c0pperdragon/Amiga-Digital-Video/direct_adapter/installation/README.md

# Installation process

1. Insert the MicroSDcard with the RGBtoHDMI software into the Raspberry Pi Zero.

2. Check/set the jumper on the underside of the adapter to select the correct Denise variant.
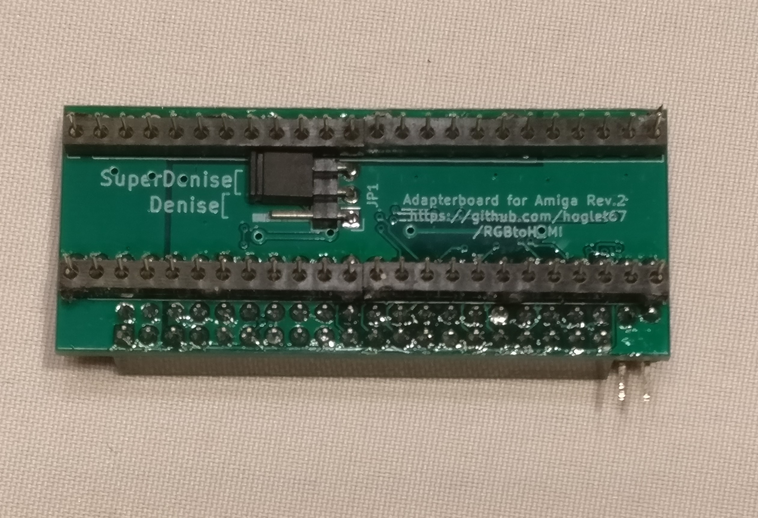
[picture p10: direct_adapter/installation/jumper.jpg]


3. Remove Denise graphics chip from Amiga 
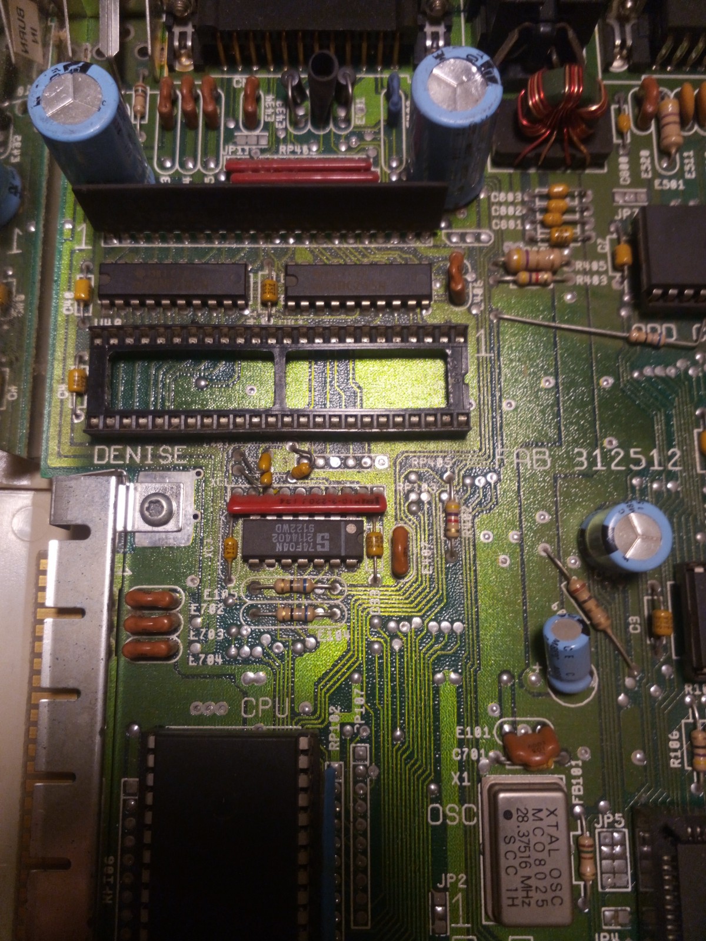
[picture p11: direct_adapter/installation/remove_denise.jpg]


4. Insert adapter with Denise on top
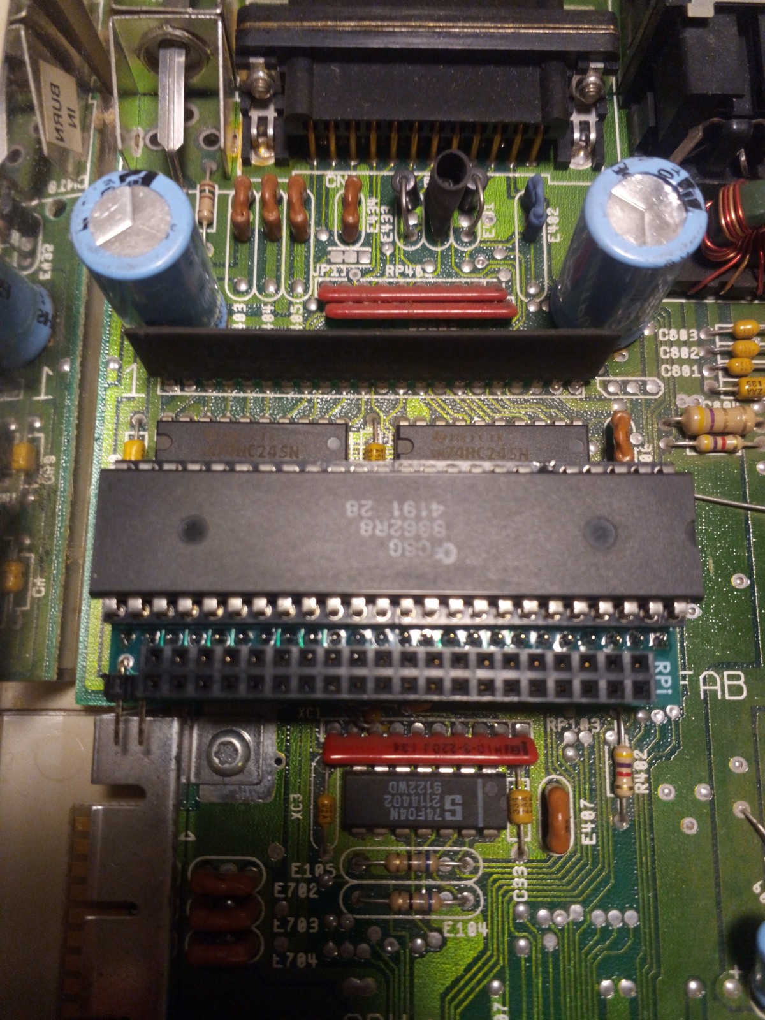
[picture p12: direct_adapter/installation/adapter_with_denise.jpg]


5. Attach Raspberry Pi Zero upside down and attach HDMI and button cable (optional)
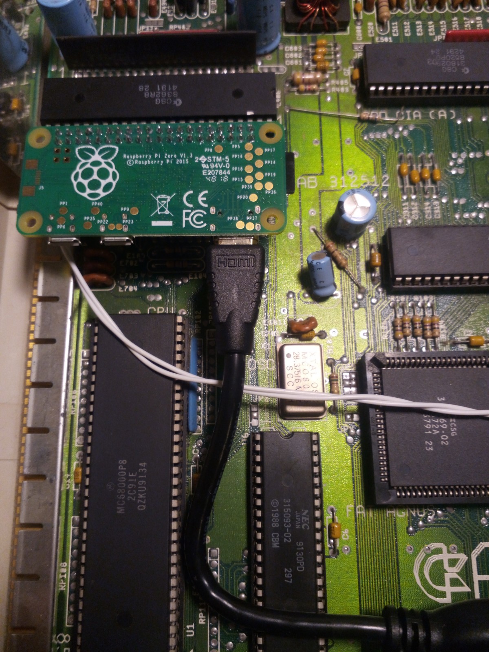
[picture p13: direct_adapter/installation/RPi_with_cables.jpg]


6. Bring cables to the outside of the case
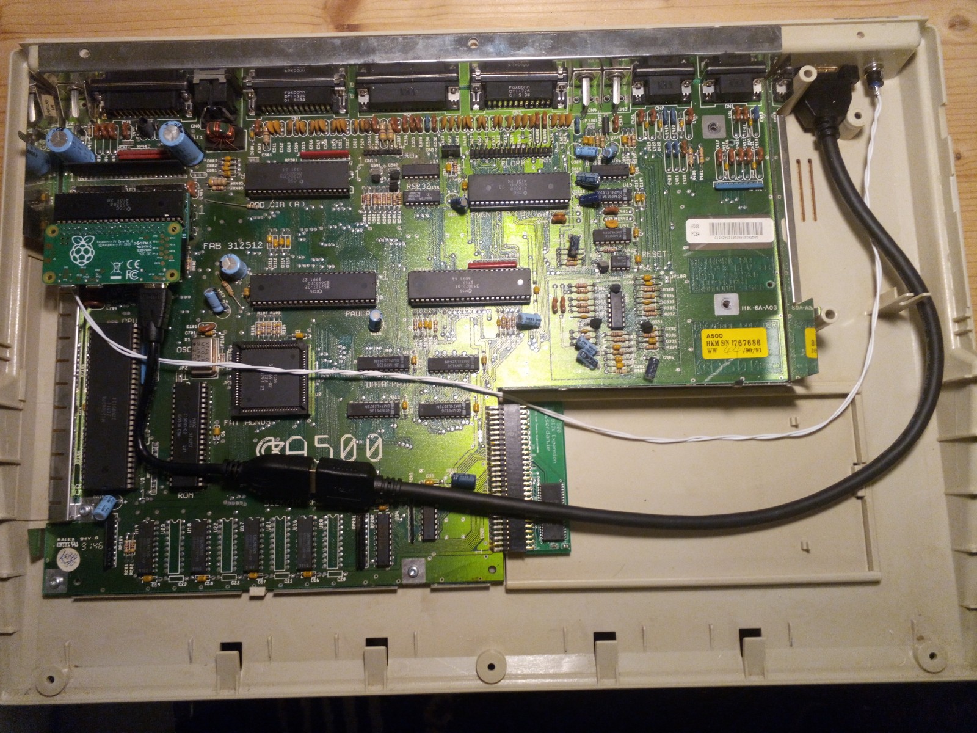
[picture p14: direct_adapter/installation/cabling.jpg]
