c0pperdragon/Amiga-Digital-Video/(threads)

Thread 1 (2020-07-18):

General discussion

c0pperdragon, 2020-07-18:
I have set up this thread as a forum to discuss the options with @IanSB concerning the use for the RGBtoHDMI project.

c0pperdragon, 2020-07-18:
To define the scope of the project I would only consider the Atari computers. C64 already works and my latest ZX Spectrum board can natively output RGsB which should be easy to use with the RGBtoHDMI.

c0pperdragon, 2020-07-18:
A straight forwar solution is a connector with 8 pins for the color, one csync and GND and +5V. This could then directly drive an RGBtoHDMI or being converted to YPbPr with an external adapter. I want this option so I can use it with other upscalers.

IanSB, 2020-07-18:
> A straight forwar solution is a connector with 8 pins for the color, one csync and GND and +5V

Yes, RGBtoHDMI already has a 12 way IDC header with the following pinout:

Pin 1  X1 (Bit 6)
Pin 2  X2 (Bit 7)  
Pin 3  GND  
Pin 4  Bgreen (Bit 4)
Pin 5  Bred  (Bit 3)
Pin 6  Bblue (Bit 5)
Pin 7  RED (Bit 0) 
Pin 8  H/CSYNC 
Pin 9  GREEN (Bit 1)
Pin 10  VSYNC
Pin 11  BLUE (Bit 2)
Pin 12  +5V

They are arranged in this order because if you connect a ribbon cable from Pins 3 - 11 to a 9 way IDC 'D' type connector that is the correct pinout for IBM PC MDA, CGA and EGA adapters. (It was originally a 10 way connector and X1 + X2 were added later to make 8 bits)

One possible addition would be to put the pixel clock on the unused pin 10 (VSYNC) as that might allow for the possibility of connecting the signals directly to the Pi's GPIO header bypassing the CPLD for a minimal cost solution. (The CPLD is primarily used to regenerate a pixel clock with the correct phase). The pixel clock might be useful for any external DAC as well.

It would also be possible to communicate with the scaler by outputting data on the 8 pins during sync periods.

> C64 already works and my latest ZX Spectrum board can natively output RGsB which should be easy to use with the RGBtoHDMI

It might be useful to add 4 bits + sync + pixel clock onto some unused pins on their FPGAs for experimental purposes.

One possible change to the C64 FPGA that might also be useful would be to add an additional option to address 53311 to switch the YUV output to the special palette and back again so you don't lose the saved palette.
The YUV levels required by RGBtoHDMI can be generated procedurally so no need for another table.
To switch to special RGBtoHDMI mode that would be something like:

POKE 53311,xxx   (where xxx is the number to switch to RGBtoHDMI mode)
flip switch
POKE 53311, 138

To switch back to normal palette
POKE 53311,137
flip switch
POKE 53311,138
(That would also ensure that reprogramming the palette would switch back to normal mode)

c0pperdragon, 2020-07-18:
Concerning the C64 - maybe it would the best thing to just provide a digital header on the mod board. It may be a bit tricky to squeeze this into some corner, but then all the messing around with the palette would be unnecessary. You could install a digital port (3.3V  logic levels) to some convenient place on the case just in addition to the YPbPr output.

Are you sure about the pixel clock? This somehow feels a bit out of place for a digital video interface right out of the stone age of computing ;-)   Just providing a 3x2 optional pin header with GND, CSYNC, D0 - D3 seems more fitting.

I can easily modify the firmware to send these signals to some pins, and also modify the board layout to have this option. Then you would need to have such a PCB made and populate it yourself, as we will for sure not do a second production run in the forseeable future. Of course you could also try to solder wires directly to these FPGA pins - but I would not be able to do this.

c0pperdragon, 2020-07-18:
For this new Atari modification, I envision to use a CPLD that can directly accept 5V input level. It may run with 3.3V itsself and will also output 3.3V levels.

Because the GTIA chip already directly generates the 4 luminance bits and the CSYNC, the CPLD would only be responsible to generate the 4 bits for the color signal. Internally this saves only a small amount of logic because all the complicated sprite handling is still necessary. But maybe it just enough to squeze the logic into some of the smaller CPLDs.
One side effect of this is that the CPLD would not be able to generate a proper pixel clock itself. The Atari graphics system is basically designed around low-res pixels with a 3.54 MHz (PAL) pixel clock.  This is also the highest frequency to be found anywhere inside the Atari machines. To generate high-res pixels, the GTIA outputs different luma signals for both halves of the pixel clock. The color signals on the other hand can only ever change at the begin of one full pixel clock, so it can be easily done by logic that is driven by the pixel clock.

To bring the signals (8 data, 1 csync) and power to the exterior of the device, some detachable connector is needed. And IDC header is just not the right thing for a case-mounting. Maybe a DSUB-15 as this seems to be readily available?

IanSB, 2020-07-19:
> One side effect of this is that the CPLD would not be able to generate a proper pixel clock itself.

The pixel clock is not essential, it was just an idea if it was available already but if it is difficult to implement then it doesn't matter as the scaler doesn't need it.

> And IDC header is just not the right thing for a case-mounting. Maybe a DSUB-15 as this seems to be readily available?

I like IDC as it makes it easier to build cables, in this case it would be 12 way IDC to 12 way IDC ribbon

c0pperdragon, 2020-07-19:
I just got an idea about digital signals for the C64. Using the current mod you could actually tap into the various resistors that form the output DAC. These are SMD parts, but not that small so it should be possible to attach wires. So you could actually keep the YPbPr signal unmodified and at the same time extract digital data.You should run the signals through a buffer IC first to avoid coupling noise into the analog signal.
With this solution you don't need to create your own custom mod kit but can use the readily available one.

Unluckily with the default palette there is no set of 4 pins to always uniquely specify the color. I did some computation and there is a possibility with 5 pins, but this is quite convoluted and depends on the very exact palette setting. The cleanest solution would be to take the 4 most significant bits of  the Y output together with the most significant bit of both Pb and Pr.  CSYNC can also be extracted directly.
As you have already some systems with a 6-bit input this is probably no big deal for your system.

c0pperdragon, 2020-07-19:
Hi!  I just had an idea that may (if it actually works) become the best and most cost-effective upscaler solution there is.
Is it possible to directly team up the TVP7002 video digitizer chip with the Raspberry Pi Zero?  This chip is used in the front-end for the OSSC and has a built-in PLL to sync to any given pixel/line ratio and also outputs the pixel clock alongside the data.

As you have mentioned earlier, having a pixel clock allows the Raspberry Pi to take in the samples directly without additional hardware. And as you also said, genlock is possible, so this could become a very powerfull general upscaler with very low lag.
I don't know how far this can be pushed. Would 24 bit color depth with a 640x256 input signal be possible? I would love to actually use this with my Amiga.

IanSB, 2020-07-19:
> I just got an idea about digital signals for the C64.
> As you have already some systems with a 6-bit input this is probably no big deal for your system.

I will do some experiments with that later but for now the analog connection is the easiest as it just plugs into the existing connector so maybe the only thing to add at the moment would be the rapid palette output switch I mentioned above.

> Is it possible to directly team up the TVP7002 video digitizer chip with the Raspberry Pi Zero?

There are several problems:
There might not be enough GPIO pins on the header for 24 bit bus + supporting signals and if the 24 bit bus is multiplexed that increases the data rate to be clocked into the Pi's GPIOs.

The main issue is that the Pi's memory access time is unpredictable and can sometimes be high latency which is not good for real time capture. To get it working with even these limited bit depths required things like instruction re-ordering and register swapping to make use of processor optimisations.

One thing I intend to look at is using the GPU/VPU to capture the incoming data (effectively a FIFO) but the GPU processors are not well documented so that may take some time. Using an external hardware FIFO might help but that would require more GPIO accesses and they are relatively slow too.

The Pi2 and Pi3 perform even worse as their uncached memory access is slower than the Pi zero. The extra cores don't help because if you capture with one core and write with another core you get stalls on contended memory access and cache coherency updates.

The current system has a 12 bit bus from the CPLD to the Pi on the GPIOs for pixel data and that clocks in 4 pixels at a time in 3 bit capture mode, 2 pixels in 6 bit mode and 1 pixel in 8 bit mode. This could be increased to 1.5 pixels in 8 bit mode.

The max pixel clock in 6 bit mode writing to an 8 bit buffer is ~29 Mhz and I have been able to capture 640x480 @ 60hz at that bit depth from a VGA card which also had an EGA TTL connector.

This max pixel clock in 8 bit mode is currently ~14Mhz as the data rate on the 12 bit bus is doubled compared to 6 bit mode. That should be enough for the Atari but not any computer with a higher pixel clock.

Increasing to 24bits per pixel and 32 bits deep framebuffer may be impossible on the zero although it might work on the Pi 4.
Certainly some things to investigate in the future.

c0pperdragon, 2020-07-19:
About C64 palette swapping: It is a bit of a pain to put more features into the register handling subsystem. Even the extra bit to turn off sync output was quite a hack already.

But maybe you could like the following idea: You can switch to the special palette buy placing a jumper link on a specific position of the JTAG header (I need to check this actually works). Or add some additional wire to the mode switch (soldered from below - that may be tricky) to actually get a 4th output mode.

c0pperdragon, 2020-07-19:
Clocking in such amount of data via the GPIO headers using only the CPU is surely a pain, especially when these variable timings are involved that come from using RAM with caches.

On the other hand, the current (and cheapest) version 1.3 of the Raspberry Pi has a high-speed data interface which is meant to be used with a camera. This would handle all we could ever throw at it with ease. But then of course some intermediary IC is needed to translate between the video digitizer (parallel protocol) and the DSI port (serial).
Anyway this solution could be the most simple and not even requiring hardware-level programming on the Pi.

IanSB, 2020-07-19:
>You can switch to the special palette buy placing a jumper link on a specific position of the JTAG header (I need to check this actually works). Or add some additional wire to the mode switch (soldered from below - that may be tricky) to actually get a 4th output mode.

Yes that would be great.

IanSB, 2020-07-19:
> version 1.3 of the Raspberry Pi has a high-speed data interface which is meant to be used with a camera.

Yes I have considered that, but this is a bare metal project (no OS) so you have to find enough documentation to write a driver for it.

https://github.com/hoglet67/RGBtoHDMI/issues/104

IanSB, 2020-07-19:
Have you used JLC PCB assembly service? They are very low cost but only build single sided SMD and only use components they have in stock.
I redesigned the analog board for RGBtoHDMI to use only their stocked components and had a batch of 10 assembled very cheaply at about 25% of the cost of getting the original board built. It worked out cheaper than buying just the components for the original design from local suppliers!
I also designed with smaller components as I didn't have to build them by hand.

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
Top is original design, bottom is JLC built design (they are functionally identical)

> For this new Atari modification, I envision to use a CPLD that can directly accept 5V input level.

They do stock some CPLDs & FPGAs so if there is anything suitable in their list and they have many of them in stock it might be worth using it in the design, you can get 5 boards assembled for very little.
(Even if it requires level shifters, they probably have those as well and adding such things to the assembly costs very little)

https://jlcpcb.com/parts/componentSearch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

c0pperdragon, 2020-07-19:
Hmm, these parts look pretty well made. But for my own hobby projects and prototypes I prefer to assemble the boards myself. Actual soldering is my main enjoyment in this hobby. As a  decades-long software engineer I am a bit sick of all this computer screen work, so I try to get a better ratio of planing/programming vs. manual work.

c0pperdragon, 2020-07-19:
Convering the C64 firmware: I am pretty confident that I can use the JTAG pin and it would then work like this:  If you bridge pin 9 and 10 the mode select switch position that would normally select "line double with scan line effect" will then select "normal lines with special high-contrast palette". This would have the least impact on the overall usability as this seems to be the least used output mode anyway.

IanSB, 2020-07-19:
>If you bridge pin 9 and 10 the mode select switch position that would normally select "line double with scan line effect" will then select "normal lines with special high-contrast palette".

Sounds good

> But for my own hobby projects and prototypes I prefer to assemble the boards myself.

Yes I like building the hobby projects but not building lots of the same thing for friends as my eyesight is no longer so good.
Anyway if JLC have something in stock that is suitable, no reason not to use it as it leaves the option open.

c0pperdragon, 2020-07-19:
Once more back to the Atari:  Somehow I am reluctant to start this completely new project when my already existing Atari component video mod already works so nicely.  I now think of reworking the FPGA board in a similar way as for the C64 so it will fit better and use existing holes in the case. For my Atari 800XL this is easy, as I have it myself. Probably it is more complicated for other models - this mainly depends on which types of RF modulator were used.

By using existing holes only I would again go for the solution with the TRRS jack and the mode switch.

To support your upscaler in a similar way as we now plan for the C64, we would need to find a way to squeeze the pixel data through the analog data path.
This is not so hopeless as it may seem, because the Atari has quite hard restrictions on which colors is can produce. Basically it can only have a different chroma for every two pixels and the luma is mostly restricted to 8 different levels (there is just one special mode with more lumas but then both pixels of a pair are identical).
Summing the possibilities for one pixel pair:  16*16  + 16*8*7 = 1152
As far as I understand your analog interface, it can distinguish 27 different R/G/B possibilities.  Combining two pixels gives  729 possibilities. That is awfully close to the target (missing only half a bit or so). But maybe I did misunderstand the schematics and you can actually pass more information?  Or maybe you can somehow utilize the sync level to transfer this missing data?

IanSB, 2020-07-19:
> Once more back to the Atari: Somehow I am reluctant to start this completely new project when my already existing Atari component video mod already works so nicely.

OK no problem

> As far as I understand your analog interface, it can distinguish 27 different R/G/B possibilities

If an extra comparator (U7) is fitted it can distinguish 64 levels (4 each for RGB or YUV) so that might solve that problem. I already use that option for the TI99/4a. This would then actually capture at 6 bits per pixel plus there would have to be some extra software to decode those combinations according to the restrictions you mention above.

c0pperdragon, 2020-07-19:
A had a second look at your analog board and noticed that there actually is the possibility to distinguish onre more level of the R and B lines. So you can differentiate 48 possibilities which give 2304 per pixel pair.
Now this is actually possible and we can even come up with some self-synchronizing encoding to always know which pixel is what.

c0pperdragon, 2020-07-19:
Our comments just crossed each other.   With true 6 bit per pixel (is it really possible to also get 2 bits from the G line?) encoding and decoding  would become even simpler, I guess.

IanSB, 2020-07-19:
> With true 6 bit per pixel (is it really possible to also get 2 bits from the G line?) encoding and decoding would become even simpler, I guess.

Yes, The comparator connected to the Vsync input which normally detects the sync in YUV mode can also be used to provide the missing level in full 2 bit mode.  In that case you have to connect the separate Sync input (normally used for RGBS) to the Y input so that there is still a sync source.

So you can have:
3xY, 3xU, 3xV  for 27 levels normal operation
4xY, 3xU, 3xV for 36 levels (requires sync input connected to Y)
3xY, 4xU, 4xV for 48 levels (requires U7 fitted)
4xY, 4xU, 4xV for 64 levels (requires U7 fitted and sync input connected to Y)

c0pperdragon, 2020-07-19:
Basically all options execpt the first would be possible. Whatever is the least hassle for you, as for me it is just a matter of fimeware programming. And in my current Atari FPGA there is plenty of room for additional features.

c0pperdragon, 2020-07-19:
With just fitting the U7 (so the cable from the C64 can be re-used) we get 2304 possibilities. This is due to some strange coincidence exactly the double of the 1152 possibilities needed for a full pixel pair. So I guess it should really be possible so encode some kind of alignment-marker to know where a pair starts. This should make the decoding processs easier.

IanSB, 2020-07-20:
> Whatever is the least hassle for you, as for me it is just a matter of fimeware programming

The decoding algorithm needs to be very simple, ideally just logical operations, bit shifts, adds, subtracts, compares etc, no tables or multiply/divide. It could use small tables if they will fit in the level 1 cache.

c0pperdragon, 2020-07-20:
So, the C64 firmware change is done. It works as proposed:  After flashing the firmware, you can bridge pin 10 an 9 on the JTAG header to activate this special palette when also shifting the mode switch to the position nearest the power LED.
I just made up a palette that only uses minimum/middle/maximum values for all three lines (plus the sync in the case of Y). I tried to chose combinations that best fit the original colors, but of course this is not always possible. At least black, middle gray and white are correct. The other grays will look rather cyan, I guess.

You can download the firmware from https://github.com/c0pperdragon/A-VideoBoard/tree/master/c64mod/experimental
I trust, you have a USB-Blaster already? Or you can get one with reasonable effort?
Please let me know if this works, and also if it solves the startup problem (which, if still existing, should manifest itself in a very different way as the compressed configuration data is now quite different).

Using the JTAG pin was quite a tricky business, and I nearly disabled the JTAG feature permanently. But now everything works fine and later re-programming is still possible without additional measures.

IanSB, 2020-07-20:
I just tried this and it works great!
I had to update my palette translation to match your new high contrast colours but everything looks OK so far.
I have not seen a startup problem yet but not power cycled many times so far so will keep testing.

IanSB, 2020-07-20:
> I now think of reworking the FPGA board in a similar way as for the C64 so it will fit better and use existing holes in the case. For my Atari 800XL this is easy, as I have it myself. Probably it is more complicated for other models - this mainly depends on which types of RF modulator were used.

Maybe you could put multiple positions for the TRRS connector on the edge of the board?

c0pperdragon, 2020-07-20:
As the C64 tasks seems to be done now, I can more focus on the Atari.

Because I have a perfectly working solution for my own machine already, I have actually not so much need to design a completely new hardware. The board I am using is one of my A-Video boards and the adapter for the GTIA chip is a bit of a hack, but works also nicely.

In order for other people to use the mod, this adapter is not really convenient, so I will design a new one based on the same schematics, but it will look much more like the one for the C64. I guess you could have such a board made by your manufacturer.

For the FPGA board there are already two compatible options available:  The A-Video board (3 RCA jacks, external mode switches) and the C64-Board (TRRS jack and integrated mode switch). As there are quite some different variants of Atari machines which would work with this mod (everything with a GTIA chip) the best way to install the board should be decided by the owner based on individual preference.
The C64-Boards are readily available at VideoGamePerfection and I happen to have a spare A-Video board which you could have for the cost of the parts (about 20€) and shipping (from Austria).

Next step for me is the design of the adapter. I hope I can squeeze the 4 inverter chips into the frame of the IC socket.

IanSB, 2020-07-20:
Someone else is trying your board with RGBtoHDMI and has the same left shift problem on power up.
He also has a 6569R1 so it seems to be a definite problem with that chip
https://stardot.org.uk/forums/viewtopic.php?f=3&t=14430&start=1140#p279622
I have sent him the new FPGA link to see if that fixes but I think he will also change to a 6569R5
It is actually quite difficult to use with a 6569R1 anyway as that needs a big heatsink and the adapter board interferes with that.

Could you check that the numbers I have used in the programs for setting the high contrast palette and restoring the normal c64 palettes with old FPGA firmware are correct:
https://github.com/IanSB/RGBtoHDMI/wiki/Cables
(See bottom of page)

I might be interested in the A-Video board but I think I would remove the phonos and wire in a trrs.
Can the A board and the C64 board be used on the C128 (with the 48 pin C128 adapter)?

Are you going to build an RGBtoHDMI?
If so do you want any blank pcbs or are you going to order a batch from China?

c0pperdragon, 2020-07-21:
That there is another user with the same shifted display now is actually a good thing. At least that rules out a random malfunction of the FPGA. I still can not figure out how this can even happen, but if both the new firmware as well as swapping out the chip solves the issue, I am fine with that. If that is truly the case I will document this behaviour on the project page.
I would be very kind if you could do some more testing nf the matter. Specifically if replacing the chip already solves it with revision 2.6 and if 2.7 with the R1 chips is also fine.

One thought about the independently occuring sparkly pixels that 'anigthin' reported which worsen over time:
The mod generates its internal pixel clock from the cpu clock by waiting for an edge and then using its own time source to decide when to start which pixel. The last pixel of a group of 8 will then take up the slack and become a bit longer or shorter. When the input frequency is too far off spec this uneven distribution of pixel times may well screw up your digitizing process.
The proper way to do it is of course using a PLL, but the FPGAs PLL can not lock to a 1 MHz input.
If there is indeed a drifting clock (you can probably tell by directly measuring pin 22 of the VIC) you will not be able to change this by replacing the VIC. In this case I need to come up with a better way of subdividing the CPU clock.

c0pperdragon, 2020-07-21:
Could you open a issue thread on the C64 video enhancement thread about the matter of sparkly pixels and notify the "anightin" on this, because I do not want to use the stardot forum for this purely C64-related issue.

c0pperdragon, 2020-07-21:
I just checked the list of color values on your screenshot. Yes, these are exactly my original colors. A bit too bright for the taste of purists - but I like it :-)

c0pperdragon, 2020-07-21:
More answers to previous questions: I am not going to build at RGBtoHDMI upscaler myself. I am more interested in making (or even buying - but only as a last resort) a general analog video upscaler solution. The idea to use a Raspberry Pi is very interesting as it really has so much power (and is probably much much cheaper than the upcomming OSSC Pro).

Replacing the RSA jacks should be fairly straight forward. You can also connect a mode switch (2 or 3 way) to the GPIO2 header.
To make the system in line with the C64 solution, you will also be able to activate the special "digital" palette with a jumper on the JTAG headers. In this way the C64 board can also be used for this purpose.

Support for the C128 is very much in doubt yet. I have actually designed an adapter board which may work (can not tell because I don't have a C128). But as I have received zero feedback from the community yet, I just can not say how the signals are really generated by the VIC-II E and if this in any way compatible.
Actually it would be very cool if you would try.  Mouting space is probably an issue as even with an removed RF-modulator the C64 board does not fit. Maybe the A-Video board could fit, but then there is no working signal on the A/V port any longer. Or you screw the A-Video board on top of the RF can. Or you indeed cut down the metal can of the VIC to squeeze the C64 board in. Or whatever floats your boat  ;-)
Of course before taking such exreme measures, you could very well just try it with an C128 adapter and run the ribbon cable to your existing C64 (don't forget to also connect of the grounds of both machines!)

c0pperdragon, 2020-07-21:
Now I even have a question of my own: Do you know if it is possible to do genlock of the Raspberry Pi's HDMI video also when programming it with a "normal" operating system?

IanSB, 2020-07-21:
>Do you know if it is possible to do genlock of the Raspberry Pi's HDMI video also when programming it with a "normal" operating system?

I've not looked at this but it should be possible if there is an API call to change the HDMI clock, if not you would have to write a driver to directly access the registers to change the clock. You would also need to compare the incoming vsync with the HDMI vsync and there is already a HDMI vsync interrupt.

c0pperdragon, 2020-07-22:
So, I have designed a new GTIA adapter for the Atari which you can have manufactured. I have tried to mainly use parts that JLCPCB provides. I guess the very special DIP 40 socket is not in their list, but they would not do the installation anyway because it is such an unusual and quite tricky business.
Everything regarding the Atari mod is now available at: https://github.com/c0pperdragon/A-VideoBoard/tree/master/atarimod

If you want my spare A-Video board, please let me know your post address. Postage inside the EU it will  cost about10€, outside 15€. Add this to the 20€ for material cost and send it to my paypal account:   reinhard.grafl@aon.at  .  If you do not have a paypal account yourself, we need to find other options.

The board does not contain a proper firmeware yet (I took it out from Spectrum when designing its specific mod kit). I plan to work on the atari firmware again in a few days while the material is on the way.

c0pperdragon, 2020-07-24:
No as I have given up the idea of the general upscaler, I would really like a solution to upscale my ZX Spectrum, C64 and Atari computers. My prefered solution would be to design a board the sits on the Raspberry Pi Zero and integrates the functionality of your Analog circuitry and the CPLD. The input connector would be a TRRS jack, so it can be directly plugged to any of my relevant machines.  Maybe add some buttons to switch input and output mode.
Would you also be interested in such a board? I would like to manually assemble these, but maybe we could share the cost of PCB manufacturing.

IanSB, 2020-07-24:
> My prefered solution would be to design a board the sits on the Raspberry Pi Zero and integrates the functionality of your Analog circuitry and the CPLD. The input connector would be a TRRS jack, so it can be directly plugged to any of my relevant machines.

What's the problem with the existing design?
It fits into a readily available Pi zero case and so has easy access to all the Pi's ports and SD card slot.

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

c0pperdragon, 2020-07-24:
Hmm, this package is actually quite neat. The only thing I don't like is the aesthetics of the ribbon cable. Somehow I feel that ribbon cables should only be used inside the case. I think I will just build my own cable with a more
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

Thread 2 (2020-07-23):

TVP7002 chip on GPIO

c0pperdragon, 2020-07-23:
@IanSB

Hi!
I can not help but keep obsessing with the idea of a general upscaler based on the Raspberry Pi Zero (1.3 or older). As it looks, the video camera interface is very non-disclosed, so the best chance is still the GPIO header.
Leaving performance issues inside the Pi aside (could possible be solved by using DMA), the header pins seem to be just enough to pull this off. In a bare-metal implementation, the ID_SD and ID_CL pins can be used to directly control the TVP7002, as it conveniently has a I2C control interface.  With 24 pins for color, 1 for pixel clock, there is exactly one GPIO pin left to transfer the sync. The video chip generates hsync and vsync, but these could be XORed to form a poor-man's csync signal.

The chip has multiple video input lines, so the device could easily have ports for YPbPr as well as SCART (the first with either YPbPr or RGsB, the second with RGBS or RGsB).

Some control buttons can be done with an I/O-expander on the I2C bus to switch input source, output resolutions and to tweak the input sampling.

Going completely crazy, I could even imagine to integrate a solution to digitize stereo audio as well and make the data accessible through the I2C bus.  With 1.7 MHz bus speed, this may just be fast enough to transfer 44kHz 16bit stereo audio.

All this of course implies that the Raspberry Pi Zero has the dedicated hardware to run the GPIO input as well as the I2C communication independently of the CPU.
Even if audio is not possible, it would be an awesome device.

c0pperdragon, 2020-07-24:
After some more consideration I come to the conclusion that a general upscaler is not feasable, mainly because my targeted devices (NES, SNES, PlayStation) can operate at various pixel clock speeds. The solution of the OSSC to just sample at 30 MHz is surely out of reach for the Raspberry Pi Zero.  Manual re-adjustment of sample is rate is not convenient and I don't know if automatic adjustment is even possible.

So, I finally give up this idea.

Closed 2020-07-24.

Thread 3 (2020-07-25):

Amiga Support

c0pperdragon, 2020-07-25:
@IanSB

I was thinking about to the possibility to create an internal modification for the Amiga using your RGBtoHDMI software.
As you have stated, it is possible to pump enough data into the Pi to allow the EGA+ mode with 6bit per pixel.  The Amiga (original screen modes only) has basically the same data rate. Twice the bits per pixel, but with half the pixel clock (about 14..2 MHz).  So I assume this should be possible with the current system and without resorting to DMA.

The beauty of this mod lies in the fact that the only non-standard part necessary is a simple adapter board that level-shifts the output signals of the graphics chip to 3.3V and exposes them via a 2x20 pin socket  (very much like my C64 adapter board). The RPi Zero can then directly be plugged into this socket to sit above the graphics chips. The HDMI output then needs to be transfered somehow outside of the case (probably with a mini-HDMI to HDMI extender cord).

This would be such a cost effective solution to upgrade the Amiga to perfect HDMI (without sound though), that I could imagine quite some people will want such a solution.

 One small unsolved issue remains, though. The system clock is only 7.1 MHz, and the graphics chips changes the output signals on both edges of this clock  (very much like the atari 8-bit machines).
Would this be manageable by the RPi software, or is some additional circuitry necessary?  I can imagine to add a latch to keep 12 pixels of one half of the clock and then provide 24 pixels together at half the pixel rate. But only if it can not be solved in software already.

If you think this is possible, I will try to create a device profile - but I will surely need some help for this.

c0pperdragon, 2020-07-25:
I just realized that the graphics chips even has a second clock signal with 7.1 MHz that is phase-shifted by 90 degrees. So I could easily create a 17.2 MZz pixel clock with a simple XOR gate.

IanSB, 2020-07-25:
>One small unsolved issue remains, though. The system clock is only 7.1 MHz, and the graphics chips changes the output signals on both edges of this clock (very much like the atari 8-bit machines).

It already does that. The Psync signal that the CPLD outputs to clock the data on the 12 bit GPIO bus is at half rate, with 12 bit data changing on both edges of the clock so there is no problem there.

This would require a 16 bit frame buffer. At the moment the software only supports 4bit and 8 bit buffers but it should be possible to add 16 bit support and do some tests using the existing analog output of an amiga into the existing analog input of RGBtoHDMI (so the pixel clock is right) but capturing 12bpp and writing to a 16 bit frame buffer.
The colours would all be messed up but if that works without glitches then it would be worth creating the hardware as a next step. If it is very marginal, you can overclock the Pi zero so that might help too.

The other issue is the Amiga's interlaced video mode. With simple capture, you would get weave lines and high quality deinterlacting in real time might be difficult. The teletext deinterlacing I wrote uses character recognition tricks which wouldn't work in for general deinterlacing.

As previously mentioned, I've been looking at using the GPU to capture which might remove all the marginal timing issues if it works.

c0pperdragon, 2020-07-26:
Just for experimentd, I could easily set up my A-Video board to output any signal pattern in its GPIO1 port. Once you receive your parcel, so can you ;)  No need to have an actual Amiga on the bench during this stage.

De-Interlacing would of course be the second big bonus of this solition. The most straight-forward approach ist probably the best: The framebuffer has double height and the even and odd lines are just updated alternatingly.

IanSB, 2020-07-28:
I've done some tests and it looks like this will actually work. The timing is close to the limits but it seems to be stable.

As well as inputting 12 bits per pixel directly to the Pi's GPIOs, one other option that also looks like it will work would be to alternate the low and high 6 bits of the 12 bit pixel value at double the pixel clock rate (so ~28.2Mhz) which could be connected to the existing 6 bit digital input on the CPLD. This would allow use of an EGA style 9 pin D-type connector for the digital output on the Amiga and allow use of the menu buttons / functionality by keeping the converter external.

One question:
In order to process interlaced (640x400 etc) and progressive (640x200 etc) correctly the converter needs to be able to determine which is currently being output. Does the Amiga output progressive sync with progressive video and only output interlaced sync with interlaced video? (Interlaced video must always have interlaced sync but progressive can have either)

c0pperdragon, 2020-07-28:
The csync that is generated by the graphics chip varies with progressive / interlaced mode.
In progressive it uses exactly the same pattern as my C64 mod does (which I already copied from the PlayStation, so it seems to be industry standard for 288p).
In interlaced mode it follows the proper standard for TVs, namely having the line sync pulses shifted by half a horizontal line in every other frame. With a continously incrementing vertical deflection (all this was done with analog means, back in the day), this causes the lines of odd frames to be drawn between the lines of the even frames.

Multiplexing the 12 bits to 6 lines would in theory be possible. It would not even be so hard to make a circuit for that from a few 74-logic parts. At least on my machine, my measurements show that the graphics chip is driven by an 7.1 Mhz pixel clock (which for some reasons is not the CPU clock, but is 90 degrees earlier). The chip changes the color outputs in a way that the change is apparent about 30ns after the clock has changed (both edges are used). So with two simple multiplexer parts (something like 74HCT157) this would work. The output timing will largely depend on the delay the graphics chips really has and you can not expect perfect even pixel lengths. You also don't get a pixel clock from this. With your CPLD solution and a bit of tweaking this could work anyway.

Of course I for myself would much more prefer the direct solution with 12 data bits.
In fact it would be easy to use the exact same RPi software in both variants, as your CPLD outputs 12 bits anyway. Is there a specific timing requirement for when the signals into the RPi need to change in relation to each other?  I imagined it would be most straight-forward for programming to have the clock change a bit later (about 5ns)  than the color signals. By this the program just needs to poll the port until the clock changes and then it already has all the valid and stable color bits also.
Yesterday I came up with a nice digital circuit (2 8-bit flip-flops and a quad XOR) what would produce exactly that.

c0pperdragon, 2020-07-28:
One more detail: I found that the falling edge of the csync signal follows the general timing of the color pins (about 30ns after the clock), but for some reason the rising edge of csync happens very close to the time of the clock change. So it probably can happen that the rising csync detection is off by a pixel from time to time. So for proper timing you need to use the falling edge of csync, as it is officially specified anyway.

IanSB, 2020-08-04:
Got that working!

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

I'm going via the CPLD at the moment using a modified 8BPP board to give 12BPP

c0pperdragon, 2020-08-04:
That is absolutely amazing!
How is your setup working? Do you actually use a D-SUB-9 plug? How can you reliably transfer the signals at 30Mhz?

c0pperdragon, 2020-08-04:
Any ideas yet about interlaced mode?  ;-)

IanSB, 2020-08-04:
>How is your setup working? Do you actually use a D-SUB-9 plug? How can you reliably transfer the signals at 30Mhz?

I'm feeding all 12 bits into the CPLD at the moment, 9 bits into the main header (The normal 8 bits + using the Vsync input for the 9th bit, two more bits are fed to unused CPLD inputs and the last bit is fed to a CPLD input that was previously used to switch an internal CPLD divider but that function has been moved to an internal register instead.

I've also added a multiplex clock signal which replaces the CPLD clamp output in this mode and that can be used to switch a multiplex circuit as an alternative to multiplexing in the Amiga (although in this case the latter would be preferable as it reduces the number of wires from the Amiga)
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

>Any ideas yet about interlaced mode? ;-)

I've already implemented it but it's untested at the moment. It supports bob and weave deinterlacing but only the weave option will work with the current pixel clock rate as bob requires twice the memory bandwidth.

c0pperdragon, 2020-08-04:
That is really a hack, just soldering wires to the pins!
It is cool that you actually get reliable signal transmission. It seems the HC245 drivers produce a "gentle" enough signal slope so you do not run into all this messy reflection issues. With AC or LVC parts, the ringing would wreck havoc with your signals.

I would best like an interlacing scheme that would produce a 100% still output image for non-moving input images. Like for working with workbench applications. Games and such are probably never interlaced.
So weave deinterlacing is probably the best option.

I am not 100% sure about the exact definition of weave deinterlacing according to https://en.wikipedia.org/wiki/Deinterlacing
Reading this, it seems the progressive output image changes only once every 2 frames.
I would very much prefer a solution that changes every frame by just updating the newly received lines (even or odd)  and keeping the other lines from the previous frame. This would keep the display more responsive, I guess.
Of course, combing artefacts are still present but maybe less noticable as the image changes more quickly.

IanSB, 2020-08-04:
>That is really a hack, just soldering wires to the pins!

Of course! but if I couldn't get this to work due to timing issues on the Pi then there wouldn't be any point in pursuing this idea any further. After this test,  it looks totally viable so it's going to be worth designing a suitable PCB.

>Reading this, it seems the progressive output image changes only once every 2 frames.

My implementation will update on every field change so the output will change on every frame at 50Hz or 60Hz as appropriate and consist of the current field with the previous field woven in.

If you are still thinking about an internal Pi option, you need to also think about the best way to access the menus as they will be needed to change resolution, scaling type and many other preference and configuration options. Also it is useful to access the Pi's SD card to retrieve screen caps and do software updates.

c0pperdragon, 2020-08-04:
Yes, I really think heavily about an internal upgrade. To also appeal to as many users as possible, the thing should be simple to install and use. I guess it would be possible to provide a no-solder solution that just consists of the adapter board (goes under the Denise)  and an SD card with preinstalled software for the Pi.
The rest are just off-the-shelf parts: Pi Zero and whatever HDMI cables the user cares to use.
To make it truly no-solder, a Pi with pre-installed headers can be used - that means, I will design the adapter board so the Pi will be plugged into it upside down.

The price for simplicity is of course less features: No screen capturing, no tweaking of anything. No screen centering or color adjustment or anything like that. Only one mode for de-interlacing (your method for weaving is pretty perfect in my opinion).

Ideally the RPi should detect the target screen resolution and automatically switch the output signal accordingly. If that is not possible, fixed 1920x1080 is absolutely OK.
If resolution detection is supported, I personally would love to use my 1680x1050 screen.
Another resolution that would be good to support is: 1280x1024. This would pixel-perfectly fit the Amiga Workbench.
Other than that, I see no reason to bother.  Screens with higher resolutions should always be fine with 1080p input and will show it with proper aspect ratio.

IanSB, 2020-08-04:
>Ideally the RPi should detect the target screen resolution and automatically switch the output signal accordingly

That is problematic. There is no call in the limited bare metal Mailbox API to change physical resolution and you have to specify the resolution in the config.txt file which is only read at bootup.
You can specify auto detected resolution but that will always select the 60 Hz version of the monitor's resolution when in most cases 50Hz is required. Getting the output resolution to match the monitor's physical resolution is important for integer scaling so it is something that needs to be set correctly.
I will have a look at implementing some form of auto detection but it will involve the pi in doing multiple reboots during startup. Even then there is a problem as many of the chinese monitors on ebay will display 1920x1080 and specify that as their default resolution but their physical resolution is usually smaller than that.

>Another resolution that would be good to support is: 1280x1024. This would pixel-perfectly fit the Amiga Workbench.

That isn't actually a good resolution for the Amiga as it will crop any overscanned output to 640x256. Also one other potential problem which happens with the BBC micro is that each different resolution has a slightly different horizontal pixel shift so if 640x256 fits, 320x256 might be shifted a pixel or two left or right losing those pixels.
I mostly use 1600x1200 4:3 LCD monitors as they produce excellent results with all supported computers. The HP LP2065 1600x1200 monitor will also lock to 50Hz on it's DVI input so has the correct refresh rate.

There are potentially many ways around the menu issue:
e.g. There is a serial port on the Pi which is normally used to output debug info but the input could be hooked up to the Amiga's serial output listening for a specific set of command strings which would simulate the button presses.
Perhaps a latch could be mapped into an address with the bits simulating button presses or something similar using an I2C latch.
The above would require a driver of some sort but a driverless approach would be to loop the keyboard connector through the board so that a special combination of kepresses could be detected to simulate the buttons. The main issue with this option would be the actual detection as the Pi is 100% involved in capture and doesn't have the time available to respond to interrupts. It might be possible that one of the Pi's on board peripherals can interpret the Amiga keyboard protocol or may be a little extra external hardware could help.

c0pperdragon, 2020-08-04:
So, a fixed resolution, that's it.
By default I can provide a 1920x1080 at 50Hz setting. Users can easily modify this config.txt von the SD card, I guess. I will also do that for my machine to get a perfect integer scaling.

c0pperdragon, 2020-08-05:
I would like to start designing a PCB for this internal mod. But I feel that this work belongs into the RGBtoHDMI project, alongside all the other kicad folders there.
How could I best contribute to this project?
The matter is a bit confused by the fact that your repo is a clone of hoglet67's which seems to be the single point of truth . So who is in charge of merging stuff together?

IanSB, 2020-08-05:
I've let hoglet do the final merging and releasing so far as it was his project originally but he isn't doing any active development on it at the moment. I also have collaborator access to hoglet's RGBtoHDMI repository.

c0pperdragon, 2020-08-05:
So if I actually issue a pull request, you could also merge this?

IanSB, 2020-08-05:
Yes, I think so.

c0pperdragon, 2020-08-05:
Now I have just managed to sequeeze all parts and traces into the form-factory I have in mind. But only by assuming that I have total freedom to use any GPIO pin of the Pi in any order I want. I need to feed in the 12 color signals + csync + pixel clock.
+5V and GND pins are also connected to power the Pi from the adapter.
But I am sure there are some very specific restrictions which will make my life much harder, I assume. Could you summarize what I need to apply here?
Also I would like some information about the correct signal timings your software can handle. It would be very simple to implement any setup-time for the colors and csync in the range of 0ns to about 8ns.

IanSB, 2020-08-05:
>Could you summarize what I need to apply here?

Here are the current GPIO connections, the RGB values are sequential to minimise the amount of bit shifting to get them formatted for the 16 bit per pixel memory. If you have the space, you might want to bring the switch connections to a header with +3.3v & GND as you will probably need to connect them temporarily to do the initial timing setup for the default profile.

B0 = gpio2
B1 = gpio3
B2 = gpio4
B3 = gpio5
G0 = gpio6
G1 = gpio7
G2 = gpio8
G3 = gpio9
R0 = gpio10
R1 = gpio11
R2 = gpio12
R3 = gpio13

Sync = gpio23
Pixel Clock = gpio17

SW1 = gpio16
SW2 = gpio26
SW3 = gpio19

>I would like some information about the correct signal timings your software can handle

I'm still investigating that as the timings are quite marginal. You may need to prototype this before getting a PCB made in case some specific signal conditioning is required.

IanSB, 2020-08-06:
If you add a pull down resistor on to an appropriate GPIO I should be able to auto detect your board and configure the software for it. I'll have a look at which GPIOs can be used.

c0pperdragon, 2020-08-06:
My envisioned adapter board is indeed a very narrow part and it is pretty difficuly to route the traces. Especially because all the color pins of the Denise are located at one end. So I need to mostly utilize GPIO pins from the same end of the board. With my planned relative orientation of adapter and the RPi, this means the end with  GPIO pin 21.
Would it be OK to use 16 consecutive GPIO pins (lets say 5 - 20) and connect the 12 color signals in some arbitrary way? By this the CPU would need a single shift to put all the data into the lower 16 bits of a register and write them to the buffer.
Is the GPU then able to disentangle all the bits to create the correct HDMI output?

Sync at gpio23 and pixel clock at gpio17 are perfect already.

For a mode selector resistor, I have a bit of space left on one side of the board - so gpio 2, 3, or 4 would be most convenient.

By the way, I have renamed the repo so to better reflect what we are now trying to achieve...

c0pperdragon, 2020-08-06:
Redesigned the board to reach the above mentioned GPIO pins.
It would look something like this:
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

I am not sure about which IC socket to use then. Precision sockets may be of better quality (gold plated), but it is also harder to insert/remove the chip. With this 48pin Denise it could become a real trouble. So I will probably use the sockets with double-sided springs instead.

IanSB, 2020-08-06:
>Redesigned the board to reach the above mentioned GPIO pins.

Do you mean the pins I specified?

One problem I can see with this design: The HDMI port on the Pi will be opposite the large blue capacitor (see my photo above) and the HDMI cable might not fit.

It might work with a 90 Degree cable like this: https://www.ebay.co.uk/itm/90-Degree-Right-Angle-Mini-HDMI-Male-to-HDMI-Female-Adapter-Cable-connector-cord/232016100201
Or a flat cable like this: https://www.ebay.co.uk/itm/20cm-Up-Angle-Mini-HDMI-Male-to-HDMI-Male-FPC-Flat-Cable-For-Multicopter-Aerial/233196072598 (which might also make it easier to route the cable outside the case.)

c0pperdragon, 2020-08-06:
No, actually I have first tried to do it with GPIO5 - GPIO20 to see if it will work at least with this relaxed restrictions.
The actual assignment is:
B0 - GPIO 19
B1 - GPIO 16
B2 - GPIO 20
B3 - GPIO 13
R0 - GPIO7
R1 - GPIO 5
R2 - GPIO 6
R3 - GPIO 12
G0 - GPIO 11
G1 - GPIO 9
G2 - GPIO 8
G3 - GPIO 10
CSYNC - GPIO 16
PCLK - GPIO17

The orientation of the board inside your computer is the same as on my picture. And the RPi will then extend further down. The adapter board and the RPi are not stacked above each other, but extend in opposite directions. I want do do this for better thermal management. At least the Denise chip already gets a bit warm by itself, and I assume the RPi will also generate some extra heat. In this configuration the HDMI cable  should stay clear of other obstacles.
CPU accelerator cards are a problem, but  these normally come with their built-in HDMI solution, so no need to have both.

IanSB, 2020-08-06:
>And the RPi will then extend further down

OK, does that cause any issues with the expansion connector?

The GPIO order may be a problem. The ARM cpu can re-arrange any bit order to match the 16 bit screen memory but that will require a lot of bit masking and shifting which might cause timing issues, keeping each set of four GPIOs sequential so e.g R0-R3 = GPIO n - GPIO n+3 only needs 1 mask and shift for 4 bits.

I'll have to do some tests on that.

The pull down resistor should be on GPIO 18.

Also it would be preferable to have Csync on GPIO23

c0pperdragon, 2020-08-06:
The RPi should ride pretty high because of the height of the adapter board itself and then I will use 8mm pin sockets to plug the Pi into. So I guess it should stay clear of the edge connector.

OK, I will actually give it a try to adhere to your orginal pin assignment for the color pins. Maybe I will need to make the board a tiny bit wider outside the GPIO connector to accomodate the additional traces...

CSYNC is alread on GPIO23 - I just mixed up gipo number and connector pin number in the previous comment.

Pull down on GPIO 18 is pretty easy.

c0pperdragon, 2020-08-06:
Yes!  I managed to route all the signals to your specified pins.  And I did not even have to make the board any larger.
This was really a tough call - had to route some signals through a different flip-flop but in the end it now all looks nice and tidy.

IanSB, 2020-08-09:
I've tested the interlace mode and that works OK, you get weave lines on any motion / screen update as you can see from the boxes in the screen grab below but there is no flicker.
It might be possible to do some advanced deinterlacing on a faster system like the Pi 4 one day.
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

I've also implemented detection of the pull down resistor on GPIO 18 and that seems to work OK, switching the software into "simple" mode with no CPLD. I have tested this in a limited way by configuring for the amiga mode using the CPLD so it is setup correctly to output 12 bits + regenerated pixel clock, then pulling GPIO 18 low and resetting which doesn't reinit the CPLD but it still works.
Note GPIO 18 is normally an output, it is briefly made an input during bootup to detect the resistor. It is weakly pulled high by an approx 50K internal pullup by default so the pulldown needs to be low enough to overcome that but as it is normall an output, you cannout ground it as that will cause damage.

I should have a beta build available in a few days if you want to do any tests.

c0pperdragon, 2020-08-09:
That is really cool! I plan to set up a breadboard circuit to test the software before commiting to have PCBs made and  ordering parts.

About the pulldown resistor: 3.3k should work with enough margin.

IanSB, 2020-08-09:
I've also got it working with a 16 Mhz pixel clock by overclocking the core and sdram clocks on the Pi zero which means that Atari ST support is also possible. The 1000Mhz CPU clock isn't very overclockable but the core and sdram clocks which are around half that speed do seem to be, the core clock seems to improve GPIO access speeds and the sdram obviously improves the uncached memory speed which seem to be the main bottlenecks.

c0pperdragon, 2020-08-10:
As the atari st has only 9 bit per pixel, maybe you can compactify the data a bit to reduce ram access.
i don't know much of the hardware (i was more of an Amiga fanboy) but the schematic show that the individual RGB bits are as easily accessible as in the Amiga.
on the other hand: 8 different voltage leves are maybe not that difficult to reliably detect. if you prefer a purely external solution.

IanSB, 2020-08-11:
I've just built a beta test release (Beta4) which should have the necessary support for your board

https://github.com/IanSB/RGBtoHDMI/releases/tag/20ccba2

You will probably have to temporarily hook up switches to GPIOs 16,26 & 19 (Pins 36, 37 & 35) to change settings.
The default "Amiga" profile has trailing edge sync detection. There is also an "Amiga Leading Edge" profile which you can select which uses leading edge detection instead. I have not been able to test that properly as the CPLD does leading/trailing selection and the simple mode option doesn't work properly with the CPLD.
(Unzip the files onto a blank micro SD card.)

Note the software will hang up if there is no pixel clock (7.1Mhz) so you will need to have at least that connected before you can call up any menus.

Also note the CPLD suppresses the pixel clock for a couple of cycles after the active H sync edge to avoid glitches because the regenerated pixel clock isn't an exact multiple of the line length:

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

Your simple system shouldn't need to do that but it probably means some slight adjustment to h-offset picture centreing will be needed in the geometry menu.

c0pperdragon, 2020-08-11:
I am closing this issue now as it is much too long. Answer follows on other issue...

Closed 2020-08-11.

Thread 4 (2020-08-11):

Amiga Support 2

c0pperdragon, 2020-08-11:
Continuation of https://github.com/c0pperdragon/Amiga-Digital-Video/issues/3

@IanSB
Would it be possible to provide a specialized settings menu that can be controlled with a single button? Like press to switch through options and press long to select.
For the internal installation in an Amiga 500 I would like to place the HDMI port at the small unused area on the backside and put the single push button next to it.
Its main purpose would just be to select different output resolutions and maybe the framerate.

IanSB, 2020-08-11:
>Would it be possible to provide a specialized settings menu that can be controlled with a single button? Like press to switch through options and press long to select.

Yes I would think so. There is already long/short press detection to allow multiple options on each button when not in menus like screen grab, NTSC colour on/off,  Scanlines,  Calibration etc.

c0pperdragon, 2020-08-11:
I will start breadbording the thing tomorrow. Will postpone hooking up the C64 to the RGBtoHDMI.
One detail in signal timing: For me it would be easiest to change both the color signals (including sync) and the pixel clock at exactly the same time. The signals will stay 100% stable until the next edge of the clock.
Ist this your expected behaviour?

IanSB, 2020-08-11:
>One detail in signal timing: For me it would be easiest to change both the color signals (including sync) and the pixel clock at exactly the same time.

That should be OK, At the moment the sync and pixel clock inputs are polled and action taken immediately after a state change so there will be a slight software delay between the state change and reading the RGB values although I am not sure exactly how long that delay is. As previously mentioned, the pixel clock is read on both edges so should be 7.1 Mhz.
BTW I notice you design uses a separate 3v3 regulator but you might be able to power it from the Pi's 3v3 output.

c0pperdragon, 2020-08-12:
I know that the RPi provides 3.3 volt, but I don't want to use it, as this could cause problems in case that the RPi is unplugged from/not yet  plugged into the mod board. Maybe the LVC parts behave nicely when no power supply is available and the inputs are driven, but I better do not try my luck here.

About signal timing when changing clock and the other signals at the same time: When the sync and pixel clock inputs are polled at the same time (just a read on the port address, I guess), than it could very well happen that the clock has already changed, but the sync did not. Due to the polling normally happening in some regular non-zero intervall, the probabliy to hit just this criticial point in time is quite small. Nevertheless it could happen and I better avoid this by applying a bit of delay (5 ns or so) to the clock signal.
With this delay, there is now also a strong guarantee for the setup-time  for both the sync and color signals. Having this, it would be permissible for the CPU to just poll all the GPIO pins until the clock signal changes (I guess fetching 32 bits at a time would be no slower than fetching only a few). Then the other bits must also already contain the newest values. By this you only need to do a single GPIO fetch per pixel in case the CPU is already behind schedule. When the CPU has already catched up, it will still do multiple polls until the clock changes (but none extra to get the pixel data).
Maybe this small optimization is just enough to get 16Mhz without overclocking...
I guess you could make this clocking scheme part of your communication protocol between CPLD and RPi also.

IanSB, 2020-08-12:
The GPIO register is polled just to read the sync edge first, then a small amount of processing is done, then the GPIO register is polled to read the pixel clock with that same value read from the GPIO register at that time used to extract the RGB bits.

c0pperdragon, 2020-08-12:
I still don't quite get it, why the sync is not also a synchronous signal that is taken at the edge of the pixel clock.
Anyway, I will just add a 5ns delay for the clock. Then the colors and the clock can be reliably read with a single port access.

IanSB, 2020-08-12:
>I still don't quite get it, why the sync is not also a synchronous signal that is taken at the edge of the pixel clock.

I'm trying to support this with a common codebase and the above cannot work with the CPLD.  It is also difficult to have branching in time critical sections so alternate capture versions may require lots of code duplication.

The psync signal (pixel clock) coming out of the CPLD is generated from the hsync pulse and a Pi clock so you can't then use that to sample the hsync pulse.
The Pi software measures the time between hsync pulses and from the geometry menu it knows how many cycles there should be in that time so it can work out the exact pixel clock frequency.  It then sets an internal PLL in the Pi to 6x or 8x that frequency which is then output on a GPIO into the CPLD.

This means there are 6 or 8 cycles for each pixel and the CPLD then counts up using a 6 or 8 state counter (which is reset by the hsync pulse) until the count matches an offset value in a register which then triggers the psync output into the Pi and varying the offset value will vary the phase of the psync output with respect to the hsync pulse to get the sampling point correct.

The regenerated psync clock has jitter of 1/6 or 1/8 of a pixel and it can also drift slightly over the duration of a line as the Pi generated clock will never perfectly match the original. The sync timings are continually measured and the pi clock updated so it is effectively a slow software phase locked loop.

The psync signal isn't even a pixel clock in 3 or 6 bit modes as two or four pixels are output on the 12 bit bus for each psync edge.

As the phase of psync can be varied 360 degrees with respect to hsync,  the psync signal out of the CPLD is suppressed for a couple of cycles after the active sync edge, to avoid any timing issues which your board won't be doing although in your case the phase will always be fixed. Worst case it may require some software tweaks or even a hardware change if there are issues.

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

c0pperdragon, 2020-08-12:
This really sounds astonishingly sophisticated. I guess the biggest challenge was to divide the work between the CPLD and the RPi given the individual limitations of either one. Just like the most sophisticated retro-gamed and demos work 🙂

c0pperdragon, 2020-08-12:
Hi!

I have set up everything on breadboard as discussed and it starts to look quite promising.
But I experience quite some horizontal jitter by one or more pixels.

The first capture was taken with the pixel clock and all other signals being switched at the exact same time.
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
The second capture was taken with the pixel clock delayed by about 5ns.  This looks better, but is not really correct yet. Unluckily delaying the clock signal even further gives no noticeable improvement.
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

IanSB, 2020-08-12:
Is it any different with trailing edge?

There is a potential timing issue with leading edge due to a value being pushed onto the stack:

The code behaves as follows:

For trailing edge:
Wait for sync low
Read timer
Write time to stack
Wait for sync high
Wait for psync/pixel clock

For leading edge:
Wait for sync low
Read timer
Write time to stack
Wait for psync/pixel clock

In trailing edge the stack write time doesn't matter but it is in the critical time path on leading edge and I know from previous experience that such memory writes can cause unpredictable delays.
The only way around this is to rework the code to save the value in a register as all other parts of the code are solely register and GPIO access based with the only memory writes being to screen memory.

BTW I've nearly got single button menu operation working.

c0pperdragon, 2020-08-12:
Trailing edge profile (just ,Amiga') is worse. There I also get vertical jitter.

IanSB, 2020-08-12:
Could you try overclocking your pi zero with leading edge to see if that improves things.
Edit Config.txt to change
[pi0]
...
core_freq=400
sdram_freq=450

to
[pi0]
...
core_freq=500
sdram_freq=500

Make sure you edit the Pi0 table

To confirm the settings have changed, call up System summary in the info menu. If they hang your Pi, try some lower values, those are the values for 16Mhz pixel clock.

Note to keep these settings under all conditions you also need to edit default_config.txt as config.txt gets rewritten from that file when changing resolution or some other settings.

If that improves things it points to the stack instruction as a possible cause.

c0pperdragon, 2020-08-12:
Overclocking actually fixed the horizontal jitter.
Two problems remain: There is glitch in the top line of the screen (looks like it is shifted to left occasionally). This is especially visible in the boot-screen where everything is white with black side borders.
The second problem are sparkly pixels at edges:
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
I can change the exact apperance of the wrong pixels by varying the pixel clock delay. Sometimes the pixels become cyan, sometimes black, sometimes red.

IanSB, 2020-08-12:
Here's a version of the kernel code with the stack instruction removed, can you try that with the overclock removed:
(Unzip and overwrite the existing file on the sd card)
[kernelrpi.zip](https://github.com/c0pperdragon/Amiga-Digital-Video/files/5066202/kernelrpi.zip)

As far as the sparkly pixels go, I think you will have to match the phase relationship between the rgb levels changing and the pixel clock changing on the CPLD as it seems very sensitive to that, but I will measure it to confirm the timing.

IanSB, 2020-08-12:
BTW go to the preferences menu and change the Screencap Size option to "Full Screen" followed by "Save Configuration" in the main menu as that will make bigger screencaps to see these issues.

IanSB, 2020-08-12:
On the CPLD the pixel clock changes 11.6ns after the RGB data. This is 1/6 of a 14.3 Mhz pixel clock cycle (due to the x6 clock mentioned above) and is what I expected from the CPLD code but I also measured it to confirm:

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

IanSB, 2020-08-13:
I see the glitch at the top of the screen very occasionally on the CPLD version but only when switching the menu on and off and it is caused by cacheing issues:
The cpu program cache is pre-loaded by running the capture loop to off screen memory during vertical blanking but it isn't always 100% effective due to the random cache replacement policy. I think you may be seeing this more because your pixel clock pulses aren't suppressed after the active sync edge. If some code takes slightly longer on the first line due to cache reloading you will miss 1 or 2 pixel clocks which results in the left shift.
The CPLD version suppresses those first couple of clocks so there is more time available to load the cache before a clock is missed.

You might be able to achieve a similar result by suppressing the pixel clock fed to the Pi during the hsync period and this may also resolve the first problem above of lines shifting by a couple of pixels without needing overclocking.

c0pperdragon, 2020-08-13:
The new kernel did not help much. Without overclocking, the horizontal jitter remains.
With overclocking, the jitter disappears and by fine-tuning the pixel clock delay to about 8ns, the sparkly pixels look least bad.

All this looks more and more like it is not going to work without changing (rewriting?) the sampling loop to directly fit the needs of the non-CPLD input. My circuit is very primitive and in a final product, I can not adjust the various delays to the degree possible right now. Also I can not suppress the pixel clock during hsync - this would probably need an additional IC and I can not squeeze any more onto my target board size.

What I really could do and guarantee is a minimum (but rather short) setup-time and a hold time for nearly the whole pixel duration for both color and csync lines.  A loop that just polls all GPIOs at once and when the pixel clock did change use all other (csync, color) bits from the data to do its thing before starting to poll again would be most stable, I think. This would also perfectly account for minor stalls in the program flow (50ns or so ) because the CPU could reliably catch up later, given that no further stall occurs immediatly after. If RAM write is a major headache, the program could collect two pixels together and write them as a single 32bit operation every other pixel. Because of the tolerance for stalls in single pixels, this may improve the matter.

To give you an incentive, I could in return rework the C64 sprite handling - there we are facing just the same problem: Fluky operation that may be solved by a serious implemention effort ;-)

c0pperdragon, 2020-08-13:
One additional complication with the current setup is the fact that my circuit together with the Amiga hardware produces a rather non-50% duty cycle on the pixel clock.  It is about 60ns - 70ns right now.

On the other hand, I found a way to reliably use the rising edge of the sync:  Only consider the sync signal that is taken at the rising edge of the pixel clock as valid. This reduces the resolution for the sync to 7.1 Mhz. Color values still come at double this speed.

(all this was already assuming a specialized sampling route, of course)  ;-)

IanSB, 2020-08-13:
>If RAM write is a major headache, the program could collect two pixels together and write them as a single 32bit operation every other pixel.

I'm already doing that with 8 pixels being written by a single four word burst write instruction.

>A loop that just polls all GPIOs at once

It already does that for the pixel clock and pixel data. It only separately polls the sync and I think the double GPIO read when switching from sync detection to pixel clock detection is causing the problem as GPIO reads are relatively slow. Overclocking the core rather than the CPU seems to speed up GPIO reads which is why that works.

Can you try this version which polls the pixel clock for the sync detection so there is no double GPIO read:

[kernelrpi.zip](https://github.com/c0pperdragon/Amiga-Digital-Video/files/5070116/kernelrpi.zip)

I can't test this properly as it doesn't work with the CPLD signals due to jitter between the sync and regenerated pixel clock.

Also in the zip is the file "One_Button_Mode". If you put that in the root of the SD card and reset the pi it will switch to one button operation to drive the menus.
Hold down SW1 to call up menus and select menu lines and briefly press SW1 to move down menu options and adjust values. You can drive the entire menu system with just the one button.

c0pperdragon, 2020-08-13:
I have used this kernal, and I can get stable horizontal sync when I just overclock the core_freq to 440.  with sdram at nominal 450.

The glitch in the very first line is still apparent but very strangely it depends on the actual color of this line. When using the color sliders in the preferences, I can easily make it disappear by making the background color darker.
The same thing happens to the sparkly pixels which totally go away when darkening all the colors, so there are no high-contrast edges anymore. Tried this also with interlaced mode which also worked without glitches, besides on the mouse cursor which still has high contrast colors (combing artefact looks kind of funny on the mouse cursor).

Both things hint at the problem being just the transmission wires and my overall breadboard setup. I trust that this will completely disappear with a proper PCB with short traces lower contact resistances.

The one-button interface works nicely, with the exception of setting numerical values which can only be incremented seemingly forever. I will update the adapter board schematics accordingly.

If we are OK with overclocking the RPi in this rather mild manner, the next step would be to produce a complete adapter and see if this fixes the sparkly pixels.

c0pperdragon, 2020-08-13:
The delay between signal change and the clock change is now about 7ns which seems to be the sweet spot. 5 ns also work, and I guess it would also go lower with better transmission lines.

c0pperdragon, 2020-08-13:
I have finished work on the PCB and have already create the gerber files. Could you have a look at the schematics if everything we discussed is now as it should be?  Then I would place the order for the PCBs.

IanSB, 2020-08-13:
I think there are only two possibilities for the sparkly pixels:
1. transmission line issues as you mentioned. There was a similar problem when someone hand built a prototype of the CPLD design which is mentioned here:
https://stardot.org.uk/forums/viewtopic.php?f=3&t=14430&start=1110#p275202
with solution here:
https://stardot.org.uk/forums/viewtopic.php?f=3&t=14430&start=1110#p275917
2. Timing issues caused by the asymmetric clock

Also maybe the need to overclock is required because of the asymmetric clock.

I've changed to detect only one edge of the pixel clock during hsync detection which should double the available processing time so can you try that:
There are two versions for the different edges:
[falling.zip](https://github.com/c0pperdragon/Amiga-Digital-Video/files/5071200/falling.zip)
[rising.zip](https://github.com/c0pperdragon/Amiga-Digital-Video/files/5071201/rising.zip)

Can you try these with leading and trailing sync detection with no overclock. Don't be too worried about any vertical jitter as that will be something else and should be fixable if the horizontal looks good.

Is there any way you can test with a symmetric clock even if you have to get it from elsewhere on the board just to see if it makes any difference?

IanSB, 2020-08-13:
>Could you have a look at the schematics if everything we discussed is now as it should be?

The board looks OK as far as I can tell.

>The one-button interface works nicely, with the exception of setting numerical values which can only be incremented seemingly forever

They will wrap eventually but it is not very usable for adjusting such things. I will add a menu option to reverse the direction of adjustment for short keypresses which should help a little but it would still be painful to use for anything except a minor tweak of numerical values. It is still quite useful for setting resolution, scaling and other preferences though.

IanSB, 2020-08-14:
Here is a further update:
[kernelrpi.zip](https://github.com/c0pperdragon/Amiga-Digital-Video/files/5072082/kernelrpi.zip)

This has two changes:
1. The sync edge setting in the sampling menu now has six options
   "Trailing with +ve PixClk",
   "Leading with +ve PixClk",
   "Trailing with -ve PixClk",
   "Leading with -ve PixClk",
   "Trailing with +- PixClk",
   "Leading with +- PixClk"

The +ve or -ve PixClk settings only check on those edges of the pixel clock and the +- ones check on both edges
This incorporates the different builds above into one build.

Please try all six options to see if any are glitch free without overclocking

2. There is now a "Button Reverse" option in the main menu which only shows up in single button mode and that reverses the direction of short button presses when enabled.
You can use this to increment or decrement values which makes the whole system more usable for tweaking settings.

c0pperdragon, 2020-08-14:
I have tried the various sync edges without overclocking, and quantify these from 10 (flawless) to 0 (totall unusable):

Trailing with +- PixClk       9    (rare jitter, about once every few seconds)
Leading with +- PixClk      8   jitter more often but sometimes with a second between glitches
Trailing with +ve PixClk    1 very jittery, about every third line is wrong
Leading with +ve PixClk    3 about every 10th line is wrong
Trailing with -ve PixClk     3
Leading with -ve PixClk     2

By fine-tuning the clock duty cycle to 50%, I got the option "Trailing with +- PixClk" to work without any jitter at all.
But it was very difficult to find the perfect spot and it is not completely stable, either.

Still have sparkly pixels when having colors on high-contrast edges.

c0pperdragon, 2020-08-14:
I guess it makes not much more sense to try to get it working any better on the unreliable breadboard wiring. I have just now placed an order for the PCBs.

IanSB, 2020-08-14:
>By fine-tuning the clock duty cycle to 50%, I got the option "Trailing with +- PixClk" to work without any jitter at all.

I think it only just works with a perfect 50% duty cycle so any variation may require some amount of overclock to compensate.

>I guess it makes not much more sense to try to get it working any better on the unreliable breadboard wiring

Yes I think we are close to a solution but there is too much likelyhood of prototype wiring causing issues so a pcb is the next step.

However I found there was a bug in the +ve and -ve sync edge options which actually made them level sensitive, not edge sensitive so I have fixed that:

[kernelrp-edgefix.zip](https://github.com/c0pperdragon/Amiga-Digital-Video/files/5077711/kernelrp-edgefix.zip)

With the CPLD, two of the new +ve and -ve options are better than the +- versions and two are worse so maybe worth a test.

c0pperdragon, 2020-08-28:
Hi!

I received my PCB for the adapter board yesterday and completed the build. Pictures of the process can be found directly in the Repo.

The results are just perfect. With the short traces and good contacts I have not experienced a single visual glitch in several hours of testing and playing. I used your latest firmware patch with the setting to "Trailing with +ve PixClk".
Directly after switching this option there normally is a short period with one single line (roughly in the middle of the screen) having glitches. This dies down quite quickly and then I have a stable picture for basically any of your sampling options.
 Only in one instance this glitchy line remained permantently until I switched the mode again.

I am not sure how to test situations where the clock duty cycle is more unbalanced than on my machine. With this small board and everything wired on the PCB, I have not much possibility to influence any of the signals.

Even worse, I can no longer use my Amiga without the adapter board, because the Denise chip is now directly soldered to it.
This was necessary, because I managed to break a leg of the chip in a way that only the slightest sliver of metal was still visible on the side of the package. This in turn happened due to the most infernal stroke of bad luck I have ever experienced with ICs: Somehow one pin of the Denise got stuck inside the socket on my prototype board and would not come loose, no matter what I tried. I even melted the socket pin out of the plastic to isolate the problem, but still no luck. The IC pin totally disintegrated but its tip is still inside the socket pin.

IanSB, 2020-08-28:
>I received my PCB for the adapter board yesterday and completed the build.

I received my PCBs today, including your Amiga, Atari XL and C128 boards as well as my new 12 bit external version of  RGBtoHDMI. (I haven't ordered the components yet so it will be some days before I can test your boards)

>The results are just perfect.

That's great!

>I am not sure how to test situations where the clock duty cycle is more unbalanced than on my machine.

Are you still overclocking your Pi?

I've added menu driven overclocking to the latest build of the software so you can dynamically vary the overclocking and observe the effects. I've been experimenting with 12 BPP capture using a 16 Mhz pixel clock and it works well with a 100Mhz overclock of the Core frequency (the CPU and SDRAM clock speeds don't seem to have much effect so it looks like the Core is the bottleneck).

I assume the Core clock affects the internal bus transfer speed but it is also used as the clock for the GPU which would normally limit the maximum overclock without heatsinking. However as the GPU isn't used, it looks like you can easily overclock the core by up to 200Mhz. (I have about 20 Pi zeros so I will do some tests to see how reliably the core can be overclocked.)

I'll get a new beta build ready in the next day or two.

I might also add an initial attempt at Atari XL support, would you be able to test that?

c0pperdragon, 2020-08-29:
It is very good that you want to try the C128 modification, So far I have received no feedback from anyone who actually tried this.

I am using the beta4 release with your latest kernal patch. I have not set any overclocking for this.
Measuring the pixel clock duty cycle now shows me it is pretty even. It is about 69 ns to 72ns.
Also there is now a 3ns delay between the data signals changing and the edge of the pixel clock. This seems to be enough for your software to work properly as the signals are now traveling short distances and through good connectors.

It is good to know that there is some margin that can be gained by overclocking for cases where the duty cycle is more off.

I am using the single-button user interface to tweak the settings. But for casual users of just the Amiga variant it would be easier to use the button exclusively to change the target resolution. Maybe when the single button file is not present in the Amiga configuration, there will be no menu at all. Just switching through output modes.

And yes, I will of course test your Atari 8-bit configuration. I am looking forward to watch the "Joyide" demo in perfect quality.

c0pperdragon, 2020-08-31:
I am basically done with my test on the Amiga.
I imagine I had very ocassional sync glitches (once every hour or so) when using "LeadingEdge +- clock", so I switched to "LeadingEdge -ve" and I did not notice any problem from then on.
I have created a pull request for the adapter design and included the resolutions files for 1680x1050 as well.

IanSB, 2020-08-31:
You can extend the micro SD card to allow access outside the case or to put it near the ram expansion slot internally to make it easy to do upgrades or recover screencaps without disassembling the Amiga using something like this:

https://www.ebay.co.uk/itm/TF-Micro-SD-To-SD-Card-Extension-Cable-Adapter-Flexible-Extender-For-Car-GPS/383658051187

The above is just an example, they come in different lengths so you can usually find one that is suitable for the location.

c0pperdragon, 2020-09-03:
It may sound strange, but after more or less completing the Amiga solution, I am actually thinking about a different approach that is more in the spirit of the RGBtoHDMI project:
To use the external converter box with 6 bit of color input and multiplex the 12 bits on these lines, very much like we do for the Atari 800 now.
By re-purposing some of the basically unused pins of the Amgai video port, this could be done without any changes to the case. The relevant signals for analog video would still be there for use as normal.

I am pretty sure your CPLD is up to the ask, as you already managed to process EGA data in a comparable bit rate.

The internal modification requires soldering. Unsolder register packs RP402 and RP403, solder leads to the various pins of the Video Hybrid (as you did for testing) add a small mod board and feed the output signals into the holes left by RP402 and RP403.
Additionally get the two system clocks from somewhere and that should be it. The board should also be fairly cheap with some flip-flops and multiplexers (need to think of this in more detail).

Externally a custom cable is needed. This could be a bit of a problem because the D-SUB 23 seems to be out of production for ages . But a D-SUB 25 can be sawed down to fit (did work with my Amiga-to-YPbPr adapter)

c0pperdragon, 2020-09-03:
nonono.
Just forget my previous comment. This is just too complicated and serves no real purpose.

andriodious, 2020-09-06:
Just tried the internal board and I must say the results are spectacular compared to the external monitor connector via SCART. Fantastic job guys!

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

andriodious, 2020-09-06:
Now with a tweak to the settings, time to shut down and start drilling the case 👍
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

IanSB, 2020-09-06:
>Just tried the internal board and I must say the results are spectacular compared to the external monitor connector via SCART.

Looks great!

IanSB, 2020-09-06:
One suggestion for the pcb:
Extend the end of the board by pin 1 / pin 48 of the denise chip by a couple of mm then put a hole in the corner by pin 48 to match the hole in the raspberry pi so
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

Thread 5 (2020-08-31):

Atari 8 bit

c0pperdragon, 2020-08-31:
Created a new specific thread. The previous was getting too long already.

My profile is now this:
[Atari_800_14Mhz.txt](https://github.com/c0pperdragon/Amiga-Digital-Video/files/5152386/Atari_800_14Mhz.txt)

As I have seen as comments in my palette generation program, I unsuccessfully tried to create a palette  from an algorithm. This just did not look good, so I have switched over to a pre-made one.
But it also had color issues as well

I have now downloaded a bunch of different variants and will try which one maches my TV best.

by the way: I just spotted a glitch in my firmware. So far it appears in only one demo that messes with sprites...

c0pperdragon, 2020-08-31:
The Altirra emulator has a very sophisticated way to set up the palette by parameters:

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

But I have no idea, what this all means...

IanSB, 2020-08-31:
If you want to try creating your own palette file for RGBtoHDMI the format is as follows:
The file is a 1K binary and is 256 32 bit values with bit order as follows:
0xMMBBGGRR
RR GG BB are the rgb values from 0x00 to 0xff
MM is the value used in mono mode from 0x00 to 0xff

For the Atari only, the order of the words in the 1K file is slightly re-arranged due to a problem with the menu system which normally uses the top bit of the palette:

Normally Atari palette is indexed like this:
C3,C2,C1,C0,Y3,Y2,Y1,Y0
but the palette file words are indexed so that the lsb of luma is in the msb:
Y0,C3,C2,C1,C0,Y3,Y2,Y1

Y0 is forced to 0 when the menu is on screen but as it is 0 in most cases already doing it this way means the least disruption to the screen when the menu is enabled.

The above means that:
word 0 is chroma = 0, luma = 0
word 1 is chroma = 0 , luma = 2
..
word 128 is chroma = 0 luma = 1
word 129 is chroma = 0 luma = 3
etc.

Put any file you create in the palettes folder and select it from the palette menu after rebooting the Pi.

IanSB, 2020-09-01:
Here is an updated test version:
[AtariTestV0.02.zip](https://github.com/c0pperdragon/Amiga-Digital-Video/files/5153384/AtariTestV0.02.zip)
This has the 6 bits per pixel modes also running at 14Mhz so it can work in YUV mode as well which makes it easier to switch between C64 and Atari.

In RGB mode there are 4 profiles to test:
Atari 800XL 1 - uses 3bpp mode with double width frame buffer (equivalent to the old 14Mhz test profile)
Atari 800XL 2 - uses 3bpp mode with normal width frame buffer
Atari 800XL 3 - uses 6bpp mode with double width frame buffer
Atari 800XL 4 - uses 6bpp mode with normal width frame buffer

In YUV mode there are two profiles:
Atari 800XL 3 - uses 6bpp mode with double width frame buffer
Atari 800XL 4 - uses 6bpp mode with normal width frame buffer

All six should work identically but exercise all possible combinations of capture loops so can you check them all.
You might have to adjust the delay value in the 6bpp modes

c0pperdragon, 2020-09-01:
I have tried all these possibilities and after tweaking the delay and setting the palette, all these look identical and perfect. Here are all my saved profiles for this:

[Saved_Profiles.zip](https://github.com/c0pperdragon/Amiga-Digital-Video/files/5154761/Saved_Profiles.zip)

c0pperdragon, 2020-09-01:
I also extracted the default PAL and NTSC palettes from Altirra (easy with export function) and converted them to RGBtoHDMI format. You can get everything at: https://github.com/c0pperdragon/A-VideoBoard/tree/master/atarimod/palette

c0pperdragon, 2020-09-01:
Just in case you have not yet found the bill of materials for the GTIA adapter board:  https://github.com/c0pperdragon/A-VideoBoard/tree/master/atarimod/doc

IanSB, 2020-09-01:
I've ordered the parts for the Atari and Amiga boards which hopefully should be here tomorrow

Here is a finalised version of Atari support to test:
[AtariTestv0.03.zip](https://github.com/c0pperdragon/Amiga-Digital-Video/files/5157859/AtariTestv0.03.zip)

This generates palettes based on your Altirra ones and there is now only one profile which is in YUV mode (You can copy it to the RGB folder if needed)

Can you confirm that it is OK and I'll commit the changes.
Maybe post some screencaps?

c0pperdragon, 2020-09-01:
This version seems to have the same palette as the Altirra, which looks pretty good and very similar to what my CRT displayes.
I have made a few captures of various games and demos.  I is quite astounding how small these .PNG files are...

Bad thing is, I have found another issue with the GTIA emulation. This time it appears at the weird graphics mode, the "Reharden" demo uses...

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

IanSB, 2020-09-01:
Looks good, but the image isn't centred as I had to just guess the H and V offsets so can you try centreing and post your saved profile. (Go into the geometry menu and adjust the H and V offset values using that text page above as the source)

> I is quite astounding how small these .PNG files are...

There is zero noise in the images so they compress very well.

(BTW did you see my post in the Amiga thread about using an SD card extender to get screencaps without having to disassemble the machine - I will make short button presses with no menu do a screencap in simple mode so that would be useful)

c0pperdragon, 2020-09-01:
I just set H Offset = 68  and V Offfset = 60.  This looks pretty centered now..

c0pperdragon, 2020-09-01:
About the SD extender: Yes, this would be an optional extra, like the single button. I will stay with my simple solution and not have screencaps.

I have found and fix the bug that messed up the "Reharden" demo. So I did the screenshots again and they look correct this time. The difference is not so easy to spot, but people who know would see it. Additionally they are properly centered now.

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

An because I already have the SDcard out, here is my saved profile:
[Atari_800_(625).txt](https://github.com/c0pperdragon/Amiga-Digital-Video/files/5159012/Atari_800_.625.txt)

IanSB, 2020-09-04:
I've built up my board but it's not working properly so far:
After inserting the extender board, the analog output still works so I don't think any GTIA signals are getting messed up and each buffered output from the board has a valid looking signal on it but when I connect it to the A-board I had from you I get a picture with messed up sync:
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

The above is currently using the normal 288p output as I was also testing with a retrotink, it's not configured for the special Atari output yet.

Any ideas what the problem is?

c0pperdragon, 2020-09-04:
This looks really pretty bad.

First thing to check is the clock signal - this must surely be somehow strange. Otherwise you would at least have output lines that match up. Particularly check if the edges are well defined with not too much ringing. This could be a specific problem when the wires are too long. Normally my ribbon cable is just long enough to get from the adapter board to the FPGA board.
To improve the clock signal you could try to use a different resistor value for R10. Those 100 Ohm are really only a ball-park figure. Maybe you can tweak this a bit...
The frequency needs also to be correct, and stable of course.

Second thing is the voltage 3.3V rail on the the adapter board. I have not used this particular voltage regulator before (I took a replacement you could get from digikey).  If this is now missbehaving in conjunction with the 1uF capacitor this could also cause any bad behaviour.

c0pperdragon, 2020-09-04:
Oh, just to make sure:  The FPGA board needs to be connected to the same GND as the adapter. There is no GND connection via the connector cable.

IanSB, 2020-09-05:
I used the same 3.3v regulator that I used on the analog board as there was no stock of the specified part.

I also did the following tests:
I programmed the C64 fpga code into the A-Board and that worked OK with the C64 so the A-Board is OK
I programmed the Atari fpga code into the C64 board and got the same glitchy display so the issue is definitely with the new buffer board.

There is a huge amount of ringing on all signals and I notice that this design uses LVC parts compared to HC parts on the original board so that might be the problem as LVC is much faster and those fast edges are going to produce a lot more ringing.

Any suggestions for values to try for R10?

It looks like it is generating hsyncs but vsyncs are missing or random so does that point to any particular signals to check?

I configured it properly for RGBtoHDMI mode and it is at least producing the right colours:
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

If I can't find any obvious faults I think I will build another board with HC parts to see if that improves things.

c0pperdragon, 2020-09-05:
Yes, the main difference between my own build and yours are indeed the LVC parts. I changed this to get proper level conversion without pulling down the inputs and/or raising the supply voltage through the input clamping diodes. As this worked so nicely on the C64 I thought this should be the right choice here also.

Before changing everything to HC, please try first to get the clock signal right, because this must be the main issue.
There a two points to tweak: A different resistor (use a 440 Ohm to see if it changes the signal at the end of the cable). Maybe send me an oscilloscope capture of the 100 ohm and the 440 ohm results.  Second possibility is a small capacitor from the resistor (right before the signals reaches the cable) to ground.

But maybe the atari clock itself is the problem. On my machine it has a very regular edge on one side but the other edge is very jittery - so I just use the "good" one. Could be different on your machine. I really need an oscilloscope capture here.

c0pperdragon, 2020-09-05:
If you are already using the oscilloscope please do check the 3.3V rail. I actually cheaped out on the capacitors and used 1uF instead of 10uF as I did for the C64 board. Maybe this worsens the matter.

c0pperdragon, 2020-09-05:
Part of the ringing could be created by not tighly tying the GND lines together. If you for example ground your oscilloscope probe to some distant point this shows much more ringing than would actually be there. In any case the ringing of the data signals should not cause the trouble. The clock (pin 19 on the cable) is the relevant factor here

c0pperdragon, 2020-09-05:
Of course, I meant 470 Ohm the previous comment, not 440.

IanSB, 2020-09-05:
I changed the resistor to 470R and also changed C1 and C2 to 10uF and I now have a locked picture but there are still glitching pixels.

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

Any other suggestions?

c0pperdragon, 2020-09-05:
I still would like to see the clock signal as it is generated by the atari (GTIA pin 29), and how it looks when arriving at the FPGA board while everything is plugged together (an open cable could distort the measurement). This would be GPIO1 pin 19, or FPGA pin 105.
It would be best to send me an oscilloscope capture of both signals in one view.
Maybe I can spot something suspicious.

c0pperdragon, 2020-09-05:
Another thing would be to look at the video output using the retrotink X2. To see if the mod board gets wrong data and produces the glitches, or if only the pixels are so unregular that the RGBtoHDMI can not decode them properly (this would be similar to what caused the sparkly pixels with the C64 and the old clock generator circuit).

IanSB, 2020-09-05:
Here's the clock:
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

c0pperdragon, 2020-09-05:
Which clock is this? The original ATARI (GTIA pin 29), or what comes to the mod board. In any case I would need the second to directly compare signal and phase.

This one actually looks pretty noisy.

IanSB, 2020-09-05:
That is pin 19 on the A-board header

Here are both signals:

Yellow is pin 29 of GTIA, cyan is pin 19 on A-board.

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

I tried with a retrotink and I am still seeing glitches on characters like the above screencap.

I also tried using the short 5cm cable and the picture was a lot worse.

c0pperdragon, 2020-09-05:
This signal is really terrible. The GTIO clock is so much cleaner. I don't know what causes this. It is no ringing but some kind of high-frequency noise.
Because of the resistor there is a very visible RC curve which may or may not cause some extra problems.

The fact that shorter cables make the issue even worse suggests that the noise is not picked up by the cable or is a result of signal reflection or something like that.
It really seems that either the level shifters do some very bad thing or the voltage regulator creates this noise. In fact there are some voltage regulators that need some very specific filter caps to work properly.
Please do check the 3.3V rail.
If this is indeed looks reasonable your only option may indeed be to go for the HC parts.

The Atari signals are nominally 5V, which would cause a whole load of troubles for HC being powered at 3.3V. But in fact the voltages are much lower and probably below the input clamping threashold. If you can verify that all the relevant GTIA pins are indeed newer exceeding 4V, the HC logic parts can very well be used for level shifting to 3.3V.
Maybe I should have designed your adapter board in this way from the very beginning. I just wanted to make sure not to break anything.

c0pperdragon, 2020-09-05:
Somehow I still can not believe that a properly working LVC part could produce such noise when it is not actually switching.
To try a very wild guess, maybe some input pins do not make contact and are now floating wildly and oscillate in some feedback loop. This could very well induce all this noise.

Or the part is just faulty.

IanSB, 2020-09-05:
>It really seems that either the level shifters do some very bad thing or the voltage regulator creates this noise. In fact there are some voltage regulators that need some very specific filter caps to work properly.

The regulator is MCP1754S-3302 which has a minimum of 1uF load capacitor and max of  1000 μF so 10uF should be OK

This is the 3.3v regulator output which is showing 250-300mV of noise:
(measured across the output capacitor so a good ground).

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

>To try a very wild guess, maybe some input pins do not make contact and are now floating wildly and oscillate in some feedback loop.

If the LVC inputs were floating the video output wouldn't work at all would it?
(I checked the unused inputs were grounded)

>The Atari signals are nominally 5V, which would cause a whole load of troubles for HC being powered at 3.3V.

What regulator did you use on your HC based prototype?

c0pperdragon, 2020-09-05:
Because I could not remember what part I used, I just took a look and was quite surprised to find this brutal hack I did years ago:
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

I can dimmly remember that I somehow shortend and burned the last of the regulators that would fit the board, so I took another one I found in my spares box and somehow made it "fit". Works a treat, actually  :-)

Bad thing is, I have not the slightest idea, what this is.

c0pperdragon, 2020-09-05:
But it could very well be the same part as I now use in the C64 adapter board. It seems to be the same package at least.
https://www.mouser.at/ProductDetail/Microchip-Technology-Micrel/MIC5504-33YM5-TR?qs=U6T8BxXiZAUmVQ5Zs217qQ==
And it never gave me any trouble.

c0pperdragon, 2020-09-05:
Reading the datasheet of this part, I really guess it is it, because it just fits in this diagonal way.
This will teach me to not give out designs that were only based on guesswork. Especially power supplies and regulators are always ready to surprise you.

c0pperdragon, 2020-09-05:
Still the hypothesis of an open input contact is not 100% impossible. There are some inputs that are not used and are only tied to ground normally.

IanSB, 2020-09-06:
>There are some inputs that are not used and are only tied to ground normally

I already checked the grounded inputs were connected to 0v and the other pins on the 20 way connector have what looks like valid signals so I guess that regulator might be the problem with those LVC parts.

>Reading the datasheet of this part, I really guess it is it, because it just fits in this diagonal way.

I'm not so sure as it looks like pins 2 & 3 are connected together (enable & ground) on your photo but the enable is active high according to the data sheet

c0pperdragon, 2020-09-06:
It is impossible to see on the photo, but the enable pin is completely broken off and the GND is bent over to reach the pad. A truly ugly hack.
..

c0pperdragon, 2020-09-06:
Just for comparision, I probed the signals from the C64 board. This also uses LVC components and the MIC5504 regulator.
There everything looks pretty OK. At least on my scope. Maybe it is filtering out the highest frequencies and I can not see them...

Normal data pin with some ringing, but nothing to worry about:

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

Both edges of the clock pin with the 100 Ohm resistor completely removing the ringing (second picture is without single shot):
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

IanSB, 2020-09-06:
I'm going to order an MIC5504-3.3YM5-TR to try in the board first and if that doesn't help I'll build a second board with HC parts.

IanSB, 2020-09-12:
I tried the above regulator and it didn't make a great deal of difference. I also tried a second board with HC parts and that had the same problems. Finally I put a 1K trimmer in place of the 100R resistor and managed to get a reasonably clean image at about 680R but not totally stable.
Any ideas what to try next?

c0pperdragon, 2020-09-12:
First thing is to probe the clock signal now with the new regulator. I am specifically interested how the signal looks with LVC parts and only a 100 Ohm resistance.

With 680 Ohm, this is probably a bit slugish. The fact that it works a bit better, probably means that the other signals are in a different phase relation than on my machine.

Still I really want to see a screenshot when running with LVC, 100 Ohm. The picture should not have jittering edges, even if the pixel content fluctuates. Then at least the clock would be running OK.
To fix the pixel content I would have to modify the firmware to use different sample points for the data.
Another test would be to check sprites. Just use some game for that.
A third test woud be to see if register writes to the GTIA work reliably. This can be tested by running the COLORBAR.BAS program from https://github.com/c0pperdragon/A-VideoBoard/tree/master/atarimod/doc. This shows all 256 colors by permanently re-writing one of the color registers.

IanSB, 2020-09-12:
OK Here are some waveforms with the new regulator and 100R series resistor (Yellow is GTIA clock, Cyan is buffered clock at the FPGA board.

1. Repeated capture at full bandwidth
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
2. Single shot capture at full bandwidth
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
3. Repeated capture at 20Mhz limited bandwidth
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
4. Single shot capture at 20Mhz limited bandwidth
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

The waveform is quite asymmetric is that expected?

The chips on my board are dated from around the middle of 1984
The GTIA has the following numbers:
AMI 8443GZ
C014889-01
C04085

>Still I really want to see a screenshot when running with LVC, 100 Ohm. The picture should not have jittering edges, even if the pixel content fluctuates. Then at least the clock would be running OK.

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

The picture is jittering sideways by a couple of pixels and when cold it can't even get a vertical lock (see earlier captures)

It's difficult to do any further software tests at the moment as I'm just running the bare board on my bench with no keyboard.

I do have an SD card disk interface so can you point me to some disk images to try when things are a little more stable.

c0pperdragon, 2020-09-13:
OK, so the clock looks reasonably stable now to create a rectangular background. Jittering of the pixels (and garbage pixels) inside this background is very probably be caused by bad sampling point for the data inputs in relation to the clock. This will also cause  the vsync to fail, because this is normally triggered by a specific data pattern comming at the data inputs to the GTIA.
I will try to adjust the data sampling to be a bit later to correctyl catch it.

c0pperdragon, 2020-09-13:
I have shifted the sample point for the incomming bitmap data about 70ns back. So the signals from the ANTIC should be stable at this point.  I am not sure if this may cause other problems with the sprite DMA which may have become off by one clock instead. But one thing at a time.

This experimental firmware is on: https://github.com/c0pperdragon/A-VideoBoard/tree/master/atarimod/firmware

If the BASIC start screen looks good, you may try some more challenging stuff. My favourite thing for testing is the well known "Joyride" demo, which you can conveniently find at my other repo: https://github.com/c0pperdragon/SIO2SD/tree/master/ATARI
Part 1 of the demo runs quite far (up to the plot tunnel) without needing keyboard interaction.
For comparision see the video  https://www.youtube.com/watch?v=p69z3zytU6I

IanSB, 2020-09-13:
>I have shifted the sample point for the incomming bitmap data about 70ns back

That gives a stable locked picture at cold startup but after about 30 seconds warm up it starts to lose sync which is the opposite of what was happening with the previous version.
The rise time on the GTIA clock is really slow, is that the same on your Atari and are you using that edge for timing or the other one?

Cold startup:
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

After ~30 secs
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

IanSB, 2020-09-13:
As mentioned above, the LVC version is not stable enough to do any tests but the HC one is so I tried a few demos including the joyride one and they all have messed up graphics. Here is an example:
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

c0pperdragon, 2020-09-13:
From all this screenshots, I deduce that at least the clock is in fact running stable now.
By the way, I use the falling edge of the original clock to synchronize the rest of the logic to. As everything goes through inverters  (I need them to have schmitt-trigger inputs), this of course means rising edge of the signals that come to the FPGA.

I guess, the messed up graphics is really due to miss-aligned sprite DMA, which is now happening because I shifted the sample point right to the other side of the signal changing point.

Anyway I will try to change the sample point 70ns to the other direction. Maybe this gives stable bitmap data then on both the HC and the LVC versions.  If this is finally working, we can look to the get the sprites ok as well...

c0pperdragon, 2020-09-13:
Just uploaded a new version.

IanSB, 2020-09-14:
That seems to be a lot better, it works with both LVC and HC boards and the above demo is not messed up:

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

I'm back running the LVC board
I tried running the Reharden demo and compared with youtube and noticed that there are a couple of columns of wrong pixels on the right hand edge:

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

c0pperdragon, 2020-09-14:
This column of garbage at the right is actually also present on the composite video signal. All the captures on youtube just crop away this noise. I don't know what overscan area should generally be considered "important" to show - this may well depend on the actual grame/demo.

c0pperdragon, 2020-09-14:
I guess I should reduce the overscan area in the component video signal. I need to find a compromise between showing as much as possible, but leaving away such artefacts. I did the same for the C64 mod and nobody complained about missing overscan area.

c0pperdragon, 2020-09-14:
After checking the docs, I see that the Atari can actually produce a 48 column display (384 pixels) without any tricks. So this area at least I will not crop away. If this is not enough for the Reharden Artefact to become invisible, I can not help it.

c0pperdragon, 2020-09-14:
Hmm - maybe 360 pixels are in fact enough - this would match up with the DVD resolution (720 width) and is what we are doing now for the Amiga and it looks just right there.

c0pperdragon, 2020-09-14:
After doing some calculations, it turns out 360 pixels would take about 50.8us on a PAL machine, which is very close to what I am showing on the C64 (400 pixels).  This value is also pretty close to the PAL video timings itself which would specify 52us of visible screen area.
The current firmware only shows  344 pixels - probably some earlier tweak. I will extend this to 360, but need to make the horizontal shift more sensible. There is something weird going on in the way the first two columns in the basic screen are intentionally left blank (I have once heard to avoid the overscan area). Maybe I should center the remaining 38 columns into the middle of the visible area and adjust the sync accordingly. I will need to experiment with this a bit.

Anyway, this will surely not eliminate the artefact in the Reharden demo. But you can always crop this on the RGBtoHMDI.

IanSB, 2020-09-14:
>Anyway, this will surely not eliminate the artefact in the Reharden demo. But you can always crop this on the RGBtoHMDI.

As long as it's on the composite output as well then it's faithfully reproducing the output of the Atari so that's OK.

c0pperdragon, 2020-09-15:
I finally realized that the ANTIC actually tells the GTIA chip exactly which area or the scren are to be blanked. So I just also use this information now. The visual screen size is quite wide now, and many bugs in demos become quite apparent.  But this is faithful to the composite video output, so I keep this for 288p mode. Upscalers (including the RGBtoHDMI) can easily crop away the border garbage.
In the integrated 576p line doubler mode on the other hand, I am cropping the output because this mode is intended to be directly used on TVs without the ability to do more post-processing.  I have fine-tuned this to match the scroller of the "Reharden" demo, With 340 pixels width I can get rid of the garbage at the right as well make the left edge perfectly straight. This setting also is perfectly sufficient for all other demos I have tested.

c0pperdragon, 2020-09-15:
The change alos shifted the relative positions of the sync signal, and this seems to confuses the RGBtoHDMI, and the colors are all wrong now. I will fix this. Release 1_3 was a bit premature, it seems...

c0pperdragon, 2020-09-15:
Sorry, I just realized that with the new way to handle sync and image generation, it would be pretty awfull to change the behavior on my side. Maybe you can fix this in the RGBtoHMDI? The relative positions of the sync and the pixel data has changed by one pixel.
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

Thread 6 (2020-09-07):

Atari ST discussion

c0pperdragon, 2020-09-07:
@IanSB

I am creating a new thread specific for Atari ST discussions.

I don't have a (nor ever had) and ST myself, so my experience is pretty limited.
But I would guess that your auto-detecing solution could be the most general solution and allows
a no-hassle access to both games and professional (music?) applications.

Documentation for the video hardware is a bit hard to find, but if the Shifter is indeed a 40pin DIP, a similar solution to my Amiga board should be possible. No idea of the clearance of course and of possible case variants.

Guessing from some pictures it seems that there is an optional RF modulator next to the metal can in which the shifter sits. Removing this RF modulator (when actually installed) gives plenty of space to put the RPi just in the right spot to make the HDMI output accessible from the outside.
From an adapter board with the same height profile as for the C64 and Atari 8-bit (40-pin DIP socket with long solder tails), a short 40-pin ribbon cable could go the RPi, through a slit cut in the RF shielding.
When the Shifter has an additional 5mm clearance before reaching the metal shield, this should work.

IanSB, 2020-09-07:
Here are a couple of photos of the internals with the wire pickups for my tests:
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
I picked up the signals from the connected resistors rather than soldering directly to the shifter but the H and V sync had to be picked up from the modulator input as they are not available on the shifter.

IanSB, 2020-09-07:
I moved the screencaps here:
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

c0pperdragon, 2020-09-07:
When you have to collect the signals from different locations, you can't do it with a simple adapter board. Then you could just as wells solder wires to the pins exactly as you are doing now.

For the necessary level shifting your CPLD is already perfect and I guess your already have your complete solution here ;-)

In case you want to avoid overclocking the RPi, I have a proposal (don't know if it is indeed possible with the CPLD):
Always transfer the data for 4 pixels (36 bit) with 3 12-bit transfers (I think that is the width of the data bus from the CPLD to the RPi). This reduces the sampling rate on the RPi from  16 MHz to 12 MHz. You will have to do some bit-shifting to straighten everything out, but it may speed up things just enough.

I am not sure which clock you need to send to the CPLD so it can do all this, but 48Mhz is the lowest frequency from which both 12Mhz and 16Mhz can be derived. Maybe you need 96Mhz anyway for your sampling to work, so at least this calculcation would work out.

IanSB, 2020-09-07:
>Always transfer the data for 4 pixels (36 bit) with 3 12-bit transfers

I'd already considered something similar for 8 bit capture, sending three 8 bit samples in two 12 bit transfers. These options wouldn't fit in the current CPLD which is nearly 100% full so it would require a dedicated CPLD for such capture but that is no problem due to the in system programming.
The other option as you mentioned previously is a completely external solution using three A to D converters (which might even work with the Amiga using 4 bit A to Ds). This would also require a DAC to set the reference voltage for the converters so that the levels can be adjusted to sit between the computer output levels assuming everything was linear enough. Not sure if a standard TV chip could be used for that.

c0pperdragon, 2020-09-07:
The true power of the TV sampling chip I mentioned earlier was its ability to lock to the hsync and generate a pixel clock for a configurable pixel count. Your CPLD in conjunction with the RPi already can do exactly that.

With a 8-bit ADC you can later do quite arbitrary quantizations in a digital form. Maybe the CPLD could do that to generate the 8 levels for the Atari ST signals.

For an earlier attempt at an upscaler (with analog inputs), I used this 3-channel ADC: https://www.mouser.at/ProductDetail/238-WM8214SCDS-V
It is quite versatile and the digital signal path is multiplexed, so you only need 8 data lines. You can also easily clamp the signals to the black levels to avoid calibration effort. Maybe with a chip like this, you could design a new Analog Board that fits the 8-bit CPLD board but can produce 3x8 bits of data.

c0pperdragon, 2020-09-08:
As it turns out this 3-channel ADC is not fast enough for 16Mhz sampling when using all channels.

But I have another idea, stillt: It is actually possible to create an ADC circuit by cascading comparators. For a 3-bit ADC you need 3 comparators (and some resistors) on a low-impedance signal input. Given the current signal interfaces of your latest 6/8 - bit CPLD board, you could design an analog board that would decode 8 different levels on each channel and directly create a 3-bit output for each. This approach is in contrast to a "nomal" DAC that needs a clock input to trigger sampling. I am not sure about the speed of the comparators you are curently using, but maybe they are fast enough to be used at 16 MHz when being cascaded.

All the constraints already imposed by your existing CPLD board and the RPi seem to leave just enough possibilities to support an external Atari ST solution with a specially made analog board. To support both color and mono mode, you need an additional singal input besides the R,G,B,Sync your current analog board has. Keeping a 6-pin configuration, you could re-purpose the VCC pin because the Atari ST does not provide power on the video port, anyway.

Building a DIN-13 adapter cable should not be that difficult  (https://www.mouser.at/ProductDetail/CUI-Devices/SD-130?qs=%2Fha2pyFaduidFLkmXIRw9ksFAcwpAAyypzNKe8zYp94%3D). To keep access to the audio signal, you probably need to break it out to an analog phone jack.

c0pperdragon, 2020-09-08:
For the analog input stage, I would actually propose a THS7316 video amplifier. This can provide low-impedence signals and automatically adjusts the black levels to a very well defined base voltage. With preceeding trimmer pots on the analog signals you can prepare the levels so they will be correctly detected by the ADC stage.

c0pperdragon, 2020-09-08:
After some more thinking and browsing the interwebs on the topic of the Atari ST, it seems to me that the majority of people who have an affection for this machine and would welcome an upscaler of this sort, would not been able to do any serious soldering. A finished transcoder box is probably just what they need. This speaks for the external solution...

c0pperdragon, 2020-09-09:
For an enhanced version of the analog board, something like this ADC could be used: It is reasonably cheap and can sample at 20MHz:

https://www.mouser.at/ProductDetail/Texas-Instruments/ADC1175CIMTCX-NOPB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

c0pperdragon, 2021-01-12:
There are requests to pull off the same stunt as for the Amiga now for the Atari ST.
Using only the bare minimum of additional circuitry to bring the necessary pixel data to the Pi.

I guess it could be done fairly easily as long as the screen mode is limited to color only. This may already work with the current RGBtoHDMI software without modification.  The circuitry needs to generate basically the exact same signals as the Amiga adapter, but with an 8 MHz pixel clock. As far as I know this can be achieved by overclocking the Pi.

c0pperdragon, 2021-01-12:
If I am not mistaken, the default display mode (when no cable is connected to the A/V port) is already color. So such a straight-forward solution will produce HDMI output in color mode.
When you connect a monochrome monito to the A/V port, the HDMI output will probably not work any longer or at least not correctly.

c0pperdragon, 2021-01-12:
By the way: I have designed a simpler Amiga adapter board that can be put on the Pi Zero and has individual wire points to receive RGB, CSYNC and pixel clock:  https://github.com/hoglet67/RGBtoHDMI/tree/master/kicad_AmigaAdapter/Small
I guess this could already work with the Atari ST without modification.

bwmott, 2021-01-24:
I've built one of c0pperdragon's simple Amiga adapter boards original developed for the Amiga 600 and wired it up to an Atari Mega ST:

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

I've connected SYNC to the ST's CSYNC at resistor R116 right before it goes to the monitor port and I've connected CLK to the 8MHz pin on the expansion bus. I'm getting a display (using Beta14); however, there's some significant corruption:

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

I'm new to using RGBtoHDMI (except for some basic testing on an Amiga 2000 before trying it on the ST), so there are likely settings that I need to adjust. I also need to see if the ST's CSYNC signal is what the adapter board is expecting. I'll post a follow up, if I make any progress. If you have suggestions for things to try, please let me know.

c0pperdragon, 2021-01-24:
There are multiple things you can try:
1.
For the 8 MHz clock you probably need to overclock the Pi a bit in order to keep up. You can do that with the on-screen menu (probably need a recent firmware beta version from https://github.com/IanSB/RGBtoHDMI/releases/)
or by directly modifying the content of the SDcard.
2.
Another problem are possibly the long wires, as they can pick up all kind of noise and cause delays and signal distortion on their own. Especially the clock signal is always very sensitive.
3.
Third thing is the relationship of the clock edges with the signal edges of the color lines. To judge this, you really would need to do some more measurements with an oscilloscope.

IanSB, 2021-01-24:
@bwmott

There is an Atari St profile already in the Beta14 software for the CPLD version.

Go to \Profiles\6-12_BIT_RGB\Atari_ST
on the SD card and copy the "Atari_ST.txt" to this folder: \Profiles\Simple
(There is also a mono profile but that will only work with the CPLD version)

Reboot the Pi then select the Atari ST profile from the Profiles line on the main menu.
This will set up everything for the Atari ST including some overclocking of the Pi
You may also need to go into the Sampling menu and change the Sync Edge setting to eliminate any glitches.

IanSB, 2021-01-24:
@bwmott

I just remembered that Atari profile is set up for separate H & V syncs and it looks like you are picking up composite sync for c0pperdragon's board so after selecting the profile you will have to go into the Geometry menu and change the Sync setting from H&V to "Composite" for standard negative going composite sync or "Inverted" for positive going composite sync.

Use the Save config option once you have made all the changes you require.

bwmott, 2021-01-24:
Thanks for the suggestions. I copied the Atari ST profile as suggested; however, it looks like it is designed for PAL so I made a few adjustments to work better on my NTSC system. Now, I get a stable display in low resolution sometimes:

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

However, it isn't consistent and sometimes the display will be corrupt:

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

It looks like this is an issue with the Atari ST, since power cycling the PI doesn't change things, but cycling the ST eventually results in a stable image. Maybe this has something to do with the timing between the CPU and Shifter (e.g., wakeup states https://www.atari-forum.com/viewtopic.php?f=68&t=9056). I'll try looking at things with my oscilloscope to see if I can spot any differences later this week.

I've had no luck getting a stable image when using the ST's medium resolution (640x200). I've also tried using shorter wires as suggested, which didn't appear to change things. To rule out any issues with the motherboard's CSYNC, I tried combining the HSYNC and VSYNC signals using an XNOR gate; however, that didn't change things either.

IanSB, 2021-01-24:
@bwmott
>Maybe this has something to do with the timing between the CPU and Shifter (e.g., wakeup states

Yes I had noticed something like that with my STFM and the CPLD version where the phase relationship between the sync pulse and the pixel clock would vary by 180 degrees at different times. Fortunately it is easy to vary the sampling phase on the CPLD version from the menus and I found that using a 90 degree sampling phase seemed to work under all conditions although changing that is not easy with c0pperdragon's discrete design.

However your photos are  showing a greater amount of jitter than just the one pixel's worth I would expect from that. It might be worth increasing the overclocking values in the settings menu: Set Core to 160  and maybe CPU to 60 to see if that helps.
If you get just 1 pixel of jitter after that then the above is the likely explanation.

You can go higher still but depending on your Pi it might start to freeze so you might need a heatsink on it.

I haven't really done any further investigation with the ST beyond my initial proof of concept above but I have recently designed a plug in buffered shifter pickup for the extenal CPLD board so I will be doing some more testing when that arrives:

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

Can you post your modified Atari ST profile (Will be in /Saved Profiles on the SD card)
Also can you post a photo of the source summary page in the info menu when in both 'good' and 'bad' modes.

c0pperdragon, 2021-01-25:
Yes, my adapter relies on a clock signal that has its edges somewhere between the points where the color signals change.  In the Amiga this was fairly easy as this provides a 7.x MHz CPU clock and a second signal that is phase shifted by 90 degrees.
I have no Atari ST, so I can do no measurements and it is hard to guess how you can most conveniently create such a suitable clock signal from the things actually present in the machine.

IanSB, 2021-01-26:
@bwmott

I just released an updated beta16 which has more efficient capture code so can you try that to see if it helps:
https://github.com/IanSB/RGBtoHDMI/releases

Copy your custom Atari profile into the appropriate folder after updating the SD card.

bwmott, 2021-01-26:
Thanks for the suggestions. I gave beta16  a try; however, I'm getting similar results. Low resolution sometimes works but medium resolution never appears to work. When low resolution does work, it continues to work after power cycling the Pi or soft reseting the ST. Here's the slightly modified profile I'm using for my 60Hz Atari ST:

sampling=0,0,0,0,0,0,0,0,1,0,5,0,0,0,2,0,0,3,0,0,100,256,100,256,100,256,0,256
geometry=176,31,640,202,720,270,1,2,0,2,16000000,1024,7500,262,4,0,0
palette=RrGgBb_(EGA)
scanline_level=0
vsync_indicator=1
overclock_core=100

The main changes I made were the 31 offset and 262 lines per frame. I've noticed if the RGBtoHDMI auto profile select feature is enabled (sub-profiles) then the Pi flickers ever second or so. Given this I suspect some additional changes are needed to the profile for 60Hz mode on the Atari ST.  Here's the Source Summary for when the screen looks correct in low resolution and when it is corrupt in low resolution:

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

Except for the small difference in the clock error, everything else looks the same.

IanSB, 2021-01-26:
@bwmott
>The main changes I made were the 31 offset and 262 lines per frame. I've noticed if the RGBtoHDMI auto profile select feature is enabled (sub-profiles) then the Pi flickers ever second or so. Given this I suspect some additional changes are needed to the profile for 60Hz mode on the Atari ST

Yes you need to set number of lines to 263 as that is what is being detected on the above screen
Also you need to adjust the line length to get the PPM error close to 0. That will likely be around 1016 (both in geometry)
After those two changes your NTSC profile should be detected automatically
Also change the pixel aspect to 2 : 5 for better NTSC Aspect ratio

It does look like the pixel clock phase is randomly different by 180 degrees which is something I noticed on my STFM
Have you tried adjusting the sync edge setting in the sampling menu?

c0pperdragon, 2021-01-26:
As far as I have understood parts of the schematic, the Atari uses a 32Mhz clock as base to derive all other clocks from, including the CPU clock as well as the clocks for the Shifter. It now looks very much like the 8Mhz CPU clock comes up in some random phase relationship to the clock used by the Shifter.
In a bad case, this causes the color signals to change at pretty much the same point when the CPU clock also changes. This causes the flip-flops on the adapter to fetch inconsistent data and there is nothing that can be done about this on the side of the Raspberry Pi.

You could solve the problem by adding a delay of about 30ns to the clock signal before feeding it into the adapter.  You could use a simple 74HC04 inverter IC and feed the signal through an even number of gates. With an oscilloscope it should be fairly easy to get close to 30ns (20ns - 40ns should be good enough). Without an oscilloscope, just start with 4 gates which is probably somewhere in the correct range.

bwmott, 2021-01-27:
Thanks for the suggestions to improve the video output. I've adjusted the profile as recommended:

sampling=0,0,0,0,0,0,0,0,1,0,5,0,0,0,2,0,0,3,0,0,100,256,100,256,100,256,0,256
geometry=176,31,640,202,720,270,2,5,0,2,16000000,1015,7500,263,4,0,0
palette=RrGgBb_(EGA)
scanline_level=0
vsync_indicator=1
overclock_core=100

It looks like 1015 provides the smallest PPM error. The low resolution output is looking great in the "good" case:

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

However, after power cycling I'm still getting corruption in the display at times. It does seem like this is due to the random phase relationship. I wonder if this might also result in CSYNC being sampled at the wrong time. I didn't have a 74HC04 handy, so I connected a 74LS86 up with each output (O1, O2, O3, O4) feeding into the next XOR gate (acting as not gates). The 8MHz CPU clock was the input to the first gate. In the "good" case, I could use the CPU CLK, O1, O3, or O4 as inputs to the Pi and have a stable display. in the "bad" case only 02 could be used to get a stable display. I'll experiment with additional delays to see what else I find.

IanSB, 2021-01-30:
@bwmott

If you don't have any luck getting the simple board working would you like to try the CPLD version?
If so I could send you a set of blank pcbs for the cost of postage as I'd be interested to see if it worked on the Mega ST.
I've got my new Shifter pickup board working so the external version is almost completely plug in, only Vsync and Hsync have to be picked up with wires as they aren't on the shifter. Here's the new board:
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

(I've also designed a similar pickup board for the Amiga)

Here's some output:
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
The CPLD version also supports hires mono mode which the simple board can't:
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

This is with NTSC aspect ratio conversion enabled:
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
You could actually mount the Pi internally but externally it can also be used on other computers like PCs, Amiga (with above adapter board) etc.

BTW could you recommend any good graphics games or demos. Also any test software that outputs RGB test patterns etc which would make it easier to check that all bits are connected properly

c0pperdragon, 2021-01-30:
@bwmott

I am not sure if I made myself clear. It is the clock line from the Atari to the small adapter board that needs the delay. From the adapter to the Pi no adjustments are needed. But maybe you already did that and I just got confused by your description.

bwmott, 2021-02-02:
IanSB, I’d love to give the CPLD version a try. Getting blanks pcbs would be great or if the gerber files are available, I can get some made. As far as software to try on the Atari ST, one thing to explore is how demos that produce overscan on the Atari ST work with RGBtoHDMI. These demos achieve increased screen resolution by switching resolutions at certain times during the frame to bypass normal operations. The first link below lists demos that used these techniques and the second link has a collection of Atari ST demos that might be useful:

https://aldabase.com/atari-st-fullscreen-demos-history/
http://www.atarimania.com/top-atari-demo-atari-st-_D_S_D.html

Another thing to try out would be Spectrum 512, which allowed displaying images with more than 16 colors per scanline on the Atari ST:

https://doudoroff.com/atari/spectrum.html

c0pperdragon, my description wasn’t clear, sorry about that. I connected the delay between the clock from the Atari ST to the small adapter board (not directly to the Pi). I have some 74HC04s on hand now, so I”m going to give that a try as well as see if I can figure out which signals are different between getting a stable and unstable screen using an oscilloscope. Unfortunately, work is crazy busy right now, so it might be a week or so before I dig into it some more.

IanSB, 2021-02-03:
@bwmott
>IanSB, I’d love to give the CPLD version a try. Getting blanks pcbs would be great or if the gerber files are available

You will need at least the issue 4 12 bit main CPLD board (gerber link on page):
https://github.com/hoglet67/RGBtoHDMI/wiki/Bill-of-Materials-%2812-Bit-Board%29

As a minimal solution for initial experimentation you could connect that directly to the shifter as you have done with c0pperdragons board as it has all 12 RGB bits, H & V sync, +5v and ground available on the pads for the P2 and P5 connectors (Clock signal not required as the CPLD regenerates it)

However to make a nearly completely plug in version as shown in my photos above you will need two additional PCBs:
First is the 12 bit extender board (gerber link on page):
https://github.com/hoglet67/RGBtoHDMI/wiki/Bill-of-Materials-%2812-Bit-Extender%29
This plugs into the CPLD board underneath and brings all the above signals from P2 and P5 on to a single 16 way connector which is outside the recommended case so you can easily swap cables for different sources.
(The 16 way connector wouldn't fit on the CPLD board so the signals had to be split)

Finally you need a shifter pickup board which fits between the shifter IC and socket to pick up the 12 bits of RGB data and power. Unfortunately H and V sync aren't present on the shifiter so you have to pick them up on separate wires which feed back into the board so they can be added to the 16 way header.

There are two implementations of that (gerbers in zips):
An unbuffered board:
https://github.com/IanSB/RGBtoHDMI/blob/dev/Kicad_Atari_ST_12Bit_UnBuffered_Pickup/V1/
A buffered board with two TSSOP buffer ICs
https://github.com/IanSB/RGBtoHDMI/blob/dev/Kicad_Atari_ST_12Bit_Buffered_Pickup/V1/

The buffered board is preferable if you are going to use a long cable but does require soldering two TSSOP 74HC245 packages
Note both of these boards should be 0.8mm or 1.0mm thick rather than the standard 1.6mm because they use turned pin sockets that are mounted through the board so they need to be as thin as possible to allow the pins of the socket to plug into the Atari board. (If the pins are too short for the Atari socket, plug the pins into a second turned pin socket underneath)

I don't know how quickly you can get boards made but I'm in the UK so postage will take some time if you want me to send them. Let me know which way you want to do this.

bwmott, 2021-02-03:
@IanSB Thanks for all the links and details. I've placed an order for all 3 PCBs (buffered pickup board), so now I just need to get the components ordered. Looking forward to getting it built!

IanSB, 2021-02-04:
@bwmott

There isn't a BOM for the Atari pickup board yet as I haven't documented it but it's as follows:
U1 - 40 way Turned Pin socket (Note the PCB holes are larger than normal and this is fitted through the board)
U2 - 74HC245 TSSOP
U3 - 74HC245 TSSOP

C1 & C2 100nF 0603

J1 - 2 pin right angle 0.1" pitch pin header Pin 1 = Hsync in, Pin 2 = Vsync in from suitable pickup points
You will need a matching cable connector or just solder the two wires directly to the board
J2 - 16 pin (2x8) 0.1" pitch right angle pin header

You will also need some 16 way ribbon cable and two 16 way IDC connectors

As mentioned, a second 40 way turned pin socket might be needed to sit between the above board and the Atari as the pins through the board might not be long enough for a secure connection to the shifter socket.

I also used a switch connected to the mono sense input on the Atari video connector to select bootup in mono or colour mode

bwmott, 2021-02-07:
@IanSB Thanks for the list of parts for the Atari pickup! I've ordered all of the components and they should arrive in the next week or so.

stevenptimms, 2021-02-14:
Hi @IanSB is there any chance you'd let me test out your cpld board? If you have some pcb spare. I have a range of Ataris I'd like to test it with. I still don't have the PiRGB yet, but I am in a waiting list from over on stardot. I'm in the UK. Cheers.

bfollowell, 2021-02-16:
Seeing that this supports all three native ST resolutions, I am very interested in this project. I'm curious about two things.

My first question concerns high resolution. I know on the original ST, there was a pin that had to be grounded I believe in order to initiate booting into high resolution. How is this done with this mod/board?

My second question concerns sound. Is sound somehow passed to the RPi so that it can be encoded into the HDMI stream, so that audio and video can both be handled by one HDMI cable and not having to mess with external speakers etc.?

Thanks.

IanSB, 2021-02-16:
@stevenptimms
>is there any chance you'd let me test out your cpld board

Yes, I do have a few pcbs so could add one to your PiRGB order. I will be sending out some boards soon.

IanSB, 2021-02-16:
@bfollowell

>booting into high resolution. How is this done with this mod/board?

You fit a switch to the AV connector to ground the mono detect pin to select bootup in mono mode.

>Is sound somehow passed to the RPi so that it can be encoded into the HDMI stream

No sound isn't supported at the moment and it may be very difficult to add as there aren't enough spare GPIOs or CPU time to process the sound signal.
HDMI monitors/TVs that have built in speakers usually have a 3.5mm analog audio jack that can be used to override the HDMI audio input so this isn't usually a problem and you pick up the audio from the normal AV connector. If you really need audio on the HDMI signal for use with a HDMI switcher etc. then that can be added using a HDMI audio embedder / inserter.

stevenptimms, 2021-02-16:
@IanSB Cheers Ian :) I'll watch out for a pm on stardot

bfollowell, 2021-02-16:
Yeah, I don't see extra audio inputs on HDMI sources, at least in the U.S.
I have 7 TVs, all from Samsung and LG, all made within the past ten years,
and not a single one of them has an extra audio input on an HDMI source. I
really wish they did.

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

Thread 7 (2020-09-17):

Support for other systems

IanSB, 2020-09-17:
It might be possible to implement support for other relatively simple systems, maybe with a buffer board and just Pi software or possibly using the 14 bits available on CPLD with the new 12 bit board in a similar way to the proposed direct 48K Spectrum connection.

A few machines that this might work with:
Atari 2600
VIC 20
Commodore 16 / +4 (TED chip)

c0pperdragon, 2020-09-17:
I did a quick research on the matter, and the machines you mentioned all use a graphics chip that directly generates the usual set of television signals (luma and chroma) that are basically impossible to convert back to a pixel-perfect digital representation (I tried with the Atari800XL and the C64 and failed spectacularly).

So the only option is of course to use the digital inputs. In the case of the ZX Spectrum there are not so many relevant signals and it is pretty straight-forward how to map this to the video image. For the aforementioned 3 machines this is not so easy. All of those have a rich set of internal registers which influence the video output in many weird and wonderful ways. I guess none of those is as complicated as the VIC-II, but still it requires some substantial computation if done entirely in software and at a tight time-budget.
More complicated is the fact that these chips have many data and address inputs as well, so 12 (or 14) signals lines are never enough to capture all that is relevant.

Maybe the Atari 2600 could be done by using the technique of an existing RGB mod: Intercept the writes to the color registers and replace them with spoofed colors. After that whenever the TIA writes the 3-bit lum value of one of the registers to the digial lum lines, you can know exactly which register the value came from and you know with which "real" color to replace it.
This of course disturbs the analog signal generation. You also need some fast CPLD that is able to drive the TIAs input lines.
This is the original RGB mod: http://etim.net.au/2600rgb/

IanSB, 2020-09-17:
> All of those have a rich set of internal registers which influence the video output in many weird and wonderful ways

I guess the only way for those to work then would be a similar FPGA solution like the C64 / 800XL although at least the VHDL would be a bit simpler.

> Maybe the Atari 2600 could be done by using the technique of an existing RGB mod: Intercept the writes to the color registers

That could be an interesting solution as it might be just a relatively simple board with a CPLD that plugs into the TIA socket with a Pi plugged into that. Not sure about clearances though

c0pperdragon, 2020-09-18:
For an overall solution to mod the Atari 2600 for HDMI, you really need to include audio as well into the HDMI output. The TIA produces only a digital beeping. This could fairly easily be sampled by the same CPLD and transfered to the Pi. No idea what software-wizardry is then needed to get usable sound to HDMI.

IanSB, 2020-09-18:
>For an overall solution to mod the Atari 2600 for HDMI, you really need to include audio as well into the HDMI output

I've not really looked into the audio side of things, I guess the same thing applies to the C64, Amiga and Atari computers as well.

Most of the original computers supported by the scaler had built in speakers so no requirement for audio and in my case I tend to use it with old 1600x1200 4:3 monitors with DVI input and an analog soundbar so again no benefit from HDMI audio.

You can DMA ingest PCM audio through GPIO's 18-21 using one of the Pi's built in peripherals but those GPIO pins are being used for something else at the moment so it would require a complete redesign and a larger form factor to add the audio chips.

Most HDMI monitors have a PC mode where you can connect analog audio but the other workaround would be to use a HDMI audio inserter although they seem to be expensive compared to audio extractors.

c0pperdragon, 2020-09-19:
In my personal setup I currently also have analog audio only. For external converter solutions this may still be the best option, otherwise you would have an additional conversion step from analog to digital and back again.
For internal solutions where you can directly tap into a digital data stream this is a different matter.
While the analog sound synthesis of the C64 and probably the Atari ST cN not be digitally captured, the Atari 2600, Atari 800 (?) and, most important of all, the Amiga have digital output from the sound chips.
Full-blown 100% digital HDMI from the Amiga would be even more awesome than what we already have. I also think off ease of video capturing here.

c0pperdragon, 2020-09-19:
No, I was mistaken. The Paula chip in the Amiga already has the DAC stage built in. So no digital audio stream there.
Same thing is probably true for the Atari 800 (guessing from the schematics - did not probe the pins of the POKEY yet).

So the only machines from where the audio can actually be taken in a pure digital form are the ZX Spectrum and the Atari 2600.
Both have a sound quality so bad that many games do not even bother to play any.

Coincidentially I have recently modded a 2600 to composite video + audio and just added a simple low-pass filter stage to the audio. This now sounds not half as bad as before.  Still no winner...

culexus8, 2021-01-01:
Anyone know if this might work on consoles like Nes, snes, Sega?

c0pperdragon, 2021-01-01:
This specific solution (a Pi Zero with only a small bit of extra electronics) is only possible if the computer already provides the pixel data in digital form on some accessable leads. This is true for the Amiga and the Atari ST.
But in your mentioned consoles the analog video signal is generated inside the graphics chips and it is normally impossible to convert this back to a glitch-free digital signal.
There are quite some projects to do something about that but they are much more complex.

bandaidboi, 2021-01-11:
@c0pperdragon Regarding the use of the PiZero with your schematics for the Amiga Adapter, would your design be easily adaptable to the Atari ST/STE? i.e. all 12 color bits from the GSTSHIFTER, csync from else where on the board and the use of the 8mhz system clock?

c0pperdragon, 2021-01-12:
I just re-opened the according thread:  https://github.com/c0pperdragon/Amiga-Digital-Video/issues/6
There was substantial work done already by @IanSB for this machine.  I will try to give a summary of my thoughts in this thread.

Closed 2021-02-28.

Thread 8 (2020-09-17):

Amiga Support 3

c0pperdragon, 2020-09-17:
Continuation of https://github.com/c0pperdragon/Amiga-Digital-Video/issues/4

After collecting more data and the reports from @andriodious, everything started to make less and less sense.
So I started to doubt my assumption about the meaning of the +ve and -ve options in the sample menu. I always thought that +ve would mean the rising edge of the pixel clock and -ve is the falling edge. As it turns out, this it is just the other way round. So I managed to provoke image jitter with one option I previously considered  safe:  Trailing -ve
So everything I said in the previous post is exactly the same, but with "+ve" and "-ve" reversed.

Considering the matter, using +ve (which is in fact the "safe" option) should cause Denise and SuperDenise to have the same pixel alignment. This is my profile which fits perfectly on my 1280x1024 screen:
[Amiga_LeadingEdge_+ve.txt](https://github.com/c0pperdragon/Amiga-Digital-Video/files/5239761/Amiga_LeadingEdge_%2Bve.txt)

Could you give this profile a try when you continue with your Amiga 500+ ?

andriodious, 2020-09-17:
@c0pperdragon

Before I saw the above post I had a chance to run my A500+ this evening and the resulting pixel perfect profile was a default build i.e. "Leading with -ve PixClk" edge sampling, but with a delay of 2 instead of 3 with the A500.

[Amiga_ECS_Denise.txt](https://github.com/c0pperdragon/Amiga-Digital-Video/files/5241359/Amiga_ECS_Denise.txt)

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

I tried the Amiga_LeadingEdge_+ve.txt and had to adjust the delay to 3 which is hopefully consistent with what was expected between the A500 with a delay of 3 but using the Leading -ve edge.

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

c0pperdragon, 2020-09-17:
I am trying to find one setting that works both with the Denise as well as the SuperDenise. If my other considerations are correct, it can only be one of the +ve variants.
As Leading Edge does not work for this (SuperDenise needs delay 3, Denise needs delay 2). maybe Trailing Edge is different. It is a bit hard to reason through this complex signal timing. Please try "Trailing +ve". Also tell me which horizontal offset you need to set for this (if it is different from my profile).

c0pperdragon, 2020-09-17:
I am still struggling to understand the sync timings on your machine. An oscilloscope view of csync in respect to CDAC would really be helpful. Maybe your ECS Agnus is really different in some unexpected way...

andriodious, 2020-09-17:
Sure I can scope these out but will be tomorrow night at the earliest. Will post a waveform.

IanSB, 2020-09-17:
If you switch to trailing edge, you will need to adjust H Offset in the geometry menu to compensate for the picture shift.

IanSB, 2020-09-18:
>I always thought that +ve would mean the rising edge of the pixel clock and -ve is the falling edge.

That is what it is supposed to be and I couldn't see anything obviously wrong in the code. However, as the timings for this are so marginal, the response to the edge might be delayed enough that it appears to be responding to the other edge.

c0pperdragon, 2020-09-18:
Maybe I am still making the wrong assumptions here. Let me explain how I envisioned the Pi software to work:
A tight loop reads the GPIO (all pins at once) and as soon as it detects that the pixel clock input has a different value than at the previous read it also uses the other bits as data. I am pretty sure this is how the color data input is working.

For the sync detection I assumed the same thing: Read until the clock changes to positive (the +ve option) or to negative (the -ve option) and then use the (already received) sync signal to determine what to do next.
If this assumption were correct, the "-ve" option would be safe to avoid jitter. And also the SuperDenise adapter board should work with the same settings as the board for the Denise.

As these results are now obviously not true, something else must be going on. Maybe you are doing it this way instead:
Poll the GPIO pins until the first time the sync is low (assuming the "Leading" option here) as well as the pixel clock is high (assuming the +ve option). This is then the synchronization point.

The difference between the two methods is quite subtle, but the second can lead to glitches because the pixel clock input changes just a bit later (a few nanoseconds) than the sync input. This delay is by design to make the color inputs always stable when the sampling takes place.  The second method could well do the sampling just in the small time slot where sync has changed, but the clock not yet. This could lead to jittery sync in certain combinations (specifically "Trailing -ve" on a standard Denise board).
This jitter would be on top of any jitter that could additionally be introduced by the adapter board latching  the sync signal at a "dangerous" point. As it now looks (assuming your are indeed using the second method here), this was never an actual problem and I was chasing the wrong issue, while this theoretical issue can very well become visibile on some other matchines.

The takeaway of all this is, that when you indeed use the second method I can not find a really "safe" sampling configuration any more, as I am now constrained in too many ways.

IanSB, 2020-09-18:
>For the sync detection I assumed the same thing: Read until the clock changes to positive (the +ve option) or to negative (the -ve option) and then use the (already received) sync signal to determine what to do next.

Yes, that's correct for simple mode with no CPLD however, reads of the GPIOs are relatively slow so there may be only one or two reads per half cycle so the actual sampling point when it detects the edge change could be sometime after the edge has actually changed.

>Poll the GPIO pins until the first time the sync is low (assuming the "Leading" option here) as well as the pixel clock is high (assuming the +ve option). This is then the synchronization point.

This is more or less how the normal CPLD reads work because the sync pulse and regenerated clock are not phase locked but the CPLD stalls the clock for a few cycles after the sync edge so there are no glitches. I tried this first with simple mode but it always had glitches so has to switch to the first method instead.

>As these results are now obviously not true, something else must be going on.

As mentioned above, due to the slow GPIO reads, if only one read is made per half cycle, worst case it could be detecting the +ve edge change immediately before the clock goes low again.

It won't work at all with a 16 Mhz pixel clock (8 Mhz psync) unless you overclock the core which speeds up GPIO reads. You can change the core clock in the settings menu.

IanSB, 2020-09-18:
Looking at the code again, the edge detection may be the wrong way round. It enters the loop with the correct edge state set in a flag but it gets inverted before doing the comparison.

c0pperdragon, 2020-09-18:
Actually the buffer board latches the color signals as well as the csync signal, so your read loop should only run into troubles when taking more than 70ns twice in a row. Still, all that is very hard to reason about in conversation.
Maybe you can point me to the actual program code responsible for doing this?

IanSB, 2020-09-18:
The capture code is here:
https://github.com/hoglet67/RGBtoHDMI/blob/dev/src/capture_line_fast_simple_16bpp.S
Most of the macros are here:
https://github.com/hoglet67/RGBtoHDMI/blob/dev/src/macros.S

The mistake was setting PSYNC bit in R3 to the required edge when it should be the inverted state as there are two uses of WAIT_FOR_PSYNC_EDGE_FAST, the first waits for the wrong edge and the second waits for the right edge.

I have fixed this on my system but not committed the code yet. The fix effectively only changes the text so that the same profile will work on the older code and newer code without requiring any changes although the text will only be correct on the newer code.

c0pperdragon, 2020-09-18:
Very good that you solved this strange mystery.
I had a quick look at the code to understand this better and I it is basically as I imagined.
So with the current software +ve is the "safe" point, which will turn into "-ve" with the next software version.
One thing about the implementation: You need to do quite some bit reshuffling to get the 12 input bits into the correct positions. Maybe for an internal Atari ST variant, you could feed the relevant bits directly to the most suitable GPIO pins to save some instructions. Don't know if this could be just enough to match the time budget without overclocking.

c0pperdragon, 2020-09-18:
@andriodious
With the +ve / -ve confusion finally cleared up, I think I also understand the differences between Denise and SuperDenise a bit better. As it looks, the SuperDenise generates the color signals about 35 ns earlier. With the other clock input (I will build a board with a jumper to select the type) the sync signal and the color clocks are then out of phase by one pixel.
This normally makes no real difference, except for 1280x1024 resolution. There manual adjustment of the delay value is needed.

andriodious, 2020-09-18:
Okay cool, thanks both. I assume you don't still need me to disassemble my A500+ and scope out the SYNC and CDAC. If you do please let me know as I need to find some time now over the weekend to do that.

c0pperdragon, 2020-09-18:
Actually I would still like to collect data on the behavor of Agnus variants. I have a 8372A, so there is no need to test this. If you happen to have different versions, it would be very useful to gather data for these.

andriodious, 2020-09-18:
I have 8375R0 as well as the 8372S

c0pperdragon, 2020-09-19:
Measurements of the 8375 would be very appreciated  If you could scope the relation of both the falling and the rising edge of CSYNC to the CDAC clock.
I then would only need measurements of the 8371 to get a fairly complete picture of the PAL variants

andriodious, 2020-09-19:
Sure, might be a couple of days as I am travelling ATM

c0pperdragon, 2020-09-19:
It is really not urgent. It would just be nice to have confirmation that my assumptions are correct in this regard.

@IanSB - I can see on the picture of your Amiga that you actually have an 8371 Agnus chip!  Would you mind, to also scope the signals, I am interested in? This would then give a pretty complete picture (for PAL variants at least).

IanSB, 2020-09-19:
>@IanSB - I can see on the picture of your Amiga that you actually have an 8371 Agnus chip! Would you mind, to also scope the signals, I am interested in? This would then give a pretty complete picture (for PAL variants at least).

OK

Do you know anyone with an NTSC Amiga who might be interested in testing this board in 60Hz modes as the profiles will need changing for 525 line sources?

Same with the other systems, do you know anyone that has built your YUV mod for 525 versions of  C64 or Atari that might be interested in testing it with RGBtoHDMI?

FYI the software can auto select profiles if they have different frequency sources. You create a folder in the appropriate profiles sub-folder and put all the profiles you want to auto switch in that sub-folder and the software will pick the one that matches in incoming frequency and sync polarity. This was primarily used for IBM PC mode switching but could also be applied to 50/60 Hz versions of other computers like the C64.

If I can get the auto display mode selection working, this would mean the entire solution would be then be fully auto detecting.

c0pperdragon, 2020-09-19:
Unluckily I have no contact with anyone with an NTSC Amiga.

About the C64, there are the creators of the BeamRacer  (https://beamracer.net/)  - @madhackerslab, who basically have all conceivable variants of the C64 and also installed and properly tested my mod board. Maybe they would also be interested to attach the RGBtoHDMI as an add-on.

Autodetecting the monitor resolution and using it in 50Hz would be so cool.
Input frequency detection is also a good thing for a plug-and-play solution, but actually less important because this would not change after an install. It is fairly easy to provide two different software versions.
My main intention here is of course to have a solution that does no longer require to adjust any settings. So no need to install the button in addition to the HDMI connector and no need to give the users too much possibility to mess up.

One small annoyance is still this one-pixel offset of the SuperDenise. There is absolutely no way the Pi could auto-detect this based on the signals alone. As I need to change the adapter board anyway I could set some configuration pins, but I doubt you still have any free pins. So yet another software setting - this already gives 4 different combinations.

IanSB, 2020-09-19:
>As I need to change the adapter board anyway I could set some configuration pins, but I doubt you still have any free pins.

It might be possible as there are several unused GPIOs in simple mode.

laubzega, 2020-09-20:
Re: Amiga NTSC - as long as you have ECS, you can switch frequencies in software:

move.w #0,$dff1dc ;NTSC mode
move.w #$20,$dff1dc ;PAL mode

I remember using it back in the day to give games that 60Hz arcade look. :)

I will gladly test RGBtoHDMI with C64 VideoMod, if you can send the board to me - I am too overloaded to build it myself right now. I can provide my own Pi, though.

c0pperdragon, 2020-09-20:
I happen to have an Amiga 500, Rev.6 which already has the Agnus 8372A.  Does that mean, I can already switch to 60Hz mode with this software switch?
I haven't done any programming on the Amiga since 1995 or so. Will get an assembler first...

c0pperdragon, 2020-09-20:
I have come up with a solution for an adapter board that can be configured with a single jumper. In one mode it works like the current board (for use with a Denise). In the second mode (for use with SuperDenise) it will not use the _CDAC (normal board) or the CPU clock (andriodius' modded board), but the inverted CPU clock instead.
From the perspecitive of the Pi, the pixel clock is then in the same phase relation to the color signals as usual. And when using the right configuraiton for the csync sampling, the trigger also happens at the same relative position.
When the other Agnus variants are not too different (we will know when we have the data for this), the software can work identically with both configurations.

c0pperdragon, 2020-09-21:
I found out that by shorting pin 41 of my Agnus during reset I can start up with 60Hz mode. The Pi can handle this quite well already,- after re-adjusting all the geometry of course.
There is one strange thing, though: The outmost pixel of the right overscan area actually alternates between blue and black. Need to investigate how the Agnus generates the csync in thos situation.

IanSB, 2020-09-21:
Does an NTSC Amiga have a different pixel clock / different number of clock cycles per line as those will need to be set in a proper NTSC profile as well but your pin 41 tweak should allow the H & V offsets in geometry to be determined.

c0pperdragon, 2020-09-21:
By dividing the offiical NTSC line frequency by the quart frequency used in NTSC machines, it actually should have 455 clocks per line in contrast to the 454 clocks of PAL machines.
The strange jagged look of the rightmost color column (low-res) is not some bug of your Pi software, but is actually present on the color signals, as my scope showed.
By reducing the visible range to 712 pixels, this is hidden anyway.

You mentioned something about having two configurations from which the Pi automatically takes the correct one depending on input frequency. How can I set this up exactly?

IanSB, 2020-09-21:
>it actually should have 455 clocks per line

If that value is set wrong you get sampling errors which show up as vertical colums of noise in the pixels.

>How can I set this up exactly?

I just did some checking and found the auto switching didn't like composite or interlaced syncs (it was designed for PC syncs).
I've fixed that so you will have to update the kernel for this version:
[kernelrpi.zip](https://github.com/c0pperdragon/Amiga-Digital-Video/files/5257975/kernelrpi.zip)

Before creating the auto switch folder you must make sure your profiles are setup correctly and at the moment they most likely won't be as the lines_per_frame setting in the geometry menu will be wrong.
On the 625 profile it's currently set to 312 but it looks like the Amiga uses 313 lines for progressive mode so change that value. and save the profile. You will have to make a similar change in 525 as well (When you change that value some status info is shown at the top of the menu which shows the number of lines detected so you can use that to set the value - should be done in progressive mode)

Create a folder called "Amiga" in \Profiles\Simple and put both your saved 625 and 525 profiles in there (remove any existing profiles from \Profiles\Simple). You will also need to create another file in that folder called "default.txt" containing the following line:
auto_switch=1

After rebooting, the software should auto switch between 525 and 625 and it will show the profile it has selected in the sub-profiles line. (You may get a flashing screen if it can't find any match.)
Post any profile folder you come up with and I'll add it to the next release.

c0pperdragon, 2020-09-22:
I followed your instructions and have created this auto-switching profiles.
[Amiga.zip](https://github.com/c0pperdragon/Amiga-Digital-Video/files/5261095/Amiga.zip)

This works perfectly now. I did actually not expect the Pi to switch the resolution at arbitrary times, but yes, this works. I can easily force the Amiga into a different mode on each reset (not only on power cycle) and this works just great with the upscaler.
It seems it  is not even necessary to exactly configure the line length and lines per frame values. By having everything locked to the pixel clock, the sampling is very reliable.

Now, the only missing piece in the puzzle for a true no-hassle, plug-n-play solution would be autodetection of the screen resolution. For 60Hz this works very good already. Even if there is no screen attached at power-up the software just retries detection until a screen is present. This auto-detection mode already somehow works for my 50Hz amiga, but then of course there is no genlock and the scrolling is stuttering.
I have no idea, how difficult it is to add a "Auto (50Hz)" resultion option. It is perfectly fine to manually set this option at installation time (probably by patching the SDcard content of no button is installed). For your unified RGBtoHDMI software release it may probably be better to keep the Auto (60Hz) setting if this is the standard.

IanSB, 2020-09-22:
You can actually get the video output to auto switch between 50 & 60 Hz.
First select the 60Hz version of the resolution in the main menu and exit to reboot, then go to the settings menu and change "Genlock Adjust" from "-5%to+5%" to "Full Range" then save settings. You will have to do this for the 50Hz profile.

After that, the genlock code will slow the HDMI pixel clock down until the output goes from 60Hz to 50Hz. You can use this to track any input refresh rate but it may not always work because it produces very non-standard timings which some monitors can't lock.

You can also try the other way: i.e set the display mode to 50Hz and change the 60Hz profile to Full Range but this is not advised when using 1080P50 because that mode has the same pixel clock as 1080P60 but with huge front porches and when speeded up it will exceed original HDMI pixel clock standards. Slowing down 60Hz is safer as you are not overclocking the HDMI signal.

IanSB, 2020-09-22:
Here is an update with full auto resolution/refresh support.
There is a new resolution file: "Auto". Put that in your resolutions folder and update the kernel file.
When that resolution is selected it overrides the Genlock Adjust setting and uses the Default resolution from the monitor so it will always follow the source frequency. If you can't get a display on a particular monitor then hold down the menu button during power on and it will set the resolution back to Default@60Hz:
[kernelrpi.zip](https://github.com/c0pperdragon/Amiga-Digital-Video/files/5262977/kernelrpi.zip)

c0pperdragon, 2020-09-23:
This automatic mode is absolutely awesome!

I did test it with 7 different devices with all 4 Amiga display variants: 50Hz/60Hz, Interlaced/Non-interlaced
Three 1280x1024 displays
Two 1920x1080 displays (one of which is a TV)
One 1680x1050 display
One HD capture device.

Everywhere the Pi detected the correct native resolution with the capture device working at 1920x1080.
60 Hz output worked on all devices without issues.
50 Hz did not work on two of the 1280x1024 displays. But there also manually selecting the correct 50Hz mode did not help. One of those displays just had a black screen with an error-message. Most annoyingly, the second display could actually show 50Hz without any glitches, but it kept displaying a box with "Invalid frequency" bang in the middle of the otherwise perfectly working display.
Most interestingly the HD capture device would only with with 50Hz when it was nearly exactly this frequency. Progressive mode from the Amiga did not work (having one line too much every second frame), but with interlaced mode, the frequency was correct. When manually setting the output to 50Hz but running the Amiga at 60, the capture device also worked, as then there was no genlock and the 50Hz were also hit exactly.

My conclusion: Automatic mode is perfect for all devices I have tested it with. Where this did not work, there was no other way to make gen-locked 50Hz work, anyway.
It seems that the output devices just do not care about the pixel clock or relative size of the front porch. The thing that really matters is the frame rate and the resolution. Maybe the line frequency is also important, but by just slowing down the official 60Hz modes this seems to be OK.  Looking through some modeline tables, it seems that the vertical distribution to vsync, back porch, image, front porch are more or less identical for different frame rates.

IanSB, 2020-09-23:
>Most interestingly the HD capture device would only with with 50Hz when it was nearly exactly this frequency

You can actually get a true 50Hz output if you want to capture the Amiga:
1. Set 1080P 50Hz output mode and reboot
2. Go into settings and change "V lock mode" from Genlocked to Unlocked.
3. Optionally set Num Buffers to "Triple Buffered" also in the settings menu to hide tearing

The output should now be exactly 50Hz and there will be no genlocking so it won't change frequency.
As the input and output aren't locked there will be tearing and this can be eliminated by increasing the buffering to Triple Buffered but that will also increase the lag to several frames. With the buffering, you will get frame drops or repeats instead of tearing.

>50 Hz did not work on two of the 1280x1024 displays.

Old HP monitors seem to be the best for 50Hz, my HP LP2065 1600x1200 DVI 4:3 monitor has no issue displaying 50Hz modes.

>My conclusion: Automatic mode is perfect for all devices I have tested it with

Do you want this to be the initial mode on first install? The only disadvantage is that if the monitor you are using doesn't support 50Hz you won't get an output at all unless you hold the menu button down on power up to set Default@60Hz.

c0pperdragon, 2020-09-23:
No need to make my capture device work with slightly off 50Hz. As it is not cabable to record this, anything we would force on it would always lead to tearing or frame jumps. This is just not he kind of perfection I want to achieve. As the capture device is a pretty cheap one and actually captures only every second frame in 1080p anyway, there is no need to support it.

 These monitors that refused to work with 50Hz were pretty cheap ones and I actually don't see the reason why their engineers chose to arbitrarily refuse 50Hz. On one it is obvious that it would work perfectly well, would not the error message now be in the way.

The automatic mode is perfect and should be default. To provide users a 60 Hz fall-back, holding the button at startup is pretty usable. But it should not have a permanent effect, so at next reboot it would again be in auto mode.
To still keep installing a button optional, I would recommend to any user who has the problem, to just put a jumper on the button contacts. I don't know what the software does in the case of a permantently pressed button. Maybe showing and hiding the menu all the time? If you could fix this detail, this would then be the complete solution.

IanSB, 2020-09-24:
> But it should not have a permanent effect, so at next reboot it would again be in auto mode.

OK here is another update and two resolution files:
[kernelrpi.zip](https://github.com/c0pperdragon/Amiga-Digital-Video/files/5272936/kernelrpi.zip)

Put the two auto files in the resolutions folder, delete the old Auto one and update the kernel

The two Auto resolution files work as follows:
Auto@50Hz-60Hz - restricted so it can't go above 60 Hz.
Auto@Unlimited - no limits on input to output tracking.

The reason for the two options is that if you input a >60Hz source (e.g. 70Hz) into a system with a DVI or HDMI v1 monitor it will try to generate a video signal that will exceed DVI and HDMI v1 specs and not be displayed. This happens on my vintage PC with EGA/VGA output when VGA text mode is selected. This allows the 60Hz CGA and EGA graphics modes to genlock while still giving a usable output with VGA text.  If your monitor will work with later HDMI specs then you can try the Unlimited option.

In simple mode:
Auto@50Hz-60Hz will be selected as the default resolution when holding the menu button down during power up.
Also holding the button down during power up temporarily restricts the genlocking to the old +-5% so you will only get 60Hz genlocking.
Power cycling after the above will return to normal Auto@50Hz-60Hz mode and you can also fit a link that will permanently restrict genlocking to 60Hz (the permanent button press is ignored by the menus).

In normal mode, holding down the menu button selects Default@60Hz as before.

c0pperdragon, 2020-09-24:
I have tried this and it works very nicely.
Will the Auto@Unlimited then be the default option on a clean install? So for a capable monitor this is a perfect all-in-one configuraiton. Permantenly switching to the Auto50Hz-60Hz mode with the emergency-fallback makes no difference on the Amiga as its framerate does not exceed the limits anyway. The additional effect of also disabling gen-lock is what we need here.
So this solutions now seems to cover all possibilities.

c0pperdragon, 2020-09-24:
I habe already designed and ordered an adapter board PCB that supports SuperDenise as well. If this works, I will make a pull-request to include this also in the RGBtoHDMI repo.

The Amiga-Digital-Video repo needs some update as well, with better installation instructions and all. If this is OK for you, I will try to send samples to some Youtube channels for review to get a bit more attention for the solution. As my own contribution was actually fairly small, I will just promote it as the RGBtoHDMI upscaler project.

IanSB, 2020-09-26:
>Will the Auto@Unlimited then be the default option on a clean install?

Yes, but in a slightly modified way. Here is the updated version to try:
[kernelrpi.zip](https://github.com/c0pperdragon/Amiga-Digital-Video/files/5285955/kernelrpi.zip)
As before, replace the kernel and auto files with the new ones.

This version can now read the EDID and will only try 50Hz modes if the EDID indicates that 50Hz will work. This is a bit more "failsafe" so you will be more likely to get an image on the screen after first install but there will be some monitors that will work at 50Hz even if the EDID indicates otherwise so there are now 3 Auto modes:

Auto@50Hz-60Hz - reads the EDID and only selects 50Hz modes if the EDID allows it.
AutoForce@50Hz-60Hz - Ignores the EDID and always selects 50Hz modes if required.
AutoForce@Unlimited - Ignores the EDID and always selects any output frequency if required.

The default will be Auto@50Hz-60Hz as both simple and normal boards share the same new install default.
In normal mode, that will also be selected on menu-reset, however in simple mode for the Amiga, menu-reset will select AutoForce@50Hz-60Hz which means if you put the link on you will force 60Hz modes and then subsequently removing the link will force 50Hz modes.

Also note some monitors will accept forced 50hz input but do an internal 50-60Hz conversion before display so you still get frame judder on smooth scrolling and there is no benefit from using 50Hz. e.g Dell 2007FP (1600x1200)

Can you test this with your monitors, especially the ones that didn't give a display at 50Hz.

c0pperdragon, 2020-09-26:
Before doing a new test run on all monitors (it is quite a hassle to set this up all over again), I would like to clarify and discuss the possibilities a bit.

An important thing for the solution to work as I envisioned is that adding the jumper link should be fully reversible. If the behaviour is different after temporarily installing the jump link, this becomes incredibly hard to troubleshoot.

So maybe this solution is possible (considering the Amiga mode without menu only):

By default the board uses
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

Thread 9 (2020-09-19):

Amiga Interlaced mode is off by one line

c0pperdragon, 2020-09-19:
Hi @IanSB

As previously mentioned: When using 1280x1024 output resolution, an interlaced workbench is off by one interlaced line.

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

This can also not be fixed by adjusting the vertical offset, because then the picture is too up.
Even if it could be fixed by adjustements, I guess, the non-interlaced picture would be off instead.

For larger output resolutions this effect is basically the same, but there it is not so noticable:

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

IanSB, 2020-09-20:
Can you try this version:

[kernelrpi.zip](https://github.com/c0pperdragon/Amiga-Digital-Video/files/5252708/kernelrpi.zip)

c0pperdragon, 2020-09-21:
The Interlace mode looks like it has a balanced top and bottom overscan now with 1680x1050 output resolution. I can not switch to 1280x1024, because the single-button mode does no longer work after swapping out the kernel file. Do I have to make any changes to my setup to re-activate this feature?

IanSB, 2020-09-21:
The way single button mode is selected was changed: Please update to the current release version first then replace the kernel file with the above:
https://github.com/hoglet67/RGBtoHDMI/releases
https://github.com/hoglet67/RGBtoHDMI/releases/download/20200916_6310e8c/RGBtoHDMI_20200916_6310e8c.zip

c0pperdragon, 2020-09-21:
Interlaced display is perfect now.
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

I have adjusted my configuration to  the "Trailing -ve" sampling option in preparation for the upcomming SuperDenise-adjusted adapter board. If I got everything correct, this configuration should directly work  with it as well. I have also reduced the overscan a bit because the right area was a bit narrower where the Amiga set the last two pixels to black already.
Also when running my Agnus in NTSC mode, the right overscan ends with a strange jagged border. So 712 pixels is now my maximum width that should fit all purposes.
[Amiga.txt](https://github.com/c0pperdragon/Amiga-Digital-Video/files/5256852/Amiga.txt)

IanSB, 2020-09-21:
>I have adjusted my configuration to the "Trailing -ve" sampling option

Yes, the above kernel has the corrected text for the sampling option.

BTW the menus are a very flickery in interlaced mode because they are only written on alternate fields.

Closed 2020-09-23.

Thread 11 (2020-11-19):

User Feedback and Experiences

c0pperdragon, 2020-11-19:
I created this thread as a means to collect feedback about your experiences using this solution. Installation pictures and screenshots are highly welcome.

Markcalibrav6, 2020-11-20:
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

 Tested on a A500+ with a TF536(TF536/Lazarus relocator)  OS3.1 4 Rom workbench 3.9 CGX(native driver) Hi Res laced 16 colours.Standard A500 psu

The adapter was well made and compact design....the jumper on the back is perfectly placed to enable selection of OCS/ECS Chipset....😁

The RPI Zero takes its power from the Amiga so no psu is needed on the RPI side....😉

Easy SD card setup...makes this adapter a dream to setup and use...first power on and you are thrown into a Awesome pixel perfect screen...crisp clear colours.

WHDload games all work well so far...with no artifacts or ghosting at all...no lag no issues when screen modes are changed....however only standard OCS/ECS screen modes are currently  supported....no wide screen options yet or Super72/SuperPlus(800x600)

My Indivison ECS V2 has config tools to tweek the settings that are saved to the device....this would be nice on the RPI side.

Mabe a short GPIO extension cable would be good as the RPI Zero faces the 68000 socket....add the HDMI lead and there is no room for popular CPU cards for the A500...(TF series..with relocator) however if your CPU card can fit directly into the 68000 socket you might be onto a winner.

Overall this adapter is a great option given its low cost compared to other options out there.

c0pperdragon, 2020-11-20:
You can optionally connect a push button to the two angled pins on the adapter board. With such a button you can call up a settings menu (long press) and switch through the various options and modify quite some things (using short presses and long presses). This rich feature set comes from the RGBtoHDMI software that can do much more than just support the Amiga.
But for the Amiga I found that there is normally not much use in trying to tweak the settings. Output resolution is already autodetected and the 4x upscaling looks 100% crisp and accurate. But you may want to turn on scan-line overlay or some interpolation filter. So you actually can do this. Settings are stored on the SD card.

Markcalibrav6, 2020-12-01:
Added a button to the Zero....super cool picture....

https://youtu.be/-gxpG8moEEI

ryanm101, 2021-01-14:
With wicher508i HDMI cable is a tight fit, I've ordered some right angle adaptors to see if that helps.

dahabakuk, 2021-01-14:
i wonder if anyone is using an turbocard with this mod... looks like the hdmi cable will be a really tight fight? can someone share a picture with turbocards installed?

Osmund, 2021-01-16:
Tried to get it to fit with a tf card but there is no clearance. Is it possible to rotate the header for the pi zero 180 degrees, so that the hdmi points to the back of the amiga?

c0pperdragon, 2021-01-17:
I don't have a design for this. I original thought about stacking the Pi directly on top of the Denise, but this would become a problem for the heat dissipation, so I now used this more spread out layout.
But I have designed a smaller adapter which can be used more universall,y but needs soldering of many individual wires.  If you can do that, this may be the solution for you  (but I don't build these boards either).

gaspafen, 2021-01-20:
With such a waiting list for ordering one I ordered some PCB's from eurocircuits and parts from mouser. Had a local supply of the RPi. Forgot to order the resistors so I scrounged a 5k from old broken electronics. Put it all together and it works great. Fits fine in the A500 case together with the vampire v2+. This could be because the pin headers I used have a bit longer pins. Will be ordering some other pin headers to use if I solder another together. Need to get a HDMI switch now :)
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

Osmund, 2021-01-20:
I was lucky and secured a couple before the Jan Beta videos. To make it fit with my tf534 I soldered the pinheader on the pi zero on the bottom with one row on the outside of the adapter. I then connected the outside pins to the second row on the pi. I can now mount the pi to the adapter with the hdmi facing towards the back of the case. With a tower of pisa stack of cpu sockets, the tf534 fits over the pi. It works great, have not had any termal issues. The amiga top case fits as well.
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

de-nugan, 2021-01-28:
I've built two V2 boards from PCBWay. Mine have a couple of differences to the original design:
1)  I couldn't source the exact regulators so used these => https://au.rs-online.com/web/p/low-dropout-voltage-regulators/7968322/
2) The Pi is connected with an extremely short (~1cm) IDC cable for now so it fits with the Kipper 2K 8MB+IDE board in the A500 and also because I can't find the 40-pin female IDC PCB headers anywhere around here :(

Both boards show a sharp and clean image at the 3.1 boot screen, but both have sparkly interference patterns on a grey workbench screen. The colour "sparkles" are mostly green and red, and appear on the trailing edge of black to grey (left to right) transitions. I've seen one or two references to minor cases of this but mine is pretty severe and impossible to ignore.

A few tests so far:
- Change length of the IDC cable to the Pi => sparkles seem to get worse with a longer cable, lines start to flicker more
- Change from original to ATX PSU => no change in symptoms
- Connect additional ground from Pi to A500 chassis => no change

So far I can't tell if the problem is some colour bits staying low for an additional clock cycle OR additional bits going high. I'm wondering if any of the engineers here could offer some insights as the the cause of this problem?

A couple of additional issues are the top scan line flickering left to right, and the geometry is off, but I'm assuming these can be tuned out.

Really impressed by this project though, kudos to everyone involved!

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

hansliss, 2021-01-28:
I ordered PCBA cards from JLCPCB and they look really good. I used 74LVC574APW, 74LVC86APW,118 and TLV74333PDBVR from LCSC - I had to solder on the voltage regulator myself since the PCBA service didn't have those in stock. It all looks very professional, including my own solder work. :)

As far as I could determine, the silkscreen markings on JP1 are wrong; for a Denise (such as my A2000 has), JP1 should be strapped as 2-3, judging from the schematic. If I don't do that, I get unsynchronized garbage - the correct colours, but it scans very slowly and appears to be lacking a clock.

With JP1 strapped 2-3, I get a picture, but it's flashing slowly on and off, has a few artifacts, and isn't properly positioned. Any ideas? I managed to get a screenshot.

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

/Hans

c0pperdragon, 2021-01-28:
@de-nugan :  There are two general sources of pixel errors:
1. The latch in the adapter is triggered too close to the time when color lines change. This can be adjusted by moving the Denise/SupeDenise jump to the other position.
2. The color lines going into the Pi are not stable enough when the clock input to the Pi toggles. This can be caused by serveral things:
2a. Higher capacitance/inductance caused by the longer data path due to the ribbon cable. You could try to compensate that by artifically adding a small capacitor to the PiCLK line.
2b. Bad grounding. In your setup the GND for the Pi is proved through the ribbon cable. You could add some extra GND connection with a short (and reasonably thick wire) to some GND point on the main board.
2c. Different behaviour of the logic ICs. I only designed an tested the circuitry with parts from TI. Maybe parts from other manufacturers have different dynamic characteristics.

c0pperdragon, 2021-01-28:
@hansliss
I doublechecked JP1.  The setting 1-2 is indeed correct for a standard Denise. With the setting 2-3 it would use the inverted 7Mhz as clock which is the best choice for a SuperDenise.
 When the 1-2 setting does not work at all, there is something wrong with your adapter. Maybe solder bridging or no contact.

hansliss, 2021-01-28:
@c0pperdragon Thanks for checking! I'm just still not sure about JP1. Pin 1 is connected to Denise pin 34, right? The thing is, from the schematics for the A1000, on which my ancient German A2000 is apparently based, doesn't have pin 34 connected at all. It is indeed connected to CDAC on later models. Maybe that's the problem?

IanSB, 2021-01-28:
@hansliss

A flashing screen usually means the sync timing doesn't match any of the available profiles.
What software version are you using?

The latest beta is here in case that helps:
https://github.com/IanSB/RGBtoHDMI/releases

hansliss, 2021-01-29:
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

Thanks, I've tried the latest beta. No difference.

hansliss, 2021-01-29:
> @c0pperdragon Thanks for checking! I think the CDAC signal might be the problem, after all. The thing is, judging from the schematics for the A1000, on which my ancient German A2000 is apparently based, the Denise socket doesn't have pin 34 connected at all. It is indeed connected to CDAC on later models. Does that sound plausible?

I've checked the CDAC pin on the Zorro II bus now, and there's a ~7MHz clock signal there, as well as on pin 35 on Denise, but I didn't find anything on pin 34.

c0pperdragon, 2021-01-29:
Hmm, this could really mean that the very early model versions did not have the _CDAC signal connected to the Denise socket.
I am not sure where you can find this signal on your specific machine, but you can probably figure this out with an oscilloscope and then retro-fit this signal to the Denise socket with a botch wire as well.

hansliss, 2021-01-29:
> Hmm, this could really mean that the very early model versions did not have the _CDAC signal connected to the Denise socket.
> I am not sure where you can find this signal on your specific machine, but you can probably figure this out with an oscilloscope and then retro-fit this signal to the Denise socket with a botch wire as well.

I'm going to start by verifying the adapter in an A500. I'm awaiting delivery now. I'll build a couple more adapters tomorrow and then I'll continue this once the A500 arrives. After that I may go back to the A2000 and try again - I don't like it right now. :)

hansliss, 2021-01-30:
> Hmm, this could really mean that the very early model versions did not have the _CDAC signal connected to the Denise socket.
> I am not sure where you can find this signal on your specific machine, but you can probably figure this out with an oscilloscope and then retro-fit this signal to the Denise socket with a botch wire as well.

On the Wikipedia page about A2000 (of all places), I found this: "[...] the early 2000 motherboard [...], cannot be upgraded with newer versions of the chipset [...]". To me, this confirms that what I've found may very well be correct - that there really is no CDAC signal on the Denise socket.

hansliss, 2021-01-30:
> Hmm, this could really mean that the very early model versions did not have the _CDAC signal connected to the Denise socket.
> I am not sure where you can find this signal on your specific machine, but you can probably figure this out with an oscilloscope and then retro-fit this signal to the Denise socket with a botch wire as well.

I just saw a schematic that was a bit legible than what I've seen before, and found that another signal is missing on the A1000/A2000-A motherboards: Pin 32 is NC instead of /CSYNC, which seems to be used by the RGBToHDMI adapter.

tk-amiga, 2021-01-31:
Made a few V1's and my own works very nicely in a rev6a motherboard with Super Denise. I guess V2 is more for the rev8 motherboard. Will get those soon too.
https://nextcloud.amigaaa.com/s/q7dRdWoordnTmDY
https://nextcloud.amigaaa.com/s/23kHYkrD59GKCZm
Luckily my turboboard is in the sideslot.

IanSB, 2021-02-03:
@hansliss
>A1000/A2000-A motherboards: Pin 32 is NC instead of /CSYNC, which seems to be used by the RGBToHDMI adapter.

Yes, CSYNC is required, one thing that is a little confusing is that your screencap above is horizontally locked which it shouldn't be if sync was missing completely but it looks like the floating sync input is picking up crosstalk from the RGB signals and interpreting noise from the start of video as the edge of the sync pulse which would explain the shift to the left.

hansliss, 2021-02-03:
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

I got this working. See #28 for details.

IanSB, 2021-02-04:
@de-nugan
>The colour "sparkles" are mostly green and red, and appear on the trailing edge of black to grey (left to right) transitions.

What revision motherboard is your system?

de-nugan, 2021-02-05:
I think it’s rev 5 or 6, but can’t be sure as I’m away at the moment.

Also I found the flipflops I used were Nexperia parts. I have some TI parts on order to try when I get back mid-month.

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

lilwashu, 2021-02-18:
I have noticed "sparkling" but only on pink text in Indiana Jones and the Fate of Atlantis game. The "sparkles" are white. I'm running an A2000 rev 6.2 motherboard with a rev.1 adapter from seller "r3ne3gad3mast3r" on eBay and Terriblefire TF536 accelerator.

c0pperdragon, 2021-02-20:
Chances are that you have a SuperDenise on your board. This is not working well with the Rev.1 adapter. The Rev.2 has a jumper to select between original Denise and SuperDenise.
If you are good with a soldering iron you could try to botch the adapter to
make it somehow work. If you want I can give you instructions.

lilwashu, 2021-02-20:
Thanks for the reply - I have an 8362R8 OCS Denise. I haven't seen the issue before or since so I'll see if I can reproduce it, trying to do so in e.g. DPaint has so far failed. The installation is a pretty tight fit in the A2000 so I'll also see if removing the PSU frame makes any difference, there is light pressure on it.

FluffyRedLobster, 2021-02-27:
Reporting great success with installation alongside a TF536 accelerator on a rev 6a A500 😃 . This was with a v1 board but I'm sure the concept will apply to v2.

As others have found, space is tight if using a CPU relocator.  I considered options that others have mentioned in this thread - GPIO flex cable, or osmund's method of offsetting the headers and mounting the zero on it's back.  I experimented with using 2 x 90 degree pin headers to achieve something similar but was worried about the extra connections and additional signal distance given some of the reports here.

Ended up with a pretty simple solution - 2 sets of machine pin headers to lift the CPU relocator and the TF536 (one set for each gives the required clearance and still allows the keyboard to fit without fouling on the relocator), and _gently_ angle the GPIO pin headers on the adapter so the Pi Zero points toward the mainboard by 10 degrees or so.  The mini HDMI cable then outputs under the relocator to be routed to wherever it's needed.  I soldered the Pi directly to the angled pin headers but probably could have used a female header strip if I thought about it... it's not like the Pi is going anywhere else...  Lastly as I had a fairly chunky mini HDMI cable (the officialy Raspberry Pi one)I removed some of the plastic shroud to ensure there is no pressure on the solder joints from the cable.  I slimmer cable probably wouldn't need this.

The output quality is astonishing!  I'm using an old 17" Iiyama Prolite that syncs at 50Hz and scrolling is perfect too.  This easily beats the indivision mk2 in my A1200 in that regard.   Thanks c0pperdragon and hoglet67 for this great mod 👍

Hope the approach helps some other CPU relocator users out there.

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

solarmon, 2021-03-07:
@c0pperdragon

What did you mean by:

>    2a. Higher capacitance/inductance caused by the longer data path due to the ribbon cable. You could try to compensate that by artifically adding a small capacitor to the PiCLK line.

How would the cap be added? In parallel (with what?) or in series? What value would you propose?

IanSB, 2021-03-07:
For sparkly pixel related problems, especially with rev5 or earlier A500s or other models, try replacing the 74LVC parts with 74VHC parts. These are slower and fixed the sparkly problem on my rev5 which doesn't have the clock filtering components that are fitted on rev6 & later boards and which slightly delay the clock signals. You may get away with just changing U1 (74LVC86) to VHC so try that first.

Note they must be 74VHC parts which are 5v tolerant, not 74HC parts which are not 5v tolerant when powered at 3.3v

c0pperdragon, 2021-03-08:
@solarmon
To make the clock signal to the Pi running a tiny bit slower, you could try to add a capacitor (lets say 10pF or a bit higher if this does not yet work) between pin 16 (GPIO23) and pin 0 (GND) of either the Pi or the adapter.

solarmon, 2021-03-08:
@c0pperdragon I only had "22" (27pF) ceramic cap to hand. This didn't seem to make any noticeable difference all (good or bad). So I'll have to source some smaller caps to try them out. When you sat 'or a bit higher' - how big a difference is this? Can I go from 10nF to 20nF, for example, or should the jump be smaller than that (i,e. 10, 12, 15, 18, 20, etc)?

c0pperdragon, 2021-03-08:
1 nF is for sure too much already. If 68pF does not yet work, I would give up on the idea.

solarmon, 2021-03-08:
Sorry, I should have said "10pF to 20pF". As stated, I've already tried 27pF.

c0pperdragon, 2021-03-08:
I did a bit of read-up on the matter of output capacitance for LVC parts, and it seems that to get a significant change in switching time you should actually use something like 200pF. This should delay the output for about 5ns which seems about right to me.

solarmon, 2021-03-08:
I had a bag of small 27pF ceramic caps. I put a load of them in parallel (probably about up to 30/40) and it didn't seem to make any noticeable difference at all. Not sure if what I'm doing is right - I thought putting caps in parallel adds up their capacitance.

c0pperdragon, 2021-03-08:
Yes, putting capacitors in parallel does add the capacitance.
I am not sure what is going on here. I would expect it to make at least some difference, either for better or worse.
Could you post a picture or your installation?

de-nugan, 2021-03-10:
Following on from above, my Pi is now soldered to the adapter to get the shortest possible data path and this has successfully fixed the colour sparkles and glitches. The picture is now superb on my Rev 5 A500.

I soldered the adapter board in place of the Denise socket for reliability and compactness, so it's now a permanent daughter board. A couple of caps and a resister pack needed to be nudged out of the way but overall it was a pretty easy fit and takes a minimum of space. The boards now sit low enough to go underneath the CPU expansion card without any additional risers, so the case can go back together as normal.

I'm using a short mini male to std HDMI female cable from the Pi, it was necessary to cut the molding from the mini plug end to fit the cable between the ROM and CPU. It's tight but fits together pretty well. I have had some CF card errors since the installation, don't know yet if EMI from the adapter is causing issues with the expansion card above.. needs more testing.

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

seb132, 2021-03-13:
Has Edu Arana (Arananet) released his PCB of the official repository ?
He said on Facebook that he would -- after he presented his very neat redesign of the adapter for the A500, compatible with Vampire, etc. But so far I haven't seen it yet, just in pictures.
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

solarmon, 2021-03-13:
@seb132

As an alternative option, once I've tested my design, I will be releasing it.

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

dgoswick, 2021-03-18:
What does this mean?  I verified that my build is right.  This is on a stock Amiga 500.
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

mthiesen, 2021-03-19:
I can add another datapoint. I have ordered a board from eBay and installed it into my Amiga 500 Rev. 5. It works almost perfectly, but I am experiencing the same pixel sparkling that @lilwashu reported. It only seems to happen on very special color transitions and always from very dark to bright.

This is a screenshot from the Monkey Island intro:
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

I can also reproduce the issue with Deluxe Paint IV and the example image `ReferencePalette.LoRes`.  In this case only the medium saturation and low saturation rows are affected. The effect is by far the strongest in the last two boxes of the medium saturation row.
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

c0pperdragon, 2021-03-20:
When you have sparkling pixels, check out this thread for a very detailed discussion an possible solutions:
https://github.com/c0pperdragon/Amiga-Digital-Video/issues/40

jock-mcbufty, 2021-03-21:
Hi there!

When I have installed the GBItoHDMI and Raspberry Pi Zero on my A2000
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

i get this output! Any ideas anyone?

LinuxJedi, 2021-03-22:
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

Are you using the A2000 board or the original A500 board? Make sure you have the jumper set correctly for the Denise you have in the A2000 (some surprisingly do have a Super Denise in them when you least expect it). Beyond that your board may need some tweaks.

jock-mcbufty, 2021-03-22:
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

—

Hi!

Yeah 2000 board Rev 6. I guess I can try popping the jumper back to Super Denise. I’m very much a super novice so if it’s soldering etc I will pass. The whole thing was propping up the PSU & FDD caddy anyway. Shame though it was a good idea. So this device is really only guaranteed for A500 & 1200s?

cheers!

hansliss, 2021-03-22:
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

I'm awaiting 500mA regulators and will soon build five boards with those, for five different people (myself not included since my A2000 is to old for the video slot version). I will encourage all of them to write about their experiences here.

LinuxJedi, 2021-03-22:
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

If the Denise is a chip with the model 8373 (will have an R3 or R4 after it) then you have a Super Denise, if it is 8362 (likely an R8 after it) you have a regular Denise.

It should work with A2000, but there is a specific card version for it (which I'm working on an improved version of) that goes in the slot to the right of PSU as the front of the machine faces you instead of under it.

jock-mcbufty, 2021-03-22:
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

—

I appreciate all the replies, I find modding fairly stressful when you are as clueless as myself. This setup looked fairly straight forward so I had a go.

I will check tonight what chip I have, just in case! Again thanks for the tip regards versions. Can I quickly check that I haven’t fitted the whole thing the wrong way round? I made sure the slightly nick or circle on the side of the device matched the hole below it on the motherboard itself.

thanks!

jock-mcbufty, 2021-03-22:
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
It looks like I have a super Denise so I will switch jumpers and have another go!

hansliss, 2021-03-22:
> I will check tonight what chip I have, just in case! Again thanks for the tip regards versions. Can I quickly check that I haven’t fitted the whole thing the wrong way round? I made sure the slightly nick or circle on the side of the device matched the hole below it on the motherboard itself.
>

Since you get a picture at all, I'm sure you've basically done it correctly. There are some weird issues with sparkling edges and similar that might or might not be related to what you get. For now, some suggested changes have been to use another technology for the three chips on the adapter board (74VHC* instead of 74LVC*) and (although this may be only for the video slot version) to use a beefier voltage regulator. I don't think there's any final solution for that particular problem, though.

hansliss, 2021-03-22:
> It looks like I have a super Denise so I will switch jumpers and have another go!

Oh, would be great if it's that simple.

LinuxJedi, 2021-03-22:
> Since you get a picture at all, I'm sure you've basically
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

Thread 12 (2020-12-02):

Software update

IanSB, 2020-12-02:
Can you check out the latest version of RGBtoHDMI with the Amiga board to see that it still works OK. I've changed the menus so they don't flicker in interlaced mode by switching to progressive capture when the menus are on screen (The image under the menus will be at half vertical resolution).

The wiki has been updated to cover recent changes:
https://github.com/hoglet67/RGBtoHDMI/wiki/Quick-Start-Guide
https://github.com/hoglet67/RGBtoHDMI/wiki/Reference-Guide

Software:
https://github.com/hoglet67/RGBtoHDMI/releases

TuKo1982, 2020-12-02:
Works nicely for me

c0pperdragon, 2020-12-12:
I finally came around to put the Amiga on my bench again. The new firmware works flawlessly. I like the new option to test monitors for 50Hz compatibility. As you have announced, the interlace mode no longer flickers the settings menu (but shows only half the lines which is OK, I guess). So I updated the link to the firmware download.

Also I wanted to mention that the version 2 of the adapter seems to work fine with the SuperDenise, so I made a pull request for it to be included in the RGBtoHDMI repo.

Closed 2020-12-25.

Thread 13 (2020-12-04):

Adapter production

c0pperdragon, 2020-12-04:
I set up this thread to keep anyone informed who wants to buy an assembled adapter from me.
My first builds are nearly sold out (all ECS are gone or reserved) and I am in the process of ordering more parts. I will keep you informed.

culexus8, 2020-12-13:
I see you mention a V2 board in the readme. Is this for the A600?

c0pperdragon, 2020-12-14:
I sold the last part today, but expect more material to arrive in a few days.
From now on I will only build the V2 variant which is OCS and ECS compatible.

c0pperdragon, 2020-12-25:
I spent parts of yesterday and today to assemble 10 Revison 2 adapters (feeling like a christmas elf all the while ;-) ) .

As it turns out, this is really labour-intensive so I need to adjust my prizing a bit (also to cover various overhead losses).
I can give out these adapters now for €29 plus shipping (€6 in Austria, €10 in Europe, €15 international, UK is currently not possible due to canceled air traffic).
Payment only via paypal to my account: reinhard.grafl@aon.at

Please reserve your adapter(s) by email and wait for my response before transfering any money.

If you cannot get any of these right now, do not worry. I will continue to make the adapters as long as there is demand.

Centrinouk, 2020-12-30:
Hi, interested in adapter but I'm from the UK, could you update when shipping is available please? Thanks

c0pperdragon, 2020-12-30:
My latest batch is already sold out. I expect more parts to arrive in a few days to make more adapters.

karynroberts, 2020-12-30:
> My latest batch is already sold out. I expect more parts to arrive in a few days to make more adapters.

Hi there - great project - I would like to get two of these :) thanks.

kipper2k, 2020-12-30:
Hi,  Is the Rev1 board same as rev2. i cannot find the gerbers for them,  are they public ?

 Thanks, very nice project

65Thumper, 2020-12-30:
Would like to say, great job!
Also like to order 3 adapters, Thanks!!

c68696c66, 2020-12-30:
@kipper2k l found the v2 adapter gerbers here: https://github.com/c0pperdragon/RGBtoHDMI/tree/master/kicad_AmigaAdapter (looks like there is a pending pull request to merge it from this fork to the main repo...)

kipper2k, 2020-12-31:
found them. thanks for the info :)

nyteshade, 2020-12-31:
Would love a completed unit or two. Curious if there’s any known effort to get ECS/AGA support built?

amigacommodore, 2020-12-31:
I would like to order the adaptor but I live in Australia

c68696c66, 2020-12-31:
@kipper2k I opened the project in KiCad and generated the BOM. U4 seems to be a LDO Voltage Regulator TLV74333PDBVR

c0pperdragon, 2020-12-31:
Please do not clutter up this thread with off-topic stuff. Please create seperate threads for this.

warrengc3, 2021-01-01:
Hi, Any more ECS we can order?

65Thumper, 2021-01-03:
Yes, I still would like 3 for my Amiga 500s,  assemble of course, thanks!
E.Cotton

Gesendet mit meinem HTC

----- Nachricht beantworten -----
Von: "George Warren" <notifications@github.com>
An: "c0pperdragon/Amiga-Digital-Video" <Amiga-Digital-Video@noreply.github.com>
Cc: "65Thumper" <edcotton@gmx.de>, "Comment" <comment@noreply.github.com>
Betreff: [c0pperdragon/Amiga-Digital-Video] Adapter production (#13)
Datum: Fr., Jan. 1, 2021 23:08

Hi, Any more ECS we can order?

&mdash;You are receiving this because you commented.Reply to this email directly, view it on GitHub, or unsubscribe.

c0pperdragon, 2021-01-03:
Please send me an email so I can put you on my preorder list (which is growing quite long already).

amigacommodore, 2021-01-04:
I am yet to get a confirmation that you have put me on your list ?

c0pperdragon, 2021-01-05:
Please do not use this thread for reservations. I intend this striktly for announcments.  Send me an e-mail instead.

c0pperdragon, 2021-01-10:
I have finally received the PCBs I had ordered before christmas and was able to build 14 more adapters. With about 200 units on my reservation list already, this seems not much, but it is at least something.
100 more PCBs are on their way and I am going to order more material  still..

I will contact the persons on the top of my list which are not in the UK (sorry, but there is still no mail service) and have sent send me an email before 31.12.2020.

c0pperdragon, 2021-01-27:
Have received 100 PCBs to build adapters from. With my current workflow I will be able to build about 16 parts in two days. I will send out notifications accordingly.

c0pperdragon, 2021-02-10:
Production is progresssing smoothly. So far I have processed all requests that were sent to me before 7.1. 20:00.
Hope to be able to catch up eventually....

c0pperdragon, 2021-02-26:
I have completed processing all queued user request and have a few pieces left. As I don't plan to build any more of these adapters these few can still be bought directly and after that you need to find other sources.

c0pperdragon, 2021-02-28:
During the last days I have sold off my remaining adapters. I don't plan to build any more of these in the forseeable future. As there are already other people taking up production, you may find such adapters on ebay or similiar platforms.

Closed 2021-03-24.

Thread 14 (2020-12-25):

100 new boards available

c0pperdragon, 2020-12-25:
!!Oops: Wrong title: I meant 10 boards.

I spent parts of yesterday and today to assemble 10 Revison 2 adapters (feeling like a christmas elf all the while ;-) ) .

As it turns out, this is really labour-intensive so I need to adjust my prizing a bit (also to cover various overhead losses).
I can give out these adapters now for €29 plus shipping (€6 in Austria, €10 in Europe, €15 international,  UK is currently not possible due to canceled air traffic).
Payment only via paypal to my account: reinhard.grafl@aon.at

Please reserve your adapter(s) by email and wait for my response before transfering any money.

If you cannot get any of these right now, do not worry. I will continue to make the adapters as long as there is demand.

Closed 2020-12-25.

Thread 15 (2020-12-31):

BOM availability

kipper2k, 2020-12-31:
Hi, hopefully this post is in the correct place. Do you have a BOM publically available for this as i would like to build myself a couple of these. I seen the V1 pdf but not the V2 version.

 Thanks

culexus8, 2021-01-01:
I was also looking for the V2 and the small, looks like they are removed. It may be that he is doing some changes? I do have them at home but im at work for the moment.

zeakdad, 2021-01-10:
Loading the project into kicad, I get the below as a BOM via the eeschema tool but I've not gone through each item yet to see if there is enough detail to actually build up a proper items to order. Hopefully this will help though

Columns are Reference / Value / Footprint / Datasheet / Qty

v  C1 - C3	100nF	Capacitor_SMD:C_0603_1608Metric_Pad1.05x0.95mm_HandSolder	~	3
        C1	100nF	Capacitor_SMD:C_0603_1608Metric_Pad1.05x0.95mm_HandSolder	~	1
        C2	100nF	Capacitor_SMD:C_0603_1608Metric_Pad1.05x0.95mm_HandSolder	~	1
        C3	100nF	Capacitor_SMD:C_0603_1608Metric_Pad1.05x0.95mm_HandSolder	~	1
    C4	1uF	Capacitor_SMD:C_0805_2012Metric_Pad1.15x1.40mm_HandSolder	~	1
    JButton1	Conn_01x02	Connector_PinHeader_2.54mm:PinHeader_1x02_P2.54mm_Horizontal	~	1
>  JDenise1, JDenise2	Conn_02x12_Counter_Clockwise	Package_DIP:DIP-24_W15.24mm_Socket	~	2
>  JMainBoard1, JMainBoard2	Conn_01x24	Connector_PinHeader_2.54mm:PinHeader_1x24_P2.54mm_Vertical	~	2
    JP1	Jumper_3_Bridged12	Connector_PinHeader_2.54mm:PinHeader_1x03_P2.54mm_Horizontal	~	1
    JRaspberryPiZero1	Conn_02x20_Odd_Even	Connector_PinSocket_2.54mm:PinSocket_2x20_P2.54mm_Vertical	~	1
    R1	3k3	Resistor_SMD:R_0805_2012Metric_Pad1.15x1.40mm_HandSolder	~	1
    U1	74LVC86	Package_SO:TSSOP-14_4.4x5mm_P0.65mm	http://www.ti.com/lit/gpn/sn74HC86	1
v  U2, U3	74LVC574	Package_SO:TSSOP-20_4.4x6.5mm_P0.65mm	http://www.ti.com/lit/gpn/sn74HCT574	2
        U2	74LVC574	Package_SO:TSSOP-20_4.4x6.5mm_P0.65mm	http://www.ti.com/lit/gpn/sn74HCT574	1
        U3	74LVC574	Package_SO:TSSOP-20_4.4x6.5mm_P0.65mm	http://www.ti.com/lit/gpn/sn74HCT574	1
    U4	TLV74333PDBVR	Package_TO_SOT_SMD:SOT-23-5_HandSoldering	http://ww1.microchip.com/downloads/en/DeviceDoc/MIC550X.pdf	1

kipper2k, 2021-01-13:
Thanks for the info, it looks like i have enough info to build, i will leave this thread open till i can verify.

zeakdad, 2021-01-13:
I took a stab a selecting parts from digikey and ordered 10 boards from jlcpcb. I guess I'll see what happens when everything arrives. The passives I just had to guess the specs, everything else was pretty straight forward

kipper2k, 2021-01-13:
PCBs should be here on friday so i should hopefully be able to build. I have ordered the parts from digikey

Zucky16, 2021-01-15:
Kipper2k, if this works out for you please share your experience with us.  I remember a while back you were building a bunch of cool stuff for Amiga systems, but your funding dried up and you were forced to stop.  I'm in Ontario, Canada, if I remember correctly you weren't that far away.  If you are successful I'd definitely buy one of these boards from you, either fully assembled or just the bare board.

c0pperdragon, 2021-01-15:
Added a proper BOM to the repo

Closed 2021-01-15.

Thread 16 (2021-01-03):

Scanline Problems on Amiga

SirCathal, 2021-01-03:
Hi there,
I use the adapter in my Amiga 500 and am very enthusiastic about it.
I only have one problem with the scanline option.
I activated it in the Preferences menu and then changed the "FB Size" from normal to double height in the Geometry menu.
Before, I had a sensational picture (ignoring the distortions from the cell phone camera)
But after the change, I have a totally shaky picture.
The photo is only a snapshot, in real life it is constantly shaking.
Am I doing something wrong or is it a general problem?
Maybee @IanSB knows about this?
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

IanSB, 2021-01-04:
> I activated it in the Preferences menu and then changed the "FB Size" from normal to double height in the Geometry menu.

Currently scanlines require double height enabled and switching that on means that there are two uncached memory writes per pixel instead of one. Unfortunately in 12 bits per pixel mode which the Amiga requires there isn't enough system bandwidth for the double writes so you get the above messed up display as pixels are being dropped.

You might be able to work around the problem by overclocking the Pi zero:
Go into the settings menu and try adjusting the overclock values, the core setting usually makes the most difference followed by the cpu setting, the sdram setting doesn't seem to make any difference. If those values are too high, some Pi zeros will freeze so only save the settings if the system appears to be stable.
Note if you have saved overclock settings that cause the zero to hang up before you can clear them you will have to manually delete the saved profiles folder on the SD card to recover normal operation.

It should be possible to implement scanlines in an alternative way which doesn't require the double height option set and it's on my list of things to look at.

SirCathal, 2021-01-05:
@IanSB Another solution for Scanlines would be great. On a big screen, scanlines are better for me :-)
But until then I will try the overclocking and hope that it will help.

SirCathal, 2021-01-06:
Hi @IanSB
Today I tested the overclocking and I could stabilise the Picture a bit, but not enough that I could live with it.
The interesting part is, I set Overclock Core to 90. If I go higher, the Picture flickers more.
The other two Values don't have a significant impact.
I even tried to set everything to the maximum value, but it dosen't  get better than the 0 - 90 - 0 setting in the Picture below.

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

The other thing is, I had set the Scanline Level to 8 because I like scanlines that are halve bright compared to the normal lines.
But they showed completely black I tried lower and higher settings, but they are always only black.
Here are the result (In real live, the black lines are better visible than on the picture):
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

IanSB, 2021-01-10:
@SirCathal

There is a download link for a beta test version in the hdmi capture card thread with scanlines support:
https://github.com/c0pperdragon/Amiga-Digital-Video/issues/19
Note that scanlines can only be black because adjustable scanlines require the two writes which as you see above has problems due to bandwidth issues.
It may be possibe to improve on this by using the GPU but there isn't much documentation for that so it may be a while before I can look at that.
Also note the link for a micro SD card extender to make software upgrades easier.

IanSB, 2021-01-10:
Updated to beta10 due to cache alignment timing issue
https://github.com/IanSB/RGBtoHDMI/releases/download/626a527/beta10.zip

SirCathal, 2021-01-12:
@IanSB Thank you, I will try this as soon as possible. My ordered Micro SD Extender should arrive today, then I will fit both together because it's a bit complicate to open that special Amiga Case. With the Micro SD Adapter I have to do that only once (thanks for the tip)

SirCathal, 2021-01-12:
Hi @IanSB
there is one thing I don't understand, you mentioned that the lines have to be written double with adjustable scanlines.
But isn't that done too when no scanlines are selected?
Because with no scanlines, the original line is there twice too. Or is that al done inside the scaler?
If its done in the scaler, would it be possible to do the scanlines before the image is scaled?
Or maybe only on none interlace screens?
What I mean is, a 640x512 Pixel Screen without scanlines work fine but should need exact the same amount of pixels written then a 640x256 Screen with scanlines.
So maybe it could be a possible solution to allow the adjustable scanlines only with non interlace inputs?

IanSB, 2021-01-12:
@SirCathal

>Because with no scanlines, the original line is there twice too. Or is that all done inside the scaler

The video is captured at 640x256 and written to a 640x256 buffer in normal mode. The line doubling is done by the hardware scaler in the GPU but it can only replicate the line with the default scaler options.

In double height mode, the video is captured at 640x256 but written to a 640x512 buffer with two writes per pixel. The second pixel can have changed intensity for scanlines. For black scanlines, only 1 pixel is written and the other pixel is always left black.

It should be possible to get the GPU scaler to generate scanlines but that requires detailed documentation on writing display lists for the Pi in bare metal and there isn't much of that available at the moment.

I have managed to get 50% scanlines working in 12bpp mode. There is not enough processing time for fully variable and even then the timing is marginal and the Pi is very overclocked:
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

However, it only seems to work properly with the CPLD version of RGBtoHDMI (screencap is from that) and with c0pperdragon's board I get glitches due to pixel drops. I think this is be because the pixel clock on the Amiga is slightly asymmetric which means less processing time on alternate pixels and c0pperdragon's board has to use that as it's clock. The CPLD version regenerates the pixel clock in the CPLD from the Hsync pulses and that is always perfectly symmetric so equal time on every pixel.

I'll post another beta soon with this change so you can try it on your system. You might get it to work with higher overclocking if you put a heasink on your Pi.

SirCathal, 2021-01-12:
That seems that you are getting closer to a good solution, that's great and your image above looks perfect for me.
50% scanlines would be perfect, It's the setting I always use if it's available.

I will try to overclock as much as possible, I have some small heatsinks here to do that.

I didn't know that there are two different clocks, I always taught the signal is synced to the sync signal from the Denise Chip in the Amiga.
But on the other hand, the Board has a Jumper to select between the different OCS and ECS Denise chip versions and I was wondering about that, because I always taught that those chips should produce completely identical signals as long as no ECS video mode is used.

The only bad thing is that the delivery of my micro sd extender was shifted from today to tomorrow. So I hope I can test tomorrow after work.

SirCathal, 2021-01-12:
Ah OK the resolutions.
I have monitors with 1280x1024 and 1920x1080 and a 4K TV. But no 1600x1200 or 1920x1200 monitor.
Maybe it work with the 1280x1024 monitor

IanSB, 2021-01-13:
> 1440x1080 is a common resolution for older videos that could be handled by the most 1080p monitors

Yes, that works with no glitches:
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

If your monitor has a 1:1 pixel mode it should be able to display 1440x1080 with no problem, however not all monitors can do that so I have also added a special resolution which puts overscan padding of 240 pixels on either side so it looks like a 1920x1080 signal.

Unfortunately there is a bug in the Pi's nearest neighbour scaling kernel when using the overscan padding as the scaled output is a little mangled if you examine it closely. If I switch to interpolated scaling it looks OK.

IanSB, 2021-01-13:
@SirCathal

>So I hope I can test tomorrow after work.

Here is the new beta version:

https://github.com/IanSB/RGBtoHDMI/releases/download/c673ab0/beta11.zip

Wipe and reinstall on the SD card and reboot the Pi from the info menu or repower the Amiga

To make changing the settings easier I have added two extra profiles.
You can now change the Profile setting between:
Amiga
Amiga 0% scanlines
Amiga 50% scanlines

Amiga 0% scanlines is the same as the default Amiga profile but with just the scanlines setting turned on
This one should work at all resolutions

Amiga 50% scanlines has scanlines turned on, double height enabled and CPU and Core overclocked to 50 and 160 respectively.
They may need to go higher but that's a good starting point.
This profile will glitch in 1920x1080 mode but will give a stable image in 1280x1024, 1440x1080 and 1600x1200 modes

There are two new resolutions you can manually select:
1440x1080 - This is the preferred option but if your monitor can't display it at 1:1 pixels it may be unusable (You may need to change settings in your monitor to get it displaying 1:1)

1440(1920)x1080 - This is an experimental resolution which outputs 240 overscan padding pixels on either side of the 1440 image making a total of 1920 pixels. This should be treated by the monitor as 1920x1080 so no setting change should be required. However integer scaling doesn't work properly with this mode which I think is a bug in the Pi's boot firmware. If you compare the menus with a normal 1920x1080 image the text is a bit ragged/uneven even though all the ratios are correct for even scaling.

SirCathal, 2021-01-13:
@IanSB WOW that works perfectly for me.
1440x1080 is pixel perfect on my monitor with the 50% setting.

The only thing that maybe could be a Problem is,  as long as I chose a fix resolution, there is no 50/60Hz auto switching.
For me personal, that's no problem because I always use 50Hz with the Amiga.

Thank you for your new release!

I will make more tests tomorrow and post some Pictures. Today it's a bit late here and I have to get up early for work.

SirCathal, 2021-01-14:
I Made more tests and the results are fantastic.

Here some examples with 1280x1024 as output resolution and 50% Scanlines:
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

And here 1440x1080 as output resolution and 50% Scanlines (Supporting Overscan):
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

IanSB, 2021-01-14:
> I Made more tests and the results are fantastic.

They look great!

Have you tried the "Swap aspect 625-525" setting  in the preferences menu. That will stretch NTSC sourced images so the above sources with the black border at the bottom should become full screen.

Also in the preferences menu is the screencap size option. By default screencaps are usually half size as that looks better when posting them but you can switch to full size to get 1440x1080 instead of 720x540.

I fixed the 1440 with 1920 pixel padding mode so that now works as well which means 1440x1080 can now work on all 1080p TVs and monitors (e.g. my TV didn't support 1:1 pixel mode so would always stretch 1440 to full width).

I also added a new option for up to 5 saved configurations for each profile so you can quickly switch between different sets of preferences.

I'll post an updated beta soon.

SirCathal, 2021-01-15:
@IanSB  I did not test the swap aspect option, but I will do more testing over the Weekend, today I had not the Time for testing but I will continue tomorrow.

IanSB, 2021-01-16:
@SirCathal

Here is another beta version (beta12):

https://github.com/IanSB/RGBtoHDMI/releases/download/48dff12/beta12.zip

This has resolution and refresh split into two options which makes it easier to change settings
Also new multiple saved configurations (5)
Automatic overscan to eliminate glitches in 50% scanline mode so you no longer have to select 1440x1080 and can leave it on Auto and it should still work.
Also has various bug fixes.

SirCathal, 2021-01-18:
Hi @IanSB
Sorry for not being able to test a lot. Unfortunately, I got sick, but I assume that it will get better shortly and then I will test more.
But I tested something. The 625-525 aspect ratio menu item works fine. For me who is used to seeing a black stripe at the bottom of NTSC games, this is really unusual :-) but cool.
The scanlines also work in the auto setting at 1920x1080. however, from time to time I have a slight flicker or twitch in the picture. If I continue to overclock to 60/175/0 it is gone, but then the Pi crashes after a few minutes. But I don't have a heatsink on it yet. Therefore I have set 1440x1080 again at the moment.
What works great is the 50/60 Hz switching.
I've heard from other users that they would like another mode with 75% scanlines. would that still be possible?

IanSB, 2021-01-18:
@SirCathal

I hope you get better soon.

>The scanlines also work in the auto setting at 1920x1080. however, from time to time I have a slight flicker or twitch

When using 1920x1080 I overscan limited the picture to 1600x1080 as that stopped most of the problem and some profiles used that wider image but it looks like the extra little bit of overscan to 1440 is needed for the Amiga.

I have now changed it to overscan to 1440x1080 if the max width is set to 720 or less in the geometry menu (which it is with the default Amiga profile). This output will now be identical to the 1440(1920)x1080 resolution in the above beta 12 (but not the same as the "1440x1080" profile which has no overscan).

When you feel better can you switch to "1440(1920)x1080" resolution with the above beta 12 and see if there are any problems?

SirCathal, 2021-01-21:
Hi @IanSB
I tested 1440(1920)x1080 and it woks fine, no flickering great picture. It look's exactly like 1440x1080.
For me it's perfect.

I Made some Screenshots with and without the aspect scaling.
Most Time it works fine, a few games stretches to far (for example Blood Money ) I think it uses some vertical ntcs overscan but I'm not sure.
The Blood Money Intro stretches fine:
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

The Game itself expands the vertical resolution a bit:
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

The scaling of Monkey Island and Sysinfo is fine:
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

SirCathal, 2021-01-21:
@IanSB If I can something else for you please let me know.
And do you think you can add one more profile with 75% scanlines?

IanSB, 2021-01-22:
@SirCathal

>If I can test something else for you please let me know.

Here is beta14 with various fixes including Auto resolution reducing the width to 1440 so can you check that works for you:

https://github.com/IanSB/RGBtoHDMI/releases/download/98d62b35/beta14.zip

>And do you think you can add one more profile with 75% scanlines?

I may be able to add 25% and 75% scanlines but it will require some rewriting and code optimisation so it may be a while before that happens.

SirCathal, 2021-01-22:
@IanSB I tested beta 14 and it works very good.
Auto resolution detects my 1920x1080 display and uses 1440 (displaying 1920x1080) but there is no flickering in 50% scanline mode so it must be 1440x1080.
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

IanSB, 2021-01-26:
@SirCathal

https://github.com/IanSB/RGBtoHDMI/releases

Beta 16 now has fully variable scanlines after I changed the frame buffer format.
Can you test to see if it is OK for you.

I decreased the overclock settings because the code is now more efficient but if you see any issues, try increasing again.

SirCathal, 2021-01-26:
@IanSB
Thanks for the new beta. I tested the new variable scanlines and in general they work great.
They work fine with auto resolution

But I also found some issues.
1)	When I start a NTSC WHDLoad Game on my Pal Amiga (for example Frontier Elite 2) it switches correctly to 60Hz. But forgot my Scanline Level (I selected 12 and saved that configuration) but when it switches to 60Hz it steps back to the default of 6
2)	After closing the Game, the workbench output is still 60Hz and the lower part of the screen is cut of because it’s a Pal screen

IanSB, 2021-01-26:
>When I start a NTSC WHDLoad Game on my Pal Amiga (for example Frontier Elite 2) it switches correctly to 60Hz. But forgot my Scanline Level (I selected 12 and saved that configuration) but when it switches to 60Hz it steps back to the default of 6

That is expected because there are separate 50Hz and 60Hz sub-profiles and it will auto select the 60Hz sub-profile when the timing changes. When a profile or sub-profile changes it loads it's own setting so you have to change the scanline level on that sub-profile and save the config. After that it should switch between the two profiles with the right scanline level.

To confirm this, look at the Sub-profile line on the main menu, it should have changed from Amiga 50Hz to Amiga 60Hz PAL

There are actuall 3 sub-profiles:
Amiga 50Hz          - normal 50Hz
Amiga 60Hz          - normal 60Hz
Amiga 60Hz PAL  - 60Hz but from a PAL amiga so it used the PAL crystal which means different timings from real NTSC

>After closing the Game, the workbench output is still 60Hz and the lower part of the screen is cut of because it’s a Pal screen

If the computer is outputting 50Hz timings it should reload the 50Hz sub-profile and revert to full screen.
When this happens, can you post a photo of the source summary option in the info menu and also let me know which sub-profile (not profile) is showing on the main menu.

SirCathal, 2021-01-28:
@IanSB
Yes you are right, I can save the settings for 50 and 60 Hz and then it works.
The other thing was a bad WHDLoad Slave. It sets NTSC but don't changed it back to PAL.
When I use the NTSC tooltype with the WHDLoad title it works correctly. Starting in Pal (Workbench) start the Game (switch to NTSC) and after exiting the game it switches back to PAL.

For me that version is great. All scanline levels work fine and without any flickering with auto resolution up to 1920x1080.

I found only one small issue with the auto resolution, but that's very special to my monitor setup.
I use a active HDMI switch and with one of that ports I connected another active HDMI switch.

If I don't select the correct input port on both switches, Auto resolution fails and I get no Picture.
I think that's because in that moment, there is no monitor to detect.
Maybe a default resolution could help in that case. But overall it's not that important.
As long as I do not test, I simply select 1440x1080 and have no Problem.

SirCathal, 2021-02-22:
@IanSB , for me the scanline topic is complete now. with your Beta16 everything works fine.
From my side you can integrate your changes into the main release

Closed 2021-03-08.

Thread 17 (2021-01-06):

BigBox Variants

nyteshade, 2021-01-06:
As I understand it, part of the problem for ECS and AGA machines is the processing power of the PiZero. I was wondering if @IanB might know if the processing power of the Pi CM4 or even a Pi4b attached to a card in a BigBox video slot might do the trick for the A2000s, A3000s and A4000 variants. The question came about after a discussion with Reinhard Grafl in which he mentioned

> OK, I get it. Looking at the schematics of the A2000 and A3000, the video slots provide all necessary signals from the (Super)Denise and power as well, so it would actually be possible to design an adapter
> that fits in there and that can also carry the Raspberry Pi. Maybe someone actually wants to make such a board.
> For the A4000, the Lisa chip still can create much too much video data do be processed by the Pi. Restricting this to OCS screen modes would be a very unsatisfying solution.

Given this, and given the Pi CM4 (Compute Module 4) and Pi4B have more the double the resources of the PiZero, I was curious if this might be a future path. Also, given the CM4's size, it might be a more viable option for the A500s and A1000s of the world.

c0pperdragon, 2021-01-07:
@IanSB  is the person to ask

c0pperdragon, 2021-01-07:
As the compute modules do not have a video output port, this is not of much use here.
I am not sure about putting a Pi4B into an Amiga case.. The power consumption is pretty high, with corrsponding heat output.
I don't know anything about the processing power and what it really takes to handle the ECS resolutions.

To truly support AGA modes with 35ns pixel clock and 24 bit color depth the total data rate must be quadruppled compared to the current software. I can not imagine this to be possible in anything like the current approach.

Closed 2021-01-15.

Thread 18 (2021-01-07):

Can we take this external?

HS-Dave, 2021-01-07:
Sorry, don't know the best place to ask questions like this.

How dependent is your daughterboard on receiving the signals from denise pins directly? Could this potentially be made to work by taking output from the RGB out on the back and feeding that into your pcb to pass to the pi creating an external upscaling solution that should work with all denise chips/a1200/etc etc anything with an rgb out? Or is it that by the time it gets to the output port the signal is analog and no good for what you're doing?

IanSB, 2021-01-07:
The exernal version already works with the CPLD version of the board:
https://github.com/hoglet67/RGBtoHDMI/wiki/Bill-of-Materials-%2812-Bit-Board%29

You simply solder a 16 way ribbon cable to the denise chip and connect to the 12 bit extender board:
https://github.com/hoglet67/RGBtoHDMI/wiki/Bill-of-Materials-%2812-Bit-Extender%29

This version should also support some of the ECS modes because the CPLD can handle higher bandwidth 6 bits per pixel sources but I don't have an Amiga with an ECS chip so I haven't been able to test that so far.

HS-Dave, 2021-01-07:
thanks for the reply Ian :) What I meant by taking it external was remove the reliance on connections directly to internals like the denise chip and instead work from the RGB provided by the RGB-Video out port that is present on (I believe) basically all amigas regardless of chipset so you could easily swap between an A500 and an A1200 for example as you wished. Although as I was thinking about it I thought the problem here was that RGB-Out provides analog RGB where this mod is working specifically on the digital signals provided by denise, so maybe its a no goer.

truthfully, I just want this mod for my AGA A1200 :)

c0pperdragon, 2021-01-07:
The analog outputs are always hard/impossible to convert back to their original digital counterparts for a pixel-perfect upscaling. Devices like the OSSC are trying to do this, but it takes quite some effort to get this working and the result may not be as perfect as a purely digital solution.

About AGA:
The pixel speed and color depth of the AGA resolutions are far beyond what can be done with this solution through the GPIO pins. An FPGA with a dedicated HDMI tranmitter chip may be the proper choice here. Of course this starts the be seriously expensive...

c0pperdragon, 2021-01-07:
@IanSB
I don't know about the ECS modes. It is not just having 4 distinct colors plus the sprites that can appear anywhere with just any color. Also the palette can change totally unexpectedly anywhere.
So the Pi would need to be able to always handle the full 12 bit color depth at 35ns pixel clock. As the software is already struggling with a 70ns pixel clock, this is surely out of reach.

HS-Dave, 2021-01-08:
At this point we are basically building a DIY indivision AGA, I guess not for much cheaper (if cheaper at all). Ahhhh, poor 1200 :(

> About AGA:
> The pixel speed and color depth of the AGA resolutions are far beyond what can be done with this solution through the GPIO pins. An FPGA with a dedicated HDMI tranmitter chip may be the proper choice here. Of course this starts the be seriously expensive...

Closed 2021-01-15.

Thread 19 (2021-01-07):

Issue with HDMI capture card

IanSB, 2021-01-07:
In his review, Jan Beta had a problem with his HDMI capture card.
The most likely cause of this is that the Pi zero is configured by default to output a DVI compatible RGB HDMI signal so that it can work with older 4:3 DVI monitors as well as more recent 16:9 HDMI monitors.

This can be changed by editing the config.txt and default_config.txt files.

Load both files into a text editor and change the following line from:
hdmi_drive=1
to
hdmi_drive=2

Then save the files back to the SD card, reinsert into the Pi zero and reboot.
(Both files have to be edited because the config.txt file is occasionally re-created from the default_config.txt file when certain settings are changed)

If that doesn't work there are other hdmi settings that can be changed in the config file detailed here:
https://www.raspberrypi.org/documentation/configuration/config-txt/video.md

The one most likely to change things is hdmi_pixel_encoding:

0 | default (RGB limited for CEA, RGB full for DMT)
1 | RGB limited (16-235)
2 | RGB full (0-255)
3 | YCbCr limited (16-235)
4 | YCbCr full (0-255)

So try adding the following line just below the "hdmi_drive=" line
hdmi_pixel_encoding=3
or
hdmi_pixel_encoding=4

If someone with the problem can confirm that changing anything from the above fixes the issue  I'll add a menu option to switch between the various modes to save having to edit the text files.

c0pperdragon, 2021-01-07:
Contacted Jan to tell him of this possible solution...

JanBeta, 2021-01-08:
Hi, thanks so much for the help!

Changing the hdmi_drive=1 option to hdmi_drive=2 instantly fixed the problem.

For reference, I use an Elgato HD 60 S USB capture card and the colors were slightly off, with black displaying as green, when capturing video from the RaspberryPi output. No matter what settings I chose for the capturing card, the issue remained the same. Changing the above in the config.txt and default_config.txt on the Pi fixed it.

Again thanks for the help and of course for the amazing work from both of you. :)

Jan

IanSB, 2021-01-08:
> Changing the hdmi_drive=1 option to hdmi_drive=2 instantly fixed the problem.

Thanks for the confirmation
I've added a new "HDMI Mode" setting in the main menu with options:
DVI Compatible
HDMI (Auto RGB/YUV)
HDMI (RGB Limited)
HDMI (RGB Full)
HDMI (YUV Limited)
HDMI (YUV Full)

It will still default to DVI Compatible on first install as that ensures you get an image on all monitors.
If you change the setting to one of the HDMI options you will lose output on a DVI monitor. To recover from that you have to hold the button down during power up which will reset it back to DVI Compatible mode.

There will be a new release shortly with that and some other updates.
BTW to make it easier to update the software or retrieve screencaps (short presses of the switch screencap the image to a png file and write it to the SD card) you can use a micro SD extender and route that to the trapdoor on the A500 so you don't have to completely dismantle the Amiga.
e.g.
https://www.ebay.co.uk/itm/Micro-SD-To-TF-Card-Extension-Cable-Flexible-Extender-Adapter-Reader-Phone-UK-ti/383835410420
Check your local ebay for a suitable supplier.

IanSB, 2021-01-10:
@JanBeta

There is a beta test version here with the above HDMI setting:
https://github.com/IanSB/RGBtoHDMI/releases/download/fdbf4a4/beta9.zip

This also has support for basic scanlines with the Amiga (They previously only worked at lower bit depths) although the level is not adjustable so they can only be black.
There is a setting in the preferences menu which now works with the Amiga:
"Swap Aspect 625<>525"
When set to "on" it changes the aspect ratio of the output to mimic the aspect ratio of the other standard which means that any Amiga games which were written for 525 Amigas can be displayed at full height 525 aspect ratio on a 625 line Amiga.
e.g:
Normal:
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
Swap Aspect set to "on":
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

Let me know if it works for you.

IanSB, 2021-01-10:
@JanBeta

Updated to beta10 due to cache alignment timing issue:
https://github.com/IanSB/RGBtoHDMI/releases/download/626a527/beta10.zip

JanBeta, 2021-01-15:
Thanks for the updates! Tested the linked beta10 for some hours and everything seems to work as expected.

The 625/525 switching seemed to revert back sometimes (could only reproduce it once) when the software switched resolutions (I used Giana Sisters, title screen is interlaced, the rest is regular lo-res). Most of the times it worked without any problems.

The scanlines worked for me, too. Only tried it in low resolution though.

The slight flicker/sudden appearance of lines on the screen has completely disappeared (probably the timing fix you mentioned?), picture is rock stable and smooth now.

Switching HDMI modes works flawlessly. Video capture works without any problems in all screen modes, output directly to a monitor still works fine, too.

Made a little update video on my channel, too: https://youtu.be/9baCd5O2nG4

Thanks again for your amazing work! :)

IanSB, 2021-01-15:
@JanBeta

>The slight flicker/sudden appearance of lines on the screen has completely disappeared (probably the timing fix you mentioned?), picture is rock stable and smooth now.

Yes there was a change to fix that. It only showed up on 1920x1080 screens and I have been mostly testing with a 1600x1200 monitor so I missed it.

>The 625/525 switching seemed to revert back sometimes (could only reproduce it once)

That is probably caused by the Auto Sub-profile switching.

There are two types of profile: Single profiles and Sub-Profile Sets, both stored in /profiles/Simple on the SD card.

Single profiles are stored as single .txt files and Profile Sets are stored as folders containing multiple .txt files (These are shown in the "Sub-profile" line.)

The profile sets were initially added to support auto PC mode switching from CGA to EGA etc and the profile that matches the incoming sync signals is auto selected from the files in the folder but they are also used to store both PAL and NTSC profiles for some computers like the Amiga so the correct profile will be auto loaded when connected.

Whenever the sync timing changes, the software scans the sub-profiles and reloads the correct one overwriting your temporary setting and switching on/off interlace probably caused enough of a sync timing change to trigger that.

One workaround is to save the configuration after turning on the option as it will then re-load the saved config instead of the original but that setting will then persist until you restore default config.

Another workaround is to set "Auto Switch" from "Sub-Profile" to Off which will allow manual selection of the Sub-Profile and stop the auto loading from overwriting your setting. (Note the first press will set Auto Switch to "BBC Mode7" which is used by the BBC micro and that will make the screen go a bit crazy until you press again).

It should be possible to fix this properly by checking to see if the same profile is being reloaded again and only reload if the profile is different.

Thread 20 (2021-01-10):

Feature-Request: Audio IN to HDMI

ZuiMelanieForno, 2021-01-10:
Hello.

Are all RaspberryPi Zero Pins already in Use?
If not, could two Pin´s be used to get, the Audio-Analog-Signal into the HDMI signal?

If not Analog? then maybe the DAC out pins for Left and Right?

And of course if no Pins are free on the RPi  maybe an Interrupt-based Audio signal "insertion" on the next iteration of the PCB?

I am very Far away of Electronics-Engineering but maybe it is a tiny suggestion.

 c.u. Zui from Hamburg Germany.

c0pperdragon, 2021-01-10:
As far as I know audio support is not easily possible with the way the RGBtoHDMI software works. This is basically a bare-metal program using a very tight machine code routine to sample the data from the GPIO pins. Interrupts would totally mess up everything.

ZuiMelanieForno, 2021-01-10:
@c0pperdragon OK got it, and thank You for the reply.

I saw on the Schematics of the Amiga 500 the Paula-Chip would be the Audio DAC, and it is in the proximity of the Denise-Chip.

The idea of a Interrupt based solution is not achievable. (Check or better Uncheck)

About free GPIO Pins on the RPi if I see it right there are free Pins.

Maybe a additional circuit could be added to the PCB.

I found a DAC based on the PCM5102, it needs only 5 PIN´s to connect to a RPi-Zero.

How to get a Signal from the Paula-Chip I dunno...

Is it allowed to place here a Weblink?

[https://raspberrypi.stackexchange.com/questions/76188/how-to-make-pcm5102-dac-work-on-raspberry-pi-zerow](url)

This is what I found.

Do I remember it correct that Amiga-Audio is 14bit per Channel?

I gonna try to work on it, and gonna try to get into Amiga back again.

What a Hobby...

c.u. Zui

RobSmithDev, 2021-01-11:
Might be easier (although not as clean) to add something like this to the HDMI output from the pi, and add the audio through this.

https://www.amazon.co.uk/gp/product/B01B5FR7PY

Unless theres some kind of similar IC that could do the sampling and add it to the signal I cant see the PI having time to do it without messing up the timings.  Does make me wonder whats inside this though, and weather that could be included in the adapter board somehow.

c0pperdragon, 2021-01-11:
Overall, I am quite reluctant to touch anything that has to do with audio. Opposed to a digital video solution that can actually achieve true perfection, the quality of audio so much a matter of subjective opinion.
I am absolutely sure that whatever anyone can come up with will never be good enough.
Also converting the analog audio signal from the Paula chip to digital HDMI and later back to analog again will surely not help the quality.

c0pperdragon, 2021-01-11:
@ZuiMelanieForno
This DAC chip does not help (making the Pi output analog audio). We would need some ADC to make the Pi _input_ analog audio to add to its HDMI stream. Also it needs to work with the bare-metal solution without messing up all the (already super-tight) program timings.

ryanm101, 2021-01-14:
Might be naive here but does HDMI use separate lines for audio?  It would require an adaptor board but having something just disconnect the audio lines from the pi and provide them from a separate source (kind-of a breakout board / same way PoE injection would work with RJ45). You'd still need ADC but it would be straight from the phono connectors to the HDMI lines.

c0pperdragon, 2021-01-14:
No, HDMI provides audio data digitally and time-multiplexed with the video signal.

c0pperdragon, 2021-01-18:
Due to continuing interst in this top, I reopen this issue.
But I can not do anything about this myself as this is completely on the software side of the RGBtoHDMI project.
Mayme @IanSB can share his opinion on this matter.

ZuiMelanieForno, 2021-01-18:
Thank You for reopening this Issue. :)

I will suggest and ask for a "Proof of Concept" thingie at IanSB´s Project.

I installed KiCad for that Matter...

c.u. Zui

ZuiMelanieForno, 2021-01-22:
Hi, Amigians and Amigianas...

I opened a new Issue at the [RGBtoHDMI-Repository](https://github.com/hoglet67/RGBtoHDMI).

[Proof Of Concept: Audio Signals into HDMI-Output (Muxing) #177](https://github.com/hoglet67/RGBtoHDMI/issues/177)

Maybe that will help... Somehow?

c.u. Zui

ZuiMelanieForno, 2021-01-30:
Hello.

I ordered two Raspberry Pi Pico Microcontrollers.

They have 3 Pins for Analog Input.
Maybe it could work out of the Box, but i assume there will be some extra Ciruit to make an Audio-Grabber.
When (If) I can get a decent Input, I will try to couple that with the RPi Zero to see if I can get somehow a Network of I²c or such... :)

@JanBeta is willing to help, and if he can find the Time he will do a Oscilloscope Read of the Audio Pin´s.

So, stay tuned on 44.1 kHz for more Audio ;)

c.u. Zui

This is the same Comment like in this Isssue:
https://github.com/hoglet67/RGBtoHDMI/issues/177

Thread 21 (2021-01-15):

General discussion 2

c0pperdragon, 2021-01-15:
Continuation of https://github.com/c0pperdragon/Amiga-Digital-Video/issues/1

culexus8, 2021-01-15:
Do you see some minor flickering on wb? On my 600 it is really good in games but I see some noise arround icons/Windows/edges, I will try to do some changes with how I wire it up. Shortsen cable try a other power source just to eliminate some stuff to see if the might give any changes.

c0pperdragon, 2021-01-15:
I have just created a specific A600 thread. https://github.com/c0pperdragon/Amiga-Digital-Video/issues/22

LemaruX, 2021-01-19:
Has anyone measured how much current this draws with the Pi connected?

Pete-Cooper, 2021-01-19:
Im testing my first board (ordered from JLPCB with all the surface mount components placed) and I'm getting a flashing screen on the load workbench screen. It looks good but flashes every few seconds. If I open the menu the flashing stops. There's also a thick black line towards the bottom of the screen. Is this a setting mismatch or do I need to troubleshoot my hardware?

IanSB, 2021-01-19:
@Pete-Cooper

Flashing means that no timing profile is matched. The download linked on the info page doesn't support NTSC so if you are running an NTSC machine that would explain it.
The latest beta does support NTSC but it is untested:
https://github.com/IanSB/RGBtoHDMI/releases/tag/3a23a05

Pete-Cooper, 2021-01-19:
@IanSB thank you! That beta did indeed fix my issue. I haven't had a chance to really test but it fixed the load workbench screen and monkey island, that is all I was able to test before work.

IanSB, 2021-01-22:
@Pete-Cooper

That beta had the wrong aspect ratio set for NTSC profiles so here is an updated beta14 with that fixed:

https://github.com/IanSB/RGBtoHDMI/releases

bw21p25, 2021-01-27:
@IanSB Yes, that aspect ratio looks better, thank you! Ordering the bluepill to integrate FF OSD next.

ilmarkve, 2021-01-31:
When using this device, can I use Raspberry Pi Zero's TV out pins to get a composite video signal?

c0pperdragon, 2021-01-31:
I guess this should in theory be possible when the software is prepared for that.  @IanSB is the expert on that.
Maybe you could do that  by patching the config.txt onthe SDcard in some way.

Of course the big question still remains:  Why?
Composite video has such a poor quality in comparision that this seems to be totally besides the point.

ilmarkve, 2021-01-31:
I know it's besides the point but being able to replace the original monochrome composite output with a colored one would be a nice bonus.

abrugsch, 2021-02-01:
Slightly off topic, but what is the 1-chip memory expansion in [this picture](https://github.com/c0pperdragon/Amiga-Digital-Video/blob/master/installation/cabling.jpg)?

c0pperdragon, 2021-02-01:
I forgot where I got this expansion from. But it is actually working great. It is also compatible with the 1 MB chip ram modification for my particular main board.

ilmarkve, 2021-02-02:
Looks like it's from sordan.ie. They no longer have that specific model in stock and I guess it has been replaced by this: https://sordan.ie/product/637/amiga-500-500-512kb-05mb-trapdoor-ram-memory-expansion/

Nicebrook, 2021-02-17:
How do I get i touch with you c0pperdragon? I can't find your email?

c0pperdragon, 2021-02-17:
Just look at the bottom of the project main page.

Thread 22 (2021-01-15):

A600 and other constrainted installation

c0pperdragon, 2021-01-15:
This thread is intended for discussions on how to get machines working with the generic small adapter board.
I don't intend to actually build such boards, as it should be fairly easy for anyone experienced enough to also do the rest of the installation.
I encourage the use of this thread as a means of communication to help each other with difficult installs and maybe to source parts or PCBs in a more cost-effective way.

c0pperdragon, 2021-01-15:
If you have flickering pixels this may mean the color signals change too closely to the edge transistions of the clock. Try ot use a different clock source that has some phase shift.

culexus8, 2021-01-15:
Found the issue, my ground wire was to long so after shortening it the picture got stable.

c0pperdragon, 2021-01-16:
Hmm. If just varying the ground connection fixes this, I think this is now just a lucky coincidence that the signal timings match up. Next week it very well may become fluky again.

If you happen to have an oscilloscope, you could check the relation between your clock signal flanks and the point where the color lines change voltages.  There should be a significant time offset between these points (ideally 35ns, but anything about 15ns should also be OK):

culexus8, 2021-01-16:
Well remember that im using motherboard that is not in good shape, it needs recap and also my power supply is not god. I see 4.6v on the raspberry so there is allot to fix before I will do any check with the scope. I will orde a new quality power supply from icomp so I know I will have stable 5v and low ripple. And then I will do the install in a known good system. If I get problems then I will look more into it.

culexus8, 2021-01-17:
Testing out where to place the board and RPi zero. My Main problem is now to get a mini hdmi to hdmi that will fit inside. There is not allot of room:/
I had to drill two 2mm holes for the screws to hold the board, but is not a big deal I think. If anyone have a link for a mini hdmi male to hdmiA female that is slim and flexible please give me a hint🙂

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

Rakeim132, 2021-01-17:
On the A600, the memory extension A604 carries all information required as it is used for some flicker fixer cards. The adapter could be designed to fit neatly in it..?

culexus8, 2021-01-17:
You May be total correct, that would have been a sweet option to add it to ram board🙂 I need to look into that👍

culexus8, 2021-01-17:
Looks like indivison is using some other signals to produce video:/ I can`t fint the same points on the a604n. would have been a brilliant solution. But if somone sees it yeah then please tell :)

c0pperdragon, 2021-01-17:
The RGBtoHDMI solution depends on the Denise chip to generate the RGB colors for each individual pixel. As far as I can see in the schematics of the A600, this information is only passed on to the analog video circuitry, but not to the expansion port.

Eriond, 2021-01-19:
The Indivision (and possibly some other "flickerfixers") recreate the circuitry of the Denise. By listening to the Agnus-Denise communication on the RGA-bus which is exposed on the A600 memory expansion connector, and by intercepting the actual fetching of graphics data from the chip memory, you could build an equivalent (digital) graphic output from within the memexp bay. But IMHO if you'd go to all that trouble, why not make something more?

Rakeim132, 2021-01-19:
@Eriond: very interesting and totally understandable, mate.
Sorry guys, I thought it was an easier path and a good idea.

culexus8, 2021-01-24:
Some updates on the A600 ver1.5 install.
It is now finally working 100% with the latest Beta 15 no added settings or changes to the software settings. I had some small issues with flickering in the picture before I found the error. The adapter board I use (small) have the 5V power supply directly into the GPIO and the raspberry do the voltage regulation for 3.3V back to the logic`s on the adapter board. This may have given the flickering I had issu with. So my fix was to power the raspberry pi board trough the normal usb micro port, flickering was then history :)

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

I have also done some 3D printing to get the install compact and not interfere with any other expansion cards, the hdmi is right under the board where the RF-modulator normaly placed so you have a easy way of hooking it up :) Just the same stuff they use to do on any vampire install.

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

I will go trough my install and make the 3D files available for download and also a step by step guide if there is interest.
The install is not hard and is reversible if you need to. Tested on rev1.3 and rev1.5.....

Thank you c0pperdragon and IanSB for this amazing stuff :)

c0pperdragon, 2021-01-24:
That is a pretty neat install. Congratulations!

One thing still bothers me a bit: To get rid of the flickery pixels, you basically just fiddled around with the power supply and ground a bit. I don't think this was the true cause of the problem, but it just now seems to work more or less by accident.

If you want to provide a stable solution that will reliably work for other users as well, I would suggest to do some measurements first. If you have an oscilloscope, you really should check in which relation the edges of the clock signal are to the edges of the color signals.

culexus8, 2021-01-24:
I do have a scope but I do not understand to much of it hehe. I will contact you by e-mail if it is okay and try to find a solution.

seb132, 2021-01-26:
@**culexu8**: nice job, really... Do you have all ECS modes working ?
@c0pperdragon: could it be possible to have in the description the list of the original video modes that are managed without issue?
I'm struggling to understand the current limitations with ECS, if any...

c0pperdragon, 2021-01-26:
I added an explanation of the OCS screen modes to the documentation.
Note that this restriction applies to all adapter versions - it is a fundamental limitation of this Raspberry Pi - solution.

culexus8, 2021-01-26:
Seb132: thanx🙂 I have not teste allot but I do use high res laced pal on the wb and all the standard games do work good so far. Can't find any issue with this solution. My biggest problem must be that my furia is not as stable as I was hoping for. But this have no thing to do with the hdmi install🙂

sonic2k16, 2021-02-01:
How many layers is the PCB...

culexus8, 2021-02-01:
> How many layers is the PCB...

Ismt is two layers.

Sebretro, 2021-02-08:
Hi I would really like a small guide and 3d files if you will share. I am waiting for the boards from C0pperdragon and are now trying to find the components in my neck of the woods.

sonic2k16, 2021-02-08:
How can I through KiCad get MPN from a project (manufacturer part number = component identification code) from a CSV file (BOM).
Thank you.

samowitsch, 2021-02-10:
Hi. I have a Minimig an wanna try to get RGB2HDMI working with it. In the picture below you can see the RGB locations as well as the HSYNC and VSYNC. Can i use theoretically HSYNC for SYNC and VSYNC for CLOCK? I am a little bit confused about different naming.
THX and Regards
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

c0pperdragon, 2021-02-10:
For the standard Pi software to work you need a CSYNC input (which is a kind of combination of HSYNC and VSYNC). I don't know if this is available on the minimig somewhere.  Otherwise the Pi software needs to be modified.
Also you must have some system clock (7.1 MHz) to feed into the adapter to correctly sample the pixels.

samowitsch, 2021-02-11:
@c0pperdragon thx for info. i will investigate. Thats the signals that are coming directly out of the FPGA of the Minimig. There is no CSYNC. A system clock should be some where at the board.

IanSB, 2021-02-11:
@samowitsch
I just had a look at the minimig rev 1 schematic and you can certainly use the RGB bits and Hync (which is composite sync in 15Khz mode) but you would also need a pixel clock signal which probably only exists internally in the FPGA  (It's actually pixel clock divided by 2 so 7 Mhz for a 14 Mhz pixel clock etc.).

If you can modify the FPGA code you could change it to output the pixel clock on the Vsync pin.

Other than that you could use the CPLD version of RGBtoHDMI as that only requires the 12 bits and sync because it re-creates the pixel clock in the CPLD.

samowitsch, 2021-02-12:
> If you can modify the FPGA code you could change it to output the pixel clock on the Vsync pin.

@IanSB Thats far beyond my skills ;o)

culexus8, 2021-02-15:
> Hi I would really like a small guide and 3d files if you will share. I am waiting for the boards from C0pperdragon and are now trying to find the components in my neck of the woods.

Hi, yes I will free the 3D files when I get the time to finish them and they are at a final stand point. Not shure where I will upload them but I will update here.

solarmon, 2021-02-17:
Hi, a question regarding the connection diagram. For CLK it shows it to take it from pin 2 of (unpopulated) C201. Is this not yhe 7Mhz signal? Looking at the board schematic I thought CLK should be taken from the _CDAC signal? Or am I reading it wrong?

c0pperdragon, 2021-02-17:
The CDAC in the schematics is actually a misnomer. On the silk screen, I have re-named it to the generic term CLK. Into this you need to feed either ther CDAC signal when running with a OCS Denise, or the 7Mhz signal when running with a SuperDenise.
For a A600 taking the 7Mhz is just fine. In this case you also need to close the solder bridge JPIN1 to get the correct polarity of the clock signal.

solarmon, 2021-02-17:
@c0pperdragon I'm looking to make a RGBtoHDMI board, based on your small board, that fits directly on Denise with a PLCC socket.

In that case, then should I just do away with JPINV1 jumper (and connect directly to +3.3V); and connect the 7M signal instead of CDAC?

ryanm101, 2021-02-18:
Works for Rev 1.1 (A300 June Bug) as well

> 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

samowitsch, 2021-02-18:
> Other than that you could use the CPLD version of RGBtoHDMI as that only requires the 12 bits and sync because it re-creates the pixel clock in the CPLD.

@IanSB you mean this thingy here?: https://github.com/hoglet67/RGBtoHDMI/wiki/Bill-of-Materials-%2812-Bit-Board%29

solarmon, 2021-02-19:
@c0pperdragon If I remove JPINV1 and connect directly to +3.3V, then is R2 and the connection to GND is really needed? Does it really serve any purpose in this situation? If I can remove it then that will reduce the component count.

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

c0pperdragon, 2021-02-20:
You would not need the pull-down resistor in this case.

solarmon, 2021-02-20:
@c0pperdragon Thank you for confirming that - that is what I thought.

I'm currently working on this Denise PLCC socket based board. I still need to test and confirm the PLCC-68 socket and pinouts.

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

The Pi would then sit on the board as such:

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

solarmon, 2021-02-20:
Looks like I made a major mistake. I used a PLCC-68 footprint, instead of a PLCC-52 one. What an idiot! 🙄

culexus8, 2021-02-20:
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

Is this for the A600? looks like a nice design :)

solarmon, 2021-02-20:
@culexus8 Yes, it is meant to fit over the A600 Denise PLCC chip.

I've now corrected the design to use a PLCC-52 socket:

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

However, it will probably spoil with any memory and CPU board, depending on its design.

But until I get a test build, I don't know whether it will spoil with any other A600 motherboard components.

nyteshade, 2021-02-24:
Any ideas if the constrained installation will be needed in the A3000 or if the regular RGB2HDMI solution would work there?

nyteshade, 2021-02-24:
What about the A1000?

Sebretro, 2021-02-24:
HI. How do I get a parts list from the files? I can find the IC numbers in the pdf and also the resistance and capacitance values of the R And C components but not voltage ratings and form factors/size if that is an issue. This is my first time following a project in git hub so please excuse if the question is stupid. But I have done  some soldering, fixing stuff. And also recapped my A600 so I am not completely lost.

c0pperdragon, 2021-02-26:
I don't have a specific parts list. Just use the ICs in a SOIC package (the largest SMD there is), and all passives are 0805 (imperial). Voltage rating is basically irrelevant when it is at least 10V for the capacitors.

ryanm101, 2021-02-26:
@Sebretro

10.0 | 74LVC86AD,112 | NEXPERIA | NEXPERIA  Logic IC, XOR (Exclusive OR), Quad, 2 Inputs, 14 Pins, SOIC, 74LVC86
-- | -- | -- | --
20.0 | 74LVC574AD,118 | NEXPERIA | NEXPERIA  Flip-Flop, 74LVC574A, D, 17 ns, 200 MHz, SOIC
10.0 | CGA4J1X5R1C106K125AC | TDK | TDK  SMD Multilayer Ceramic Capacitor, 10 µF, 16 V, 0805 [2012 Metric], ± 10%, X5R, CGA Series
30.0 | 08051C104KAT2A | AVX | AVX  SMD Multilayer Ceramic Capacitor, 0.1 µF, 100 V, 0805 [2012 Metric], ± 10%, X7R
10.0 | MCWR08X3301FTL | MULTICOMP PRO | MULTICOMP PRO  SMD Chip Resistor, 3.3 kohm, ± 1%, 125 mW, 0805 [2012 Metric], Thick Film, General Purpose
10.0 | WR08X1002FTL | WALSIN | WALSIN  SMD Chip Resistor, 10 kohm, ± 1%, 125 mW, 0805 [2012 Metric], Thick Film, General Purpose

Sebretro, 2021-02-26:
Thanks for the info. I have a slight problem I can only find these 574 locally here in Sweden.
SN74HC574DWR 28Mhz
74HC574D 133 MHz

Will any off them work or do I need the lvc version?
Everything else was available and to buy just this chip from mouser, or such, will have a silly overhead cost. Any pointers for where I can get it from a EU online shop? Thank you all.

c0pperdragon, 2021-02-27:
These HC parts are not the correct ones, as they can not work as voltage level shifters.
Instead of LVC you could use LCX as they have very similar characteristics. But I guess these are equally hard to get.

ryanm101, 2021-02-27:
@c0pperdragon what is the risk there I tested these and they worked on mine?

ryanm101, 2021-03-01:
@Sebretro if @c0pperdragon doesn't mind / have any, i've some extra so if you are just looking 1-2 I could help you out.. you can email me at (pvtryan 100) (-at-) gmail com.

Sebretro, 2021-03-05:
Oh to bad didn't se your reply untill now. Somehow the email notification switched off. I already ordered some from the US. Gave me a reason to fill upp the order with a hot air rework station. Just to get free shipping. 😀. Your offer is highly appreciated. In a few days I will also have some extra lvc574 so same offer from me to anyone in Sweden or Europe.

krug3rf, 2021-03-16:
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

Hi @culexus8
on rev1.5 the soldering schema is the same like rev1.3 ?

culexus8, 2021-03-17:
It is, there is no difference from 1.3 to 1.5 so Just follow the same steps.  :)

seb132, 2021-03-17:
@**solarmon**: no chance that your design works with ANY A600 accelerator, unfortunately.
Even any Fast Ram board I'm afraid as most of them clip on the 68000.

krug3rf, 2021-03-17:
> It is, there is no difference from 1.3 to 1.5 so Just follow the same steps. :)

thx
Ok so the 3.3v for the Pi0 is not mandatory and we must use the 5v from R406 directly connected to the RGBtoiHDMI PCB.

solarmon, 2021-03-17:
> @**solarmon**: no chance that your design works with ANY A600 accelerator, unfortunately.
> Even any Fast Ram board I'm afraid as most of them clip on the 68000.

There is one that I'm aware of that should be compatible - the A608:

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

But yes, most of the others will not be suitable. This is more of a learning exercise for me.

culexus8, 2021-03-17:
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

You can power the board just like you want :) you do not need to use the 5v from the R406, you can take 5V from some other place also. It is up to you. I even powered my board with an usb cable from the floppy connector. the 3.3 will be taken from the Pi0.

solarmon, 2021-03-17:
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

@culexus8

The RGBtoHDMI board needs to fed 5V so that it can feed the Pi0. There is then a 5V to 3.3V regulator on the Pi0 which feeds the components on it. Asking  "3.3V for the Pi0 is not mandatory" does not make sense.

culexus8, 2021-03-17:
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

I might test this one day, :) just need some more ram and will be a perfect option.
https://github.com/PR77/A600_ACCEL_RAM

krug3rf, 2021-03-22:
Thanks all for tour help 👍
![Uploading IMG_20210321_215906.jpg…]()

Osmund, 2021-03-24:
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

Looks great. Is the stl file available for download?

ryanm101, 2021-03-24:
Has there been a change? https://github.com/c0pperdragon/Amiga-Digital-Video/blob/master/smallkit/README.md mentions 3k3 res for R1/R2 but schematics say R2 should be 10K.

culexus8, 2021-03-24:
> Has there been a change? https://github.com/c0pperdragon/Amiga-Digital-Video/blob/master/smallkit/README.md mentions 3k3 res for R1/R2 but schematics say R2 should be 10K.

I use 3k3 for R1 and 10K for R2 as the schematics say.

c0pperdragon, 2021-03-24:
I just wanted to keep the number of different values down  For the R2 the exact value is quite irrelevant. Just sone weak pull- up

ryanm101, 2021-03-25:
Ah fair enough

krug3rf, 2021-03-25:
@Osmund
> Looks great. Is the stl file available for download?

Thx :)
Available [here ](https://cults3d.com/fr/utilisateurs/krug3r/cr%C3%A9ations)

kulamario, 2021-03-28:
I have an amige 600, I made an adapter for denise, so I have signals straight from denise
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
Unfortunately, the system does not work as it should at the beginning, everything jumped
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
So I disconnected the SYNC signal from denise and connected to the resistor as in the photo, which gave me a stable image, but the colors are not good
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

do you have any advice for me?

c0pperdragon, 2021-03-29:
The whole problem with all those jittery/sparkly artefacts for various solutions comes down to signal timing.
The adapter needs to reliably capture the state of the color and CSYNC signals two times per system clock, basically on the rising and the falling edges of the clock line. With different denise versions you may or my not be able to cleanly capture these data.

Using the signals on U31 and U32 seem to have just the right delay to nicely match up with the clock edges when you wire up everything as shown in the top picture of this thread.
If you want to bypass the buffers U31 and U32, you may need to clock the board  with a different signal. As the denise in your machine has a second clock input that is phase shifted by 90 degrees, you could try to use this one instead and see if that works.

The problem with the colors is probably unrelated and is either an unconnected/shorted pin or you just mixed up something in your PCB.

c0pperdragon, 2021-03-29:
After a second look at your garbled screen, I now guess that you have just mixed up the CSYNC and G3 lines. This would explain the green background that is broken by this black parts, which are likely the horizontal sync pulses.

iokaravas, 2021-04-01:
Thank you all for your awesome work, I think I'll be attempting to add the RGB HDMI to my A600 as well. I've 3d-printed the base, got my Pi ready and waiting for the parts. I'm bad at cabling so I prepared a few cable labels for myself, but you might find it useful too :)

[Amiga_Digital_Video_Labels_A600.pdf](https://github.com/c0pperdragon/Amiga-Digital-Video/files/6242808/Amiga_Digital_Video_Labels_A600.pdf)

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

krug3rf, 2021-04-01:
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

prefer use 30AWG wires, if you can ;)
[https://ae01.alicdn.com/kf/HTB1UGmiMVXXXXbrXVXXq6xXFXXXU/10-Meters-lot-30AWG-Flexible-Silicone-Wire-RC-Cable-30AWG-11-0-08TS-OD-1-2mm.jpg](url)

krug3rf, 2021-04-01:
> Thank you all for your awesome work, I think I'll be attempting to add the RGB HDMI to my A600 as well. I've 3d-printed the base, got my Pi ready and waiting for the parts. I'm bad at cabling so I prepared a few cable labels for myself, but you might find it useful too :)
>

Prefer use 30AWG wires, if you can ;)
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

iokaravas, 2021-04-01:
Sure! Thanks :)

kulamario, 2021-04-05:
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

Do you have plans for do properly a600 adapter ?

c0pperdragon, 2021-04-06:
@kulamario
I would really like to know if my previous guess, that you just mixed up the CSYNC and G3 lines, was correct.

kulamario, 2021-04-06:
> @kulamario
> I would really like to know if my previous guess, that you just mixed up the CSYNC and G3 lines, was correct.

On multimeter beep not show any short

solarmon, 2021-04-06:
@kulamario Can you share your Denise pinouts - the symbol and footprint. On my Denise PLCC hat design, I spent ages trying to get it right and had to revise it several times. But I've still to receive my PCB and to test it though.

kulamario, 2021-04-07:
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

kulamario, 2021-04-07:
I have different library like you odd numbers of pins is wrong

solarmon, 2021-04-07:
@kulamario

Well, I've still to get my PCBs and test my design - so I can't say yet 100% that whether my pinouts are right or wrong. But there's a difference, so one of us is going to be wrong!

solarmon, 2021-04-09:
@kulamario

I just tested my design and the pinouts seems to be correct and it is working, without any pixel sparkles or other issues.

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

kulamario, 2021-04-09:
so my library in eagle is bad
can you share this what you done?

solarmon, 2021-04-09:
@kulamario

I use KiCAD. The symbol of Denise is not the issue. The problem is likely to be with the PLCC footprint in the board layout.

You probably just flipped the through hole pins, but it is there is a bit more to it to get the right pin number for the PLCC hat.

You can see in my picture of my PLCC footprint, the pin numbering I had calculated it to be. You need to change your footprint used in Eagle to match this and the pinouts should be then correct.

kulamario, 2021-04-09:
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

I know I can change lib but dnt know how

krug3rf, 2021-04-09:
@solarmon great job for the PCB ! Do you think to share it ?

solarmon, 2021-04-10:
@krug3rf @kulamario I've put my KiCAD design files at:

https://github.com/solarmon/RGBtoHDMI

iokaravas, 2021-05-02:
So managed to wire up everything as in the first picture! It works!
Setting it to PALHiRes I'm getting garbled pixels / lines at various places on the screen...

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

c0pperdragon, 2021-05-03:
Your wires look really extremely long. This might easily be
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

Thread 23 (2021-01-16):

Audio output on  - Please reopen issue #20

Crushless, 2021-01-16:
First, thank you for this cool project, and all the effort you put into, but please consider to reopen issue #20 (Audio IN to HDMI).
Yes, I know the code is bare metal and already tight, but probably there is just enough time to read some samples from an i2c connected ADC in the horizontal and vertical blanking intervals and insert them in the HDMI stream. Audio quality should not be such an big issue, because the sample rate has only to be slightly higher than double the output rate of Paula (see Nyquist–Shannon sampling theorem) to get decent quality.
Relaying on an external solution (HDMI audio inserter) is both inelegant and cumbersome, when the Raspberry Pi could just insert the audio itself in the first place.

ZuiMelanieForno, 2021-01-18:
Hi @all

I maybe missed to explain the Request in the issue #20.

What I assumed is to mix the Audio (digital signal´s) from the **Paula Chip (Pin 30 for the Right Channel, Pin 31 for the Left Channel)** into the HDMI-Output-Signal.

What I saw are some free Pin´s on the Raspberry Pi Zero GPIO Pin´s, which are not connected,
and could be used for that Purpose.

If needed maybe extending the PCB to some more Logic (IC² ?) or do a secondary PCB with the same Passthru idea of using
an in between Socket.

I will try to get my Amiga 2000 to run again, and mybe I can get an Oscilloscope rented,
to get an Idea of the Paula-Chip Pin´s 30 and 31 Signals.

Like Paul Shannon was Juggling in his Past (I was a Juggler in my younger Days), we should try to Juggle in the Audio, it is just a case of Cascading... 🔢

Please dear @c0pperdragon reconsider a "Audio Signal Muxing".

c0pperdragon, 2021-01-18:
Reopened #20

Closed 2021-01-18.

Thread 24 (2021-01-17):

I need the BOM

UnaClocker, 2021-01-17:
I can't seem to find the BOM for the Denise adapter board. I downloaded the gerbers, and had a set of boards made at OSHPark. Got a BOM file for those of us soldering the thing together ourselves? Maybe I'm missing it.

Tom-PCB, 2021-01-17:
[amiga_bom.xlsx](https://github.com/c0pperdragon/Amiga-Digital-Video/files/5825610/amiga_bom.xlsx)
[amiga_cpl.xlsx](https://github.com/c0pperdragon/Amiga-Digital-Video/files/5825611/amiga_cpl.xlsx)

files are made for "JLCPCB"  to maufacture the PCB and solder the SMD parts

https://cart.jlcpcb.com/quote?orderType=1

c68696c66, 2021-01-17:
The V2 bom is available, see https://github.com/c0pperdragon/Amiga-Digital-Video/issues/15#issuecomment-761044838
-> https://github.com/c0pperdragon/RGBtoHDMI/blob/master/kicad_AmigaAdapter/V2/deniseadapter_bom.ods

ryanm101, 2021-01-20:
@c0pperdragon what is the BOM for the small board? (mainly after the footprint of the resistors / caps)

c0pperdragon, 2021-01-20:
The passives are all 0805.

ryanm101, 2021-01-20:
thanks

Closed 2021-01-26.

Thread 25 (2021-01-21):

Lag measurement

IanSB, 2021-01-21:
There have been quite a few questions about the lag of the RGBtoHDMI software. The theoretical lag is around 3.4 milliseconds which is the software timing difference between the computer's vertical sync pulse and the HDMI output's vertical sync pulse. It used to be a little lower but I had to increase it by around 1 millisecond to avoid tears when using the aspect ratio conversion and some other settings.

I  also measured it using an oscilloscope as follows:

I connected a HDMI to VGA converter to the output of the Pi to give an analog output and then displayed flashing white frames on the source computer, one frame of white followed by 7 frames of black (the VGA converter I was using had minimal lag). I then connected the computer's green output and the VGA converter's green output to the oscilloscope with the following results:

This shows 4 flash frames. Yellow is the source computer and cyan is the output of the Pi zero via the VGA converter.
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

Looking at this in closeup shows a difference of 3.6 milliseconds which is very close to the theoretical value above. The additional lag is likely due to the  integer scaling in the Pi's scaler and the VGA converter.
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

The lag will vary by a small amount depending on the source computer's refresh rate and the scaling settings (maybe plus or minus half a millisecond). It will also increase significantly when the menus are on screen because normally the data is sent so fast to the HDMI port there isn't enough time to draw a menu over it so to get the text on screen a delay has to be introduced to allow time to actually draw the text on top of the video although that doesn't really matter as you won't be playing games with the menus on screen.

c0pperdragon, 2021-01-23:
For lag measurement to this precision at also makes a difference on which part of the screen the measurement is done.
The original analog signal (lets only consider PAL here) has a line frequency of 15625.
A standard digital 1920x1080x50 signal has a line frequency of 56250 which means it will show 14062 inputs lines per second (when quadrupling the lines). So the digital signal will have an added lag of 7us on every scan line further down.
So the lag should be about 1.8ms higher if measured on the bottom of the screen than when measured at the top of the screen.
For different output resolutions this would also vary a bit.

You can easily make the comparision by creating a very slim blinking rectangle either at the top or at the bottom.

Closed 2021-02-28.

Thread 26 (2021-01-21):

OSD does not work, internal gotek

JosipBasic, 2021-01-21:
Hi,
I have this internal gotek and OSD does not work, over RGB cable it is ok.
https://www.sellmyretro.com/offer/details/amigotek-ff-osd-39893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

Any solution maybe?

mariuszk911, 2021-01-22:
I assume it will never work, as signals from gotek are connected to analog RED and CSYNC (after VIDIOT).

IanSB, 2021-01-22:
>Any solution maybe?

Maybe...

There are several potential solutions:

1. A hardware solution might be to intercept one or more of the digital bits between the Denise chips and the Pi and add the overlay signal
2. A software version of the above: There is an unused GPIO on the Pi which could accept the input normally connected to the red channel with some minor software tweak to read that bit at the same time as the other bits and superimpose that over the video.
3. A software communication based solution where the Pi talks directly to the gotek and uses it's own OSD to display the info. This is somewhat difficult using the existing protocol as the Pi can't receive the OSD data at arbitrary times as it is 100% occupied during the video part of the screen.

Option 2 is would be relatively simple to try although the quality would not be great.

IanSB, 2021-01-23:
@JosipBasic

OK I got that working

Download the latest Beta15:
https://github.com/IanSB/RGBtoHDMI/releases

Connect Flash floppy video signal to PIN 18 on the Pi zero header via a 1K resistor (That's GPIO 24)
(Video must be 3.3v logic level)
Note PIN 18 was an output on earlier software so you must use a resistor to protect the FF video pin in case older software is loaded as two outputs will be connected.
It will work in normal and 0% scanline mode but won't work with 50% scanlines.

When video is detected the screen will dim by 50% and the video will be overlaid in white. It will be a little ragged as the FF OSD pixel clock is not locked to the Amiga pixel clock.
I dont have an FF OSD board but I connected the video output of a BBC micro via a 5v to 3.3v level shifter and got a display so it is likely to work. (The BBC signal wasn't locked to the Amiga so it drifted across the screen but it proved that the software was working.

Post some screencaps if you get it working (short press on button, files stored on SD card)

Here is a screencap showing the dimmed screen with the BBC micro overlay:
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

Normal intensity screen for comparison:
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

c0pperdragon, 2021-01-23:
Isn't GPIO18 used to detect the Amiga mode? In my current adapter GPIO18 is pulled to GND via a 3k3 resistor.

IanSB, 2021-01-23:
@c0pperdragon
>Isn't GPIO18 used to detect the Amiga mode?

PIN 18 is GPIO 24

c0pperdragon, 2021-01-23:
Ah, yes. Of course. This kind of numbering missmatches always confuses me even with my own board designs.

kipper2k, 2021-01-24:
I connected pb15 from the bluepill to pin 18 of the PiZero via a 1k resitor (using the new beta15 files) and couldnt see any OSD. Not sure if it is my error or not.

IanSB, 2021-01-24:
@kipper2k

First try connecting PIN 18 (i.e. GPIO 24) to PIN 17 (+3.3v) on the Pi header using the 1K resistor. The screen should go white indicating that the overlay input is working. I just downloaded beta15 and tried that to confirm it worked on my system.
Note that the overlay doesn't yet work with 50% scanlines enabled (coming soon) so if you have changed to that profile switch back to the default profile.

I don't know what the voltage level out of the blue pill is when text pixels are being displayed so can you check that with an oscilloscope if you have one.
Other than that, try a lower value resistor, or if you are certain from the above test that it's working you could connect it directly but make sure you never revert to older software.
Let me know how you get on.

IanSB, 2021-01-24:
@kipper2k

Here is a photo of the connection:
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

Wire on the left is PIN 18. The wire on the right on PIN 6 is ground as I was using an external BBC micro source. You shouldn't need that as the blue pill and RGBtoHDMI will both be grounded via the Amiga.

kipper2k, 2021-01-25:
Hi Ian,  Thanks for the reply.

 I will show you some pictures of my A500 so you can see how it is actually setup. (The left monitor is attached to the Pi and the one on the right is RGB

The gotek is my design of the Gotek that i redone and made it connect directly to the a500 header and power, I broke out all of the extra signals to make it easier for possible upgrades later. The Bluepill attached is mounted directly to the gotek and needed signals fed to it. My keyboard is hardwired to use the Shift, Alt and amiga keys to access flashfloppy's keyboard menu options

 The Bluepill has the latest 1.8 FW on it.  The 2 wires attached to the lower left of the bluepill are feeding the sync and RGB colour out to enable the OSD on the RGB monitor, I attached it to the Green signal.

 A 1K resistor is attached to pin 18 of the Pi header and when i short it to pin 17 the monitor attached to the Pi HDMI output will go white. The beta 5 files are set to default.

 When i remove the  blue wire from the bluepill (PB15) and attach it to the resistor on the Pi header i do net see any input on the screen. The screen does not dim at all and there are no artifacts displayed at all

Looking at the picture of the a500 you can see that the OSD works ok on the RGB monitor, The small OLED display works ok too.

Here are the pictures...

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

kipper2k, 2021-01-25:
here are pictures

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

IanSB, 2021-01-25:
@kipper2k

Have you tried removing the connection of bluepill PB15 from the Amiga and connecting PB15 just to the Pi?
The resistors on the analog RGB may be pulling the voltage on PB15 down below a valid level

kipper2k, 2021-01-25:
Hi Ian, I  pulled the pins from the amiga when testing the Pi. The only active connections from the Amiga gotek to the bluepill are SCL (B6), SDA (B7), 3.3v and Gnd. When mounting the bluepill to the gotek the other mounts are not connected to anything

Here is a description of my gotek install.

http://www.kipper2k.com/gotek31/gotek31k.html

IanSB, 2021-01-26:
@kipper2k

Have you tried a direct connection without the resistor?
Can you look at the output of PB15 on a scope?

IanSB, 2021-01-26:
@kipper2k

I just released an updated beta16 which among other things doubled the frequency at which it checks for white pixels on pin 18 so give that a try as well.

https://github.com/IanSB/RGBtoHDMI/releases

kipper2k, 2021-01-26:
@IANSB i tried beta16 still nothing, i looked at the b15 output on my scope and i couldnt really get a good luck at a decent signal, seemed like a lot of noise, (it is probably operator error). I did try bypassing the resistor, and there was no change to the picture at all. Shorting the resistor to pin 17 still changes picture to white.

 Is there anyone else trying this and getting same/different results ?

IanSB, 2021-01-26:
@kipper2k

>Hi Ian, I pulled the pins from the amiga when testing the Pi.

You have to keep the sync pin connected to the Amiga otherwise it definitely won't work because the blue pill needs to synchronise with the Amiga so that it can generate the video signal. Only pull the video pin from the Amiga for testing

>Is there anyone else trying this and getting same/different results ?

Not that I'm aware of, but if anyone reading this got it to work then please post.
I have ordered a blue pill so will be testing it myself at some point.

kipper2k, 2021-01-26:
wow...
it works
i was not leaving the sync line connected, i will take a pic after supper
 Awesome stuff :)

IanSB, 2021-01-26:
>i was not leaving the sync line connected, i will take a pic after supper

After re-reading your post and looking at the photos I suddenly realised that you were pulling the two way cable from the Amiga and plugging it onto the resistor which wouldn't work because the sync signal would be missing. (That's an output from the Amiga into the blue pill to tell it when to draw the OSD).

The image is ragged because the Amiga pixel clock and the FFOSD pixel clock aren't locked together. This effect is present on the analog output but is less noticeable because of the smoothing effect of an analog output. For the Pi, it's always digital so you get a very sharp ragged edge.

I have been talking with Kier about sending the OSD info out of the serial port on the blue pill straight into the Pi which would then display it with it's own OSD and also driving the Pi's menu from an Amiga key combination also from the blue pill so there may be a better solution eventually.

ILAHWWINC, 2021-02-14:
I tried to do this here. Connect Pi Header 18 - 1K Resistor - B15 Bluepill. The Bluepill is still and was before connected to my A2000 to display the OSD over analog output.

When i connect Pi and Bluepill i get the OSD over HDMI but there are many artefacts and the colors are damaged. When i remove the connection the HDMI output is right again.

Any hints for me?

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

IanSB, 2021-02-14:
@ILAHWWINC

Try disconnecting the B15 FFOSD video (only the video, not the sync) from the Amiga's analog output. It may be that you can't have the video connected to the analog Amiga signal at the same time because the Amiga's video output is feeding backwards into the Pi's pin 18.

ILAHWWINC, 2021-02-14:
Yes, much better without video signal to Amiga. The OSD is a little nasty with „flickering waves“.

Is it possible to get both, HDMI and Amiga analog, connected to the video signal without interference.

![Uploading A435E6BC-A5F9-478E-BE86-0B5DE35D4982.jpeg…]()

ILAHWWINC, 2021-02-14:
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

IanSB, 2021-02-15:
@ILAHWWINC
>The OSD is a little nasty with „flickering waves“.

As mentioned above that is due to the pixel clock on the blue pill video not being synchronised with the Amiga's pixel clock.

>Is it possible to get both, HDMI and Amiga analog, connected to the video signal without interference.

I've been discussing with Keir the possibility of directly communicating between the blue pill and Pi zero via the serial port which would allow the Pi zero to use its own OSD so that would mean much better quality and allow both video signals to work at the same time.

See: https://github.com/keirf/FF_OSD/issues/38

ILAHWWINC, 2021-02-19:
@c0pperdragon

Do you plan to create a better cooperation of FF_OSD and Amiga Adapter - RGB2HDMI? I think both are very good hardware mods to the Amiga and using both same time would be very nice. :-)

See: [https://github.com/keirf/FF_OSD/issues/38](url)

c0pperdragon, 2021-02-20:
As far as I know Ian is already planing somerhing together with the creator of the FF

kipper2k, 2021-02-26:
Here is the pinout for the OSD output to HDMI on the A600, i believe all models have the same layout...

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

- purple wire bluepill B15 -> pi Header pin 18
- Blue wire Bluepill A8 -> A600 motherboard
- Green wire is only used when connected to RGB output
-

solarmon, 2021-03-11:
Does the resistor need to be 1K? Can it be 3K3? I want to do parts consolidation and make use of the 3K3 already used on the RGBtoHDMI board.

Or, maybe the other way - can the 3K3 on the RGBtroHDMI be replaced by 1K. I understand this is pull down resistor, so 1K should be OK too?

IanSB, 2021-03-12:
@solarmon

Yes they are not critical, I think I used 1K for both on mine.

solarmon, 2021-03-12:
@IanSB

The FF OSD build recommends a 270ohm resistor for the PB15 line.

I assume this 1K resistor is meant to replace this 270ohm resistor? Is there a technical reason why it needs to change from 270 ohm to 1K ohm?

IanSB, 2021-03-13:
@solarmon
>Is there a technical reason why it needs to change from 270 ohm to 1K ohm?

270R should work just as well (and is needed to get the right signal level on the analog output) but increasing the value would reduce the amount of current in the event of two outputs being connected together.

solarmon, 2021-03-13:
> in the event of two outputs being connected together.

@IanSB What do you mean by 'two outputs'? What would/could be those two outputs?

IanSB, 2021-03-14:
@solarmon
>What do you mean by 'two outputs'? What would/could be those two outputs?

It's explained earlier in this thread:

PIN 18 is the FFOSD input but was configured as an output on earlier Pi software so you must use a resistor to protect the FF video output pin in case older software is loaded as two outputs would then be connected.

solarmon, 2021-03-14:
@IanSB

Thanks for the explanation.

Would it be possible to have FF OSD PB15 connected to both the Pi and the Amiga motherboard - so that it will dual work between RGBtoHDMI and the Amiga video output?

IanSB, 2021-03-14:
@solarmon
>Would it be possible to have FF OSD PB15 connected to both the Pi and the Amiga motherboard

No, as mentioned above the Amiga analog video feeds backwards through the 270R resistor into the Pi's Pin 18 causing a messed up screen. Also it's harder to buffer the blue pill's video output because it is tri state (i.e. low, high or floating) so the simplest option would be to modify the blue pill's software to provide two video outputs on separate pins.

A more complex mod would be to sent the OSD data serially from the blue pill to the Pi so the Pi can draw it using its own OSD and I asked Keir to look at that option.

solarmon, 2021-03-14:
Maybe a stupid question based on my inexperience, but can a diode not be used instead to split off the video signal from the Blue Pill?

IanSB, 2021-03-14:
@solarmon
>but can a diode not be used instead to split off the video signal

The video signal from the blue pill has 3 levels, 3.3v to represent text pixels, 0v to represent the dark box around the text and floating when video switched off. The diode would need to be on the analog side to prevent the reverse video feedback but that would stop the analog side from "seeing" 0v so it would work in that you would get the text but there would be no dimmed black box around it which might make it hard to read on some backgrounds. Better than nothing I suppose.

solarmon, 2021-03-16:
I tried the FF OSD support and it indeed does work, albeit a bit ragged/wavy.

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

For the test I used my existing 270ohm resistor wire connecting to B15 on the Blue Pill, I also wired CSYNC direct from the RGBtoHDMI board to the A8 on the Blue Pill and it. Now that I know wiring CYSYNC to the RGBtoHDMI adapter works, I will add a header point to my custom boards.

aiobofh, 2021-03-16:
Would be nice to connect the standard OLED display-wires from gotek/goex directly to the pi and let RGB2HDMI render the OSD, somehow.

solarmon, 2021-03-16:
I've added the header pins for CSYNC and 'RGB' to go to the Blue Pill into my custom RGBtoHDMI board.

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

aiobofh, 2021-03-16:
> I've added the header pins for CSYNC and 'RGB' to go to the Blue Pill into my custom RGBtoHDMI board.

Indeed! And that's very very cool!!!

What I was thinking - it should be possible to skip the Blue Pill altogether just reading the information the same way the OLED modification (replacement of the 7-segment display) does work with any Gotek. And let the software in the Pi do the work instead. If i was a bit unclear in the statement :) Simpler to skip-over the analog part. :)

solarmon, 2021-03-16:
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

I understood what you meant. The Blue Pill in FlashFLoppy OSD is effectively an I2C display emulator, but it also does keyboard integration. It communicates with the FlashFloppy on the Gotek via a custom I2C protocol.

solarmon, 2021-03-16:
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

@IanSB Thanks for the explanation.

After speaking with Keir about it, he suggested to make use of the Display Enable pin to drive a tri-state buffer. I have now incorporated it in to my custom RGBtoHDMI board design. I need to get it printed and tested out to see whether it does actually work!

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

solarmon, 2021-03-17:
@IanSB When OSD is enabled/visible I seem to keep losing sync frequently - the screen goes blank/black for a second or so and then returns back.

Is this a known issue? Do you have any suggestions on how to make it more stable?

IanSB, 2021-03-18:
@solarmon

Do you mean the FFOSD or the Pi's OSD?

Brief blanking like that can mean the monitor doesn't like rate the genlock changes the HDMI frequency.
Go into the settings menu and turn on the V sync indicator. If this moves during the blanking then that is a possible cause.
You can also change the genlock speed to slow or medium to see if that makes any difference.
(Save config after making the changes)

solarmon, 2021-03-18:
> @solarmon
>
> Do you mean the FFOSD or the Pi's OSD?

@IanSB Sorry, I should have been more clear. I meant when the FFOSD OSD is visible/enabled. I only get the brief blanking issue when this is displayed. The issue does not happen when the RGBtoHDMI OSD is displayed.

Should I be using your specific release at https://github.com/IanSB/RGBtoHDMI/releases , but FFOSD OSD seems ot be working with the normal release (albeit with the brief blanking issue, and jagged text).

solarmon, 2021-03-18:
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

I turned on V sync indicator - I assume it is the red horizontal line shown on the screen?

When I enabled FFOSD OSD, the line disappeared. Just before the first brief blank I saw the red horizontal line move down in to view from the top of the screen. When the screen came back the line was not there and subsequent brief blanks occurred but the line did not reappear until I turned off FFOSD OSD.

Without FFOSD OSD enabled, the image is rock solid, and the V sync indicator line is shown near the top of the screen.

solarmon, 2021-03-18:
> You can also change the genlock speed to slow or medium to see if that makes any difference.
> (Save config after making the changes)

@IanSB It seems this did the trick! I set Genlock Speed to "Slow" and it no longer brief blanks. The V sync indicator line still disappears when FFOSD OSD is on, but it no longer brief blanks. (Actually, I just saw (once) the V sync indicator line shift down in to view and disappeared again.)

IanSB, 2021-03-18:
@solarmon

OK it looks like there is a bug which causes lock to be lost when the FFOSD is enabled. On many monitors this would not be noticeable because the fast genlock speed works without causing the screen to blank. On your monitor setting genlock speed to slow works around the problem in a similar way.

IanSB, 2021-03-19:
@solarmon

Here is beta17 test release which fixes the FFOSD issue plus a couple of other bugs:
https://github.com/IanSB/RGBtoHDMI/releases

Wipe your SD card and install the new version
If you enable the vsync indicator (red line) this should remain stable when the FFOSD is enabled and there should be no screen blanking.
Let me know if it works OK for you.

solarmon, 2021-03-19:
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

@IanSB

It worked exactly as you stated - I no longer get brief blanks and the vsync indicator line stays in position!

Thank you so much!

ILAHWWINC, 2021-07-06:
Is there any advance in correcting the "wavy" letters?

ILAHWWINC, 2021-07-06:
Is there any advance in correcting the "wavy" letters?

Thread 28 (2021-01-28):

Amiga Digital video not work in Amiga 500 Rev 3

kipper2k, 2021-01-28:
Hi all,

Have tested this with 2 different Amiga 500 Rev3s and neither will work with the adapter. The Pi splash screen will appear but the Rev3 refuses to display (black screen only) through HDMI. I have swapped Denise and the Agnus with no joy. I can't find a schematic on the Rev3 for comparison so not sure what the issue is.

culexus8, 2021-01-30:
Do you get the OSD menu to pop up if you hold the switch that is connected to the adapter board?

IanSB, 2021-01-31:
If the board works in other revisions but the menu won't appear when you press the button, then the most likely cause is that the pixel clock is missing. This is generated from the CDAC line in "Denise" mode and the 7Mhz clock in "Super Denise" mode. Have you tried setting the link to Super Denise mode?
Can you check if those signals are present on the rev3 with an oscilloscope?

kipper2k, 2021-01-31:
@IanSB   thanks for info, i will try this later today

IanSB, 2021-02-01:
@kipper2k

>i tried swapping the jumper and i ended up with the blinking

Blinking means the sync timings don't match those in the profile so something is different about the sync signal on your rev 3.

Your symptoms seem to match those that @hansliss is seeing with an A2000
See: https://github.com/c0pperdragon/Amiga-Digital-Video/issues/11

Can you post a photo of the source summary page in the info menu.

hansliss, 2021-02-01:
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

I found schematics for the A500 in an "Amiga 500 Introduction" (https://museum.syssrc.com/static/Amiga_500_Introduction.pdf) that does indeed show both /CDAC and /CSYNC (pin 34 and 32) missing from the Denise socket. It doesn't say which revision they depict but it seems likely that it's an early one.

hansliss, 2021-02-01:
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

From what I can gather, on the A500 rev. 3, the missing signals are available so it might be possible to patch them in to the Denise socket - this is done entirely at your own risk, obviously. Find and double-check schematics first!

/CDAC, pin 34 on Denise, is available on Gary, pin 26 - Gary is U5, a 5719 near the center of the motherboard.
/CSYNC, pin 32 on Denise,  is available on U41, pin 9  - U41 is a DIL-20 74HCT245 just next to Denise.

kipper2k, 2021-02-02:
k, its working, i need to tidy it up and then i will show some pics etc

kipper2k, 2021-02-02:
using this...
/CDAC, pin 34 on Denise, is available on Gary, pin 26 - Gary is U5, a 5719 near the center of the motherboard.
/CSYNC, pin 32 on Denise, is available on U41, pin 9 - U41 is a DIL-20 74HCT245 just next to Denise.

 I followed traces to find better places to connect a pin header to.

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

hansliss, 2021-02-02:
For the A2000-A (rev. 4), and perhaps even A1000, it may be possible to do the same thing by patching U77 pin 8 to Denise pin 32, and pin 15 on the MMU slot through an inverter to Denise pin 34. I may test this after I've verified my adapters on an A500.

kipper2k, 2021-02-02:
Here is a picture of the underside of the Rev3 A500. The yellow wires show what needed to be done to get the HDMI working. Doing this means you do not need to modify the HDMI adapter.

 Ignore the black wires mod, that was on this board already

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

hansliss, 2021-02-03:
> For the A2000-A (rev. 4), and perhaps even A1000, it may be possible to do the same thing by patching U77 pin 8 to Denise pin 32, and pin 15 on the MMU slot through an inverter to Denise pin 34. I may test this after I've verified my adapters on an A500.

I got it working in my A2000-A! Instead of the MMU slot, I took CDAC from RN17 pin 3, through a 74*04 inverter and to pin 34 on Denise. My setup was a bit too precarious to keep (with a caseless PSU and cables everywhere) so I'll experiment further later, but it looked like a perfect picture.

There's a bit of a mess with the hot glue but I didn't want to risk anything coming loose. I'll add some Kapton tape on the case below this kludge just in case.
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

kipper2k, 2021-02-03:
awesome, my a1000 is an NTSC version and i think it is different, the schematics are very poorly photocopied and i am having a hard time reading it. From what i can tell sync is on U7a pin 2 and cdac pin 15 of the 86 pin header

hansliss, 2021-02-03:
> awesome, my a1000 is an NTSC version and i think it is different, the schematics are very poorly photocopied and i am having a hard time reading it. From what i can tell sync is on U7a pin 2 and cdac pin 15 of the 86 pin header

Can you somehow send me the schematics you have, so I can compare them to the various schematics I've collected?

kipper2k, 2021-02-03:
here is a link...

www.kipper2k.com/a1000.zip

hansliss, 2021-02-04:
> here is a link...
>
> [www.kipper2k.com/a1000.zip](http://www.kipper2k.com/a1000.zip)

Ah, yes. I saw that one. One of the worst ones.

You can find the uninverted CDAC on R107, on the side *not* connected via a nearby ferrite bead to pin 8 on U91 (looks like it might be a 74S51), and also of course on pin 15 on the expansion connector. It doesn't seem to go anywhere else.

/CSY is on Agnus pin 39 and on U6A (HC244) pin 8, which should be near Denise. The pin number is hard to read, but input pin 8 on an HC244 corresponds to output pin 12, so it seems very likely it's an "8".

hansliss, 2021-02-04:
> /CSY is on Agnus pin 39 and on U6A (HC244) pin 8, which should be near Denise. The pin number is hard to read, but input pin 8 on an HC244 corresponds to output pin 12, so it seems very likely it's an "8".

I think you might be right about pin 2 on U7A as well, although that one is buffered through U6A. Not entirely sure what that label on pin 12 on U6A is supposed to be. :)

kipper2k, 2021-02-05:
thanks for lookin, i ill try it out tomorrow

hansliss, 2021-02-12:
> You can find the uninverted CDAC on R107, on the side _not_ connected via a nearby ferrite bead to pin 8 on U91 (looks like it might be a 74S51), and also of course on pin 15 on the expansion connector. It doesn't seem to go anywhere else.
>
> /CSY is on Agnus pin 39 and on U6A (HC244) pin 8, which should be near Denise. The pin number is hard to read, but input pin 8 on an HC244 corresponds to output pin 12, so it seems very likely it's an "8".

I have to add a caveat here: This is unlikely to apply to a PAL A1000. On mine, R107 is connected to a nearby capacitor, and I can't see any trace of that on any of the A1000 schematics I've found so far. I can only conclude that the PAL A1000 has completely different schematics. The motherboards looks different too - there's a continuous row of 18 resistors on the bottom right (plus one capacitor and another resistor). My motherboard is made in Japan, part number 252277-01, from 86.08.08.

hansliss, 2021-02-12:
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

So, I've traced this elusive CDAC signal on my PAL A1000, 252277-01 from 86.08.08:
It originates from a 74S51 under the metal cover near the top, U3M, pin 3, which is connected to a ferrite core nearby (it's just opposite U8K pin 3/4), and at this point the signal is called (probably, the schematics are almost useless) "DAC". The actual CDAC signal can be picked up after this passes through R97, which is located three rows of chips below the middle, next to U3M, A 74F74. CDAC is on the top pin of this resistor, just opposite pin 7 of U3M. After this, it goes directly to pin 15 on the Zorro bus, and nowhere else.

The DAC signal, which can be found at the bottom pin of the same resistor, goes into the nearby U3M pin 3, and also to U2G pin 11, a 74F374 which is much closer to Denise. I'm not competent to judge whether this signal will work as well or if it has to be the actual CDAC. In any case, it'll still have to be inverted, of course.

The main problem, as it turns out, is that there's no room in the A1000 for the RGBToHDMI anyway. Denise is just next to the PSU, and the Pi would need to be where the PSU is. So I'm just going to reassemble this A1000 now and forget about it. Maybe the A600 solution could work. I haven't looked at that.

hansliss, 2021-02-12:
I tried this now in my PAL A1000 (252277-01 from 86.08.08), with Dupont cables between the Denise adapter and the Pi since the Pi won't fit next to the PSU, and it kinda worked. I took CDAC from the resistor near U3M and inverted it with a 74LS04, and I took /CSY from pin 8 on U6A. Unfortunately, the picture is quite glitchy, but with those long Dupont cables, I'm not very surprised.

I guess next step is to try what I should have done in the first place: try to move the PSU out of the way and see if putting the Pi directly on the adapter will eliminate the glitches. If they don't go away, there's still something wrong with the CDAC and /CSY signals.

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

hansliss, 2021-02-12:
> I tried this now in my PAL A1000 (252277-01 from 86.08.08), with Dupont cables between the Denise adapter and the Pi since the Pi won't fit next to the PSU, and it kinda worked. I took CDAC from the resistor near U3M and inverted it with a 74LS04, and I took /CSY from pin 8 on U6A. Unfortunately, the picture is quite glitchy, but with those long Dupont cables, I'm not very surprised.
>
> I guess next step is to try what I should have done in the first place: try to move the PSU out of the way and see if putting the Pi directly on the adapter will eliminate the glitches. If they don't go away, there's still something wrong with the CDAC and /CSY signals.

I've tried this now, and the picture is still not clean. I'll move the patches to the underside of the motherboard tomorrow.

c0pperdragon, 2021-02-12:
Actually, I think inverting the _CDAC may not be necessary. Having the wrong phase may cause the hsync detection to be come unreliably (causing horizontal jitter) and the horizontal pixel alignment will be off by just one pixel on the output screen.
Both can be fixed by adjusting the settings in the RGBtoHDMI software on the Pi.

c0pperdragon, 2021-02-12:
The glitches in your picture look very much like the ones I had when I wired up everything on breadboards. Your cables are just too long for clean transmission.

hansliss, 2021-02-13:
Actually, it was a bad solder joint somewhere on the adapter. After moving the patches to the motherboard, I tried a known good adapter and it worked, so I reheated all the SMD solder points on this one, and after that it worked, too.

When I do these patches on the motherboard itself, I prefer to do it "right" and produce the proper signals, in case I want to switch to a Super Denise later or something.

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

I can still see a couple of red pixels on the Kickstart screen on the screenshot, which I didn't see on the actual screen. I'll look into that. But overall, it works just fine.

hansliss, 2021-02-14:
> I can still see a couple of red pixels on the Kickstart screen on the screenshot, which I didn't see on the actual screen. I'll look into that. But overall, it works just fine.

The A1000 RGBToHDMI image has some flickering  on vertical lines (specifically on the black-to-blue transition on the Kickstart screen) even after I moved the CDAC and CSYNC patches to the motherboard. Two different Denise adapters produced the same symptoms. The MB patches are now very similar to the ones on the A2000, but on the A2000 the image appears perfect, with no artifacts. I wonder if there's something else in the motherboard design that produces bad signals.

In any case, I've reassembled and set the A1000 aside for now. I'm not installing RGBToHDMI in it at this point.

SirCathal, 2021-02-24:
@hansliss Du you made any progression? because I will try the Adapter in my Pal A1000 at the Weekend.
Can you post a picture where I can see the exact positions of the two Wires on the Mainboard and on the Adapter?

hansliss, 2021-02-25:
> @hansliss Du you made any progression? because I will try the Adapter in my Pal A1000 at the Weekend.
> Can you post a picture where I can see the exact positions of the two Wires on the Mainboard and on the Adapter?

Sorry, the A1000 is back together for now, and I haven't even ordered the new, smaller PCBs yet, which is the next step for the A1000.

But my descriptions above should be enough for you to find the correct points. Apparently you don't need to bother inverting CDAC if you're only using it for RGBToHDMI.

hansliss, 2021-02-25:
> @hansliss Du you made any progression? because I will try the Adapter in my Pal A1000 at the Weekend.
> Can you post a picture where I can see the exact positions of the two Wires on the Mainboard and on the Adapter?

Note that the patches I made are for a specific version of the A1000, one without the daughterboard covering half the motherboard. I believe it is newer than the ones with the daughterboard.

BattleR0ntti, 2021-03-02:
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

You wouldn't happen to have the partnumber for the inverter? This looks like the solution needed for my old rev.4 board, but there seems to be a lot of 74*04 inverters out there.

hansliss, 2021-03-02:
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

Oh dear. It's upside down on the underside of the PCB and the Amiga is fully assembled... :) I'm pretty sure it was an old LS I had lying around.

hansliss, 2021-03-02:
>
> You wouldn't happen to have the partnumber for the inverter? This looks like the solution needed for my old rev.4 board, but there seems to be a lot of 74*04 inverters out there.
Actually, you may not need to invert the signal, according to @c0pperdragon. Much easier if you don't have to do that.

SirCathal, 2021-03-07:
Today I tried to get the adapter to work in my Pal A1000.
Unfortunately, I wasn't quite successful yet.
I put an OCS Denise in the adapter and set the adapter to ECS, as this should be necessary in the A1000 (without that, I simply got no picture).
Then I soldered a cable from pin 8 on UA6 to pin 32 of the Denise socket under the moterboard.
(The Picture was taken before I soldered the cable under the board)
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

The result is an image with individual white flickering pixels and cyan shadows next to black pixels.
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

https://user-images.githubusercontent.com/69156692/110226165-3d8e0a80-7eed-11eb-8280-889ec5aa7cec.mp4

I've tested several adapters and PIs. the combination works perfectly in an A500.
Do I now have to bring a signal to pin 34 of Denise? And do I understand correctly that this comes from Pin15 of the expansion port?
Can it be that the A1000 generally has timing problems with the adapter?
I placed it above the power supply, but to rule out that the tower of GPIO extenders is the reason for the error, I also connected everything directly. But that didn't bring any improvement.
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

hansliss, 2021-03-07:
> Do I now have to bring a signal to pin 34 of Denise? And do I understand correctly that this comes from Pin15 of the expansion port?

Yes, you need to bring CDAC to pin 34 as well, inverted or not. If you have a 252277-01 motherboard, read my posts earlier in this thread to see where to find it. And move the jumper back to "Denise".

I still have small defects in the picture that I don't have on other Amigas, but I'm going to try the suggestion given in #36 and use a different kind of 74* ICs for the A1000.

kipper2k, 2021-03-07:
I designed a new board so you wont need to use all those risers and make the connections easier. will be a couple of weeks

SirCathal, 2021-03-08:
> I designed a new board so you wont need to use all those risers and make the connections easier. will be a couple of weeks

Please let me know when it's ready!

BattleR0ntti, 2021-03-11:
>
> Actually, you may not need to invert the signal, according to @c0pperdragon. Much easier if you don't have to do that.

Thank you @hansliss  !! I followed your instructions to the letter and it works! I opted to leave out the inverter and just used the two jumper wires for this and the result was a crystal clear image. Without this little fix the adapter just produces black image, but now it's great.

I did notice a little weird behavior on some Workbench icons when using ClassicWB 68k though. On some icons there are some red pixels vibrating back and forth/up and down, but I'm not sure why this is. These little pixel vibrations are not showing up when using Diropus, shell or even during some games, just the classicwb icons. This does not happen when booting form a Gotek and using plain WB1.3 or 3.1, so maybe it's just a ClassicWB icon problem.

Anyway, thank you again! :)

hansliss, 2021-03-11:
> > Actually, you may not need to invert the signal, according to @c0pperdragon. Much easier if you don't have to do that.
>
> Thank you @hansliss !! I followed your instructions to the letter and it works! I opted to leave out the inverter and just used the two jumper wires for this and the result was a crystal clear image. Without this little fix the adapter just produces black image, but now it's great.

Nice!

> I did notice a little weird behavior on some Workbench icons when using ClassicWB 68k though. On some icons there are some red pixels vibrating back and forth/up and down, but I'm not sure why this is. These little pixel vibrations are not showing up when using Diropus, shell or even during some games, just the classicwb icons. This does not happen when booting form a Gotek and using plain WB1.3 or 3.1, so maybe it's just a ClassicWB icon problem.

This sounds a bit like what I noticed on my A1000. I'm awaiting PCBs for a test version of the adapter, on which I will use 74VHC* parts for that one, and see if it goes away. It's not exactly annoying though, just a minor thing.

SirCathal, 2021-03-14:
I'm a little further, but there is still one problem.
But I'll start over ...

I have pin15 from the expansion port, where the CDAC signal I miss is very far away from Denise. looked where the track connected to pin 15 runs so long.
Then I found a via in the middle of the board, where you can get the signal from above as well as from below.

Here on the top of the board (roughly in the middle)
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

Here on the underside of the board (roughly in the middle)
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

That then brought a certain degree of success. Because the purple shadows have completely disappeared.
What remains are the white, flickering dots.
However, these appear primarily in HiRes images, i.e. on the Workbench:
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

Again better to see in the video:
https://user-images.githubusercontent.com/69156692/111081043-a84cd080-8501-11eb-88c4-855efe6dfd3c.mp4

It is hardly noticeable in LoRes mode. Here is an example of a small demo from the good old Red Sector Demo Maker :)
Here you only see a white pixel briefly in two places:
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

In addition, I said goodbye to my GPIO extender and switched to a 5cm ribbon cable.
The cable has no effect on the pixel flicker, it doesn't change when I plug the Pi directly onto the adapter.
With a 15cm cable it gets worse, so I shortened it to 5cm.
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
The back wall is 3D printed and the original one is packed away intact.

Does anyone have any ideas what I could do against pixel flicker?

IanSB, 2021-03-14:
@SirCathal
>Is it possible to solve the problem with another setting option in the software?

No, the main options are to try adding a capacitor to the PiClk signal or replace the 74LVC parts with 74VHC parts as discussed in other threads.

scrappysphinx, 2021-03-27:
Sorry this might be a bit off topic but @kipper2k a few years ago you made modified hdmi cables with rca jacks (pic attached below) which you were selling on Amibay, if it were possible to purchase one of these (or maybe if you started making them again) would we be able to route audio through the hdmi too?

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

c0pperdragon, 2021-03-29:
This cable actually looks a bit like an "april fools" device to me, as there is no way to insert analog audio into the digital HDMI data stream without substantial active electronics.

hansliss, 2021-03-29:
> This cable actually looks a bit like an "april fools" device to me, as there is no way to insert analog audio into the digital HDMI data stream without substantial active electronics.

I thought so first too, but it seems to be made for a specific HDMI interface that routes analog audio through a couple of unused HDMI pins: https://bigbookofamigahardware.com/bboah/product.aspx?id=1956

philipkonkyl, 2021-05-01:
Hi I have a similar problem with my amiga 500. I have installed the Pi but I get a black screen with the Denise setting and a stuttered image with "Super Denise"  (see picture)

I do get the OSD menu, but no matter what setting I try in the OSD there is no change to the picture.

It does say in the beginning "No Sync" or something like that.

I don't know if my amiga is a rev3 or if it has the sync signals.

I appreciate any help -- I would love to play sensible soccer on my projector :-)

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

c0pperdragon, 2021-05-02:
Looking at the picture, the sync signal is not comming through to the Pi. That you have at least some image at all can only be due to some inductive coupling from the color signal and the csync input.
Before doing more guesswork, please check your board revision. You find this information on the right side of the board in the box with some other print, like "Amiga 500" and "Rock Lobster". Should read something like "Rev.5" "Rev.3" or similar.

philipkonkyl, 2021-05-02:
> Looking at the picture, the sync signal is not comming through to the Pi. That you have at least some image at all can only be due to some inductive coupling from the color signal and the csync input.
> Before doing more guesswork, please check your board revision. You find this information on the right side of the board in the box with some other print, like "Amiga 500" and "Rock Lobster". Should read something like "Rev.5" "Rev.3" or similar.

My Mother board is a Rocket Lobster, but i simply can't seem to find the "rev.X"info
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

c0pperdragon, 2021-05-02:
So, yes this is definitely a Rev.3 board.
Further up in this thread are tons of information how to make the adapter work with this. But you do need to do a bit of soldering here.

philipkonkyl, 2021-05-03:
> So, yes this is definitely a Rev.3 board.
> Further up in this thread are tons of information how to make the adapter work with this. But you do need to do a bit of soldering here.

OK Thank you so much @c0pperdragon  ! I will try the soldering on the bottom.
2 small questions. Should I use Denise or super Denise ?
And the Ram you see on one of the pictures is that extension module if yes - how much has been added.
Again sorry for my newbie questions :-)

c0pperdragon, 2021-05-03:
The picture above from kipper2k with the two yellow botch wires on the underside is exactly what you need.
Then you will get the needed signals for the adapter board when jumpered to "Denise".

About your RAM expansion: This is obviously some aftermarket 512KB extension. So your Amiga should have the regular 512KB of chip RAM plus 512K of slow RAM.

philipkonkyl, 2021-05-04:
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

@c0pperdragon Thank you so much for all the info.  !!!

Bunta714, 2021-05-06:
@philipkonkyl

Were you able to get the modification working correctly? I have a Rev 3 board that is identical to yours (oscillator crystal above the CPU), and our model is slightly different from the one that kipper2k did the mod to (oscillator crystal below the CPU, I think).

I copied his exactly and I'm still getting only a black screen when switching to the HDMI from the Pi. I'm wondering if maybe I did it incorrectly, or if there is a difference in the boards.

philipkonkyl, 2021-05-07:
@Bunta714

No I have the exact same experience as you. My "No Sync signal" despaired though, and I could see the OSD menu with the jumper set to Denise.
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

Thread 29 (2021-01-30):

where to buy TLV74333PDBVR

TheAmigaman, 2021-01-30:
Seems there's a bit of a shortage of TLV74333PDBVR.
Most suppliers seem to have none and are quoting 16 weeks lead time.
The few that have them are quoting daft postage and packaging unless I buy a 1000 or more.

Are there any alternatives ?

abrugsch, 2021-02-01:
The footprint is pretty consistent between manufacturers (known as a jellybean part) so as long as the package is the same (SOT23-5) and has sufficient output current (TLV743333PDBVR can drive 300 mA - but I haven't checked yet how close to that capacity is needed) then you can pretty much pick any other 3.3v LDO from your preferred vendor through a filtered search. (and then check agains the datasheet to make sure the chosen one IS pin compatible)

so for example, here's a suitable filtered search on mouser:[clicky](https://www.mouser.co.uk/Semiconductors/Power-Management-ICs/Voltage-Regulators-Voltage-Controllers/LDO-Voltage-Regulators/_/N-5cgac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)
and I've picked out a few examples that are pin compatible and have sufficient power output*

*I went down to 250mA but that may not have been appropriate. I will check but there are sufficient examples of >300mA LDO's that are available - the maximum rating for the logic IC's are 100mA each so probably safest to err on the side of caution. I haven't done any experimentation to see how wildly that varies... so probably best to avoit <300mA parts

TPS7A20 - same power output (300mA) ultra low noise
NCP163ASN330T1G - slightly lower output (250mA)
TLV73333PQDBVRQ1 - automotive spec variant otherwise same as otiginal part
TLV75533PDBVR - 500mA higher current capability
MCP1812BT-033/OT 300mA
MCP1812AT-033/OT 300mA
TLV70333DBVR - 300mA
LDK130M33RY - 300mA

now some of these have other differences that may or may not be relevant like automotive grade which will make it more expensive but otherwise un-necessary for use in an Amiga

tyristori, 2021-02-17:
I use AMS1117-3.3 in mine and it works fine. Output current is 1A.

Jukka-M, 2021-02-27:
Is this compatible. ( SGM2019-3.3YN5G ).
https://www.aliexpress.com/item/4000163877756.html?spm=a2g0o.cart.0.0.101f3c00UCzlyh&mp=1

abrugsch, 2021-02-27:
Datasheet here https://datasheet.lcsc.com/szlcsc/1809051429_SGMICRO-SGM2019-3-3YN5G-TR_C23613.pdf seems to suggest so. 300ma, 3.3v and correct pinout 👍

Jukka-M, 2021-02-27:
Thanks for the quick reply.
I ordered this: https://www.aliexpress.com/item/4000163877756.html?spm=a2g0s.9042311.0.0.47584c4d8VD7E9

tyristori, 2021-03-06:
I'm wondering what's the purpose of 3.3V regulator on A500 board as you can get 3.3V from Pi?

Small adapter variant doesn't have the regulator and takes 3.3V from Pi.

InfiniteExpression, 2021-03-15:
> I'm wondering what's the purpose of 3.3V regulator on A500 board as you can get 3.3V from Pi?
>
> Small adapter variant doesn't have the regulator and takes 3.3V from Pi.

I was just going to ask that (although disappointed not to see an answer for you already) I'm currently building V2 for an A500, and the 74333 regulator is "unobtanium" from any USA source. Is there any reason not to use the 3.3 from pin 1 of the PI?

LinuxJedi, 2021-03-15:
> I'm wondering what's the purpose of 3.3V regulator on A500 board as you can get 3.3V from Pi?
>
> Small adapter variant doesn't have the regulator and takes 3.3V from Pi.

You can technically do this as there should be enough current available from the regulator, but it isn't recommended to pull more than 50mA from any GPIO pin (including 3.3v pins). If you are worried about the cost then change it to a 1117 SOT223 setup in the schematic (you'll likely need to change C4 too and possibly add an input cap), will likely be cheaper and easier to hand solder.

mthiesen, 2021-03-26:
I just finished building my V2 for use with my Amiga 500 and I used the [AP139-33WG-7](https://www.digchip.com/datasheets/download_datasheet.php?id=4602397&part-number=AP139-33WG-7) as a drop-in replacement for the TLV74333PDBVR. It seems to be working just fine.

I chose this one because it was one of the few I could find that is available, pin-compatible and does not require an input cap.

FreezeyBeans, 2021-04-12:
Slightly related on the topic of the BOM - I also notice that the 74LVC574 are available in two frequencies from vendors, namely a 150MHz and a 200MHz. - Is there any preference on which to use for the v2 adaptor boards for self builders?

LinuxJedi, 2021-04-12:
> Slightly related on the topic of the BOM - I also notice that the 74LVC574 are available in two frequencies from vendors, namely a 150MHz and a 200MHz. - Is there any preference on which to use for the v2 adaptor boards for self builders?

I've used the TI 150MHz ones and they appear to work quite well. I have some of the NXP 200MHz but haven't tried them in this board yet.

Thread 30 (2021-01-30):

DIY board troubleshooting

echolevel, 2021-01-30:
Thanks very much for all the hard work on this project! I got some V2 PCBs printed and I assembled one today, but I'm just getting a black screen on HDMI and I'm wondering if somebody can help me troubleshoot it.

Some notes:
* the board is currently in an A500+, with the jumper set for Super Denise
* the RGB signal to my 1084S CRT monitor is fine
* all traces between the Denise and the board components, and between the board components and the Pi, seem to have good continuity
* the XOR and the two flip-flop chips are all getting the correct voltage (tomorrow I'll pull the board out of the Amiga and test each gate on the XOR with an oscilloscope; not sure how to test the flip-flops, which need clock inputs)
* as described in the README, I've unzipped the software onto the root of a freshly formatted microSD
* the Pi Zero quite happily boots and outputs the proper HDMI signal when I insert a Raspbian microSD, so I know that the Pi is getting the right voltage and booting properly
* the LCD monitor that's connected to the Pi does detect a signal from the Pi when it's running RGBtoHDMI; the backlight illuminates, but it just displays a black screen
* if I fire up Deluxe Paint on the A500+ in 2 colour mode, attach an oscilloscope to GND and B0 on the Super Denise, and then adjust the Blue level of the background colour (white) in DP's palette, I get commensurate high/low average voltages on the scope
* if I run a GPIO monitor from the command line when running Raspbian, I can read individual pin states while the Amiga is running...but when doing the above DP test I see no meaningful  fluctuation in B0, B1, B2, B3

Can anyone think of anything else I might test to troubleshoot this? I don't know much about diagnosing stuff with the scope, especially when it comes to video signals, so I'm not sure if any of the above is valuable information. Is there any config option tweaking I can do on the Pi side to output a test signal?

(One more thing: just ONCE I saw the multicoloured test screen when the Pi with RGBtoHDMI started, but I think it was after switching from the Rasbian to the RGBtoHDMI microSD so perhaps there was some kind of bootloader cache thing going on)

Thanks in advance!

tk-amiga, 2021-01-31:
Hi,  I've soldered few of these too and i did one a bit too hastily. At first there was a short and i got no image, but it was Amiga that was not booting at all. I had also the normal Amiga RGB output attached to same tv so i noticed that quite fast. You get image from the rgb at all?
And if it's a first boot for the sdcard it will take a bit longer for it to configure itself for the first time.
If you have the button attached to the adapter can you get the menu open with it?

echolevel, 2021-01-31:
Good shout, thanks - I'll try attaching a button and see if I can see the menu! Yes, regular Amiga RGB output is fine - that's being displayed on the CRT, whereas the HDMI is going to an LCD monitor.

Also interesting to know it autoconfigures once, rather than on every boot. Which file does it create/modify? config.txt?

echolevel, 2021-01-31:
Hmm, I can't get the onscreen menu to show up. I don't have a button, so I'm shorting the button pins for varying lengths of time with no success.

echolevel, 2021-01-31:
Okay, I think the XOR gate is fried (and my spare) - I must have used too much hot air on them.

I'll order some more, but meanwhile: can anyone tell me if the menu should show up even if the Pi isn't receiving the correct signals from the Super Denise via the ICs? If so, then I've got a second problem to troubleshoot...

IanSB, 2021-01-31:
@echolevel

>Okay, I think the XOR gate is fried
>can anyone tell me if the menu should show up even if the Pi isn't receiving the correct signals

The menu button will not respond if the Pi zero isn't receiving the pixel clock which is generated by the XOR gates.
If you have a 5v TTL USB serial adapter you can hook that up to the debug serial port on the Pi zero to confirm it is booting up.
Serial out is on pin 8 and ground is on pin 6 @ 115200 baud

echolevel, 2021-01-31:
That's reassuring, thanks Ian! I have a USB serial adapter lying around somewhere so I'll check that, but I'm now pretty confident that the Pi is booting fine and it's just my ICs that are causing problems.

Cheers!

de-nugan, 2021-02-14:
I had the same problem initially but in my case the RPi wasn't booting because the SD card was partitioned using GPT instead of MBR. The LED on the RPi did not light with the GPT card inserted. Repeating the setup with an MBR-partitioned card worked fine.

echolevel, 2021-02-20:
Thanks for closing, @c0pperdragon, and for your hard work on this project - finally got it working :) My 3rd PCB eventually tested successfully with an Arduino Nano, but wouldn't allow any direct passthrough of Denise on A500 or A500+. Finally I tracked the fault down to a short on the XOR - reflowed the XOR and all is well!

Closed 2021-02-20.

Thread 31 (2021-02-03):

Software Update

IanSB, 2021-02-03:
There is a new software build available here:
https://github.com/hoglet67/RGBtoHDMI/releases

This is one step above the previous betas and is a release candidate for the next stable version

This version has the following improvements over the version previously available on the above link:

Support for NTSC machines.
Aspect ratio conversion to make NTSC games full screen on PAL machines
Fully variable scanline level
Support for flash floppy OSD
Much faster 12 bit per pixel capture code
Various bug fixes.

To use scanlines, there are three profiles to choose from:
Amiga
Amiga Blk-scanlines (Black scanlines only)
Amiga Var-scanlines (Variable scanlines)
Note the variable scanlines profile is more CPU intensive and has to overclock the CPU so if you have problems revert to normal Amiga or black scanlines only or fit a heatsink on your Pi zero.

For flash floppy OSD:
Connect the Flash floppy video signal to PIN 18 on the Pi zero header via a 1K resistor
(Video must be 3.3v logic level)
Note PIN 18 was an output on earlier software so you must use a resistor to protect the FF OSD pin in case older software is loaded.

Please post any issues you find when using it with the Amiga board here.

Closed 2021-03-24.

Thread 32 (2021-02-03):

Reason for R1

hansliss, 2021-02-03:
I've searched the code for references to GPIO pin 18, and as far as I can see it's never set as an input pin. It's used to signal something to the adapter card. So why is R1 there on the Denise adapter? All it does is to pull this output pin to ground, right?

I have by mistake used a far too small resistor, so I'm wondering if I can simply remove it.

IanSB, 2021-02-03:
No, you can't remove the R1 resistor on GPIO18 because it is used to detect the Amiga board (Simple mode). If it is missing the software assumes it is running on the CPLD board instead. The relevant code is in init_hardware() which sets GPIO18 (VERSION_PIN) to an input and reads back the level. If the resistor is fitted it reads back as low, if not it reads back as high due to a weak internal pullup on the Pi. It is then set as an output to control the CPLD board.

hansliss, 2021-02-03:
> No, you can't remove the R1 resistor on GPIO18 because it is used to detect the Amiga board (Simple mode). If it is missing the software assumes it is running on the CPLD board instead. The relevant code is in init_hardware() which sets GPIO18 (VERSION_PIN) to an input and reads back the level. If the resistor is fitted it reads back as low, if not it reads back as high due to a weak internal pullup on the Pi. It is then set as an output to control the CPLD board.

Ah, ok. Thanks for the info! It turns out I didn't use the wrong resistor after all, anyway.

Closed 2021-02-05.

Thread 33 (2021-02-04):

Video problems

cgoffa1, 2021-02-04:
Just installed everything today and I am very impressed.

However sometimes on start up, the image will be shown in a red hue.  Other times the colors will be correct but some pixels will be flickering side to side (mostly in the middle of the screen).  And other times the picture is perfect.

Any idea how to remedy the two problems?

IanSB, 2021-02-04:
Could you post some screencaps of the problem images (short press on button, files stored on SD card)

c0pperdragon, 2021-02-05:
Which adapter version do you use? Did you build one yourself, or is this a read-made one?
Did you check if the jumper at the underside (if it is a Rev 2 adapter) matches your Denise variant?

cgoffa1, 2021-02-05:
I have the first version of the board.  I bought it pre made and for reference it is installed in an Amiga 500 rev 5.

I will post screenshots as soon as possible

cgoffa1, 2021-02-05:
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

So today the red hue issue was not duplicated.  The flickering pixels continued but I was unable to get them in a screenshot.  Then all of the sudden the thing went haywire and the screen was rolling vertically and acting like it was losing sync.  The screen shot attached kind of shows the distortion.

cgoffa1, 2021-02-05:
I deleted the contents of the sd card and reapplied the firmware but this did not remedy the problem.  For reference I am using the latest release of the firmware.

c0pperdragon, 2021-02-05:
Maybe there is indeed something faulty with your adapter. When you have a Rev.1 this was probably not made by me. Did you already contact the person who built it?  Maybe there is a bad solder joint on one of the ICs?

cgoffa1, 2021-02-05:
I am beginning to agree with you. The build quality of the board is not that good. How can I order one from you?

c0pperdragon, 2021-02-05:
Drop me an e-mail as explained on the bottom of the project main page.  But be aware that there is quite a long waiting list right now.

IanSB, 2021-02-06:
@cgoffa1

The loss of sync and random colour changes do sound like an intermittent contact on one or more of the chips.
To investigate this, you could try gently nudging the legs of the ICs with a pin or needle and anyone that moves will likely be the problem. You might be able to fix it by pressing on any such leg with the clean tip of a soldering iron to remelt any solder but I wouldn't add any new solder as you will likely end up creating a short unless you are experienced with surface mount soldering.
The sync pulses are routed via U2 so that would be a good starting point.

Closed 2021-04-16.

Thread 34 (2021-02-05):

Arduino Testpattern sketch

abrugsch, 2021-02-05:
Does the arduino testpattern.ino sketch still work with the latest released (as of a few days ago) version of RGBtoHDMI?

I'm running it on a regular(328p) arduino mini-pro (it's what I had available). That's not different enough to cause problems with the sketch working is it? I had to remove the power_usb_disable(); call as it doesn't have internal USB and also comment out TIMSK3 = 0x00; and TIMSK4 = 0x00; as those interrupts aren't present, but apart from that, the 328p should behave otherwise identically to a 32u... no?

only i'm not getting any activity from my Pi on my test rig. (well apart from boot colour splash)
I've verified the logic gates are operating correctly with an extended blink sketch, when CDAC is pulsed, it clocks the changes through the flip-flops and I see the outputs toggling. I have also verified that piclk signal is changing at the pi (with a meter, not a scope unfortunately) but no activity when a Pi is attached. I've tried a TV, a monitor and a HDMI capture dongle.

abrugsch, 2021-02-07:
It seems the issue is with the ports for PD1 and OC0B are on different pins on a 328p so it's not quite as straight a port and some pin assignments have to be changed.

It looks like OC0B is pin 6 on a mini pro and PD1 is pin 1.
I still don't get a picture on HDMI but at least there are some garbage lines being generated when reset is pressed...

abrugsch, 2021-02-08:
Success!
the relevant pins for a 328p (nano and mini pro. I'm not sure if bigger ones have the same numbering nomenclature) that need changing are as follows:
#define CDAC    5           // OC0B
#define CSYNC   1            // PD1 (usually marked as TX)

and of course the rest of the video data pins can be set to whatever suits and doesn't conflict with the above

Closed 2021-02-08.

Thread 36 (2021-02-12):

A1000 space constraint

hansliss, 2021-02-12:
The Denise adapter would fit nicely in an A1000, but there's no chance to fit a Raspberry Pi Zero there, since Denise is just next to the PSU. Would it be likely to work if I connect the Pi using a ribbon cable, and place it somewhere else, or would that introduce noise that would ruin the quality?

I'd need to do some motherboard mods for this to create the /CDAC signal and bring that and /CSY to the Denise socket, build a new adapter with a pin header for the Pi, as well as making a suitable ribbon cable, so I prefer to check first whether it's worth it.

c0pperdragon, 2021-02-12:
When the cable is not too long, this could probably work. But you need to find a way to connect it so that the pins are not mixed up. You probably have to solder the pins of the Raspberry Pi upside down.

hansliss, 2021-02-12:
> When the cable is not too long, this could probably work. But you need to find a way to connect it so that the pins are not mixed up. You probably have to solder the pins of the Raspberry Pi upside down.

Yep, you figured that out quickly. It took much longer for me. :) I ended up using individual Dupont cables instead, with non-optimal result. See #28

kipper2k, 2021-02-15:
I have designed an adapter board for the A1000 which doesn't interfere with the PSU and has needed headers for you to attach dupont headers as needed. I will show it off tomorrow

kipper2k, 2021-02-15:
here is a picture of my a1000 adapter board, It is untested, it should work as i modified my A600 board for the A1000

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

here are the gerber files. As i said i have not tested this to please use at your own risk.

[a1000hdmiadapter.zip](https://github.com/c0pperdragon/Amiga-Digital-Video/files/5979117/a1000hdmiadapter.zip)

hansliss, 2021-02-15:
Excellent! Thanks! I will include this in my upcoming PCB order.

c0pperdragon, 2021-02-15:
When you design a board for the A1000 and intend to connect the Pi from it with a ribbon cable, you should include as many GND wires  in the cable as possible. I didn't care too much for my Rev.2 adapter because the GNDs are connected through multiple pins already. On a ribbon cable on the other hand, you need to be much more careful when transmitting power or coupling to GND.

kipper2k, 2021-02-15:
here is my a1000 board layout, it should fit in both Pal/NTSC machines. I had to offset the pi header so the daughter board on the NTSC machine didn't interfere. Please give the layout a good checking to make sure i didn't mess up.

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

here are the Gerber files.

[a1k001.zip.zip](https://github.com/c0pperdragon/Amiga-Digital-Video/files/5984433/a1k001.zip.zip)

hansliss, 2021-02-16:
Nice work! Thanks! I'll include this in the next PCB order and give it a go.

IanSB, 2021-02-16:
@kipper2k
@hansliss

If you still get flickering pixels on some edge transitions as noted in https://github.com/c0pperdragon/Amiga-Digital-Video/issues/28 then try fitting 74VHC parts instead of 74LVC parts.

I had a similar problem with my rev 5 A500 and looking at the 7Mhz and _CDAC lines they had lots of ringing on them which wasn't present on rev 6 or later. Looking at the rev 6 circuit diagram there is some filtering on those lines using a 47R resistor and 47pF capacitor but those components are missing from rev 5 and presumably earlier boards.

After some experimentation I found that fitting the slower 74VHC parts fixed it for my rev 5. Note this is 74VHC not 74HC as the 'V' means they are 5v tolerant when run from lower voltages which isn't the case with HC parts.

abrugsch, 2021-02-16:
@IanSB do you think it might be suitable to add the RC filter to a Rev5? I have a Rev5 here that I was going to add one to and all my ordered parts are 74LVC (is this something that's likely to afflict all Rev5's or just a few?)

IanSB, 2021-02-16:
@abrugsch
>is this something that's likely to afflict all Rev5's or just a few

I don't know, I've only seen it on my own rev5 so far and there haven't been any other confirmed reports but the results were similar to those shown on the A1000 tests. It only seems to happen on some types of screen content like transitions from intensity 7 to intensity 8 which results in all 4 bits of that R/G/B signal changing state.

I have built up quite a few boards and I tried them all in my rev 5 and the results were quite variable from really bad to barely noticeable at all so it depends to some extent on the luck of the draw with the LVC parts.

>do you think it might be suitable to add the RC filter to a Rev5?

I did try filtering the signals going into the LVC parts on the adapter and although it improved things it didn't completely fix it so I guess the signals would have to be filtered on the main board before they go into the Denise chip and I didn't want to start cutting up the main board so I never tried that but it's certainly worth trying if you are OK with cutting tracks on your rev 5.

abrugsch, 2021-02-16:
@IanSB
> so I guess the signals would have to be filtered on the main board before they go into the Denise chip and I didn't want to start cutting up the main board so I never tried that but it's certainly worth trying if you are OK with cutting tracks on your rev 5.
Ah yes that was the sort of mod I was talking about. can you link (or snip) the part of the schematic and I'll see if it's viable. (I'm fine with that sort of mod TBH...)

IanSB, 2021-02-16:
@abrugsch
>can you link (or snip) the part of the schematic and I'll see if it's viable

https://www.amigawiki.org/dnl/schematics/A500_R6.pdf
If you look at page 3 of this rev 6 schematic there are 47R resistors in the _CDAC and 7Mhz lines from the Agnus and 47pf to ground on the _CDAC line plus on page 6 there is a 47pf trimmer on the 7Mhz line. The CCK line  and CCKQ line are similarly filtered and probably would need that to keep everything in phase. I haven't found a rev5 schematic but don't see those components on my rev 5 board.

>do you think it's worth making HC parts the standard in the BOM?

They would have to be tested on later revs to make sure they didn't cause any issues with them. Using the slower parts may reduce the time available to read valid data on each pixel clock cycle. (BTW VHC, not HC)

SirCathal, 2021-03-14:
I made some progress with my Pal A1000
https://github.com/c0pperdragon/Amiga-Digital-Video/issues/28#issuecomment-798964142

Thread 37 (2021-02-17):

A600 Amiga HDMI video design files

kipper2k, 2021-02-17:

kipper2k, 2021-02-17:
Here is my a600 design, tested working fine. It consists of 2 boards and an FFC cable to connect them together.
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

[a600design_gerbers.zip](https://github.com/c0pperdragon/Amiga-Digital-Video/files/5997607/a600design_gerbers.zip)

You can see the small square board sits around the DAC and you simply solder to the pins. This board is connected to the adapter board by a 20pin 0.5mm FFC cable.

abrugsch, 2021-02-18:
Excellent! My A600 is looking forward to this

c0pperdragon, 2021-02-20:
Wow!  This is an ingenious solution for the space problem that a PLCC solution would have.

kipper2k, 2021-02-20:
@c0pperdragon   Thanks for the comment, I have just designed an a500/a1k/a2k design that should fit in all of these models. Hopefully it is all good and if proven good i will release the gerbers on here. I have a couple of other ideas as well that if they pan out i will share.

culexus8, 2021-02-23:
Ohh sweet😁 this I will order and build😁 thank you for this nice design.

tonnyrh, 2021-02-23:
Perfect, just perfect ;-)
Should go nicely with my two Vampire's...

culexus8, 2021-02-24:
This can also be used on the A500 if we make a new adapter for Denise so it only use the ffc cable over to your board klipper2k. This may give more room for other addon boards, I see allot of People strugle with space in the A500.

tonnyrh, 2021-02-24:
1. I uploaded the Gerber file to PCBWay, and they found an issue.
"For the PCB order #W373462ASR4_A600 Denise pushon.zip,here's an issue:
here's the rectangle silkscreen in every single layer in the Gerber,here must be something wrong when you export the file?
Please revise the file and upload correct one for review."

**I might dive into it, but just a note.**

2. Any thoughts on how to put OSD Gotek connected?

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

kipper2k, 2021-02-24:
i had this done by jlcpcb so not sure what issue is with pcbway. The inner square is identified by dimension layer

seb132, 2021-02-24:
>
>
> Wow! This is an ingenious solution for the space problem that a PLCC solution would have.

kipper2k is always thinking out-of-the-box to resolve problems with simple solutions... 👍

culexus8, 2021-02-24:
I did my order with kippers2k gerb files on jlcpcb and had no problems. I was going to order it from pcbway but just never tested jlcpcb before.

kikendo, 2021-02-24:
This does not look like it will fit if you have an ACA620, ACA630 or Fúria.

kikendo, 2021-02-24:
This does not look like it will fit if you have an accelerator.

kipper2k, 2021-02-24:
it will fit, it sits lower than all of the custom chips
all a600 accels will fit

culexus8, 2021-02-24:
looks like it will fit yes.

kipper2k, 2021-02-24:
just to prove it, here is one of my a600s...
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

kipper2k, 2021-02-24:
k, 1 more picture to prove its not an illusion...

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

tonnyrh, 2021-02-25:
PCBway finally accepted, but:
jlcpcb  charges 6 $ for all (5 of each PCB=10), while PCBway charge 56 $ !!!
...Thats a nobraner where my order goes ;-)
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

kipper2k, 2021-02-25:
yah, pcbway charge more for any design that uses 0.005" traces, if i had used 0.006" then price would be comparable. I prefer to use the smaller traces for boards that need  a high density of traces so in this case JLC wins.

ryanm101, 2021-03-01:
I was trying to do something like the QSB here: https://castlemaniagames.com/products/xstation

struggling with kicad to get the traces and the breakout points right.. but the idea was to mimic the install points against the resistor..

My other plan B was if i just created a board that fitted in the RF slot and mounted to the RF PCB holes I could pull the 5v and GND from the RF pins then just run the short wires from the resistor points to there and then mount the Pi to the PCB that is over the RF area. Further thought was was their a way to break the HDMI port to that board and connect the Pi HDMI to the board instead.. but i think angles and size of solder points might be too difficult.

abrugsch, 2021-03-04:
@kipper2k what's the value of C5? same as C4 or higher?

culexus8, 2021-03-05:
I will use the same as C4, it is just the 5V power side so if there is any problem you can always add more later.

kipper2k, 2021-03-06:
yup, C4 is 0.1Uf

culexus8, 2021-03-06:
Did you test any shorter ffc cable to see if you got rid of any artifacts?

kipper2k, 2021-03-06:
I am waiting for the 6cm cables to arrive from ebay. Unfortunately there is no local purchase option

culexus8, 2021-03-07:
Aha, I will get some 10cm soon I hope, you know ebay is slow😊 still have some parts to order from mouser, will see if the may have some in stock just to test with.

abrugsch, 2021-03-10:
I have 11cm coming from LCSC. parts are in the country. boards... still in china 😭

kipper2k, 2021-03-12:
here is a little video of the hdmi adapter using a shorter cable i got from digikey.

here is link... http://www.kipper2k.com/pics/a600hdmi.mp4

abrugsch, 2021-03-12:
How long is that @kipper2k ? My 11cm ones arrived today, but boards haven't left china yet... 😭

kipper2k, 2021-03-12:
link is 5 posts up :)

abrugsch, 2021-03-12:
Bleh... I somehow read your last post as ebay so thought it was different to your digikey link... Well friday evening is already in full swing so i blame the Guiness 🤣

culexus8, 2021-03-12:
When I did the first A600 mod I also had some problems, but it all was how I placed the ribbon cable inside the A600 and also changing the powersupply (ordered a new one from icomp). But keeping the cables short is a good idea, so hope the ones from mouser that is 75mm long will performe. Just waiting on parts from mouser to get this up and running.

tonnyrh, 2021-04-01:
U have soldered up and made mine work. Basically used same components as on my Amiga 500 version that works excellent. I do not get white dots but a bit «jaggered» screen.

kipper2k, 2021-04-01:
some hdmi cables are the culprit and not just the device itself. I have seen cheap ones work while expensive ones fail.  I will redo design a bit to use surface mount 16 pin IDE type cable, i have a few things on my plate atm so it would be a couple of weeks.. A shorter cable does make a difference.

tonnyrh, 2021-04-01:
> some hdmi cables are the culprit and not just the device itself. I have seen cheap ones work while expensive ones fail. I will redo design a bit to use surface mount 16 pin IDE type cable, i have a few things on my plate atm so it would be a couple of weeks.. A shorter cable does make a difference.

I use the same cable and setup as for my 500 as shown here: https://youtu.be/G7NAuNks2u4

But this is (great) engineering in progress and a hobby, so its what it is ;-)

c0pperdragon, 2021-04-02:
You can tweak the csync sampling in the settings menu.  It ist the item with values like +ve -ve  or so.

tonnyrh, 2021-04-02:
3'rd try.

Seems like my problems is connected to the blue color.

Question is if its the Raspberry, the RGB2HDMI mainboard, the ribbon or the IC adaptor....

https://youtu.be/cyXWDphq5f4

culexus8, 2021-04-06:
Hi :) Finaly got the time to test this design out and as you may expect I also got trouble whit this adaptor, testet 3 different FCC cables from 15,10 and 7 cm long. All of them gave me fussy image and problems. So I then wraped the cable in copper foil to make a shield and also grounded it to see if there was any changes. But no improvement where made, so I digget out my scope to see if I would find any problems with the clock signal, and yes it was not like it should be. The timing was off compared to how it should be, I then supected that there might be the clock signal that was wrong. Since I did the  A600 board that c0pperdragon designed "small" version I discovvered that if I used the 7Mhz_A signal I got perfect timing compared to R3 color. So I then looked at the kipper2k breakout board and found the issue right away, the cdac was connected to pin37 of denise. so by changing this to pin38 and feeding the 7Mhz_A signal to the cdac point of the breakout board gave me rock solid picture even with 15cm FCC cable.  So if some one else would try this out and confirm that this is the problem, please do so :) No tweaking where done in the software, all run perfect with stock settings so far.

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

tonnyrh, 2021-04-06:
Confirming. Works great now ;-)

Thank you all ;-)

https://youtu.be/8wrpzLcjNGs

culexus8, 2021-04-06:
Hey Kipper2k:)

I think your board is just a perfect board for all of the systems, your board is versatile and can be used for many more systems than just the A600. What if there was made a breakout board that you could solder on the underside of the A500 motherboard  so the denise just stays put and wee feed the signals trough the FCC cable to you board. I think there should be space for it.

The big thing about it is that it will give space for any accelerator that sists in the cpu socket. With the current design for A500 it gets tight. It is a good desing but we need more space  :)

kipper2k, 2021-04-07:
Thanks for the kind words, My CDTV version will be here this week, it will allow the closing of the case and has a nice plate with it. My new a500 version allows the cable to sit towards the rear of the case and will fit in the A1000's also. I'll release the new a500 version soon and will test the CDTV version out. The new A500 design will allow the upcoming "buffee" and the new multi function A500 addon board i have almost finished to fit inside the a500 case with the case closed also :)

solarmon, 2021-04-07:
I thought that the 7Mhz signal should be used for an ECS Denise? And that CDAC should be used for OCS Denise. That is what the jumper is for on the RGBtoHDMI v2 board.

culexus8, 2021-04-07:
> Thanks for the kind words, My CDTV version will be here this week, it will allow the closing of the case and has a nice plate with it. My new a500 version allows the cable to sit towards the rear of the case and will fit in the A1000's also. I'll release the new a500 version soon and will test the CDTV version out. The new A500 design will allow the upcoming "buffee" and the new multi function A500 addon board i have almost finished to fit inside the a500 case with the case closed also :)

Sounds nice :) looking forward to see the new boards. Do you have any more info on your multi function A500 addon board and what is ?

culexus8, 2021-04-07:
> I thought that the 7Mhz signal should be used for an ECS Denise? And that CDAC should be used for OCS Denise. That is what the jumper is for on the RGBtoHDMI v2 board.

I think you are totaly right. :)

kipper2k, 2021-04-08:
i have redone the pushon board, here is updated pic of it...
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

ad here is the updated gerber file, it is now V1.0 which is still compatible with my original Denise board

[A600 Denise pushonv1.zip](https://github.com/c0pperdragon/Amiga-Digital-Video/files/6278541/A600.Denise.pushonv1.zip)

kipper2k, 2021-04-09:
k, i redone the layout for the a600 HDMI2RGB board and this is what i came up with. It should not interfere with any addons. I will release the STL file for the support once i finished tweaking.

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

 Picture quality is great,  :)

abrugsch, 2021-04-09:
That looks very neat @kipper2k. Thank you for the updated file. I've ordered some from JLC to go with my initial batch. (If only I'd remembered to use my "jlcfactory" code but meh. It's only 2 bucks off...)

abrugsch, 2021-09-15:
@kipper2k did you ever finish tweaking the STL file for the support?

Aether2013, 2021-11-20:
Does anyone have a BOM for the pimate2?

culexus8, 2021-11-20:
> Does anyone have a BOM for the pimate2?

What is a pimate2?

Aether2013, 2021-11-20:
The board that connects the A600 Denise Pushon, to the Pi-Zero.

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

Thread 38 (2021-02-20):

Additional GPIO pins

dlasher, 2021-02-20:
So would something like this : https://www.robotshop.com/en/io-hat-raspberry-pi-zero.html

help with the need for additional pins to handle more bitplanes? (IE A1200/A4000) ?

dlasher, 2021-02-20:
( posting in the right place : https://github.com/hoglet67/RGBtoHDMI/issues/187 )

Closed 2021-02-20.

Thread 39 (2021-03-05):

Pin header strip alignment

solarmon, 2021-03-05:
Hi,
I just built my first RGBtoHDMI v2 board but having some trouble with the pin header strip alignment to the Denise socket on the motherboard (of an rev 8A A500plus).

Using a bare board you can see how the holes line up with the Denise socket holes.

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

I'm using the pin headers from:

https://lcsc.com/product-detail/Pin-Header-Female-Header_BOOMELE-Boom-Precision-Elec-C9742_C9742.html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

Which are different from the longer and thinner ones like at:

https://www.ebay.co.uk/itm/Uk-2-Gold-Plated-2-54mm-40-Pin-Single-Row-Straight-Round-Pin-Header-Strips/324430051449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

When I use the pin headers from LCSC, they do not seem to be line up with the Denise socket holes and I cannot get it to fit in to the socket:

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

Can somebody offer some advice on what header pins should be used and if there is any special build instructions for them.

Thank you.

kipper2k, 2021-03-06:
for the header pins to connect to Denise socket you should use something like these...

 search in ebay "5Pcs Gold Plated 2.54mm Male 40 Pin Single Row Straight Round Pin Header Strip". Look for the best prices.  I set the vias at 0.025" drill and 0.050" diameter, this allows traces to be fed through the pind with lots of room

solarmon, 2021-03-06:
@kipper2k

Yes, I found those types of headers, as per my eBay link. I actually found some I have purchased previously, so I will try a build with those.

The short thicker round pin headers just don't have enough give, but it may still be possible if it was angled slightly during the build.

solarmon, 2021-03-06:
I tried with the longer/thinner pin headers and they definitely fit better!

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

Oh well, lesson learnt. Those other pins are just too thick and doesn't have much give.

kipper2k, 2021-03-08:
The  longer thiner ones are better as they dont stretch the sockets too bad and for the end user who puts the socket in, it is less likely to be removed too often and they are easier to replace if broken

Thread 40 (2021-03-05):

Pi Zero relocation adapter boards - video artefacts - pixel 'sparkles' on edges

solarmon, 2021-03-05:
Hi,

I'm testing out several Pi Zero relocation adapters - there are three types: A, B and C:

Type A is just flips it over:

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

Type B shifts it sideways and flips it:

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

Type C shifts it sideways, flips it and rotate it:

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

Type A works fine without any issues.

However, type B and C has video artefacts where on certain edges there are pixel 'sparkles' artefacts.

I'm aware that this is due to the increased signal traces, but is there anything that could be done to improve it?

Thank you.

kipper2k, 2021-03-06:
shorter tracks definitely increase performance, if you increase track lengths then you should ensure that decoupling caps are as close to IC's as possible. Also extending the board over other areas of the Amiga motherboard can also pickup unwanted noise from the motherboard so you may have to reduce board length and location to reduce the noise

solarmon, 2021-03-06:
@kipper2k

Regarding your comment about caps being close to IC's as possible. These are just relocation boards for the Pi connector. I'm not changing anything with the RGBtoHDMI boards.

The artefacts only appear at 'edges' - where an area of colour changes to another. It's hard for me to capture that, but you can see the white pixel in this (poor quality) picture. These white pixels appear and disappear randomly on such 'edges':

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

Why would it only appear at these edges?

solarmon, 2021-03-06:
I'm actually seeing this shimmering/sparkle artefact using a normal RGBtoHDMI setup - i.e. no relocator or anything.

With the normal setup setup, in the Amiga Test Kit screen, I don't see these artefacts.

However, when I load up workbench, the artefacst appear on the right hand side of any black areas next to lighter areas.

For example:

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

It is always on the right hand side of the contrasting edge, if that is of significance.

I haven't checked the RGBtoHDMI menu options yet. Maybe there are some settings I need to tweak?

de-nugan, 2021-03-06:
This is the same fault I wrote about here =>  https://github.com/c0pperdragon/Amiga-Digital-Video/issues/11#issuecomment-769056224

I'm also using a slightly longer connection through a very short IDC cable. I tested a longer cable and saw increased sparkles and artifacts so the length does appear to be critical. I haven't been able to test the 'default' setup as I don't have any of the female pin sockets, so I may have to solder the Pi to the board and try that instead.

solarmon, 2021-03-06:
So I think I have narrowed down the issue a bit. It seems this issue is only specific to this X-Copy disk I'm using to test. Everything else I've tried so far has been rock solid. The X-Copy disk I'm using is created from the xcopy_1992-11_en_1200.adf image (http://jope.fi/xcopy/zip/xcopy_1992-11_en_1200.zip). If somebody is able to test this out and check if they have the same issue. (You need to press F10 to go in to Workbench mode).

solarmon, 2021-03-06:
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

If this issue with my relocator boards can't be fixed then I still have the option using my custom RGBtoHDMI that I'm designing and which relocates the Pi board too. Hopefully that won't have the same issue, but  I still need to get these custom boards made and tested.

IanSB, 2021-03-07:
@solarmon
Try replacing the 74LVC parts with 74VHC parts. These are slower and fixed the sparkly problem on my rev5 which doesn't have the clock filtering components that are fitted on rev6 & later boards which slightly delay the clock signals.
Note they must be 74VHC parts which are 5v tolerant, not 74HC parts which are not 5v tolerant when powered at 3.3v

@de-nugan
I also suggest you try the above to fix your issue in  https://github.com/c0pperdragon/Amiga-Digital-Video/issues/11

solarmon, 2021-03-07:
@IanSB

Thanks for the suggestion for replacement parts. When you say 'these are slower' - do you mean the 74LVC  or the 74VHC part?

I had already got a batch of the 74LVC parts because that was what was suggested in the schematics. ='(

For reference, these are the parts from LCSC:

U1!: https://lcsc.com/product-detail/74-Series_Nexperia-74LVC86APW-118_C6102.html
U2 and U3: https://lcsc.com/product-detail/74-Series_Nexperia-74LVC574APW_C6098.html

Can you confirm these are the suitable replacement.

U1: https://lcsc.com/product-detail/Pre-ordered-Products_ON-Semiconductor-ON-74VHC86MTCX_C903423.html
U2 and U3: https://lcsc.com/product-detail/Flip-Flops_ON-Semiconductor-ON-MC74VHC574DTR2G_C364877.html

However, the U1 74VHC86MTCX part is not in stock on LCSC.

Are you suggesting that U1, U2 and U3 should all use replacement parts?

IanSB, 2021-03-07:
@solarmon
>When you say 'these are slower' - do you mean the 74LVC or the 74VHC part?

The VHC parts are slower. Their propagation delay is about double that of the LVC parts and that allows a longer settle time before latching the data bits.

>Are you suggesting that U1, U2 and U3 should all use replacement parts?

Yes although changing U1 (74LVC86) which handles the clock signal has the most effect so try that first if you are changing parts on an existing board.

>Can you confirm these are the suitable replacement.

They look to be the correct family although I used these toshiba parts from RS:
https://uk.rs-online.com/web/p/products/1713480/
https://uk.rs-online.com/web/p/products/1713428/

solarmon, 2021-03-07:
@IanSB

Thanks for the parts link from RS. I'm UK based, so that suits me fine.

BTW - these issues (sparkles due to relocation board, and sparkles using a specific version of X-Copy, and Xenon II) happens on a n A500 rev 6A and an A500plus rev 8A.

IanSB, 2021-03-07:
>Thanks for the parts link from RS. I'm UK based, so that suits me fine.

The VHC86 parts have gone up a lot in price, I paid £0.056 each a few weeks ago, they are now £0.217 each.
The VHC574 parts haven't gone up (yet!)

>BTW - these issues (sparkles due to relocation board, and sparkles using a specific version of X-Copy, and Xenon II) happens on a n A500 rev 6A and an A500plus rev 8A.

Can't guarantee they will fix your issue but they did fix mine.

de-nugan, 2021-03-07:
To achieve the shortest possible data path I've just soldered the Pi to the adapter board and this appears to have fixed the sparkle problem. In WB3.1 the sparkles and glitches are now gone, and the screen geometry is now absolutely bang-on pixel perfect straight out of the box.

This is on my Rev 5 (Assy 312513) A500. The parts used were Nexperia 74LVC574APW.

I'll be building more boards for some other Amigas, do you know if the VHC tip applies to any of the A/B2000 revisions?

matthiesenj, 2021-03-08:
For HC parts, you should use VHCT or AHCT, which have TTL-compatible inputs.
The point about propagation delay is probably relevant, since the original c0pperdragon design relies on the propagation delay of two gates to generate the 14MHz flipflop clock.

solarmon, 2021-03-08:
@matthiesenj

I'm confused now - @IanSB mentioned '74VHC' parts and now you are mentioning 'VHCT' parts! Are they different? I've already ordered the  '74VHC' parts.

matthiesenj, 2021-03-08:
@solarmon your Amiga uses 5V TTL signal levels - the inputs on the (T) variants are specifically designed for the TTL low/high signal thresholds. If you already ordered parts, you can just try them - IanSB says they work for him and they won't hurt anything, but since this thread is about signal integrity problems, I thought I would mention it :-) The AHCT also has schmitt-triggers on the inputs which can also help correct sampling of noisy input signals.

If you're exchanging parts on a populated board, try changing the 86 first to see if it fixes your glitches..

solarmon, 2021-03-08:
@matthiesenj Thanks for clearing that up!

It's going to be easier for me to build new boards - re-working the existing ones probably not going to work with just a normal soldering iron!

solarmon, 2021-03-09:
@c0pperdragon

I'd thought I'd reply in this ticket, as opposed to https://github.com/c0pperdragon/Amiga-Digital-Video/issues/11#issuecomment-793126725

This is my setup, including my relocator. You can also see how I have made my bank of 27pF capacitors:

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

Connecting this bank of capacitors to PiSYNC (GPIO23) and GND does not seem to make any difference to the sparkles.

However, if I connect it to PiCLK (GPIO17) I do see a significant difference - it doesn't get rid of it completely, but there is a visible difference. I'll try adding more caps to the bank and see if it makes any further improvements.

solarmon, 2021-03-09:
@c0pperdragon LOL! It happens! No problem.

What I'm also finding is that different RGBtoHDMI v2 boards have slightly different behaviour. The difference at the moment, is that  the one with the thicker pins has less artefacts than the thinner pins. I'm not sure whether it is because of those pins, or something slightly different in my soldering of those boards. It's only small sample at the moment, but there is some difference.

How this effect what capacitance value to use for PiCLK I need to try to test. Also, when I get the '74VHC' parts I will find out whether that makes a difference too.

solarmon, 2021-03-09:
@IanSB

I meant the different RGBtoHDMI v2 boards I currently have, all using the same chips. The only difference is that the first one I used the thicker pins. Subsequent ones I used the thinner pins.  The first one (with thicker pins) seem to have less video artefacts.

But I can't come to any explanation yet since the this is only testing with a few boards.

IanSB, 2021-03-09:
>I meant the different RGBtoHDMI v2 boards I currently have, all using the same chips.

I know, what I meant was the difference in noise is due to the chips themselves. If you swappped the chips on two of your boards the noise would swap as well.

solarmon, 2021-03-09:
> I know, what I meant was the difference in noise is due to the chips themselves. If you swapped the chips on two of your boards the noise would swap as well.

Ah, right, gotcha! That is very surprising then, that it would cause that much of a difference.

c0pperdragon, 2021-03-09:
The whole matter of the parkly pixels is very confused by the fact that there are two completely independent possible causes:

1. The adapter can not reliably latch the color data. This can be caused by using the wrong data sample point (Denise vs. SuperDenise jumper) or by some other glitchy behaviour of the main board. Specifically A500 Rev.5 boards seem to not filter the CDAC clock signal properly. I guess this is mainly causing IanSB's trouble. One cure seems to be to use logic ICs that are less sensitive to high-frequency noise.

2. The signals from the adapter to the Pi do not arrive at a suitable time. The adapter adds only a very short extra delay (2 LVC gate transition times) to the output clock. So the Pi seems to not always be able already see the correct color data on the edge transitions of the clock. This is especially true when using longer leads between adapter and Pi. I proposed to just add a small capacitor to delay the clock a bit. This seems to work in some circumstances. A more proper soution would be to add more logic gates in the signal path and use their transition times. Maybe a series of simple inverter gates could do the trick.

matthiesenj, 2021-03-09:
@c0pperdragon very true about the 2 possible causes.

Regarding 1), did you measure the (hires) pixel transition timing in relation to e.g. /CDAC for denise/superdenise? Are they borderline with respect to the flipflop setup/hold times?

c0pperdragon, 2021-03-09:
I did measure the Denise timings and the were pretty safe when using the edges from _CDAC.
Other users did try SuperDenise with _CDAC edges amd there sampling was very borderline. Sometimes it worked just fine, sometimes it caused glitches. So I extrapolated that the sweet spot for SuperDenise would be right between the edges of _CDAC and therefore used the edges of the 7MHz clock instead. This seemed to work basically flawless on SuperDenise so far.

solarmon, 2021-03-09:
@c0pperdragon The 74VHC chips came and I built another RGBtoHDMI v2 using these chips.

I can happily report For a normal setup (no relocator) I now do not get any percieveable sparkles when using X-Copy (Oct 92) workbench or when using DiagROM 1.2.1 (I recently noticed the issue with this recently, but hadn't reported it yet), or in Xenon II (1 disk version).

Even using my relocator board, this has drastically reduced the sparkles to nearly gone. I can still see pink sparkles (on blabk/light grey edges) if I look very closely/carefully. Maybe that could be improved further with a suitable cap across PiCLK and GND, but I'm very happy with the results!

IanSB, 2021-03-09:
@solarmon
>I can happily report For a normal setup (no relocator) I now do not get any percieveable sparkles when using X-Copy (Oct 92)

Thanks for confirming they fix your issues. I suspect the problems with the extender boards are caused by reflections due to the long PCB tracks.

FYI I have designed an Amiga pickup board for the CPLD version which allows the Pi to be placed anywhere on a long ribbon cable (mainly meant for external use) which is similar to the Atari solution shown in https://github.com/c0pperdragon/Amiga-Digital-Video/issues/6#issuecomment-770140199

LinuxJedi, 2021-03-09:
> Thanks for confirming they fix your issues. I suspect the problems with the extender boards are caused by reflections due to the long PCB tracks.

In which case a resistor may help with the reflection?

matthiesenj, 2021-03-09:
@LinuxJedi yes, series resistors on the flipflop outputs could help eliminate reflections - some logic families even incorporate series output resistors on-chip, but I haven't found such a device to directly replace the LVC574..

https://www.ti.com/lit/an/scba012a/scba012a.pdf

LinuxJedi, 2021-03-09:
> @LinuxJedi yes, series resistors on the flipflop outputs could help eliminate reflections - some logic families even incorporate series output resistors on-chip, e.g. AHC574 (which can directly replace the LVC574)..
>
> https://www.ti.com/lit/an/scba012a/scba012a.pdf

Are you sure about the AHC574? I can't see it on the datasheet. I believe the NXP ICs have it in LVC and similar if they have a '2' in them, but there is only the 374 in that so it would need rewiring.

solarmon, 2021-03-10:
@c0pperdragon
Is this what you were trying to do with this part of the circuit?

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

I wouldn't have the expertise to try to find a suitable fix, but what about feeding back the PiCLK signal to one of the spare not used input/output on the existing logic chip? Or will that still not delay it enough?

LinuxJedi, 2021-03-10:
I think whilst @c0pperdragon's v1/v2 solution is fantastic work and for a majority of people it will work great, @IanSB may be right and a xc9572xl based solution may be the way to solve these minor issues long-term. Should even be able to fit it into the same physical profile as the c0pperdragon adaptor.

c0pperdragon, 2021-03-10:
I still think this is total overkill for an internal solution. It is probalbly really only a matter of fixing the setup times.

solarmon, 2021-03-10:
> Yes, I used the one spare gate on the XOR for delay. It seems that this is yet not enough in sone circumstances. The free bits on the flipflops can not be used for that, though.
> When you are using the adapter jumpered to Denise mode, you could actually repurpose one of the XOR gates. But this requires modifying the adapter in some irreversible way. But maybe this one gate transition would be just enough.

I'm designing building my own RGBtoHDMI board, that also relocates the Pi. I could add this to the design (as well as an optional cap on PiCLK) and try it out.

solarmon, 2021-03-10:
@c0pperdragon

Oh, you mean the U1 chip. I was talking about the spare input/output on the U3 chip, Would that work - using U3?

solarmon, 2021-03-10:
@c0pperdragon

OK, understood.

Would a dual inverter like these 74HC2G14-Q100/74HCT2G14-Q100 be suitable.

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

I was looking to remove the 3.3V regulator anyways, so this could just fit in its place footprint wise.

LinuxJedi, 2021-03-10:
Really dumb question time based on me looking at the Denise datasheet: would an AND of 7MHz and CDAC to the flip-flops clock work with straight CDAC to the PiCLK? Or is the flip-flop latency also part of the problem?

solarmon, 2021-03-10:
Actually, this SN74LVC2G04 seems more suitable (or equivalent), as the output should be 3.3.V instead of 5V.

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

c0pperdragon, 2021-03-10:
The HC inverters are probably better. HC is slower than LVC which is exactly what you need for delay. Also the signals edges are not so sharp and will cause less trouble.  HC can also run with 3.3V without issue  (not HCT, though!).
Schmitt-Trigger characteristic (74HC14) is not necessary, but should not hurt either.

c0pperdragon, 2021-03-10:
> Really dumb question time based on me looking at the Denise datasheet: would an AND of 7MHz and CDAC to the flip-flops clock work with straight CDAC to the PiCLK? Or is the flip-flop latency also part of the problem?

The flip-flops sample the bits at the positive edge of the clock input. So you need something that goes high twice in a single system clock cycle (high-res pixels are generated at about 14MHz). This is done with by strangle looking XOR circuit which goes high whenever the input clock changes.
AND-Combining CDAC and 7MHz would only generate a 7Mhz clock with 25% duty cycle. I don't know what this should achieve.

solarmon, 2021-03-10:
@c0pperdragon

I came up with this updated schematic to add in the dual inverters and the option switch. Is this what you had envisaged?:

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

LinuxJedi, 2021-03-10:
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

Ah! The bit I was missing was the high-res 14MHz. I was thinking that this would help with the time between 7MHz rising edge and making sure that the colour lines were setup. IIRC 7MHz rises first and then CDAC so reading between the rise of CDAC and fall of 7MHz seemed like something that might work. But yea, high-res screws all that up :

matthiesenj, 2021-03-10:
@LinuxJedi yes, according to the document I linked, TI AHC parts are "light drive".. In the 74AHC574 datasheet it is also mentioned that it's designed for driving capacitive/low impedance loads and only has 4mA drive capability: https://www.ti.com/lit/ds/symlink/sn74ahc574.pdf

c0pperdragon, 2021-03-10:
@solarmon
Yes, this is what I meant.  If you leave away the voltage regulator and draw the 3.3V from the Pi, you should have enough space for that.

solarmon, 2021-03-10:
@c0pperdragon

I still need to figure out and finalise the trace routing (it's a bit of a squeeze!) but I was hoping the board layout would be something like this.

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

c0pperdragon, 2021-03-10:
This looks actually pretty neat. It is hard to follow the details, specifically how the power supply is connected, but I just trust you on that.

solarmon, 2021-03-10:
@c0pperdragon Had to redo some of the traces to fit everything in, but I've managed to connect everything up.  I've sent you the KiCAD files for you to take a look at.

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

matthiesenj, 2021-03-10:
@solarmon did you exchange the 1uF cap for a 10nF one? I don't think that's a good idea - you should rather increase it if anything.

solarmon, 2021-03-10:
> @solarmon did you exchange the 1uF cap for a 10nF one? I don't think that's a good idea - you should rather increase it if anything.

The 10uF cap is for the 3.3V supply from the Pi. I took the power supply design from the RGBtoHDMI small adapter board design.

solarmon, 2021-03-10:
Oops! Looks like C5 is meant to be 10uF, not 10nF.

solarmon, 2021-03-10:
I thought I'd also add FlashFloppy OSD support, as per https://github.com/c0pperdragon/Amiga-Digital-Video/issues/26

The BP1 connection goes to PB15 on the Blue Pill and the R2 1K resistor goes to Pin 18 (GPIO24) of the Pi header.

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

IanSB, 2021-03-11:
@solarmon
>I came up with this updated schematic to add in the dual inverters and the option switch. Is this what you had envisaged?

That may not work as you are only delaying the PiClk signal into the Pi and I think the problem is that the 574 chips have already latched invalid data. From my own tests the only thing that worked at all was delaying _CDAC before feeding into the rest of the system.

c0pperdragon, 2021-03-11:
@IanSB  This heavily depends on the actual cause of the issue, as there are two completely distinct possibilities.

matthiesenj, 2021-03-11:
How does the Pi read the pixel data? Are all the GPIO inputs continuously polled as one 32 bit word, then monitored for changes to the PiClk bit, and if changed, the rest of the word fed on for further processing? Or does it read the GPIO port multiple times per pixel?

solarmon, 2021-03-11:
I was testing my VHC parts build and found a colour combination that caused a different kind of sparkling artefact. These were sub-pixel (Amiga pixels) sparkles, which are different to the full-pixel (Amiga pixels) sparkles I saw previously.

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

IanSB, 2021-03-11:
@solarmon
>These were sub-pixel (Amiga pixels) sparkles,

What resolution were you using at the time?

solarmon, 2021-03-11:
> What resolution were you using at the time?

@IanSB

It was just OCS standard 320×256 LowRes 4 colours.

When I say "sub-pixel" I meant that the sparkles artefacts were much smaller than the Amiga pixels itself, as can be seen by the pictures. As if it is something to do with the HDMI graphics processing of the monitor at 1080p resolution that was somehow affected.

I thought it was a problem with my HDMI cable setup - I was using a 1m flex cable at the time. Powered off and swapped  to a normal HDMI cable and I could not replicate the issue. However,, when I put back the HDMI flex cable, I still could not replicate the issue again. and I still can't, so I can't troubleshoot it further.

IanSB, 2021-03-11:
@ solarmon
>As if it is something to do with the HDMI graphics processing of the monitor at 1080p resolution

That definitely looks like HDMI noise as the pixels are too small to be a capture side problem. Perhaps it was caused by a HDMI cabling issue due to poor connection on one of the signals which went away when everything was reseated. Are you using a mini HDMI to HDMI adapter with the cable as that can exacerbate things like that.

You can test for HDMI problems by using the screencap option (short press of button). If the HDMI output is noisy but the screencap png files on the SD card are clean then the problem is on the HDMI interface and likely a cabling issue. (There is an option that can be added to Pi's config.txt file (config_hdmi_boost) to increase the switching strength of the HDMI signals and that can help with marginal cabling problems)

solarmon, 2021-03-11:
@IanSB

Well, the issue was similar in the sense that as I moved the colour slider, the artefact 'noise' changed - either increase, reduced or disappear based on the colour.

Until I get this issue again then I can't troubleshoot it further I know next time I will reseat the HDMI connector first, or swap HDMI cables, without powering down.

solarmon, 2021-03-11:
> You can test for HDMI problems by using the screencap option (short press of button).

Thanks! I was not aware of this feature - it will come in very useful!

solarmon, 2021-03-12:
@c0pperdragon

Would a DS1100L be even more suitable to add the delay? You can select delays between 4ns to 500ns.

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

c0pperdragon, 2021-03-12:
Very nice. I didn't know such ICs actualy exist in this form. They are a quite expensive, tough.

solarmon, 2021-03-12:
> Very nice. I didn't know such ICs actualy exist in this form. They are a quite expensive, tough.

Yes, I just checked prices on LCSC - £6.42 for one!

kipper2k, 2021-03-31:
utsource has a better price... https://www.utsource.net/sch/ds1100l.html

solarmon, 2021-03-31:
@kipper2k

Thanks for the link.

If using the dual inverters doesn't work on my board, then I will probably try out a board design using the DS1100L chip.

solarmon, 2021-04-08:
My custom PCB boards arrived and I built it with LVC parts with the aim of getting pixels sparkles and testing the extra delay circuit.

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

However, I get no pixel sparkles with this particular build. I'm using the same A500 and Denise OCS chip as previously which had pixel sparkles (with the original RGBtoHDMI v2 board and using LVC parts). Which is annoying to say the least!

I have some custom RGBtoHDMI v2 boards too that I will build with LVC parts and see if that has pixel sparkles and whether the extra delay circuit fixes it.

solarmon, 2021-04-09:
I also tested my "v2+" and "v2++" boards:

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

However, again, annoyingly, building them with VLC parts I don't get any pixel sparkles. So I can't test the extra delay circuit and whether they do anything useful or not.

What is different now is that I've tweaked the mask clearances on these board designs (so that mask clearance is not the same and copper pout/zone clearances). And also I am using new flux - I had lots of build issues and I suspected issues with the flux. So I might build some boards with my suspect flux and see if I get the same issues.

solarmon, 2021-04-10:
So I built v2+ board using LVC parts and using my suspect flux.

The board had lots of sync issues - even on the Amiga side, losing colour and sync. Changing to the delayed PiCLK signal didn't seem to make any difference.

I haven't got an ultrasonic cleaner and it seems manually cleaning with IPA and cotton bud doesn't get rid of the flux between the TSSOP chip pins - like so:

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

What I have noticed is when I measure resistance to ground (megaohms mode), some/alot of the header pins gives a reading. If the reading is less then a megaohm then you
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

Thread 42 (2021-03-11):

Strange video issue

aiobofh, 2021-03-11:
Hi there!

I have this very strange video issue. Picture looks crisp clear, but with three ribbons of weirdly (wedge-)shaped garble horizontally..

When first turned on, they move a (very) little bit vertically, but after that, they stay where they are on the photo.

Any spontaneous ideas?
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

B.t.w. This is running on a Rev5 A500, with kickrom-adapter and kickstart 1.3 on EPROM. Analog video output looks amazing. This board was bought from and built by a 3rd party. I soldered the headers to the pi and went through them again this morning the solder joints there look fine, added a bit of solder to a couple of them where i may have been a bit quick last night. Anyway. Same issue still. There are no other interesting wires needed for Rev5-boards that i have may have missed?

aiobofh, 2021-03-12:
... Addition.... I tried another monitor than the TV i took the photo of above.. (That TV has been quite friendly with all other sources i've thrown at it... So this is weird.). Result on my workstation monitor:

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

... How come?

IanSB, 2021-03-12:
@aiobofh
>How come?

The first monitor probably doesn't like the non-standard timings produced by the genlock.

First thing to try is manually changing the resolution to 1920x1080 and the refresh to 50Hz. (Assuming that's a 1080p monitor)
This will produce a more standard 1080p 50Hz output but it will still be a little off frequency due to the genlock.

If that doesn't work then try switching the genlock off in the settings menu although that means the video output won't be locked to the input so you might get tears and dropped/repeated frames.

aiobofh, 2021-03-12:
@IanSB right you are!

Strange that that otherwise friendly TV did not like it. Anyhow. End-goal was to have crisp up-scaled picture in the livingroom TV. Just tried it out there and it works fine! Thanks for the tip!

End result:

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

Closed 2021-03-12.

Thread 43 (2021-03-14):

A2000 slot adaptor build observations

LinuxJedi, 2021-03-14:
I've built several of these boards for friends and have been using 3 different IC for U1/U5:

- Nexperia 74LVC86
- TI SN74LVC86
- Toshiba 74VHC86

The ones using the Nexperia ICs after a while fail with random bursts of this pattern for a second or two when in Super Denise mode:
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

I can think of two possible reasons for this:

1. U5 IC has inputs that are left floating, this typically causes issues with CMOS ICs. I believe the VHC's design makes this less of an issue.
2. The specified regulator is 300mA, there are 4 ICs on the board and judging by the data sheet they can draw up to 100mA each for the LVC range. Again VHC can probably help here as they are rated for 50mA (75mA for the 574 if you want to switch that too).

It could even be a combination of both, the floating input causes a high power draw which is causing too much load for the regulator.

I have a reworked design for the PCB I'll test in a few months time which:

1. Pulls the unused U5 inputs high
2. Uses a ground fill both sides
3. Moves things around a little so they are closer to where they need to be
4. Removes a ton of unneeded signal vias

I'd also probably recommend using at least a 400mA regulator.

If anyone wants to test this before I get a chance, the work in progress is here (I haven't updated the Gerbers there yet): https://github.com/LinuxJedi/RGBtoHDMI/tree/amiga-slot-fixes

IanSB, 2021-03-14:
You need to look at the sync pulse (Pin 16 / GPIO23) and pixel clock (Pin 11 / GPIO 17) going into the Pi zero to see what changes when the problem arises. If it's only one board with the problem it might be an intermittent solder joint on one of those signal paths.

LinuxJedi, 2021-03-14:
> You need to look at the sync pulse (Pin 16 / GPIO23) and pixel clock (Pin 11 / GPIO 17) going into the Pi zero to see what changes when the problem arises. If it's only one board with the problem it might be an intermittent solder joint on one of those signal paths.

If it was one, yes. When it was 5 of a batch and they were the only ones with NXPs I figured that might be a pattern.

LinuxJedi, 2021-03-15:
Well, my observations are flawed. Now getting similar issues with more boards, just taking longer to hit them (a few seconds in a few hours). I'm guessing the double inversion of C1 XOR C3 is causing additional latency.

IanSB, 2021-03-16:
@LinuxJedi

That looks like the pixel clock is running at twice the expected frequency which could be the result of spurious spikes in the clock generation circuit.

LinuxJedi, 2021-03-16:
To mitigate against this and other issues I've observed, particularly with A2000 and R3 Super Denise (which I didn't even know was a thing), I've designed an updated modified version here: https://github.com/LinuxJedi/RGBtoHDMI/tree/amiga-slot-fixes

It:
- Uses a ground fill
- Is manually routed instead of autorouted
- Makes U5 entirely optional (using U5 gives v1 Super Denise behaviour, without it you eliminate a couple of XORs for the 7MHz by having the Super Denise gate of U1 do it)
- Adds an optional R and C for timing delay
- Moves some of the ICs into places closer to where they actually do things for shorter traces

And has several other changes. I'll see in a couple of weeks how this works out.

I'm tempted to look into whether or not just an XOR of 7MHz and CDAC works to give 14M (and if it does what extra delay that needs). Plus I may make the board a little smaller so things are closer together / traces are shorter.

LinuxJedi, 2021-03-26:
Closing this, finding much better reliability with my new layout, I'll upstream it with build instructions when I get time to write them next week.

Closed 2021-03-26.

Thread 44 (2021-03-18):

Scanline Level

ransom1122, 2021-03-18:
Can anyone tell me if scanline level option in the OSD works? I can't seem to change the value from 0?

Enabling scanlines work, but not scanline level?

Thanks

IanSB, 2021-03-18:
@ransom1122

Variable intensity scanlines require additional processing and to get them working means significantly overclocking the Pi zero so they are disabled by default.
However there is an additional profile called "Amiga_Var-Scanlines" which has the multiple changes to settings required for variable scanlines so change your profile to that option and you should then be able to set the scanline level.
Note that scanlines are disabled when the menu is on screen and your Pi may hangup due to the overclocking in which case I suggest adding a heatsink.

ransom1122, 2021-03-18:
Looks like I'll pass, I dont have a heatsink and not interested in overstocking. The standard scanlines are good enough as it is.

Jimiga, 2021-03-18:
Thanks for the reply @IanSB . I'm interested in this too, just wondering - with a heatsink installed, is there any risk to damaging the pi with the overclocking involved here?

I think standard scanlines will be fine, but I'm looking forward to experimenting when my setup arrives next month, and I'm learning what I can in the mean time. Thanks!

IanSB, 2021-03-18:
@ransom1122
>Out of interest for others that are wanting more, where does one find that amiga var scanlines profile

In the main menu, change the "Profile" setting.
Options are "Amiga", "Amiga Blk-Scanlines", "Amiga Var-Scanlines"

@Jimiga
>with a heatsink installed, is there any risk to damaging the pi with the overclocking involved here?

I don't think so, it usually works with no heatsink anyway so not really stressing the chip that much.

See this thread for some example screencaps of variable scanlines:
https://github.com/c0pperdragon/Amiga-Digital-Video/issues/16

abrugsch, 2021-03-18:
> Looks like I'll pass, I dont have a heatsink and not interested in overstocking. The standard scanlines are good enough as it is.
@ransom1122 try combining the scanlines with softening the picture (one of the menu options) i found the combination gives a very pleasing near-CRT effect. Though your mileage may vary so give it a try

Thread 45 (2021-03-19):

Soldering issues - mask clearance

solarmon, 2021-03-19:
Hi

I've been having quite a few failures building these RGBtoHDMI v2 boards. One of the issues I'm finding is that the solder mask clearance does not have enough tolerance and there could be manufacturing variances, and bad soldering techniques, that could lead to exposed copper and shorts occurring.

The issues seems to be that the copper pour clearance is set the same as the solder mask clearance - both at 0.2:

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

In the 3D viewer you can see that there is potential for copper to be exposed, depending on the manufacturing process tolerances.

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

So you could end up getting solder shorting on to the copper pour - here are a few of my examples of pins shorting to the +5V copper pour:

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

To get around this issue, I would normally set the copper clearance value to something slightly bigger - like 0.254 - so that the solder mask will always be covering the copper pour edges.

solarmon, 2021-03-19:
I had ordered different coloured boards from JLPCB. It seems they may be using different manufacturing process for the difference coloured boards. Or they had manually adjusted clearances when making the red and blue boards.

My green boards all have this manufacturing issue with the copper pour randomly being exposed, But the red and blue ones seems to have had the clearances adjusted.

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

Thread 47 (2021-04-16):

non-destructive way of fitting an HDMI output to the Amiga 500.

NielsPlougman, 2021-04-16:
This is a non-destructive way of fitting an HDMI output to the Amiga 500.

When adding the RGBtoHDMI adapter to the original Amiga 500, the problem arises how to get the HDMI cable out of the Amiga.

I've come up with the following solution:
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

This little housing, for a Female HDMI connector, clips right on the Amiga case. I tried to design it in the A520 TV modulator style, so it should not look too much out of place in the 80' computer design.

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

The cables go through the small vents on top of the Amiga case.
I've made a complete guide on prusaprinters.org, where you can download the STL files and see how to assemble it.

[https://www.prusaprinters.org/prints/63688-rgbtohdmi-adapter-housing-for-amiga-500](https://www.prusaprinters.org/prints/63688-rgbtohdmi-adapter-housing-for-amiga-500)

Hope someone finds it usefull.

aiobofh, 2021-04-16:
I did like this :)
![Uploading 20210412_223146.jpg…]()

mthiesen, 2021-04-17:
@NielsPlougman This looks very nice, good job! I thought about printing a custom expansion port cover with cut-outs for HDMI and the push button, but this is so much better. Definitely goes onto my ever growning list of things-to-print.

@aiobofh I am curious: what is the story behind those connectors with the LEDs and voltage labels?

LinuxJedi, 2021-04-21:
> @aiobofh I am curious: what is the story behind those connectors with the LEDs and voltage labels?

They will be ATK / DiagROM loopback testers.

krug3rf, 2021-05-04:
My personnal design for single HDMI with or without µSD slot or dual HDMI (PiStorm and RGBtoHDMI), available [here](https://cults3d.com/fr/utilisateurs/krug3r/)

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

rkeniger, 2023-05-11:
Are you all just ignoring the fact that with this mod in place you can't re-install the RF shielding on the Amiga? The installed Pi Zero totally blocks one of the screw holes.

LinuxJedi, 2023-05-11:
> Are you all just ignoring the fact that with this mod in place you can't re-install the RF shielding on the Amiga? The installed Pi Zero totally blocks one of the screw holes.

Is there a reason you would want to re-install it? I don't know many people who keep it on.

rkeniger, 2023-05-11:
I guess just for completeness? Are there no issues with it off? Since it’s a hefty shield I’m assuming it’s there to prevent the Amiga interfering with radio, but if it’s unlikely to affect things then great - I know pretty much zero about RF when it comes to circuitry.

Thread 48 (2021-04-23):

Turning off HDMI output programatically

c0pperdragon, 2021-04-23:
I got a request about the possibility to turn off the HDMI output in certain circumstances. The main use would be to allow switching between the HDMI output of a Vampire card and the RGBtoHDMI automatically. But it could also be useful for implementing a simple video power-down mode.

@Ian
I could imagine that the Amiga can be be programmed to turn off/suppress its csync signal (will check this). What would happen then on the side of the RGBtoHDMI? Would it just continue to display the content of its framebuffer, or would it turn off the output alltogether? Could such a behaviour be implemented?

Cjsnet, 2021-04-23:
Thanks for considering this. I am using an auto HDMI switcher which detects a video signal coming from an HDMI input, then switches the output to display that signal. So if the Vampire is transmitting but RGB2HDMI is not, the TV will show the Vampire image. The problem is RGB2HDMI is always transmitting, therefore no auto switching can occur. So this would be a fantastic addition.

Here's a preview of the [thumbnail](https://photos.app.goo.gl/Bu2Y5it2pd41FbNp8) of my video about this switcher technique. If I could announce support for auto switching in the video it would be even better and a great enhancement to the RGB2HDMI! My video won't be finished for about a week. Possibly longer...

Thanks guys.

c0pperdragon, 2021-04-23:
@IanSB  Oops!  I wanted to notify you in the first post, but got our name wrong...

 I did some more research on the matter of turning off the CSYNC from the Amiga programmatically. It may not be as easy, as I had hoped. The registers in the Agnus chip to fine-adjust the sync signal generation were introduced with the ECS chips. Maybe it is also possible by other means, but I am not an expert on the inner workings of the Amiga video hardware.

c0pperdragon, 2021-04-24:
This issue seems to be very complicated and I don't see an easy way to turn off the analog video output.
But the documentation of the picasso96 driver which is also used by the Vampire accelerator hints at the possibility to power down its HDMI output. Maybe this is already good enough for the purpose of auto-switching.

Perifractic, 2021-04-24:
Unfortunately I don’t know anyone on the Vampire team and they haven’t released an update for the 500 in a while. So it may not be likely for the Vampire to provide the feature. Do you think RGB2HDMI can use the same method?

c0pperdragon, 2021-04-24:
The RGBtoHDMI does not have many options here. It only has these few signals to generate the image from. If the Amiga does not change these signals (possibly done by the picasso96 driver) I can see no solution.

Did you check with the documentation for the Vampire and the picasso96 driver if there are some ways to power-down the HDMI output?

Perifractic, 2021-04-24:
I will look into that further. The problem is, it needs to happen automatically, so even if there was a way, I'm not sure how a user would get the Vampire to power down whenever the Amiga switched to a certain graphics mode.

IanSB, 2021-04-25:
@Perifractic
@c0pperdragon

I've implemented the basic functionality of this so that if the input syncs disappear then the HDMI output goes into DPMS standby and any connected monitor switches off but if there isn't any way of disabling the syncs on the Amiga then it might not be much help.

Perifractic, 2021-04-25:
Very interesting. How can I test this out? Thanks!

LinuxJedi, 2021-04-25:
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

Might be too much work for the loop but could it be possible to add something to detect when all pixels are black for X seconds and DPMS? (revert when there is colour again)

c0pperdragon, 2021-04-25:
I fear, this new feature from the RGBtoHDMI does not really help all by itself. I have tried to play with the hardware registers of the Amiga. I can somehow influence the CSYNC generation in a weird and unexpected way by messing around with the registers of the ECS Agnus. But this all looks pretty broken and there is basically no real documentation on this to be found.

So I think I can not offer you much more help here. Maybe you can set up the Vampire to somehow disable HDMI when the Amiga is not using it. But I can not give you much support there, either.

One thing is interesting, though. You said, when the workbench uses the vampire for output, the analog screen goes gray. But why gray?  Is this something than can be configured somewhere?  Maybe there is some configuration possibility. At least some people would prefer a black screen for this purpose, I could imagine.  Maybe there is also a screen-blanking option, or something.....

Perifractic, 2021-04-25:
Ah well thanks anyway.

I did find a Vampire setting at the Facebook that will turn the Vampire output black when focus moves to the other monitor but alas the HDMI switcher doesn’t detect it as loss of sync so does not switch.

I’m going to try different switchers…

IanSB, 2021-04-25:
@Perifractic
>Very interesting. How can I test this out? Thanks! (N00b instructions appreciated)

There isn't really any easy way to try it on c0pperdragon's Amiga board. You would have to either use some software to disable syncs which might not be possible at all or put a switch or logic gate in the sync signal path going to the board or the Pi zero to manually switch off the sync signal. I mainly implemented it to confirm that I could put the HDMI output into DPMS standby from bare metal.

It does potentially have some usefulness with the external version of RGBtoHDMI used on such machines as PC CGA / EGA or Amstrad CPC as those use a separate power supply for RGBtoHDMI so with this mod enabled the monitor would go into standby or switch to another input when the computer was powered down even if RGBtoHDMI was still powered.

Perifractic, 2021-04-25:
Thanks anyway @IanSB. What I can say from the Vampire forums is there are a _lot_ of people who'd love to have both devices switch off when not in use. I was surprised.

In the meantime I'll finish up my video. Do let me know if any ideas come to mind. Thanks everyone!

IanSB, 2021-05-09:
@Perifractic

I just watched your video. You mentioned to c0pperdragon that the Amiga screen goes grey when not in use so detection of that might be the only way for RGBtoHDMI to go into standby as suggested by LinuxJedi above. Can you post a screencap of that grey screen? (Short press of the button, file will be on the SD card).

LinuxJedi, 2021-05-09:
> I just watched your video. You mentioned to c0pperdragon that the Amiga screen goes grey when not in use so detection of that might be the only way for RGBtoHDMI to go into standby as suggested by LinuxJedi above. Can you post a screencap of that grey screen? (Short press of the button, file will be on the SD card).
>
>

@IanSB I'm also thinking with your DPMS code the CPLD could probably do this and disable sync (with a CPLD version). Saves load on the Pi.

I can also get PiStorms RTG running during the week and will see what colour that gets blanked with if that helps.

Perifractic, 2021-05-09:
@IanSB Screenshot as requested
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

IanSB, 2021-05-10:
@Perifractic
Try this version:
[GreyScreenDPMSBlanking-Beta1.zip](https://github.com/c0pperdragon/Amiga-Digital-Video/files/6448653/GreyScreenDPMSBlanking-Beta1.zip)

It's had limited testing because I don't have a way of setting the grey screen but it might work.
It should put the HDMI output into standby if it sees 200 lines of video set to grey (RGB = 0xAAA based on your screencap) for more than 200 frames ( about 3 to 4 seconds)

@LinuxJedi
The CPLD is probably too full so some features would have to be removed to fit anything new in.

IanSB, 2021-05-10:
@Perifractic

If the standby works, you will need a priority HDMI switcher which always switches back to the master (Amiga) input when that is active and only switches away to the other (Vampire) input when the master is in standby.
A lot of HDMI auto switchers will switch to an active input if the current input goes into standby but they might not switch back again unless the second input goes into standby which doesn't happen with the Vampire.

IanSB, 2021-05-10:
@Perifractic
Does the monitor go into standby when the screen blanks?

This priority switch from Startech seems to fit the requirements and it looks like it is available from Amazon & ebay:
https://www.startech.com/en-us/audio-video-products/vs221hdq
https://www.amazon.com/StarTech-Switch-Automatic-Priority-Switching/dp/B01N6AM2EA
https://www.ebay.com/itm/313515451662

The manual is here:
https://sgcdn.startech.com/005329/media/sets/vs221hdq_manual/vs221hdq.pdf

It states:
`Using the Priority switch feature, you can automatically switch between video sources simply by turning off and on the devices connected to the prioritized ports.  For example: If you typically watch TV through your Cable or Satellite set top box, but sometimes watch movies on your Blu-ray player.  You can connect your set top box to Port #1, and your Blu-ray player to Port#2.  When the Blu-ray player is turned on to watch a movie the HDMI switch will automatically switch to the Blu-ray player.  When the movie is over, simply turn off your Blu-ray player and the HDMI switch will automatically switch back to your set top _box.`

In this case the RGBtoHDMI would be the priority input on Port#2 like the Blu Ray player.

However, I'm not totally sure if the DPMS standby used by the Pi is the on/off state that's being detected by the switch so the only way to confirm that is to try it.

Perifractic, 2021-05-10:
My monitor doesn’t have a standby mode like that so I can’t answer that question however I have ordered that switcher and will let you know as soon as it arrives. Thanks!

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

LinuxJedi, 2021-05-10:
> It's had limited testing because I don't have a way of setting the grey screen but it might work.
> It should put the HDMI output into standby if it sees 200 lines of video set to grey (RGB = 0xAAA based on your screencap) for more than 200 frames ( about 3 to 4 seconds)

In theory this should work for most RTG solutions too. From what I've been told the Amiga RGB basically switches to the Workbench background colour. For most people that is 0xAAA (there are some installs that use black and it is possible to customise).

> The CPLD is probably too full so some features would have to be removed to fit anything new in.

Fair enough, I don't use the GUI often when compiling Xilinx so didn't really check the usage on it last time I made a JED.

IanSB, 2021-05-14:
@Perifractic
@LinuxJedi

I just received one of these Startech switchers which I got from ebay. It's a slightly different model (VS222HDQ) which is the dual output version of the VS221HDQ I mentioned above but it is otherwise identical.

It has the same priority switching and it works!!! although I had to connect the two sources the other way around (i.e. Pi zero into input 1 and Vampire into input 2) so try them both ways with your switch (The manual says to use input 2 for the priority same as the switch above but it looks like that is wrong.

Perifractic, 2021-05-14:
Fantastic news! I just got mine and will be trying it today!

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

Perifractic, 2021-05-15:
@IanSB @c0pperdragon IT WORKS! Under all scenarios. I was impressed that it isn't even necessary to initially select the Vampire when booting into RTG Workbench, or to select the RGB2HDMI when booting games from Gotek. Whether doing that, or running WHDLoaders from WB, as Captain Picard said, "It just works." ;-)

Great teamwork gentlemen. Here is the exact device I bought: https://amzn.to/3ojWscI

Your friend in retro, Perifractic

IanSB, 2021-05-16:
@Perifractic

Glad to hear it's working OK.
I've incorporated the change into the main software so it will be supported in future releases.

The blanking is always enabled in the test version above, but because it might affect other systems not using auto switching, the functionality will be disabled by default in future releases and you have to enable it by loading the config.txt file from the SD card into a text editor and changing the line:

hdmi_blanking=0
to
hdmi_blanking=1

Then save the file back to the SD card.
Its is implemented this way in the latest main beta available here:
https://github.com/IanSB/RGBtoHDMI/releases
Can you check that works OK for you once you have made the above edit to config.txt
You will have to repeat the process if you ever need to upgrade to a newer release.

Perifractic, 2021-05-16:
Understood. I will check when I can. Good idea to make it optional. Any chance it could be an option in the on screen menu instead of requiring text editor for people? Great work either way!

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

abrugsch, 2021-05-16:
@IanSB might it be possible to also include a config option to set the colour to switch on? As @LinuxJedi  said it's the background colour which is usually 0xAAA but not always

IanSB, 2021-05-17:
@Perifractic
>Any chance it could be an option in the on screen menu

That's been implemented and Beta25 can be downloaded here:
https://github.com/IanSB/RGBtoHDMI/releases
Adjust the "HDMI Grey Standby" option in the settings menu to "On" and then save the configuration
Note: If your machine is capable of switching between PAL and NTSC modes you will have to save the setting for each mode as they are separate profiles.

Please give this one a try instead of Beta24 when convenient.

IanSB, 2021-05-17:
@abrugsch
>might it be possible to also include a config option to set the colour to switch on?

At the moment that is more difficult because there are no spare registers in the capture loops and the AAA value is hard coded as an immediate constant. It might be possible to rework the code sometime but it is not an easy fix.

Perifractic, 2021-05-17:
Will try when I can. Thanks so much!

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

Perifractic, 2021-05-18:
@IanSB @c0pperdragon BTW here is a short video I'll be making public in the next 2 weeks about the solving of this issue: https://youtu.be/I3_5P_k_6VE

Xnyle, 2022-02-12:
@c0pperdragon I just tested this with a PiSTorm / Emu68 and it always blanks after 3 seconds. Even if I boot a 1.3 Workbench where there is def. no grey anywhere on screen.

LinuxJedi, 2022-02-14:
> @c0pperdragon I just tested this with a PiSTorm / Emu68 and it always blanks after 3 seconds. Even if I boot a 1.3 Workbench where there is def. no grey anywhere on screen.

You may have something else going on here.

> Also I'm not sure if looking for grey is a good idea, early startup menu is also grey.

Early startup menu has content on the screen, every pixel isn't identical, so it will not trigger.

> Why not xor adjacent pixels and as soon as you get a 1 consider screen to be non blank and inc another register. only if that register goes to zero, blank screen. at end of frame dec register. set register with min value from config as soon as above condition is met and you have a configurable timeout This would work for any color and not cost many cpu cycles?

What you are describing isn't too far removed from how it works now. A fixed colour number is needed because a full green screen, for example, is very useful for the user to see.

Xnyle, 2022-02-14:
> Early startup menu has content on the screen, every pixel isn't identical, so it will not trigger.

Ah Ok, than I misunderstood how it's currently working.

> You may have something else going on here.

Must be, but what? It blanks after 3 seconds no matter what if I enable that option.

Additional question: does it only blank the screen or does it also go into a power safe mode (only checking for signal once a second or so). Asking this as I noticed the Pi to be the hottest thing inside the case, even when blanking is active. hotter than the PiStorm pi itself which is kind of strange.

LinuxJedi, 2022-02-14:
> > You may have something else going on here.
>
> Must be, but what? It blanks after 3 seconds no matter what if I enable that option.

I'm not quite sure. Is RGB output working OK? Does the RGBtoHDMI work with a normal 68K?

> Additional question: does it only blank the screen or does it also go into a power safe mode (only checking for signal once a second or so). Asking this as I noticed the Pi to be the hottest thing inside the case, even when blanking is active. hotter than the PiStorm pi itself which is kind of strange.

With this enabled it should go into DPMS and it will monitor for changes in the incoming picture. If you are using a software version older than 24th December the Pi is likely to get quite warm.

IanSB, 2022-02-14:
@Xnyle
Call up the info menu, use the save log & EDID and post log.txt

Xnyle, 2022-02-14:
@IanSB and how do I accomplish that if the screen is off? As soon as I enable grey option screen blanks after 3 seconds.

Edit, Ok, will try to memorize required button clicks.

Regarding questions above, yes also happening without PiStorm, Yes newest FW from 24.12.

Xnyle, 2022-02-14:
https://pastebin.com/JQsqvNeW, Screen turns back on on menu, didn't know that.

IanSB, 2022-02-14:
@Xnyle
OK it's a bug that only affects the c0pperdragon style interface and it works with the CPLD version.

IanSB, 2022-02-14:
@Xnyle

Update to the latest beta53 here:
https://github.com/IanSB/RGBtoHDMI/releases

Then overwrite kernelrpi.img  with the version in this zip:
[kernelrpi-blankfix_aplha1.zip](https://github.com/c0pperdragon/Amiga-Digital-Video/files/8064398/kernelrpi-blankfix_aplha1.zip)

IanSB, 2022-02-16:
@Xnyle
The above log.txt doesn't show any attempt to set the DMPS state so if the screen is going dark that seems to be just the Amiga.
Which model Amiga are you using? Does the analog output go grey or black?

Xnyle, 2022-02-16:
A600 with 3.2 Rom it goes dark grey / blackish but you still see the black borders left and right outside of the 4:3 frame. and then 2 sec later it goes pitchblack but as you wrote no DPMS switch.

IanSB, 2022-02-16:
It's looking for light grey AAA which is this:

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

Try capturing a screen yourself during the 2 seconds (middle button - png file on SD card) and then you can use MS Paint to examine the RGB levels using the colour picker tool and the colour editor.
The value should be 170 (AA) for R,G,B. If you don't get that then it will never trigger.

Maybe different ROM versions behave differently.

Xnyle, 2022-02-16:
There must be another problem:

I just checked, pressing capture every second:
For the first second I'm getting 11 and then AA just like you uploaded it. And it stays like that.

BUT that would mean:
Either it doesn't blank and I should see that picture
Or it does blank and the monitor should turn off

But what is actually happening is what you see in the log:
It doesn't blank
And I see a black screen

I can then capture that screen and later see from the capture that it was actually grey

But the screen i see is pitch black but still on.

So there must be something else going on.

Xnyle, 2022-02-16:
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

IanSB, 2022-02-16:
@Xnyle
>Maybe ther's something going on with sync on SuperDenise?

Looking again at the log.txt, it's changing from 312 line PAL to 525 line interlaced NTSC
```
Lines per frame = 313, (313.001)
Autoswitch match: Amiga_50Hz (0) = 63679, 64318, 313, 4
...
Lines per frame = 525, (524.999)
Autoswitch match: Amiga_60Hz_PAL (3) = 63819, 64460, 263, 4
```

So it's switching to the Amiga_60Hz_PAL sub-profile (525lines but using PAL crystal) which doesn't have the option set.
Try the following:
Change Auto Switch to Off and manually select the Amiga_60Hz_PAL sub-profile.
Change the DPMS setting to On
Save the configuration
Change Auto Switch back to sub-profile only
Save the configuration

Now DPMS will be set on both profiles but it might still not work for other reasons if the signal is unstable (I'm seeing interlace changed a lot in the logs)

Xnyle, 2022-02-16:
Unfortunately no change.

https://pastebin.com/dqR5fnDb

This is the saved 60Hz_PAL Profile

sampling=0,0,0,0,0,0,0,0,0,0,2,0,0,0,0,0,0,5,1,0,55,20,55,20,25,127,127,127
geometry=136,34,640,200,712,224,2,5,1,2,14187580,910,5000,263,4,1,1
hdmi_standby=1
palette=RrGgBb_(EGA)
ffosd_overlay=1

IanSB, 2022-02-16:
@Xnyle
> Edit: After cold shutdown it's now working. 👍

Shutdown of the converter or the Amiga or both?

Xnyle, 2022-02-16:
Both

aotta, 2022-03-14:
I tested mi A600 vampire with latest driver and 3.1.4 amiga rom, and i get black screen, not gray, when rtg is not used. No way to add a parameter in config.txt?

mvickers03, 2025-02-13:
Hi,

I joined just to add my 2 cents as I can rarely help in these situations.

The colour you see when amiga is outputting to another source can be set using amiga workbench colour pallet.

For example I have a purple theme set up on my Amiga, and when the signal switches to the other screen, I see purple not grey.

You should be able to change this colour using pallet prefs. This will likely effect some users if you are targeting a specific RGB value.

LinuxJedi, 2025-02-13:
Hi @mvickers03,

Yes, you can find the option to set the RGB value in the menu. The default being the default AAA.

Closed 2022-12-13.

Thread 49 (2021-04-27):

Cannot make the board work with an audio injector

ShoresOfNowhere, 2021-04-27:
Hi!

The first thing is thanking you and everybody that worked on this marvelous little board granting our Amigas with the power of HDMI output! Many, many thanks!

As to the subject of this issue, in your wiki you mention the possibility of using an audio injector as to inject the analog audio signal of the Amiga in the HDMI signal. Liking the idea I bought the exact model of audio injector you link in the wiki, but I'm having problems in connecting it with the RGBtoHDMI output.

What's happening is that it seems that something in the signal produced by the RGBtoHDMI prevents the injector from doing its job: if I connect ONLY audio, I can hear the Amiga audio on the HDMI, if I connect another HDMI source (I've tried with my RPi4, for example) I can see the RPi4 video AND hear the Amiga audio, but if the Amiga RGBtoHDMI out is connected... then I only see the Amiga, but no audio!

Any advice on what should I try changing in the settings as to get it work properly?

Any indications of what do the various HDMI mode settings mean? It seems that my 4k display doesn't like any of them besides DVI compatible... What am I doing wrong?

And what CPLD do I have in my board? Would it be useful using the CPLD menu to reprogram it?

Thanks again for your hard work and for any advice you might have!

IanSB, 2021-04-27:
@ShoresOfNowhere

Try setting the output resolution to 1920x1080 and refresh to only 50Hz or only 60Hz as appropriate for your computer. This will produce a video signal with much more standard timing than the default Auto modes.

Closed 2021-09-14.

Thread 50 (2021-05-13):

Flashing of screen from amiga to black when change ntsc amiga 500 to pal 50hz for games

roarfrow, 2021-05-13:
Is there a setting in the menu that is known to fix flashing of screen on amiga 500 when i put my  ntsc amiga 500 in 50 hz pal mode. I didnt want to mess with the settings too much until i asked if this is a known issue with a solution. I will continue to trouble shoot on my side, but any help would be appreciated. its just a stock 500 rev 6 mb 1 meg ram, fat agnus so does pal, but only have 2.10 kickstart. i was able  to rekick into 1.3 but same issue when used degrader to change to pal 50 hz.

roarfrow, 2021-05-13:
just tried it on another tv and same issue. I have another 500 i can test it on, so if nobody has any ideas in the next few days ill see if i get same result on the other machine. thanks for any help!

Bloodmosher, 2021-05-13:
My guess is that either you have auto switch turned off and need to manually switch to the PAL/50hz sub-profile, or you have auto-switch enabled and it is not matching the profile. The code looks for settings that match within tolerance values and I've found that the clock-tolerance range isn't wide enough to auto-switch in the default profile. I run with auto-switch set to "sub-profile" and then in my PAL profile setting I have increased the clock tolerance setting in the "geometry" menu to something larger than the default of 5000. I have it set to 10000 and with this setting I can switch the Amiga between PAL and NTSC and it happily chooses the right sub-profile automatically. You can edit your profile setting file manually to change the setting, e.g. this line:

(for PAL profile):
geometry=136,35,640,256,712,270,1,2,0,2,14187580,908,10000,313,4,1,1

roarfrow, 2021-05-14:
Thank you, that works. I never would have figured it out without your help.

Bloodmosher, 2021-05-14:
Also sounds similar to this thread - https://github.com/hoglet67/RGBtoHDMI/issues/206

Thread 51 (2021-05-20):

Colors not right

manterola, 2021-05-20:
I am having this problem in a A500+ PAL. The colors are off and I have tried all the options in the settings.
I used the Amiga test kit to help me see where the problem is, and I discovered that the red gradient is not correct.
I have attached a couple of screenshots.
Anyone with similar problems?
Any clue will help me.
Thanks!
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

IanSB, 2021-05-22:
Looks like bit 2 of the red channel is not connected so you need to check the soldering of the surface mount component U3 on pins 4 and 17 which are the input and output of red bit 2

manterola, 2021-05-24:
Thanks...Yes you are right: that red gradient breaks the progression: 0x00, 0x11, 0x22, 0x33, etc.
After inspection, the problem wasn't located in the daughter board, it was in the RPi0 itself: Pin #32 is grounded.
I removed the pins around the pin #32 and I am still trying to find a bridge. I remember connecting the board on top of the RPi0 in the wrong direction the first time. Do you think that this action affected and burned the GPIO in the pin #32?
Thanks again for this great development

IanSB, 2021-05-24:
@manterola
>Do you think that this action affected and burned the GPIO in the pin 32?

It's possible but the only way to be sure would be to try another Pi. It might be worth checking the operating temperature of the Pi (System summary in the info menu) because I have a damaged Pi and that runs much hotter than a normal one (~90C vs ~50C)

BTW are you sure you are checking pin 32 because if you count from the wrong end that pin would be a GND.

manterola, 2021-05-28:
Thanks @IanSB . The issue was resolved. I could not find any solder bridging the pin 32 to ground. I desoldered the pins, and followed the traces to see what was wrong. Nothing found, and still pin 32 has connectivity to ground. So I got a new RPi0 today, I checked that pin32 was not grounded and soldered the pin header, and it worked perfectly!.
Thanks for helping me diagnosing this problem.

Closed 2021-09-14.

Thread 52 (2021-06-20):

Amiga 500 Rev 6A Video problem

marcob1971, 2021-06-20:
Hi all,
on my Amiga 500 Rev 6A, normal denise, raspberry Pi Zero W v.1.1 the video appears with incorrect colors and there are also colored bands similar to interference. I've tried different types of setup but nothing change. Any suggestions? Thank you.

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

c0pperdragon, 2021-06-23:
You either have damaged input pins on your Raspberry Pi, or someone has made a very poor job in soldering the adapter.
Looking at this image, it seems that the signals B0, B1, B2 and G2 are low all the time and G2 is fluctuating randomly.
You could try to give the ICs on the adapter a very close visual inspection and watch for missing solder or solder bridges.
Trying a different Pi is another option.

Closed 2021-09-14.

Thread 53 (2021-07-02):

Not possible to get stable image on A500+.

PaulKlasmann, 2021-07-02:
I have made 5 amiga 500 adapters. The first two I tried in an A500++ with Super Deniese and correct jumper setting does not result in a stable image on both a  monitor or TV with HDMI.  I see two screens vertically with no sync and two or apprx two screens horizontally on the monitor.  On the TV I see the same non syncing but just two bad images vertically. I'm using v2 software on the RPI zero.

When I press the switch I get a stable menu.

I put the adapter onto a DIL socket to protect the pins pn the adapter PCB. Is this a known issue?
The screen shown below also blinks on and off.

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

PaulKlasmann, 2021-07-04:
Just a thought, how significant is that 3k3 resistor? If it was 10k would it matter? I cant see what its for besides tying GPIO18 to ground. It turned out that 10k Ohm resistors were in the 3k3 container! I can't see that being the cause of the problem.

IanSB, 2021-07-14:
Can you post a screenshot of the source summary page in the info menu

PaulKlasmann, 2021-07-14:
I won't be able to do that now because I removed the flip flop ICs.  It turned out I ordered the part ending in a 3, not a 4.  The correct part has a clock input to clock the outputs so I think the outputs changed as soon as the inputs changed rather than all being clocked at once.  The ones I had had a latch enable input in place of the clock input.  I will update when I receive the new ICs and try the RGB2HDMI PCB again.

PaulKlasmann, 2021-07-19:
I can confirm that the RGB2HDMI is now working correctly.  The D-type flip flops were replaced with the correct clocked version and it works very well.  Sorry about that! Should we delete this issue?

Closed 2021-07-19.

Thread 54 (2021-07-12):

HDMI vs. DVI

bkodenkt, 2021-07-12:
Hey everyone,

I am experiencing a problem with my older adaptor in a A500 rev5 NTSC system. When connecting it with an HDMI cable to my display, everything just works flawlessly and the image is crisp and stable. Due to input limitations, I need to use DVI on that display in the long term, though. With an HDMI to DVI cable on this system, the image is only stable when I open the RGB2HDMI menu. As long as the menu is open, everything is okay, but as soon as I close it, the screen gets black, picture appears again with some wild single vertical line of flickering pixels to the left, screen goes black again, repeat. I checked the cable and hooked up one of the newer CPLD-based adaptors and my A600 PAL system, and this works awesome with both HDMI and DVI inputs. So... it either is a problem with NTSC on my A500 and the DVI or some crazy setting I need to adjust. But... which setting could it be? Any ideas?

Thanks!

bkodenkt, 2021-07-13:
What I tried to fix the problem in the meantime:

- I made the 1mb ChipRAM-hack waaaaay back in the days, but I never adjusted the PAL/NTSC switching on the 8372 Agnus. I just didn't know about this in 199x, and thus my PAL crystal'd A500 always ran in slightly off-timed NTSC modes up until today. So, I decided to put a little piece of tape on pin 41 to constantly have it disconnected so the A500 would be a PAL machine running PAL modes again. While this fixed a problem that drove me nuts back then (Workbench height was 20% smaller due to 200 NTSC-lines instead of 256 PAL-lines), it actually made my DVI-on-off-display-problem worse: The screen now even gets black once every second when the Pi menu is active. When connected via HDMI, everything works fine, though.
- I adjusted the geometry timings as mentioned by @Bloodmosher in this issue #50, and while setting the clock from 5.000 to 10.000 **significantly decreased** the number of display on/black cycles, it made them more unpredictable. The system does run okay for five, ten or 15 seconds, then goes black again, back on, instantly black again, goes back on for like four seconds, then turns black again and again and again and then runs stable for ten seconds... I adjusted from 10.000 up to 15.000 and 20.000, but this made no (visible) difference. Again, when I just use a simple HDMI cable, everything works fine without any flickering.
- I tried @hoglet's latest stable release and @IanSB's latest beta 36, as they both include a 50MHz NTSC sub-profile for my Amiga, but when selecting this, the display just starts flickering a little and it is reverted back to the "normal" 50Mhz profile. Not a surprising outcome, though, as I now have a PAL/PAL system.

In the end it seems there is a problem with my adaptor/DVI combination. On my A600 with a newer CPLD-adaptor and the latest stable release from hoglet, DVI and HDMI work without any issues with the same cables. So, are there known problems with older adaptors from the pre-CPLD era and DVI?

IanSB, 2021-07-14:
Maybe your DVI monitor doesn't support 50Hz display. Hold the button down during power up to force 60Hz output.
If that works, change the refresh setting in the menu to 60Hz although that will mean stuttery motion on smooth scrolling etc.

Also post a screenshot of the source summary page in the info menu

bkodenkt, 2021-07-14:
> Maybe your DVI monitor doesn't support 50Hz display. Hold the button down during power up to force 60Hz output.
> If that works, change the refresh setting in the menu to 60Hz although that will mean stuttery motion on smooth scrolling etc.

The display does properly support 50Hz on both inputs, DVI and HDMI. I can open and read the 50Hz test message on both inputs. It's the same monitor, just with different inputs. I need HDMI for my Laptop, though... Wait. I could just connect my Laptop via DVI and thus keep the HDMI free for the Amigas instead of the other way round. Heureka!

> Also post a screenshot of the source summary page in the info menu

I will do that, although it seems that I missed the easiest solution for days...

IanSB, 2021-07-14:
@bkodenkt
>I will do that, although it seems that I missed the easiest solution for days...

Also use the save log function in the info menu after getting your problem display and post log.txt from the SD card

Thread 56 (2021-09-23):

Atari ST discussion Part 2

c0pperdragon, 2021-09-23:
This is a continuation of https://github.com/c0pperdragon/Amiga-Digital-Video/issues/6

c0pperdragon, 2021-09-23:
@chadders2708

Maybe your previous attempt to sample the both mono pixels using the single extra flip-flop failed because the two sample points were too unmatched. The first points was directly caused by the rising edge of the 16Mhz clock, but the other happend after going through both XORs.

Without properly scoping the incomming signal timings this whole issue can only be guesswork and will be hit-and-miss anyway.

chadders2708, 2021-09-23:
@c0pperdragon
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

Yes I came to pretty much the same conclusion. I was planning to scope it out and see exactly what is going on. My old scope died and the new one is still in its box as I'm in the middle of a massive reorganisation / clear out. I'll get things organised and take a proper look at it. 😃

chadders2708, 2021-09-23:
@IanSB

> That's looking good but one problem is that it won't fully work with the STE models with the 84 pin shifter as they use 12bpp for low and medium res modes: The blanking signal on B3 is not required with those machines as blanking is done digitally in the 84 pin shifter but as all 12 bits are used for the RGB data there is nowhere to feed the mono signal.

It had occured to me that this wasn't going to work for the STE in its current form. I had thought about using the two spare latches on U3 for mono but I was thinking we would need 3 to cover blanking as well. Good news that its done in the shifter on the STE so we don't need a specfic latch for it. I guess we can keep blanking on B3 for the ST and just look at moving mono away from R3 / G3 to allow it to support the STE.

If I rig this up to feed in mono - say on GPIO 20 / 21? - would you be up for the needed software changes to sample mono from there?

I can then experiment with feeding the signal directly from the additional latches or via the spare ones on U3 etc.

Slightly off topic, but while I think about it do you know if simple mode currently has any option to support 3 button inputs? Driving it with a single button is a real pain when experimenting! (its ok for day to day use since its rarely needed). I didn't try but I wasn't sure if the Pi is listening on GPIO19/25 for the other buttons like it does in CPLD mode.

c0pperdragon, 2021-09-23:
@chadders2708
I would be glad to help with theoretical suggestions as I have no Atari myself. It is also fine when you create and sell dedicated kits based on my design.
But I would ask you to refrain from also supporting the Amiga 600 with this. I happen to have about 100 kits left myself for which the market has already pretty much disappeared as it is.

chadders2708, 2021-09-23:
@c0pperdragon
Many thanks sir. I will naturally credit you accordingly on the silkscreening etc. on any PCB designs. I may produce a handful and sell a few, or use them in the pile of old STs I'm refurbing, but I wasn't thinking of making vast quantities of these or aiming to make any real money from them - I guess I'm more doing this just for the fun of it and the benefit of the user community.
No issue regaring the Amiga 600 support - can happily leave this out and stick with your existing design there. 😄

IanSB, 2021-09-23:
@chadders2708
> do you know if simple mode currently has any option to support 3 button inputs?

By default CPLD mode uses 3 buttons and simple mode uses 1 button but if you edit /Profiles/default.txt and change the following setting to:
single_button_mode=1
then the settings get rerversed with CPLD using 1 button and simple mode using 3 buttons.

>If I rig this up to feed in mono - say on GPIO 20 / 21?

I'll have a look at that.

IanSB, 2021-09-25:
@chadders2708

Try this version:
[AtariST-Alpha3.zip](https://github.com/c0pperdragon/Amiga-Digital-Video/files/7228869/AtariST-Alpha3.zip)

This looks at GPIO22 & 25 instead of R3 & G3 but it is untested.
You should be able to do a basic functionality check before making any mods by pulling either of those two GPIOs high to get alternating black & white vertical stripes like you did with the earlier software.

WARNING:
After making any hardware changes to use these two GPIOs, don't run older software because those GPIOs will be configured as outputs instead of inputs and you will get two outputs shorted together

GPIO 22 is the analog DAC strobe and GPIO25 drives the mode 7 led in CPLD mode and those two were the least disruptive changes.

chadders2708, 2021-09-25:
@IanSB

Many Thanks sir! I'll give it a try and let you know.

c0pperdragon, 2021-09-26:
Hi @chadders2708   I just had an idea how to nicely capture the mono:
You could pipe the mono signal through a long series of delay elements (for example with a transparent latch 74LVC573 or something like that). This would give you 9 different slightly phase-shifted variants of the mono.
It should then be fairly easy to find just the right point where to fetch each mono pixel from so their stable times match up with the color sampling.
This would also allow to compensate for variations in the Atari hardware if you provide some means to easily adjust the signal paths during install.

chadders2708, 2021-09-30:
HI @c0pperdragon
That's not a bad idea at all! Many thanks for the suggestion. I've got a busy couple of weeks now but I will give it a try when I get a bit more time.

Gitbizy, 2021-10-04:
Can someone steer me to the correct gerber files to make a shifter PCB for a standard ST?  Or where to buy a completed board?
What’s the difference between buffered and unbuffered boards for the ST?  Which one is better?

pixelk0, 2021-10-04:
> Can someone steer me to the correct gerber files to make a shifter PCB for a standard ST? Or where to buy a completed board? What’s the difference between buffered and unbuffered boards for the ST? Which one is better?

Given the choice, the buffered board will result in a cleaner, crisper image, removig pixel artifact coming from level instabilities and signal transmission time. I myself only have STes and haven't felt the need for a buffer. The Gerber is here : https://github.com/IanSB/RGBtoHDMI/tree/master/Kicad_Atari_ST_12Bit_Buffered_Pickup/V1
I have 3 unused boards available (because I ordered the wrong buffer chip, and discovered afterward that I didn't need them).

pixelk0, 2021-10-04:
By the way this thread https://www.atari-forum.com/viewtopic.php?f=15&t=40201
contains a lot of info and photos of people like myself who install The 12 bit board in STE, Mega STE and other boards. It may be a valuable asset (maybe some pictures for the wiki ?)

mzryz, 2022-01-20:
@IanSB do you think you might be able to help me with this issue? Thank you: https://github.com/c0pperdragon/Amiga-Digital-Video/issues/62

luciust, 2022-05-22:
@IanSB
I'm using Beta54: git version: 20220424 34677ba? build version: RGBtoHDMI_20220424_34677 with Atari STF (no-modulator) and Pickup board (no mods). Getting the VSYNC from J13 and HSYNC from C31.

Mono mode (640x400) works just perfect, while colour mode (320x200) doesn't work at all, but... kind-of-works when Amiga 2000 profile is selected. Picture is dimmed and I can see some artifacts:
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

What could be a reason? With Atari ST 50Hz or 50Hz profile I'm getting a black picture...

IanSB, 2022-05-22:
@luciust
The current profile is set up to assume the blanking mod has been made and without that you will get a blank screen.
(There will be an updated PCB soon with a dedicated blanking input)
Go to the sampling menu and change the sampling mode from "9 bits 0-2 Blanked" to "9 Bits (Bits 0-2)" to use the board without the mod.
(The Amiga profile is not looking for the blanking signal but it is looking at the wrong bits and the wrong sample rate, hence the imperfect image)

luciust, 2022-05-22:
@IanSB Well, I just went on making some changes and - boom - found the sampling solution - wanted to cancel the alarm... But you've already answerd! Wow, this is support - Sunday and quick reply. Thanks, low-res mode works now. Time to get switch to Atari STE
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

luciust, 2022-05-24:
With Atari ST (no modulator) and classic IanSB Shifter Pickup board the hi-res mono is "activated" by using i.e. monitor cable that both gives second output.

1. Is the same true for Atari STE with HSYNC and VSYNC used in the same way as with ST?
2. If above is true - has anybody created a "flip switch mod" that would connect monitor port 4 (MONO DETECT) and GND?

IanSB, 2022-05-24:
@luciust
>Is the same true for Atari STE with HSYNC and VSYNC used in the same way as with ST?

Yes, VSYNC is used for the mono and HSYNC for composite video as all 12 bits are used for RGB on the STE so there were no spare bits for the mono signal on the RGB inputs.
 Grounding the mono detect on the STE should force mono output same as on the ST

>If above is true - has anybody created a "flip switch mod" that would connect monitor port 4 (MONO DETECT) and GND?

Yes, I just bought an ST video connector and glued a small slide switch in the end wired to those pins. Someone else has done that as well and posted a photo but I can't find that post at the moment

aotta, 2022-05-24:
@IanSB i did the video connector with the slide switch hot-glued and posted the photo in one of the ST discussion but can't find it anymore... but here a couple of fresh (and terrible, sorry...) pictures if useful:
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

luciust, 2022-05-25:
Haha, that's cute! But it works!

bwmott, 2023-12-09:
> @luciust The current profile is set up to assume the blanking mod has been made and without that you will get a blank screen. (There will be an updated PCB soon with a dedicated blanking input) Go to the sampling menu and change the sampling mode from "9 bits 0-2 Blanked" to "9 Bits (Bits 0-2)" to use the board without the mod. (The Amiga profile is not looking for the blanking signal but it is looking at the wrong bits and the wrong sample rate, hence the imperfect image)

@IanSB I've been catching up on this thread again, since I'm finally getting around to doing some more work on my Mega ST. I'm wondering if an updated Atari ST shifter PCB with an input for picking up the blanking signal was created. Looking at the Atari ST shifter PCB in GitHub, it looks like it's Issue 1 from 2021 with pins for H/V signals but not the blanking signal. I looked around, but so far having been able to find a 3-pin version.

M1kerochip, 2023-12-10:
@bwmott, if it's any use, I made a riser, with blanking signal, for the [microATX ST board](http://ataripcb.pl/atari_st_atx_v1.1.html).
[mATX_RGBtoHDMI_Riser REV.1.zip](https://github.com/c0pperdragon/Amiga-Digital-Video/files/13629305/mATX_RGBtoHDMI_Riser.REV.1.zip)

I don't know if that'll fit on a Mega ST. If you've got a pic of the motherboard handy, I can check.

bwmott, 2023-12-11:
@M1kerochip Thanks! Looking at the riser PCB, I think it would fit in the Mega ST motherboard, but would interfere with installing the power supply.

M1kerochip, 2023-12-11:
> @M1kerochip Thanks! Looking at the riser PCB, I think it would fit in the Mega ST motherboard, but would interfere with installing the power supply.

Ah, OK. I see the Mega ST pcb, after work, I'll move the socket to the left side, and move the pins so they don't interfere with the crystal.

M1kerochip, 2023-12-11:
> @M1kerochip Thanks! Looking at the riser PCB, I think it would fit in the Mega ST motherboard, but would interfere with installing the power supply.

Try this?
[mATX_RGBtoHDMI_Riser.zip](https://github.com/c0pperdragon/Amiga-Digital-Video/files/13639112/mATX_RGBtoHDMI_Riser.zip)

I think that should be ok. I added a shrouded idc header, to connect to the rgbtohdmi 12bit board directly.

bwmott, 2023-12-12:
Thanks! I'll order some boards and give it a try.

G4DDS, 2024-01-07:
@aotta just confirming its these two pins here:
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

tyristori, 2024-05-17:
I created an adaption of LinuxJedi's A500 CPLD adapter for ST.
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

It gets detected and the CPLD flash screen appears but the CPLD chip is undetected and I can't flash it. Here's my schematic:

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

Thread 57 (2021-10-24):

Amiga pink sparklies on black/grey transition

psoma, 2021-10-24:
- Multiple builds (including latest)
- Capacitor fitted
- Numerous timing/overclocking settings tweaked without any change
- Tried multiple cards and multiple Amigas
- Tried on both Amiga 500 and Amiga 2000
- ... getting the same result
- Specifically on hard transition from black to grey

[YouTube Link to video example](https://www.youtube.com/watch?v=gAjQK-vwkJM)

Can consistently reproduce it in the first screen of Police Quest here as a very clear example.

psoma, 2021-10-24:
Closed due to duplicate issue

Closed 2021-10-24.

Thread 59 (2021-11-09):

Pi rainbow splash screen flashes and blank

ajkatz83, 2021-11-09:
I don't know if I am in the right place for this, but there was a new issue that came.up. The pi zero puts out a DVI signal at 60hz and just as the power is turned on, the rainbow splash screen flickers for a second then goes black. Between Paula, Agnus and Denise, I have tried resetting them best I could and nothing changes. I tried holding down the toggle button on that two pin connection, and no menu came.up at all. I was reading that perhaps the /CDAC and /CSYNC lines needed to be tied in? Wasn't sure if that would solve the issue or not.

Thread 60 (2021-11-14):

Output to TV

kevsaenz, 2021-11-14:
I am trying to output the display to a TV 1080 (Sony Bravia 52 inch screen Model:KDL-52XBR) on my monitor the output works perfectly. However, when I hook the system up to the TV I get an onscreen display stating the system is using an "unsupported mode", the Sony site states the TV is capable of the following resolutions 480i, 576i, 480p, 576p, 1080i, 720p, 1080p. Is there a way I can output to a tv made in 2007

c0pperdragon, 2021-11-17:
Maybe your TV does not support a 50Hz image (supposing you have a PAL Amiga).   You can use the settings-menu (using the optional push-button) to force 60Hz output.

IanSB, 2021-11-20:
Try manually selecting the resolution as 1080p and the refresh rate as 50Hz (or 60Hz as appropriate). The default auto setting doesn't produce entirely standard timing and maybe your old TV is a bit more restictive about the sources it supports.
Manually selecting the resolution and refresh will produce exact timings.

Thread 61 (2021-12-24):

New stable RGBtoHDMI software release

IanSB, 2021-12-24:
There is a new stable software release available:
https://github.com/hoglet67/RGBtoHDMI/releases

This is the first stable release with Pi zero 2W support.
If you have previously tried Beta42 to Beta49 you are strongly urged to upgrade to this version as the official raspberry Pi boot firmware included in those beta releases had a bug that slightly overvolted the Pi zero.
Raspberry Pi have since fixed this bug and the new stable release includes the bug fixed boot firmware.

Thread 62 (2022-01-18):

Atari ST Mono LED Flash

mzryz, 2022-01-18:
Hi there,

Sorry if this has been covered before, but I've installed Pi to HDMI in an Atari ST and also an STe but have noticed that the main LED on the board just constantly flashes in mono mode (even though it's done a full calibration) Is there a way I can turn the flashing off?

Thanks,

mzryz, 2022-01-22:
* Crickets *

It's ok I guess Ians on holiday probably :D

IanSB, 2022-01-22:
@mzryz
>LED on the board just constantly flashes in mono mode

That's because the mono mode is 70Hz and the hdmi output is 60 Hz so it will never lock

A couple of things to try:
1. Change the refresh to Force "50Hz to Any" which should make the HDMI output 70Hz to match the mono mode. If your monitor can't handle that then you might get a blank screen so will have to hold menu down during reset to recover.
2. Switch off the genlock in the settings menu. This will stop the flashing but the output still won't be locked to the source.

mzryz, 2022-01-25:
Thank you man, much appreciated!

Closed 2022-01-25.

Thread 63 (2022-06-16):

Hired Guns - Menu Black Outs

BoozerDawg, 2022-06-16:
I notice with Hired Guns - the opening menus are in a high res interlaced mode, which RGB2HDMI appears to interlaced with Bob De-Interlacing (could be wrong, but its considerably flickery, whereas Agonys intro is flicker free), and it blacks out every couple of seconds, comes back, and then happens again, until you get into the main game. I'm not sure what resolution its actually using here, it could be a mode thats unsupported, just thought I would post to see if there was any information about it :) Thanks!

IanSB, 2022-06-26:
Can you take a screenshot of the source summary page (from the info menu) when displaying that image.
Note the info isn't dynamically updated so you should call up the menu while the problem image is on screen, not before.

BoozerDawg, 2022-06-26:
Yes here you go (I should have done this in the first place), video also -

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

Video showing it - [https://youtu.be/HdPkyMm9XYk](url)

IanSB, 2022-06-26:
@BoozerDawg

It looks like RGBtoHDMI is detecting that output as progressive sync rather than interlaced sync and it relies on the sync changing from progressive to interlaced to know when to switch on deinterlacing  so it ends up treating the video as progressive, showing each field as a separate frame which results in the shimmer rather than weaving the two fields together.

The "Lines per frame" should show (625 interlaced) if it had detected interlaced sync and you should be able to compare that with some interlaced video that works.

I'm not sure why the screen is blanking but it may be because the sync timing is non standard in some way but it might be possible to get some further info from the log:

After the screen has blanked a few times, use the "Save Log and EDID" option in the info menu and post the resulting Log.txt file from the SD card.

BoozerDawg, 2022-06-26:
Here is the log file -

[Log.txt](https://github.com/c0pperdragon/Amiga-Digital-Video/files/8987067/Log.txt)

IanSB, 2022-06-27:
@BoozerDawg

It's seeing some change in the sync which is causing the blanking but I'll have a look into this in more detail when I have the time.

BoozerDawg, 2022-06-28:
Thanks :) It's really not a big deal, its the only game ive seen with this behaviour, but appreciate you looking into it.

Thread 64 (2022-06-23):

amiga 500 pixelated image

Prince-Eugen, 2022-06-23:
Hi, im using linuxjedi board with cpld for amiga 500, also w rasp pi2 zero.
Settings are default, but picture looks too sharp or pixelated. Is there chance to soften image a bit. It's hurting my eyes on big lcd screen.

here are picture comparison with laggy scart.
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

maybe image need to be interpolated
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

Amiga_CPLD_Setup default profile setting
[Default.txt](https://github.com/c0pperdragon/Amiga-Digital-Video/files/8968175/Default.txt)

IanSB, 2022-06-23:
If you have the menu button connected you can call up the menu and change the scaling setting from Auto to Integer(Soft)

abrugsch, 2022-06-23:
In the button menu there are various options for softening and scanline
generation. I find medium scanlines with a little softening looks just
right but your preference might be different

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

Thread 65 (2022-06-27):

Unable to activate Single Button Mode for OSD menu

bkodenkt, 2022-06-27:
For some reason, I am unable to switch to single_button_mode. When I short press the button, the menu comes up. When I short press it again, the menu goes away. When I long press it, scanlines are activated. When I long press it again, the scanlines are deactivated.

I found out that I can activate only using a single button by adding single_button_mode=1. To my demise, no guide actually states where to set this. Now, where exactly do I add this config value? In config.txt? configA.txt? default_config.txt? Or inside the profiles folders? And then, in which one exactly?

IanSB, 2022-07-14:
You edit the default.txt file in the /profiles folder on the SD card but if you are using a linuxjedi CPLD board then you should look in the "Amiga_CPLD_Readme" folder on the SD card which contains a readme to setup for correct profile and single button mode.

bkodenkt, 2022-07-15:
I tried a lot of things/files/places to edit single_button_mode=1, but it did not work. As mentioned [here in hoglet67s issue board](https://github.com/hoglet67/RGBtoHDMI/issues/233), simply reverting back to that specific release instantly solved the issue.

maximevince, 2024-04-10:
For anyone still wondering. For some reason `single_button_mode` is inverted for `cpld_version == DESIGN_SIMPLE`, i.e. all the early hardware designs without a CPLD.
See: https://github.com/hoglet67/RGBtoHDMI/blob/master/src/osd.c#L5434

I have no idea what the reason is for this. But setting `single_button_mode=0` effectively _enables_ single button mode on the non-CPLD versions...

It has been introduced in this commit: https://github.com/hoglet67/RGBtoHDMI/commit/7d438d385c86392fa441b5503b9f9ab4e014c66f

Unklemla, 2025-05-06:
Decided to get my Amiga from 1987 updated, so I bought Pi Zero.  How do I get a button added to Pi zero for OSD menu?

Thread 66 (2022-08-17):

Elfmania game - top and bottom of the picture cut off

mvbhz, 2022-08-17:
I have a problem with Elfmania which uses overscan. On the left and right, the image is OK, but some pixels are cut off at the top and bottom. How to set it so that it does not cut?

The TV definitely displays the entire screen area. Anyway, the image is also clipped on the grabber.

Thread 68 (2022-12-29):

No output when using ribbon cable on Amiga 600

alanapplyby, 2022-12-29:
On my Amiga 600 all works perfectly if I plug an hdmi cable directly into my pi zero, however I get no signal if I run a ribbon cable to extended the femla hdmi socket in place of the original modulator.

I've tried 2 different ribbon cables, 2 different mini hdmi adpaters (which plug into the pi) and 2 different hdmi cable. The only bit I've not tried changing is the full size hdmi adpter which the monitor plugs into but I really cannot believe that this new item is defective. When I attach the ribbon cable the silver contacts are face down when I slide them in.

Anyone got any ideas?

IanSB, 2023-01-03:
@alanapplyby

Having a join or joins (an adapter is an additional join) in the cable between the Pi and the monitor can sometimes cause problems with signal reflections and the results can vary from monitor to monitor so you may find such a setup will work OK with a different monitor.
Assuming that this isn't caused by another problem like shorted or intermittent connections in the cable assembly, there is a Pi setting which can help and that is the hdmi boost setting:

Load the config.txt file on the sd card into a text editor and find the following entry:

`# Set hdmi signal strength. (Valid values are 0-11)`
`config_hdmi_boost=5`

Change the value from 5 to a higher number and save back to the sd card.
Reset / repower the Pi after each change
If this fixes things, use the lowest value that works for you as higher values increase the risk of damage to the HDMI output drivers if there is a short circuit on the HDMI cable.

Thread 71 (2023-11-28):

Pink on boot screen

michaelmadsen72, 2023-11-28:
I recently added this RGB2HDMI board to my A500 and at first, I'm pretty sure it worked flawlessly. But now I'm seeing a pink color on the boot screen. And it feels like black in some games is also not completely back.
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

rafael1138, 2024-01-09:
Do you have a Denise or a SuperDenise? You board has the pin selector?

Thread 72 (2024-01-09):

Amiga 500+ ESC NTSC

rafael1138, 2024-01-09:
Hi.

I have an Amiga 500+ With ESC Chips that start in NTSC by default. The Amiga has a Pistorm with Emu68. (This is related to the RGB2HDMI output, not the Pistorm).

I'm connecting the Amiga to an NTSC LCD Monitor, regular Dell one.

All works fine but with a lot of PAL games I'm seeing the crop at the bottom of the game, so I boot the Amiga on PAL mode but the issue remains. I have tried several resolutions options but still has the same issue.

There is an special way to config RGB2HDMI to hanlde this scenario NTSC/PAL?

Thank you.

Thread 73 (2024-08-13):

works well... then start doing weird things.... then nothing

GregoryGreuzat, 2024-08-13:
I all,

First of all great job done by everybody on that subject !

I have done the PCB on Osh park, received it and solder all the components, the resistor I put is 4.7kohms instead of the 3.3kohms don't know if it matter a lot.

I have copied all the file on the SD card, drill the case and put everything in the case.
First boot and it works (see picture)

Then I launch a game, and I have some synchronization issues, then it was worst and worst, then nothing...

I don't know how to start the tests, I have measurment tools available.
so if somebody can tell me...

ahh important point when I loose the pictue the menu from the PI was still working and the picture was good.
So surely in the Amiga.
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

Thanks,
Greg

GregoryGreuzat, 2024-08-14:
Well, I have done a new board and it works fine for few hours now…
Maybe a bad solder on the first board…

Greg

Closed 2024-08-14.
