c0pperdragon/Amiga-Digital-Video/(commit log)

2020-09-26 Small test program to generate bit patterns to test if all bits of an adapter board work.
2020-09-28 Test pattern optional with 60Hz
2021-01-26 Info about bare small PCBs
2021-02-06 Link to big box board
2023-01-12 Add picture of cable
2024-12-05 Update README.md
    No power on the amiga cable (for safety reasons)
